CYFS3/GD32FOC/GD32F505_FOC模块复用布局.md

# 双路FOC参考模块复用布局

> 本文为此前阶段记录。最新用户要求把公共电源输入与第一路MOS驱动一起按参考工程排列，并明确选择1.27mm裸铜测试点替代5012通孔端子。后续以 `GD32F505_参考电源及双路FOC布局修正.md` 为准，旧测试点避让与共享电源整体下移不再沿用。

> 用户最新明确排列方向为 **M1在上、M2在下，对应器件X坐标一致**。下文横向66.396mm为前版记录，已由本次上下排列替代；本次纵向节距为78.5mm：M2相对上一版整体平移(-66.396,+78.5)mm，共享208器件再整体向下80.5mm避让；模块内部相对坐标、朝向、网络和分组保留。最新坐标与验证见`.layout-review/vertical-stack-coordinates.json`和`vertical-stack-validation.json`。

按用户要求，将data/FOC参考工程的电机驱动模块作为布局模板，两路模块以相同方向、固定平移间距重复摆放。此阶段复用器件摆放，不复制参考铜线、过孔或铺铜，也不复制参考主控、公共电源或板框。

## 方法

当前FOC_M1和FOC_M2各162个实体器件，共324个；其余208个为共享电源、主控、HSLink和显示等部分。依据参考位号来源、器件功能和引脚网络建立对应关系。封装模型与参考有原点或零度方向差异时，依据对应焊盘进行刚性位置/旋转补偿，保持物理电极方向与参考一致；不拉伸、不镜像模块。

参考中没有的新增器件采用两路一致的相对摆放，明确区别于参考复刻部分。需要避让模块的非FOC器件按已有功能组整体平移，保留各组内部摆放。

每路162个器件中147个找到参考对应，15个为新增器件。参考有9颗母线电容在背面，两路共18颗对应电容按参考翻至B.Cu，属于复刻范围；其余器件层保持。所有PCB变更通过KiCad IPC公开接口，保存前验证器件UUID、位号、焊盘网络不变，并单独验证这18颗的预期层变化。布局前完整备份为`.layout-review/module-reuse-before.kicad_pcb`。

## 注意事项

参考布局不是已验证的生产模板。当前部分器件封装尺寸与参考不同，因此会单独记录无法完全重合的焊盘、外形交叠和间距问题，不通过无提示重新打散器件来掩盖差异。此前导入库中的钻孔、丝印、库差异等DRC问题仍需后续修复。

初始严格参考坐标检查发现每路19处异网铜几何交叠，主要来自当前5012通孔测试点大于参考测试焊盘，以及CN5由5针替换为6针。不能把参考坐标复用宣称为封装也完全相同。执行原则是保留功率/驱动/采样核心坐标，仅对冲突测试点与变更接口做最小避让；同一避让偏移同时用于M1/M2，明确记录例外，不将短路布局保存。

双面检查额外确认：CN17等现有通孔栅极测试点在原参考位置会与背面母线电容铜区相交，局部小范围移动不足以解决。此类测试点迁至模块外围测试区，两路使用相同偏移，核心参考布局保持。这些例外是封装形态差异导致，不宣称当前147项均能零偏差复刻。

模块规划横向平移差为(+66.396,0)mm，两路同方向。为给复刻模块让位，其余208个共享器件整体向下平移83.2906mm，内部相对摆放保留。这是模块复刻工作区，不是最终整板尺寸或紧凑布板承诺。进一步检查发现部分明确为SMD的FOC阻容仍被导入为0.001mm钻孔、所有铜层的通孔焊盘。为正确复刻背面布局，本轮增加限定修复：仅改这些明确表贴器件的焊盘类型、铜/阻焊/焊膏层和钻孔属性，同步源封装库；几何尺寸、焊盘编号、网络保持。真正的通孔测试点/连接器不改为SMD。已同步5个源库文件的39个定义焊盘（0603电容、0603电阻/NTC、SOD323、6针表贴连接器、QFN24+EP），AST白名单核对几何/编号/原图形不变；库备份位于`.layout-review/module-smd-library-backup/`。共享同库的其他19个电容与18个电阻实例本轮不在板上修复范围内，后续更新封装时需留意。板上208个器件的486个焊盘已通过完整封装公开IPC更新为SMD、零钻孔和单面层集合；重新读取验证编号、UUID、网络与位置保持，已经保存。直接更新pad曾未生效，验证失败后事务已drop，最终使用fresh footprint.definition.pads更新整封装实现，没有绕过公共API。最终每路17个尺寸不兼容的测试点/变更接口采用成对避让；其余130个参考映射器件不增加避让偏移（允许不同封装的原点和零度方向校正），15个新增器件置外围。首轮实际布局保存后读回验证：532器件均存在，162对器件平移差(+66.396,0)mm一致，最大误差约1nm；18颗电容位于B.Cu，两铜面不同器件异网焊盘几何相交0。原生DRC第一次结果1122项违规、499未连接、0原理图一致性问题。装配边界重叠199项、通孔落入装配边界40项，说明参考紧凑坐标与当前封装/测试点仍需装配复核，不能因铜未重叠就声称可生产。相较原有14条铜间距多出CN27/R83及M2对应2条0.1846mm间距，已把CN27/CN1027各平移(-0.1,+0.1)mm；最终原生DRC为1120项违规、499未连接、0原理图一致性问题，这2条新增间距已消除，仍未达到生产DRC通过。

## 最终交付

已保存当前PCB，并通过公开Group接口建立2个无名模块组，每组162器件，分别对应M1/M2；组ID与成员位号见`.layout-review/module-reuse-groups.json`。公开SDK不提供名称setter，因此没有绕过接口伪造名称。可以按组选择整套模块移动，数据模板`.layout-review/foc-reuse-map.json`与最终坐标`.layout-review/module-reuse-coordinates.json`保留来源、两路对应及例外，供后续复用。

最终对布局前快照直接核验532个器件UUID/位号/锁定状态及1382个焊盘UUID/所属封装/编号/网络完全相等；162对平移差一致、角度匹配，18个背面电容层正确。实际焊盘与目标刚性变换坐标差约1.374nm，仅数值取整量级（不代表不同封装与参考原焊盘零误差，模型拟合残差另记录）。

预览已刷新，显示约137.8×195.4mm为当前全部图形占用，不是加工板框。为让用户先验收两个复刻模块，共享器件暂整体放在下方，整板尚待紧凑整合、定板框与布线。未复制参考走线，当前仍为2铜层、0走线/过孔/铜区，无板框。
