CYFS3/GD32FOC/.layout-review/layout-execution-report.md

# 532封装初版IPC布局执行

已通过KiCad 10.0.6官方kicad-python IPC完成当前GD32F5_FOC.kicad_pcb的全部532个导入封装摆放，并以board.save保存。初始导入先保存并复制备份：`.layout-review/board-before-placement.kicad_pcb`；原始实际位置、bbox和各焊盘net记录于`live-before.json`。

## 范围与方法

18个功能组，初版软包络170×120mm：两套功率桥在上部、共享输入/降压在左、主控中下、HSLink左下、显示/按键右下。两个三相MOS阵列采用相同锚点结构，采样区名义10mm高度扩大至24mm；43个器件为避碰超出原分区矩形但仍在整体包络内。

关键芯片/连接器先放；U1实际8/9/12/13焊盘位于芯片左边，晶体据此放置。栅阻/自举/晶体等局部簇以真实焊盘为吸引点。其余所有器件以小网络邻接加权目标和最近可用位置搜索摆放，不是只摆关键件；大供电/地网不作为无差别吸引。M2同号偏移对应件优先复用M1相对坐标。

采用不含文本的IPC get_item_bounding_box，候选保留0.35mm轴向bbox间隔。全体移动一个可撤销事务，随后14个MCU/晶体电容进行一次pad距离微调作为第二个可撤销事务。未删除、克隆或新增PCB器件；未布线、未放过孔、未铺铜、未创建板框或安装孔、未改层叠或锁定状态。

## 实际验证

- 封装数532，全数设置目标坐标并fresh IPC重读验证。
- 封装UUID、reference、层、锁定状态保持；所有pad UUID、parent、编号、net名称保持。
- 最终实际IPC bbox交叠对数0（不含文字；不是完整courtyard/DFM/DRC证明）。
- 实际占用边界约x2.362…166.014、y0.843…119.915mm，即163.652×119.072mm；它不是制造板框。
- 保留2铜层，tracks=0、vias=0、zones=0、shapes=0。
- `placement-coordinates.json`与`live-after.json`为最终位置及方向；`critical-pad-distances.json`为实际pad中心距离。
- USB8002原0°尾部焊盘位于负y侧，壳口朝正y；现270°将口朝西，尾部朝内侧。未创建板边，必须在机械定版后复核壳体伸出量与插拔空间。

## 关键局部距离（mm，焊盘中心直线距离，不是布线长度）

|连接|距离|
|---|---:|
|U1.8→Y201.1 / U1.9→Y201.2|4.209 / 5.034|
|Y201.1→C214.1 / Y201.2→C215.1|2.225 / 2.239|
|U1.12→Y200.1 / U1.13→Y200.3|5.831 / 5.423|
|Y200.1→C210.1 / Y200.3→C211.1|4.225 / 1.725|
|U1.11→C200.1|4.573|
|U1.28/50/75/100→C201/202/203/204供电脚|各1.725|
|U1.6→C212.1|4.783|
|U1.22→C206.1 / C207.1|3.239 / 6.032|
|U1.21→C208.1 / C213.1|4.943 / 6.799|
|Q5/Q6/Q7/Q8/Q9门极→对应栅阻最近焊盘|各3.093|
|Q10门极→R77最近焊盘|3.471|

主控左侧晶振/模拟供电较密，部分去耦仍为4–7mm且主晶振负载距离不对称，应在正式布线前继续收紧与调整回流。初版没有声称时钟回路、电源完整性、散热、爬电距离或可制造性完成。源封装存在导入through-hole/异常钻孔属性问题，布局不修复这些库层面问题；DRC由主agent单独执行和分类。

## 主agent最终DRC回传

主agent在最终保存板上运行原生DRC：794条违规、499条未连接，schematic parity为0。相对初次布局788条，电容微调后增加6条lib_footprint_mismatch，合计112条此类库差异；原因未在本子任务进一步验证，不能归因于旋转或忽略。布局bbox无交叠与上述DRC并不等价，当前板不具备DRC通过状态。主agent已打开532封装预览。

## 脚本

`live_snapshot.py`只读采集后board.save保存导入；`place_all.py`规划并事务摆全532；`refine_caps.py`局部pad目标微调；`measure_layout.py`最终只读距离测量。仅使用公开IPC对象与属性，不使用pcbnew/SWIG、私有proto或板文件文本写入。
