CYFS3/GD32FOC/.layout-review/module-reuse-report.md

# 双路FOC参考模块复用执行记录

已在当前GD32F5_FOC.kicad_pcb通过KiCad IPC完成两路同向平行复用，未复制参考铜、布线、板框或层叠。共有532实体封装、1382焊盘，2铜层，0走线/过孔/铜区/板框。

## 模板和摆放

每路162器件：147个映射到data/FOC的原器件，15个当前新增器件安置模块外围。M2与M1所有162个对应器件的平移严格为(66.396,0)mm，角度和正反面对应一致，不镜像、不拉伸、不自动散布参考核心。

对当前封装原点及默认朝向差异，按同功能焊盘求正交刚性变换，记录于module-reuse-plan-final.json的fits。Q5等MOS原点补偿约(-0.2117,-0.0022)mm并修正角度，U10按当前模型朝向补偿。C130/131/132与参考C66/70/71电容引脚1/2功能相反，按交换映射拟合。源封装尺寸与当前封装不同，最大配准焊盘中心残差0.1225mm；这是封装尺寸差异而非模块间误差。CN5从参考5针接口换为现6针，保持功能区位置，不宣称精确引脚兼容。

参考9个背面母线电容C96–C104，两路共18个，使用公开flip_items实际翻到B.Cu，再按原焊盘方向摆放。其余器件保持F.Cu。

非FOC共208器件整体沿Y平移83.2906mm，全部组内相对关系保持。当前为模块摆放工作区，非最终紧凑整板或确定外形。

## 必要的封装修复与摆放例外

参考位置要求双面配置，当前导入模型的伪通孔会产生真实异网短路。已对明确5类SMD封装的208个器件、486焊盘修复：0.001mm伪钻孔归零、PTH改SMD、层改F.Cu/F.Paste/F.Mask。使用公开footprint.definition.pads及整封装update；所有焊盘几何、ID、编号、网络、位置保持。直接update pad虽返回成功但不生效，已读回识别并撤回；整封装公开更新验证生效。真通孔5012测试点保持。

现5012实体测试点比参考小测试焊盘大，不能完全原位而制造异网短路。两路完全一致地对17对器件设置例外，详见plan.local_clearance_exceptions：CN5接口及CN14/15/17/18/19/20/21/22/23/24/25/26/27/37/38/40。CN17/18/19因真通孔与背面母线电容冲突，移至模块下侧外围；其余为小偏移。CN27最后按DRC增加(-0.1,+0.1)mm。核心MOS、驱动、运放及其阻容不因通用避碰算法改变参考布局。147中130个不含额外避让（但有必要模型原点配准）。

## 验证

- 直接与module-reuse-before.json对比：532 footprint UUID/ref/locked和1382 pad UUID/parent/pin/net完全一致。
- 162对平移差最大数值误差0.000001mm（1nm），所有角度对计划误差0°。
- 最终每个实际焊盘对计划刚性变换最大误差0.0000013744mm。
- 使用KiCad实际F.Cu/B.Cu铜焊盘多边形，包含真通孔两面，检测不同封装不同网络铜重叠为0。
- 已建立两个各162成员的KiCad Group，可整体选取模块；公共API没有name setter，因此保持无名，UUID与M1/M2映射见module-reuse-groups.json。
- 矩形bbox存在参考紧凑摆放及大测试点带来的交叠，未为消除矩形误报破坏参考核心；不等于庭院/机械间距通过。主agent执行最终原生DRC并在总报告列出。

## 文件与事务说明

完整初始备份module-reuse-before.kicad_pcb/json。模板映射foc-reuse-map.json、最终计划module-reuse-plan-final.json、最终坐标module-reuse-coordinates.json、验证module-reuse-validation.json、组映射module-reuse-groups.json。

执行曾出现flip+update同一事务内读回层不一致且drop后位置仍已变化；已立即读实况并改用独立flip提交、fresh对象对齐提交，最终真实层/位置/焊盘几何均再次验证后保存，未假定drop已恢复原状。最后只移动CN27配对作DRC最小间距修正，其他坐标保持。没有直接写PCB文件、私有proto或pcbnew操作。
