CYFS3/GD32FOC/GD32F505_低速晶振补充记录.md

# 32.768kHz低速晶振补充记录

已在MCU.kicad_sch补入LXTAL，保留原8MHz主晶振和所有其它实体网络。

## 器件与连接

- Y201：Abracon ABS07-32.768KHZ-9-T，HQ G0063431；32.768kHz无源两脚晶体，CL=9pF，ESR=70kΩ（目录规格），3215封装。
- Y201.1、C214.1接U1.8 PC14/OSC32IN；Y201.2、C215.1接U1.9 PC15/OSC32OUT。移除对应两处NC。
- C214/C215：12pF C0G，0603，各自pin2接GND。
- 初值按Datasheet Rev0.9RC5 p92公式 C1=C2=2*(CL-Cs)，Cs假定3pF，得到12pF。Cs不是实测值，实板须验证频率、起振裕量和晶体驱动功率并调整，不声称已经测试起振。

型号和模型依据：HQ get_hqsch_part(manufacturer62,ABS07-32.768KHZ-9-T)。符号来自HQ模型，已用KiCad CLI规范化；封装为该精确型号HQ模型，仅重命名为VerifiedParts:ABS07_32.768kHz_3215，未改变几何。

## 固件与布局

根据用户手册备份域/RCU_BDCTL说明，先允许PMU_CTL.BKPWEN备份域写入，使用晶体模式LXTALBPS=0，按晶体驱动和实板起振评估选择LXTALDRI，开启LXTALEN并等待LXTALSTB后再选择RTC源。LXTALDRI默认11为强驱动，不能视为未经验证就合适。Datasheet典型启动2s不是最大启动时间或超时保证。

VBAT仍接VCC，本次没有加入电池，因此掉主电不具备独立电池保时。晶体、电容应靠近U1.8/9，短线并避开PWM等高dv/dt节点。

按坐标检查，新电路位于MCU页右侧x335–372、y114–145；说明位于x322.58、y152–179，未占用已有器件坐标。已导出SVG，但当前模型无图像能力，未声称完成视觉审阅。

## 验证结果

- 全工程位号唯一：Y201/C214/C215未占用。
- KiCad原生前后全工程网表验证通过：两个振荡节点精确包含上列3个引脚；GND仅新增C214.2/C215.2；其它全部网络保持不变。
- 全工程ERC修改前后均353条（1错误、352警告），各类别数量完全一致，无新增符号库差异、封装解析或电气错误。
- 原有HPM电源建模错误、Q1封装等遗留项没有在本次修改。

修改文件：MCU.kicad_sch、sym-lib-table。
新增模型：LXTAL.kicad_sym、VerifiedParts.pretty/ABS07_32.768kHz_3215.kicad_mod。
备份/证据：.review-lxtal/MCU.before.kicad_sch、before.xml、after.xml、erc-before.json、erc-after.json、validation.json、svg/MCU.svg。

未修改PCB或固件。需重新加载磁盘原理图，再在后续PCB更新中加入这三个器件。
