CYFS3/GD32FOC/GD32F505_初版布局记录.md

# GD32F505 双路FOC初版布局

> 本文保留首次分区布局记录。用户随后要求完全参考FOC模块摆放并同向平行复用，后续结果以 `GD32F505_FOC模块复用布局.md` 为准，不再沿用这里的通用分区坐标。

用户授权参考 `E:\MCU\GD32\GD32F5_FOC\data\FOC` 与 `data\HPM`，无固定板尺寸、孔位或接口约束，先做初版布局。参考文件仅只读分析，未修改。

## 布局前收尾

原理图批注阻碍已解决：17组隐藏#PWR重复，仅对MCU和Interface页重复实例重编号，实体位号和连接未变；CLI不再提示批注错误。Q1使用参考FOC工程相同WSD90P06DN56型号的GDS123封装，修复9个误导入为通孔的焊盘为SMD；封装链接告警清零。原生ERC仍352条，包括1条HPM内部电源建模错误，未声称全通过。

用户已重新加载并通过F8导入当前PCB，IPC读取532个封装，0锁定、0走线，没有板框。包括Y200/Y201、C212–215及TP200。后续PCB变更仅通过KiCad IPC公开API完成，未直接改写板文件。

## 分区依据

参考FOC为100×55mm六层单路板，参考HPM为77.4005×53.248mm四层板，不能照搬当前双路板的尺寸和层数。当前层数保持导入时配置，不据参考自动改叠层。

初始软工作区170×120mm：两套三相功率区位于上部，各自安排MOS、分流器、本地母线瓷片及电机接口；驱动及自举紧接其下；采样链置中部；GD32主控及双晶振在中下；共享输入保护和降压电源在左侧；HSLink USB/ESD/HPM位于左下；显示按键及其余接口位于右下。实际空间需按封装尺寸调整，该尺寸不是确定板框。

全部532个器件分为18组，计划含63个关键中心种子、33个晶振/去耦/自举/门极等局部关联组。按实际焊盘与外接尺寸调整，不把参考STM32 LQFP64坐标直接套给GD32 LQFP100。

## 阶段边界

初版布局不等于完成布线或可投板：板框、安装孔、层叠/铜厚、热设计与高电流通路仍需进一步设计。未更改现有DNP选项。CN1正负引脚标注与所接网络的疑点仍需实物或厂家图确认；Q1参考EP焊膏覆盖率及器件机械图尚需制造前复核。

参考分析、坐标、批注修复和Q1封装修复证据位于 `.layout-review/`。布局前完整板备份为`.layout-review/board-before-placement.kicad_pcb`，不是空板备份。布局采用真实封装外接矩形避碰与小网络相邻引脚吸引，初始附加几何间隙0.35mm；该间隙不等于高压爬电、功率散热或最终DRC设计要求。主控双晶振依据U1真实8/9/12/13脚的左侧位置摆放，USB开口暂定向西。

导入基线DRC已记录：存在大量旧导入封装的微小钻孔/通孔类型、丝印等问题。布局只移动封装不会自动修复这类库几何问题。备份文件路径没有配套原理图，针对备份的schematic-parity检查不能取得原理图，不应误认为当前工程批注再次出错。

## 首次保存与验证

532个封装已通过IPC事务摆放并保存；全部UUID、实体位号、焊盘网络和层保持，实际KiCad外接矩形两两无重叠。实际占用范围约x2.36…166.01mm、y0.84…119.92mm，仍无板框，不能据此发加工。

主工程路径第一次布局DRC为788项违规、499条未连接项，原理图一致性问题0项。14条铜间距来自U9101/U9102各自0.15mm相邻焊盘与现0.2mm规则的差异，以及FPC300内部焊盘，不是不同器件摆放碰撞。大量钻孔/丝印和106条库模型差异仍需后续处理；不调整规则来掩盖这些问题。布线、铜区、层叠和板边均未在本阶段完成。最终主控电容局部微调后已复验：794项DRC违规、499条未连接项、0原理图一致性问题。比首次摆放多6条库封装差异，总112条；不将库差异解释成已通过或擅自忽略。其他类别：199钻孔范围、199丝印压铜、199丝印重叠、48环宽、19文字高度、14间距、4铜到板边。

主控VDD28/50/75/100至其去耦电容焊盘中心约1.725mm；VDD11约4.573mm、VBAT约4.783mm。VDDA/VREF的电容约3.239–6.799mm，仍需布线前进一步局部优化。主晶体信号焊盘到U1约5.423–5.831mm，低速约4.209–5.034mm；这是直线焊盘中心距离，不是已布线长度。

PCB已保存并打开交互预览。预览显示的167.4×121.3mm为图形占用范围估计，不是已创建的加工板框。本阶段没有新增走线、过孔、铜区或Edge.Cuts，保持2铜层待后续确定适合功率与信号回流的层叠。
