CYFS3/GD32FOC/GD32F505_原理图核对报告.md

# GD32F505 原理图核对与主晶振连接

> 本文是修复前的审查记录。后续已实施去耦、库链接及ERC修复；请以 `GD32F505_修复记录.md` 的最终状态和剩余问题为准。

依据用户提供的 GD32F505xx Datasheet Rev0.9RC5、GD32F50x 用户手册 Rev1.4、芯片使用限制 Rev1.1。页码为文档印刷页码。审查对象为当前工程的 GD32F505VxTx（U1，LQFP100）及关联接口；并不替代电机功率级和整机额定参数验证。

## 核对结论

主控电源、复位、启动、SWD、两路互补 PWM、霍尔和 ADC 引脚映射未发现确定的错接。原设计未连接 HXTAL；使用内部时钟时这是合法配置，本次按要求补主晶振。

优先关注以下事项：

1. **BRKIN 不等于已具备板上硬件过流保护。** M1_BRKIN（U1.51/PB12）和 M2_BRKIN（U1.31/PA6）仅连接 MCU、10k 上拉、J201 外接接口，没有板上故障输出接入。使用时须提供外部故障信号，配置 TIMER0/7 的 BRKEN、BRKP、输出关闭状态与死区；低有效配置下断线仍为高，不会自动触发故障。用户手册 p332。
2. **板载 HSLink 默认未连接目标。** R8901/8902/8903 实例均为 DNP，分别桥接 SWDIO/SWCLK/NRST。要使用板载下载器需装对应连接桥。外部 J200 的 SWDIO/SWCLK 映射正确，但该四针接口没有 NRST。
3. **去耦需要按布局补核。** 五个 VDD 已有 C200–204 五颗100nF及C205 4.7µF。VBAT接VCC，但未明确独立分配近端100nF。VDDA/VREFP共用MCU_VDDA，现有C206/C208 100nF、C207 1µF；Datasheet p73 图4-1推荐VDDA和VREFP各自近端1µF+10nF。当前配置差异不等于必然失效，需结合近端连接和ADC噪声核对。
4. **ADC供电和参考的容差/时序需验证。** 电流运放U10/U1010使用AVCC，来自U2的3.3V输出；MCU参考来自另一条VCC 3.3V经R203。不是5V运放直驱ADC，但两路3.3V的容差、启动顺序和饱和过冲仍可能影响ADC范围。输入有效范围0…VREFP（Datasheet p101）；当前电流ADC节点未见外部钳位。
5. **主控符号封装库链接待修复。** 原生ERC报告U1引用的GD32F505xx封装库不在当前配置中；这影响从原理图重新更新PCB。实际PCB焊盘映射本次未检查。

## 已确认正确或属于装配选项的部分

- U1 VDD：11/28/50/75/100→VCC；VSS：10/27/49/74/99→GND；VBAT.6→VCC。
- VDDA.22、VREFP.21→MCU_VDDA→R203 0Ω→VCC；VSSA.19、VREFN.20→AGND→R3 0Ω→GND。满足模拟/数字同源供电意图；VDD≥240MHz工作时需不低于3.0V（Datasheet p58）。
- BOOT0.94和BOOT1/PB2.37各10k下拉；NRST.14为10k上拉+100nF，符合Datasheet p97推荐。启动来源还受OTP配置影响。
- J200：1=VCC，2=GND，3=PA13/SWDIO，4=PA14/SWCLK。
- R9101/R9103装配，R9102/R9104（5V选项）DNP；默认编码器3.3V供电无短接。改5V时必须拆掉对应3.3V桥，不能两边同时装。
- M2_VBUS未接MCU；两路共享DCBUS且已有M1_VBUS采样，这不是自动成立的错误。现M1分压10k+10k串联、下臂1k，理想比例1/21；3.3V参考对应69.3V理论满量程，不是建议工作母线电压，须留误差和瞬态裕量。

## 固件必须使用的关键映射

|功能|引脚/端口|配置|
|---|---|---|
|M1 主PWM|PA8/PA9/PA10|AF1，TIMER0_CH0/1/2|
|M1 互补PWM|PB13/PB14/PB15|AF2/AF2/AF1，TIMER0_CH0/1/2_ON|
|M2 主PWM|PC6/PC7/PC8|AF3/AF3/AF2，TIMER7_CH0/1/2|
|M2 互补PWM|PC0/PC1/PC2|AF0，TIMER7_CH0/1/2_ON|
|两路刹车输入|PB12/PA6|AF4，TIMER0_BRKIN/TIMER7_BRKIN|
|M1 霍尔|PB4/PB5/PB0|AF1/AF0/AF1，TIMER2_CH0/1/2|
|M2 霍尔|PD12/PD13/PD14|AF1/AF0/AF0，TIMER3_CH0/1/2|
|公共SPI|PC10/PC11/PC12|AF2，SPI2|
|M1/M2温度|PE7/PE8|ADC2_IN4/5|
|M2 IB/IC|PA4/PA5|ADC0或ADC1_IN4/5，不是ADC2|

依据Datasheet pp24–30、54–56。特别不要整组使用同一个AF值。PB4复位默认JTAG功能，使用前释放JTAG并保留SWD（用户手册 p486）。SPI片选名含SPI1但总线实际是SPI2，GPIO片选可以工作，应避免固件误认外设。ADC时钟上限42MHz，采样时间需结合源阻抗；两路FOC同步采样不能只看引脚合法便视为完成。

## 晶振设计依据

HXTAL接U1.12 OSCIN和U1.13 OSCOUT，使用8MHz无源晶体；8MHz是本次设计选择，位于允许的4–40MHz范围内。禁止接到LQFP100的81/82脚来替代晶振专用引脚。

所选候选料号 Abracon ABM3B-8.000MHZ-10-D-1-G-T，HQ G0089125：8MHz、CL=10pF、5×3.2mm四焊盘。厂商系列资料给8MHz ESR≤200Ω，C0≤7pF，驱动功率典型10µW/最大100µW。旧版系列资料对D温区和G稳定度组合的注释与目录料号不完全一致，采购时应确认完整订货码和当前规格。

匹配电容以12pF C0G为初始值，依据Datasheet p91：C1=C2=2×(CL−Cs)，假定Cs=4pF。Cs是PCB与MCU引脚寄生电容估算，并非已测量值。需要实板验证起振裕量、频差和驱动功率；目前不能宣称量产温压范围已验证。芯片已有内部反馈电阻，未要求外加并联反馈电阻。推荐接法见Datasheet p93图4-7、用户手册 pp160–161。

器件与网络：Y200.1→U1.12，Y200.3→U1.13；Y200.2/.4接GND；C210/C211分别从两端接GND，各12pF C0G。连接已通过KiCad导出网表检查，新增地引脚之外，其余原有网络保持不变。封装依据HQ提供的KiCad模型；本运行环境无法读取图像，厂商机械图及原理图布局的视觉复核未完成，投板前需复核。

固件使用晶体模式HXTALBPS=0，启动HXTAL并等HXTALSTB，再按8MHz配置PLL并切换时钟。板上32.768kHz低速晶体未加入；是否需要取决于RTC要求。

## ERC结果与范围

HQ接口 run_erc 返回0条，但KiCad 10.0.6原生全工程ERC在修改前报告895条：201条error、694条warning。二者结果不一致，不能声称ERC通过。原生结果包括：

|类别|数量|
|---|---:|
|未连接引脚|13|
|输入未驱动|160|
|电源输入未驱动|28|
|引脚/线端离网格|349|
|封装库链接|216|
|孤立标签|2|
|符号库不一致|1|
|引脚类型连接|118|
|未连接线端|8|

修改后再次运行全工程原生ERC：仍为895条（201 error、694 warning），晶振新增部分未增加ERC条目。已针对实际保存的MCU.kicad_sch重新导出网表并验证连接；最终文件与经过验证的候选一致。

未连接引脚包括LDO/驱动器NC、USB SBU以及U6 PG，多项可能是预期未用但缺标记；导入器件多引脚被定义为Input，使规则结果需要逐项解释。八条悬空线端和库链接仍应后续清理。没有为了消除报错而全局屏蔽规则。

## 文件与使用

主文件 `MCU.kicad_sch` 已补入Y200、C210、C211。配套 `HXTAL.kicad_sym`、`HXTAL.pretty/ABM3B_5x3.2mm.kicad_mod` 及项目 `sym-lib-table`、`fp-lib-table` 提供本地模型链接。修改前备份为 `.review-gd32/MCU.before-crystal.kicad_sch`。

修改发生在磁盘文件。若编辑器仍显示旧图，请重新打开工程加载磁盘版本，避免将旧编辑器内容保存覆盖新文件。PCB尚未同步或布线；加载原理图后仍需更新PCB，且先修复本报告提及的既有U1等封装库链接。

## 芯片使用限制Rev1.1

p5–8列出I2C十位地址从机缺STOP、CAN发送邮箱中止/特定ID、Core异常优先级限制，主要由固件规避。没有列出要求修改本次ADC/PWM引脚分配的条目。若使用CAN，尤其注意TFO=1中止邮箱2影响邮箱1，以及TFO=0邮箱1/2使用0x1FFFFFFF的限制；手册解决方案处ID少一位，实施时应按问题描述并向厂商核实。实际芯片Revision应与适用表对应。
