CYFS3/GD32FOC/GD32F505_参考电源及双路FOC布局修正.md

# 参考电源与双路FOC整体布局修正

用户要求参考data/FOC原工程的电源输入与MOS驱动整体摆放，第二路位于第一路正下方。上一版虽复用了FOC核心坐标，但将公共电源远放下方、把参考小测试焊盘替换成大Keystone通孔件后再避让，未完整达成参考整体布局。本次纠正上述差异。

## 测试点设计选择

直接读取原参考PCB/原理图/封装库后确认：源原理图47个5012标注中43个落板，实际全用同一种圆D1.27mm焊盘，钻孔0.001mm，封装名称含TH；采购字段却是Keystone5012/C2906766。不能证明原作者有意做无孔测试点，也不能将微孔图形当成正确5012机械模型。

用户本轮已明确选择“按参考做小测试焊盘”。因此52个当前测试点改为VerifiedParts:TestPoint_D1.27_Reference：圆形铜D1.27mm，F.Cu/F.Mask，无孔、无焊膏、无实体3D；Value=TestPoint并移除5012/Keystone采购身份。TP200保留。44个FOC测试点恢复参考相对位置，其余8个按电源功能映射，不再移动到外围来掩盖机械不一致。

## 电源与第一路的共同坐标关系

97个公共电源器件（power页87个及MCU页电源10个）与第一路FOC使用同一个参考板坐标平移。恢复输入、保护、大电解、MOS功率桥的原相对关系，公共输入只保留一套。

重要映射：现CN1←源CN3；Q1/Q2/Q3同号；C164/C165←源C3/C4；U6 LM5164←源U2；U19←源U5；U20←源U3；U2←源U4；U12←源U6。15个电源器件按参考位于背面，除两路18个背面母线电容之外另行保持参考层关系。第二路仅沿Y方向复制，主控/调试/显示按已有功能簇放入剩余空间，不再把全部共享器件整体推到很远下方。

原理图现CN1为公座而源为母座，U19的Value=RY8411而MPN字段=JW5026，这些差异已记录，布局映射不代表已核定替换机械或采购型号。未复制参考铜走线、过孔、层叠或板框。

已完成测试点同步：4张原理图（MCU、power、FOC_M1、FOC_M2）中52个实例的Value/Footprint/采购身份与BOM/贴装排除属性已更新，CLI网表前后连接完全相同；新库与板上52个封装的单圆pad及无钻孔/无焊膏属性一致，原焊盘和封装UUID、网络不变。原理图备份在`.layout-review/testpoint-barepad-backup/`，PCB整体修改前备份为`.layout-review/power-integrated-before.kicad_pcb`。

整体计划统一源坐标平移T=(-89.1235,-69.8475)mm，公共电源与M1均用此变换；M2位于M1正下方，纵向节距71.5mm。输入/保护/电解/第一路功率桥恢复参考关系，主控与HSLink放在左下空余区，显示与调试接口放下沿。预计整体占用约100×161mm（不是板框）。不同封装的焊盘拟合残差最大约0.291mm（LM5164），电解约0.273mm，明确区别于布局坐标误差。最终实际布局已保存：97个公共电源器件与第一路采用共同变换，第二路162对器件同X、同方向，Y差71.5mm。33个背面封装包括两路18个母线电容及15个参考电源器件。额外37个共享实例同步修正既定5种SMD模型的微孔导入属性。

输入接口现XT30PW-M较源F型多真实机械孔，D22（1.5SMC30CAHE3/57T）修正为B面SMD，并在参考位置向右让开1mm；源SMC库也已修正。CN1机械孔保持，不通过删除机械孔来掩盖差异。

同步过程曾读入旧编辑器测试点定义并恢复大通孔，随后按当前已修复原理图的意图再次恢复52个裸铜点；不再重复使用未重载的F8更新。布局坐标未因这次属性回退而改变。最终原生DRC（drc-power-integrated-verified.json）：1054项违规、499未连接项、52项原理图一致性提示。52项全部为“原理图中缺少符号字段 Manufacturer Part”，属于测试点空采购字段与PCB内部字段状态差异；封装引用、Value、BOM排除已一致。现有公开接口未暴露相关自定义字段，不以错误5012值填回原理图消除提示。最终shorting_items为0、solder_mask_bridge为0。其余包括199装配边界重叠、171钻孔范围、48环宽、199库差异、199丝印压铜、199丝印重叠、19文字高度、14间距、4铜到边界、2通孔落入装配边界，仍非可投板状态。

最新PCB预览占用约103.2×162.6mm，保持2铜层、0走线/过孔/铜区、无板框。当前交付重点是正确的参考电源与双路驱动布局，参考板6层及走线未复制。重新打开工程时应加载本次磁盘文件，避免旧编辑器状态覆盖。参考证据见`.layout-review/reference-testpoint-audit.json`和`.layout-review/power-reference-map.json`。
