CYFS3/GD32FOC/hslink_inspect_utf8.txt

FILE 4_DAP.kicad_sch UUID 2a4df808-ddbf-41d9-b7dc-5450de06ecad
SYM #PWR? GND ProDoc_IPB-easyedapro:Ground-GND ['163.83', '133.35', '0']
SYM #PWR? VBUS2 ProDoc_IPB-easyedapro:Power-VCC ['207.01', '128.27', '0']
SYM SW5  ProDoc_IPB-easyedapro:TS-1088-AR02016 ['223.52', '86.36', '0']
SYM C77 100nF ProDoc_IPB-easyedapro:CapAcitance ['43.18', '62.23', '0']
SYM #PWR? GND ProDoc_IPB-easyedapro:Ground-GND ['85.09', '201.93', '0']
SYM R57 5.1K ProDoc_IPB-easyedapro:电阻 ['137.16', '106.68', '0']
SYM #PWR? LINK_VDD_SOC ProDoc_IPB-easyedapro:Power-VCC ['81.28', '19.05', '0']
SYM R56 5.1K ProDoc_IPB-easyedapro:电阻 ['137.16', '91.44', '0']
SYM R64 22R ProDoc_IPB-easyedapro:电阻 ['39.37', '152.4', '0']
SYM C64 4.7uF ProDoc_IPB-easyedapro:CapAcitance ['48.26', '16.51', '90']
SYM C72 100nF ProDoc_IPB-easyedapro:CapAcitance ['35.56', '34.29', '90']
SYM R58 10K ProDoc_IPB-easyedapro:电阻 ['39.37', '114.3', '270']
SYM #PWR? +5V ProDoc_IPB-easyedapro:5-Voltage ['185.42', '129.54', '0']
SYM C81 15pF ProDoc_IPB-easyedapro:CapAcitance ['39.37', '87.63', '90']
SYM #PWR? GND ProDoc_IPB-easyedapro:Ground-GND ['189.23', '127', '180']
SYM R73 10K ProDoc_IPB-easyedapro:电阻 ['85.09', '196.85', '270']
SYM #PWR? GND2 ProDoc_IPB-easyedapro:Ground-GND ['144.78', '133.35', '0']
SYM X2 24MHz ProDoc_IPB-easyedapro:XL7EL89CKI-111YLC-24M ['26.67', '85.09', '0']
SYM #PWR? GND2 ProDoc_IPB-easyedapro:Ground-GND ['170.18', '83.82', '0']
SYM #PWR? GND ProDoc_IPB-easyedapro:Ground-GND ['132.08', '91.44', '270']
SYM #PWR? LINK_3.3V ProDoc_IPB-easyedapro:Power-VCC ['49.53', '90.17', '0']
SYM C70 100nF ProDoc_IPB-easyedapro:CapAcitance ['22.86', '34.29', '90']
SYM C69 100nF ProDoc_IPB-easyedapro:CapAcitance ['16.51', '34.29', '90']
SYM #PWR? LINK_3.3V ProDoc_IPB-easyedapro:Power-VCC ['111.76', '142.24', '0']
SYM R68 22R ProDoc_IPB-easyedapro:电阻 ['39.37', '160.02', '0']
SYM #PWR? GND ProDoc_IPB-easyedapro:Ground-GND ['38.1', '69.85', '270']
SYM C83 22uF ProDoc_IPB-easyedapro:CapAcitance ['13.97', '107.95', '270']
SYM U8  ProDoc_IPB-easyedapro:CH213K ['198.12', '128.27', '0']
SYM #PWR? LINK_3.3V ProDoc_IPB-easyedapro:Power-VCC ['215.9', '86.36', '90']
SYM #PWR? +3.3V ProDoc_IPB-easyedapro:Power-VCC ['78.74', '166.37', '0']
SYM C86 100nF ProDoc_IPB-easyedapro:CapAcitance ['39.37', '124.46', '90']
SYM #PWR? LINK_VDD_SOC ProDoc_IPB-easyedapro:Power-VCC ['16.51', '29.21', '0']
SYM #PWR? +3.3V ProDoc_IPB-easyedapro:Power-VCC ['167.64', '68.58', '0']
SYM #PWR? GND ProDoc_IPB-easyedapro:Ground-GND ['132.08', '109.22', '0']
SYM #PWR? +3.3V ProDoc_IPB-easyedapro:Power-VCC ['88.9', '166.37', '0']
SYM #PWR? GND ProDoc_IPB-easyedapro:Ground-GND ['73.66', '130.81', '0']
SYM R66 22R ProDoc_IPB-easyedapro:电阻 ['39.37', '157.48', '0']
SYM C74 100nF ProDoc_IPB-easyedapro:CapAcitance ['11.43', '58.42', '90']
SYM #PWR? LINK_3.3V ProDoc_IPB-easyedapro:Power-VCC ['52.07', '59.69', '0']
SYM #PWR? LINK_VDD_SOC ProDoc_IPB-easyedapro:Power-VCC ['13.97', '102.87', '0']
SYM R61 10K ProDoc_IPB-easyedapro:电阻 ['111.76', '147.32', '270']
SYM C78 10uF ProDoc_IPB-easyedapro:CapAcitance ['43.18', '66.04', '180']
SYM R60 1M ProDoc_IPB-easyedapro:电阻 ['153.67', '133.35', '0']
SYM #PWR? GND ProDoc_IPB-easyedapro:Ground-GND ['39.37', '92.71', '0']
SYM U7 4.7uH ProDoc_IPB-easyedapro:FTC252010S4R7MBCA ['39.37', '102.87', '0']
SYM C71 100nF ProDoc_IPB-easyedapro:CapAcitance ['29.21', '34.29', '90']
SYM R52 0R ProDoc_IPB-easyedapro:电阻 ['158.75', '68.58', '0']
SYM #PWR? GND ProDoc_IPB-easyedapro:Ground-GND ['17.78', '63.5', '0']
SYM R54 1M ProDoc_IPB-easyedapro:电阻 ['40.64', '77.47', '180']
SYM #PWR? GND ProDoc_IPB-easyedapro:Ground-GND ['49.53', '72.39', '0']
SYM #PWR? GND ProDoc_IPB-easyedapro:Ground-GND ['55.88', '184.15', '0']
SYM USB2  ProDoc_IPB-easyedapro:TYPE-C 16PIN 2MD(073) ['160.02', '97.79', '0']
SYM C80 15pF ProDoc_IPB-easyedapro:CapAcitance ['8.89', '82.55', '90']
SYM R53 10K ProDoc_IPB-easyedapro:电阻 ['106.68', '73.66', '0']
SYM C85 100nF ProDoc_IPB-easyedapro:CapAcitance ['25.4', '107.95', '90']
SYM #PWR? VBUS2 ProDoc_IPB-easyedapro:Power-VCC ['203.2', '30.48', '90']
SYM R63 22R ProDoc_IPB-easyedapro:电阻 ['39.37', '149.86', '0']
SYM C87 1nF ProDoc_IPB-easyedapro:CapAcitance ['153.67', '128.27', '180']
SYM #PWR? GND ProDoc_IPB-easyedapro:Ground-GND ['233.68', '30.48', '90']
SYM #PWR? GND ProDoc_IPB-easyedapro:Ground-GND ['115.57', '76.2', '0']
SYM C76 100nF ProDoc_IPB-easyedapro:CapAcitance ['24.13', '58.42', '90']
SYM R70 22R ProDoc_IPB-easyedapro:电阻 ['39.37', '163.83', '0']
SYM #PWR? LINK_3.3V ProDoc_IPB-easyedapro:Power-VCC ['17.78', '53.34', '0']
SYM R59 22R ProDoc_IPB-easyedapro:电阻 ['105.41', '113.03', '0']
SYM C65 100nF ProDoc_IPB-easyedapro:CapAcitance ['54.61', '16.51', '90']
SYM #PWR? GND ProDoc_IPB-easyedapro:Ground-GND ['48.26', '11.43', '180']
SYM C75 100nF ProDoc_IPB-easyedapro:CapAcitance ['17.78', '58.42', '90']
SYM #PWR? GND2 ProDoc_IPB-easyedapro:Ground-GND ['170.18', '111.76', '0']
SYM C67 100nF ProDoc_IPB-easyedapro:CapAcitance ['68.58', '16.51', '90']
SYM C66 4.7uF ProDoc_IPB-easyedapro:CapAcitance ['62.23', '16.51', '90']
SYM #PWR? GND ProDoc_IPB-easyedapro:Ground-GND ['13.97', '113.03', '0']
SYM U6  ProDoc_IPB-easyedapro:HPM5301IEG1 ['73.66', '78.74', '0']
SYM #PWR? VBUS2 ProDoc_IPB-easyedapro:Power-VCC ['148.59', '109.22', '90']
SYM C68 100nF ProDoc_IPB-easyedapro:CapAcitance ['10.16', '34.29', '90']
SYM #PWR? GND ProDoc_IPB-easyedapro:Ground-GND ['148.59', '83.82', '180']
SYM ?  ProDoc_IPB-easyedapro:Drawing-Symbol_A4 ['0', '209.55', '0']
SYM H1  ProDoc_IPB-easyedapro:DZ127S-22-10-55 ['67.31', '184.15', '0']
SYM R69 22R ProDoc_IPB-easyedapro:电阻 ['121.92', '157.48', '0']
SYM R71 10K ProDoc_IPB-easyedapro:电阻 ['78.74', '171.45', '270']
SYM #PWR? +3.3V ProDoc_IPB-easyedapro:Power-VCC ['55.88', '179.07', '0']
SYM #PWR? LINK_3.3V ProDoc_IPB-easyedapro:Power-VCC ['39.37', '109.22', '0']
SYM C84 10uF ProDoc_IPB-easyedapro:CapAcitance ['19.05', '107.95', '270']
SYM C79 100nF ProDoc_IPB-easyedapro:CapAcitance ['43.18', '69.85', '0']
SYM #PWR? GND ProDoc_IPB-easyedapro:Ground-GND ['148.59', '111.76', '0']
SYM R72 10K ProDoc_IPB-easyedapro:电阻 ['88.9', '171.45', '270']
SYM #PWR? GND ProDoc_IPB-easyedapro:Ground-GND ['39.37', '129.54', '0']
SYM C73 100nF ProDoc_IPB-easyedapro:CapAcitance ['43.18', '53.34', '0']
SYM #PWR? GND ProDoc_IPB-easyedapro:Ground-GND ['16.51', '39.37', '0']
SYM D5  ProDoc_IPB-easyedapro:PRTR5V0U2X_C5158049 ['217.17', '24.13', '180']
SYM R62 10K ProDoc_IPB-easyedapro:电阻 ['114.3', '147.32', '270']
SYM #PWR? LINK_3.3V ProDoc_IPB-easyedapro:Power-VCC ['147.32', '68.58', '0']
SYM #PWR? GND ProDoc_IPB-easyedapro:Ground-GND ['68.58', '11.43', '180']
SYM C82 22uF ProDoc_IPB-easyedapro:CapAcitance ['8.89', '107.95', '270']
SYM #PWR? GND ProDoc_IPB-easyedapro:Ground-GND ['8.89', '87.63', '0']
SYM R67 22R ProDoc_IPB-easyedapro:电阻 ['121.92', '154.94', '0']
SYM R65 22R ProDoc_IPB-easyedapro:电阻 ['39.37', '154.94', '0']
SYM #PWR? VBUS2 ProDoc_IPB-easyedapro:Power-VCC ['148.59', '86.36', '90']
SYM R55 10K ProDoc_IPB-easyedapro:电阻 ['106.68', '76.2', '0']
label ISP_KEY ['93.98', '76.2', '0']
label LINK_DN ['146.05', '93.98', '0']
label LINK_DP ['132.08', '96.52', '0']
label ISP_TX ['100.33', '68.58', '0']
label D_RESETN ['46.99', '163.83', '0']
label ISP_RX ['100.33', '71.12', '0']
label ISP_KEY ['233.68', '86.36', '0']
label LINK_DN ['195.58', '20.32', '0']
label LINK_DP ['236.22', '20.32', '0']
global_label LINK_SRST ['34.29', '163.83', '180']
global_label LINK_SRST ['93.98', '60.96', '0']
global_label LINK_UART_RX ['96.52', '91.44', '0']
global_label LINK_UART_TX ['109.22', '157.48', '180']
global_label JTAG.TMS ['92.71', '179.07', '0']
global_label LINK_TRST ['93.98', '58.42', '0']
global_label JTAG.TDO ['48.26', '149.86', '0']
global_label PA00/UART0.TXD ['130.81', '154.94', '0']
global_label LINK_UART_TX ['96.52', '88.9', '0']
global_label JTAG.TDO ['92.71', '184.15', '0']
global_label PA01/UART0.RXD ['130.81', '157.48', '0']
global_label JTAG.TDI ['48.26', '152.4', '0']
global_label JTAG.TRST ['48.26', '160.02', '0']
global_label JTAG.TMS ['48.26', '157.48', '0']
global_label LINK_TDO ['93.98', '53.34', '0']
global_label LINK_TRST ['34.29', '160.02', '180']
global_label LINK_UART_RX ['109.22', '154.94', '180']
global_label LINK_TCK ['93.98', '50.8', '0']
global_label LINK_TCK ['93.98', '104.14', '0']
global_label JTAG.TCK ['92.71', '181.61', '0']
global_label JTAG.TCK ['48.26', '154.94', '0']
global_label JTAG.TDI ['92.71', '186.69', '0']
global_label LINK_TMS ['102.87', '109.22', '0']
global_label LINK_TDO ['34.29', '149.86', '180']
global_label LINK_TDI ['34.29', '152.4', '180']
global_label LINK_TMS ['34.29', '157.48', '180']
global_label JTAG.TRST ['92.71', '189.23', '0']
global_label LINK_TDI ['93.98', '55.88', '0']
global_label LINK_TCK ['34.29', '154.94', '180']

FILE 2_USB.kicad_sch UUID af0366be-40a6-4527-ac40-c42cab485dac
SYM #PWR? GND ProDoc_IPB-easyedapro:Ground-GND ['43.18', '78.74', '0']
SYM D4  ProDoc_IPB-easyedapro:BAT54A-7-F ['102.87', '101.6', '180']
SYM #PWR? GND ProDoc_IPB-easyedapro:Ground-GND ['67.31', '101.6', '270']
SYM #PWR? VBUS ProDoc_IPB-easyedapro:Power-VCC ['144.78', '12.7', '0']
SYM #PWR? +5P ProDoc_IPB-easyedapro:5-Voltage ['82.55', '86.36', '0']
SYM C63 10uF ProDoc_IPB-easyedapro:CapAcitance ['148.59', '96.52', '270']
SYM R47 5.1K[DNP] ProDoc_IPB-easyedapro:电阻 ['76.2', '104.14', '0']
SYM #PWR? GND ProDoc_IPB-easyedapro:Ground-GND ['113.03', '86.36', '90']
SYM #PWR? GND ProDoc_IPB-easyedapro:Ground-GND ['132.08', '116.84', '0']
SYM #PWR? +5P ProDoc_IPB-easyedapro:5-Voltage ['138.43', '17.78', '0']
SYM #PWR? GND ProDoc_IPB-easyedapro:Ground-GND ['134.62', '15.24', '180']
SYM C62 1nF ProDoc_IPB-easyedapro:CapAcitance ['33.02', '73.66', '180']
SYM R45 10K ProDoc_IPB-easyedapro:电阻 ['132.08', '96.52', '90']
SYM R48 10K ProDoc_IPB-easyedapro:电阻 ['120.65', '106.68', '90']
SYM R46 5.1K[DNP] ProDoc_IPB-easyedapro:电阻 ['76.2', '99.06', '0']
SYM D3  ProDoc_IPB-easyedapro:PRTR5V0U2X_C5158049 ['96.52', '80.01', '180']
SYM D2  ProDoc_IPB-easyedapro:SS34A_C2886580 ['153.67', '17.78', '180']
SYM #PWR? +5V ProDoc_IPB-easyedapro:5-Voltage ['162.56', '17.78', '0']
SYM #PWR? +3.3V ProDoc_IPB-easyedapro:Power-VCC ['132.08', '91.44', '0']
SYM #PWR? GND ProDoc_IPB-easyedapro:Ground-GND ['181.61', '107.95', '0']
SYM R49 0R ProDoc_IPB-easyedapro:电阻 ['191.77', '106.68', '180']
SYM #PWR? EARTH ProDoc_IPB-easyedapro:Ground-GND ['105.41', '43.18', '270']
SYM #PWR? GND ProDoc_IPB-easyedapro:Ground-GND ['129.54', '43.18', '0']
SYM #PWR? GND ProDoc_IPB-easyedapro:Ground-GND ['148.59', '91.44', '180']
SYM #PWR? +5V ProDoc_IPB-easyedapro:5-Voltage ['158.75', '101.6', '0']
SYM ?  ProDoc_IPB-easyedapro:Short-Symbol ['144.78', '15.24', '90']
SYM ?  ProDoc_IPB-easyedapro:Drawing-Symbol_A4 ['0', '209.55', '0']
SYM USB1  ProDoc_IPB-easyedapro:TYPE-C 16PIN 2MD(073) ['118.11', '29.21', '180']
SYM U5  ProDoc_IPB-easyedapro:AP2151WG-7 ['168.91', '104.14', '0']
SYM Q1  ProDoc_IPB-easyedapro:2N7002 ['129.54', '111.76', '0']
SYM R50 0R ProDoc_IPB-easyedapro:电阻 ['143.51', '110.49', '180']
SYM #PWR? +5P ProDoc_IPB-easyedapro:5-Voltage ['179.07', '101.6', '0']
SYM #PWR? +5P ProDoc_IPB-easyedapro:5-Voltage ['129.54', '40.64', '270']
SYM #PWR? +3.3V ProDoc_IPB-easyedapro:Power-VCC ['124.46', '91.44', '0']
SYM R44 100K ProDoc_IPB-easyedapro:电阻 ['120.65', '96.52', '90']
SYM R43 1M ProDoc_IPB-easyedapro:电阻 ['33.02', '78.74', '0']
SYM R51 0R ProDoc_IPB-easyedapro:电阻 ['115.57', '115.57', '180']
SYM #PWR? EARTH ProDoc_IPB-easyedapro:Ground-GND ['24.13', '78.74', '0']
SYM L5  ProDoc_IPB-easyedapro:DLW21SN900SQ2L ['125.73', '69.85', '0']
label VUSB_CC2 ['132.08', '20.32', '0']
label USB0_OC ['199.39', '106.68', '0']
label VUSB_CC1 ['90.17', '99.06', '0']
label VUSB_P ['85.09', '63.5', '0']
label USB0_PWR ['148.59', '110.49', '0']
label USB0_ID ['120.65', '115.57', '0']
label VUSB_N ['153.67', '27.94', '180']
label VUSB_CC1 ['142.24', '35.56', '180']
label VUSB_CC2 ['90.17', '104.14', '0']
label USB0_N ['138.43', '73.66', '0']
label VUSB_P ['153.67', '30.48', '180']
label VUSB_N ['85.09', '66.04', '0']
label USB0_P ['138.43', '63.5', '0']

FILE 3_POWER.kicad_sch UUID f11aa226-403d-48c7-9dfa-fae3365d5e0c
SYM C92 22uF ProDoc_IPB-easyedapro:CapAcitance ['87.63', '39.37', '270']
SYM C96 10uF ProDoc_IPB-easyedapro:CapAcitance ['176.53', '55.88', '270']
SYM R81 10K ProDoc_IPB-easyedapro:电阻 ['132.08', '96.52', '270']
SYM #PWR? VREF_3.3V ProDoc_IPB-easyedapro:Power-VCC ['201.93', '45.72', '0']
SYM #PWR? GND ProDoc_IPB-easyedapro:Ground-GND ['105.41', '69.85', '270']
SYM U12  ProDoc_IPB-easyedapro:TLV62569DBVR ['102.87', '78.74', '0']
SYM C102 100nF ProDoc_IPB-easyedapro:CapAcitance ['73.66', '86.36', '90']
SYM R82 10K ProDoc_IPB-easyedapro:电阻 ['101.6', '128.27', '270']
SYM #PWR? GND ProDoc_IPB-easyedapro:Ground-GND ['176.53', '60.96', '0']
SYM C104 22uF ProDoc_IPB-easyedapro:CapAcitance ['86.36', '86.36', '270']
SYM R75 33K ProDoc_IPB-easyedapro:电阻 ['58.42', '39.37', '90']
SYM L7  ProDoc_IPB-easyedapro:BLM15PX121SN1D ['181.61', '50.8', '0']
SYM C90 100nF ProDoc_IPB-easyedapro:CapAcitance ['74.93', '39.37', '90']
SYM C111 10uF ProDoc_IPB-easyedapro:CapAcitance ['134.62', '123.19', '270']
SYM #PWR? GND ProDoc_IPB-easyedapro:Ground-GND ['229.87', '63.5', '0']
SYM C103 22uF ProDoc_IPB-easyedapro:CapAcitance ['81.28', '86.36', '270']
SYM #PWR? +5V ProDoc_IPB-easyedapro:5-Voltage ['97.79', '44.45', '0']
SYM LED2  ProDoc_IPB-easyedapro:LED_R ['185.42', '22.86', '0']
SYM R80 10K ProDoc_IPB-easyedapro:电阻 ['132.08', '86.36', '270']
SYM R76 10K ProDoc_IPB-easyedapro:电阻 ['151.13', '41.91', '0']
SYM C95 22uF ProDoc_IPB-easyedapro:CapAcitance ['104.14', '49.53', '90']
SYM C107 22uF ProDoc_IPB-easyedapro:CapAcitance ['154.94', '86.36', '270']
SYM U14  ProDoc_IPB-easyedapro:LP5907MFX-3.3/NOPB ['111.76', '120.65', '0']
SYM #PWR? +3.3V ProDoc_IPB-easyedapro:Power-VCC ['73.66', '81.28', '0']
SYM #PWR? +3.3V ProDoc_IPB-easyedapro:Power-VCC ['133.35', '76.2', '0']
SYM #PWR? +5V ProDoc_IPB-easyedapro:5-Voltage ['175.26', '50.8', '0']
SYM C88 100nF ProDoc_IPB-easyedapro:CapAcitance ['129.54', '34.29', '0']
SYM C93 100nF ProDoc_IPB-easyedapro:CapAcitance ['91.44', '49.53', '90']
SYM #PWR? +3.3V ProDoc_IPB-easyedapro:Power-VCC ['46.99', '34.29', '0']
SYM C105 22pF ProDoc_IPB-easyedapro:CapAcitance ['140.97', '86.36', '90']
SYM #PWR? GND ProDoc_IPB-easyedapro:Ground-GND ['91.44', '128.27', '0']
SYM C91 22uF ProDoc_IPB-easyedapro:CapAcitance ['82.55', '39.37', '270']
SYM C100 22uF ProDoc_IPB-easyedapro:CapAcitance ['209.55', '58.42', '270']
SYM #PWR? AGND ProDoc_IPB-easyedapro:Ground-AGND ['201.93', '63.5', '0']
SYM #PWR? GND ProDoc_IPB-easyedapro:Ground-GND ['113.03', '78.74', '90']
SYM #PWR? GND ProDoc_IPB-easyedapro:Ground-GND ['58.42', '54.61', '0']
SYM C109 4.7uF ProDoc_IPB-easyedapro:CapAcitance ['91.44', '123.19', '90']
SYM #PWR? +3.3V-T ProDoc_IPB-easyedapro:Power-VCC ['68.58', '34.29', '0']
SYM #PWR? GND ProDoc_IPB-easyedapro:Ground-GND ['190.5', '22.86', '90']
SYM C110 100nF ProDoc_IPB-easyedapro:CapAcitance ['127', '123.19', '90']
SYM #PWR? +5V ProDoc_IPB-easyedapro:5-Voltage ['81.28', '118.11', '0']
SYM C106 100nF ProDoc_IPB-easyedapro:CapAcitance ['147.32', '86.36', '90']
SYM L6  ProDoc_IPB-easyedapro:BLM18KG121TN1D ['53.34', '34.29', '0']
SYM U10  ProDoc_IPB-easyedapro:TPS563201DDCR ['125.73', '41.91', '0']
SYM C99 100nF ProDoc_IPB-easyedapro:CapAcitance ['201.93', '58.42', '90']
SYM R77 10K ProDoc_IPB-easyedapro:电阻 ['58.42', '49.53', '270']
SYM #PWR? +3.3V ProDoc_IPB-easyedapro:Power-VCC ['170.18', '22.86', '0']
SYM U13 4.7uH ProDoc_IPB-easyedapro:FTC252010S4R7MBCA ['127', '81.28', '0']
SYM C89 22pF ProDoc_IPB-easyedapro:CapAcitance ['68.58', '39.37', '90']
SYM C94 22uF ProDoc_IPB-easyedapro:CapAcitance ['97.79', '49.53', '90']
SYM U11  ProDoc_IPB-easyedapro:REF3033AIDBZR ['222.25', '53.34', '270']
SYM C101 100nF(NC) ProDoc_IPB-easyedapro:CapAcitance ['110.49', '69.85', '180']
SYM #PWR? GND ProDoc_IPB-easyedapro:Ground-GND ['74.93', '44.45', '0']
SYM #PWR? GND ProDoc_IPB-easyedapro:Ground-GND ['134.62', '128.27', '0']
SYM C97 100nF ProDoc_IPB-easyedapro:CapAcitance ['186.69', '55.88', '90']
SYM C108 22uF ProDoc_IPB-easyedapro:CapAcitance ['160.02', '86.36', '270']
SYM #PWR? GND ProDoc_IPB-easyedapro:Ground-GND ['132.08', '101.6', '0']
SYM #PWR? GND ProDoc_IPB-easyedapro:Ground-GND ['73.66', '91.44', '0']
SYM #PWR? +3.3VA ProDoc_IPB-easyedapro:Power-VCC ['134.62', '118.11', '0']
SYM C98 10uF ProDoc_IPB-easyedapro:CapAcitance ['194.31', '55.88', '270']
SYM R74 4.7K ProDoc_IPB-easyedapro:电阻 ['175.26', '22.86', '0']
SYM R78 0R ProDoc_IPB-easyedapro:电阻 ['222.25', '63.5', '0']
SYM #PWR? AGND ProDoc_IPB-easyedapro:Ground-AGND ['186.69', '60.96', '0']
SYM R79 10K ProDoc_IPB-easyedapro:电阻 ['120.65', '76.2', '0']
SYM U9 4.7uH ProDoc_IPB-easyedapro:FTC252010S4R7MBCA ['106.68', '34.29', '0']
SYM #PWR? GND ProDoc_IPB-easyedapro:Ground-GND ['97.79', '55.88', '0']
SYM ?  ProDoc_IPB-easyedapro:Drawing-Symbol_A4 ['0', '209.55', '0']
SYM L9  ProDoc_IPB-easyedapro:BLM15PX121SN1D ['86.36', '118.11', '0']
SYM #PWR? +1.2V ProDoc_IPB-easyedapro:Power-VCC ['176.53', '81.28', '0']
SYM L8  ProDoc_IPB-easyedapro:BLM18KG121TN1D ['168.91', '81.28', '0']
SYM #PWR? +5V ProDoc_IPB-easyedapro:5-Voltage ['163.83', '41.91', '0']
text 3.3=0.768*(1+33/10) ['119.38', '53.34', '0']
text 1.2=0.6*(1+1) ['99.06', '96.52', '0']

FILE ProDoc_IPB-TINY_2026-10-26.kicad_sch UUID b0e24152-2343-4054-92b0-3c2b63b2b6fa
sheet [['Sheetname', 'IO'], ['Sheetfile', '1_IO.kicad_sch']] ['5.08', '5.08']
sheet [['Sheetname', 'CORE'], ['Sheetfile', '6_CORE.kicad_sch']] ['5.08', '49.53']
sheet [['Sheetname', 'POWER'], ['Sheetfile', '3_POWER.kicad_sch']] ['5.08', '22.86']
sheet [['Sheetname', 'USB'], ['Sheetfile', '2_USB.kicad_sch']] ['5.08', '13.97']
sheet [['Sheetname', 'ETHERCAT'], ['Sheetfile', '5_ETHERCAT.kicad_sch']] ['5.08', '40.64']
sheet [['Sheetname', 'DAP'], ['Sheetfile', '4_DAP.kicad_sch']] ['5.08', '31.75']

FILE GD32F5_FOC.kicad_sch UUID df410b35-b24b-4f8c-aaa2-f94e7558172b
text Dual independent motor framework
Common input supply + GD32F505VxTx controller
Review protection thresholds and ratings before energizing. ['32', '85', '0']
sheet [['Sheetname', 'MCU'], ['Sheetfile', 'MCU.kicad_sch']] ['31.75', '30.48']
sheet [['Sheetname', 'POWER_SHARED'], ['Sheetfile', 'power.kicad_sch']] ['78.74', '30.48']
sheet [['Sheetname', 'FOC_M1'], ['Sheetfile', 'FOC_M1.kicad_sch']] ['125', '30.48']
sheet [['Sheetname', 'FOC_M2'], ['Sheetfile', 'FOC_M2.kicad_sch']] ['172', '30.48']

FILE MCU.kicad_sch UUID 09f14da5-696b-46d6-9635-e52d0595c078
SYM CN2 5012 ProDoc_Boa-easyedapro:5012 ['204.47', '25.4', '90']
SYM J201 FAULT INPUTS: 3V3 GND M1 M2 Connector_Generic:Conn_01x04 ['299.72', '105.41', '0']
SYM #PWR9032 VCC StylePower:VCC ['294.64', '102.87', '0']
SYM #PWR0001 VCC ProDoc_Boa-easyedapro:Power-VCC ['210.82', '31.75', '0']
SYM #PWR9035 GND StylePower:GND ['209', '133.81', '0']
SYM CN3 5012 ProDoc_Boa-easyedapro:5012 ['217.17', '39.37', '0']
SYM C3 1uF ProDoc_Boa-easyedapro:CL05A106MQ5NUNC ['210.82', '35.56', '90']
SYM #PWR9030 VCC StylePower:VCC ['299.72', '176.53', '0']
SYM R200 10k Device:R ['160', '175', '0']
SYM #PWR9003 GND StylePower:GND ['191', '133.81', '0']
SYM #PWR9009 AGND StylePower:AGND ['124.46', '182.88', '0']
SYM C202 100nF Device:C ['191', '130', '0']
SYM #PWR0002 GND ProDoc_Boa-easyedapro:Ground-GND ['210.82', '39.37', '0']
SYM #PWR9031 MCU_VDDA StylePower:MCU_VDDA ['48.26', '147.32', '0']
SYM #PWR0003 AVCC ProDoc_Boa-easyedapro:Power-VCC ['210.82', '54.61', '0']
SYM #PWR9012 VCC StylePower:VCC ['155', '126.19', '0']
SYM #PWR9015 GND StylePower:GND ['173', '133.81', '0']
SYM J200 SWD 3V3 GND DIO CLK Connector_Generic:Conn_01x04 ['245', '105', '0']
SYM R3 0Ω ProDoc_Boa-easyedapro:0402WGF1002TCE ['217.17', '69.85', '180']
SYM #PWR9018 GND StylePower:GND ['155', '133.81', '0']
SYM #PWR9027 VCC StylePower:VCC ['155', '146.19', '0']
SYM #PWR9016 MCU_VDDA StylePower:MCU_VDDA ['201', '146.19', '0']
SYM #PWR9017 VCC StylePower:VCC ['270.51', '176.53', '0']
SYM CN6 5012 ProDoc_Boa-easyedapro:5012 ['205.74', '48.26', '90']
SYM U2 LP5907QMFX-3.3Q1 ProDoc_Boa-easyedapro:LP5907QMFX-3.3Q1 ['191.77', '59.69', '0']
SYM #PWR0004 GND ProDoc_Boa-easyedapro:Ground-GND ['177.8', '39.37', '0']
SYM #PWR9028 VCC StylePower:VCC ['191', '126.19', '0']
SYM C6 1uF ProDoc_Boa-easyedapro:CL05A106MQ5NUNC ['210.82', '58.42', '90']
SYM C5 1uF ProDoc_Boa-easyedapro:CL05A106MQ5NUNC ['170.18', '58.42', '90']
SYM C204 100nF Device:C ['227', '130', '0']
SYM #PWR9033 AGND StylePower:AGND ['224', '153.81', '0']
SYM C200 100nF Device:C ['155', '130', '0']
SYM #PWR9011 VCC StylePower:VCC ['48.26', '154.94', '0']
SYM C209 100nF Device:C ['185', '175', '0']
SYM #PWR9007 GND StylePower:GND ['294.64', '105.41', '0']
SYM #PWR9004 GND StylePower:GND ['235', '178.81', '0']
SYM C203 100nF Device:C ['209', '130', '0']
SYM #PWR9022 MCU_VDDA StylePower:MCU_VDDA ['224', '146.19', '0']
SYM #PWR9029 AGND StylePower:AGND ['48.26', '144.78', '0']
SYM #PWR9010 MCU_VDDA StylePower:MCU_VDDA ['275.59', '148.59', '0']
SYM C201 100nF Device:C ['173', '130', '0']
SYM #PWR9001 AGND StylePower:AGND ['201', '153.81', '0']
SYM #PWR0005 AGND ProDoc_Boa-easyedapro:Ground-AGND ['210.82', '62.23', '0']
SYM #PWR9025 MCU_VDDA StylePower:MCU_VDDA ['178', '146.19', '0']
SYM #PWR9002 VCC StylePower:VCC ['160', '171.19', '0']
SYM R202 10k Device:R ['235', '175', '0']
SYM C205 4.7uF Device:C ['155', '150', '0']
SYM #PWR9013 GND StylePower:GND ['239.92', '105', '0']
SYM C2 1uF ProDoc_Boa-easyedapro:CL05A106MQ5NUNC ['170.18', '35.56', '90']
SYM R203 0R VDDA LINK Device:R ['275.59', '144.78', '0']
SYM #PWR9019 GND StylePower:GND ['227', '133.81', '0']
SYM C208 100nF Device:C ['224', '150', '0']
SYM #PWR0006 5V ProDoc_Boa-easyedapro:5-Voltage ['170.18', '31.75', '0']
SYM #PWR9006 GND StylePower:GND ['132.08', '177.8', '0']
SYM #PWR9026 VCC StylePower:VCC ['227', '126.19', '0']
SYM U20 XC6210B332MR ProDoc_Boa-easyedapro:XC6210B332MR ['191.77', '34.29', '0']
SYM #PWR9024 MCU_VDDA StylePower:MCU_VDDA ['48.26', '175.26', '0']
SYM U1 GD32F505VxTx MCU:GD32F505VxTx (Altium Display 1) ['63.5', '27.94', '0']
SYM #PWR9014 AGND StylePower:AGND ['178', '153.81', '0']
SYM #PWR0007 GND ProDoc_Boa-easyedapro:Ground-GND ['177.8', '62.23', '0']
SYM #PWR9021 VCC StylePower:VCC ['275.59', '140.97', '0']
SYM C207 1uF Device:C ['201', '150', '0']
SYM R204 10k Device:R ['270.51', '180.34', '0']
SYM #PWR9036 VCC StylePower:VCC ['209', '126.19', '0']
SYM #PWR0008 5V ProDoc_Boa-easyedapro:5-Voltage ['170.18', '54.61', '0']
SYM #PWR9008 GND StylePower:GND ['185', '178.81', '0']
SYM #PWR9034 VCC StylePower:VCC ['173', '126.19', '0']
SYM #PWR0009 AGND ProDoc_Boa-easyedapro:Ground-AGND ['222.25', '69.85', '0']
SYM R205 10k Device:R ['299.72', '180.34', '0']
SYM #PWR9005 VCC StylePower:VCC ['239.92', '102.46', '0']
SYM C206 100nF Device:C ['178', '150', '0']
SYM #PWR9020 GND StylePower:GND ['155', '153.81', '0']
SYM #PWR0010 GND ProDoc_Boa-easyedapro:Ground-GND ['212.09', '69.85', '0']
SYM #PWR9023 GND StylePower:GND ['210', '178.81', '0']
SYM R201 10k Device:R ['210', '175', '0']
global_label M1_BRKIN ['270.51', '184.15', '0']
global_label M2_LIN3 ['116.84', '35.56', '180']
global_label M2_HIN2 ['116.84', '48.26', '180']
global_label M2_IBUS ['116.84', '43.18', '180']
global_label M2_HALL_C ['116.84', '114.3', '180']
global_label M1_HIN3 ['55.88', '58.42', '0']
global_label BOOT0 ['210', '171.19', '0']
global_label M2_HALL_A ['116.84', '109.22', '180']
global_label M1_BRKIN ['55.88', '109.22', '0']
global_label SPI2_MOSI ['116.84', '63.5', '180']
global_label SPI2_SCK ['116.84', '58.42', '0']
global_label M2_LIN2 ['116.84', '33.02', '180']
global_label M1_HALL_C ['55.88', '76.2', '0']
global_label M1_LIN2 ['55.88', '114.3', '0']
global_label M1_IC ['55.88', '35.56', '0']
global_label BOOT1 ['55.88', '81.28', '0']
global_label M2_IA ['55.88', '38.1', '0']
global_label M2_BRKIN ['55.88', '45.72', '0']
global_label SWDIO ['239.92', '107.54', '0']
global_label SWCLK ['239.92', '110.08', '0']
global_label SWDIO ['55.88', '66.04', '0']
global_label M2_SPI1_CS0 ['116.84', '129.54', '180']
global_label M1_HIN1 ['55.88', '53.34', '0']
global_label SPI2_MISO ['116.84', '60.96', '180']
global_label M2_HIN3 ['116.84', '53.34', '180']
global_label M2_HIN1 ['116.84', '45.72', '180']
global_label M1_IBUS ['116.84', '38.1', '180']
global_label M2_BRKIN ['294.64', '110.49', '0']
global_label NRST ['160', '178.81', '0']
global_label M2_IB ['55.88', '40.64', '0']
global_label BOOT0 ['55.88', '132.08', '0']
global_label M2_IC ['55.88', '43.18', '0']
global_label M1_HALL_A ['55.88', '86.36', '0']
global_label BOOT1 ['235', '171.19', '0']
global_label M1_HALL_B ['55.88', '88.9', '0']
global_label NRST ['55.88', '137.16', '0']
global_label M1_VBUS ['116.84', '40.64', '180']
global_label M1_SPI1_CS0 ['116.84', '127', '180']
global_label M2_LIN1 ['116.84', '30.48', '180']
global_label SWCLK ['55.88', '68.58', '0']
global_label M1_BRKIN ['294.64', '107.95', '0']
global_label M2_HALL_B ['116.84', '111.76', '180']
global_label M2_BRKIN ['299.72', '184.15', '0']
global_label NRST ['185', '171.19', '0']
global_label M1_IB ['55.88', '33.02', '0']
global_label M1_LIN1 ['55.88', '111.76', '0']
global_label M1_LIN3 ['55.88', '116.84', '0']
global_label M2_NTC ['116.84', '144.78', '180']
global_label M1_NTC ['116.84', '139.7', '180']
global_label M1_IA ['55.88', '30.48', '0']
global_label M1_HIN2 ['55.88', '55.88', '0']
text MCU_VDDA = VCC through R203 (0R), bypass C206..C208 to AGND.
AVCC LDO remains for external analog amplifiers only.
J201: 1=3V3, 2=GND, 3=M1_BRKIN, 4=M2_BRKIN.
FAULT inputs use pullups; external open-drain HEALTH holds LOW only while healthy.
Configure each timer break polarity HIGH; unplugged defaults to brake. No autonomous trip comparator fitted.
Current limits/thresholds and external fault source remain to be designed. ['150', '210', '0']
text M1 TIMER0: PA8/9/10 AF1; PB13/14 AF2, PB15 AF1. BRKIN PB12 AF4.
M2 TIMER7: PC6/7 AF3, PC8 AF2; PC0/1/2 AF0. BRKIN PA6 AF4.
M1 currents PA0/1/2; M2 currents PA3/4/5 (ADC0/ADC1).
IBUS: PC3 / PC5; VBUS PC4; NTC PE7 / PE8 (ADC2).
Hall M1 PB4/5/0 TIMER2; M2 PD12/13/14 TIMER3. Release PB4 JTAG, keep SWD.
Shared SPI2 PC10/11/12 AF2; GPIO chip selects PE2 / PE3.
VA/VB/VC/COM and M2_VBUS stay on power-sheet testpoints, not MCU ADC. ['150', '250', '0']
