CYFS3/GD32FOC/.layout-review/foc-reuse-mapping.md

# FOC模块精确参考复用映射（只读）

已生成 `foc-reuse-map.json`，不接IPC、不修改任何原理图、库或PCB。数据为参考PCB读取坐标/焊盘、当前M1/M2页属性及q1-after.xml真实引脚网络。

## 覆盖与验证

每路162实体封装完整覆盖：147项参考可映射、15项新增无相同参考功能位置。M1/M2对等器件按完整模块内(ref,pin)网络分区比较，通过完全对称验证。M2普通位号为M1+1000；特殊C9101→C9103、C9102→C9104、R9101→R9103、R9102→R9104、U9101→U9102已明确列入。

数据每行含source_ref、m1_ref、m2_ref、原始绝对x/y、rotation、layer及全部source_pads，另含置信度、证据与引脚编号映射。源参考之外未用器件在reference_not_reused，不能误认为全部是当前FOC删除器件：其中包含共享电源、原STM32主控、CAN等非FOC模块功能。

## 重要跨位号映射

|当前M1|参考|依据|
|---|---|---|
|C130/C131/C132|C66/C70/C71|准确VB1/2/3与MA/MB/MC自举两网络，当前与参考pin1/2相反|
|C133/C134/C135/C136|C62/C61/C68/C67|IC/IBUS/IB/IA到AGND滤波|
|C143|C69|驱动12V到GND近端去耦|
|C145/C147/C149|C63/C64/C65|对应MA/MB/MC及高侧门极二极管相邻网络|
|C146/C148/C150|C72/C73/C74|对应IA+/IB+/IC+及低侧门极二极管相邻网络|
|R145/R146|R45/R42|运放A输入负反馈同一引脚邻域|
|R147/R148/R149|R44/R49/R41|运放B负输入/正输入/反馈邻域|
|NTC1|NTC2|源信号名NTC1，对应现M1_NTC，非仅按器件号|
|CN5|U8|霍尔接口功能替换；参考5针变当前6针+PWM，几何不一致|

核心功率Q5–Q10、U7、U10、R81/82/83/R109等同号通过功能/引脚核对；源IA−在当前名为SHUNT_RETURN。源HALL_A/B/C在新缓冲器之前，对应当前ENC_A/B/C_IN，不应与缓冲后MCU HALL网混淆。源SPI1_CSN对应当前SPI1_CS0。

C130/131/132必须按source pin1↔current pin2对齐，数据给180度极性无关旋转提示；实际封装原点/引脚方向仍应由执行agent按真实焊盘求解。相同命名电源两端的重复同值电容，位号来源和相同网络支持复用，但不声称图同构能数学唯一辨别它们；标medium_provenance_topology。

## 新增器件

每路新增15项：C9101、C9102、R103、R105、R300–305、R49、R54、R9101、R9102、U9101。分别为新增缓冲供电、PWM接口支路、PWM默认下拉、接口上拉电源桥和编码器3.3V/5V选项。不得把新增C9101任意匹配参考其他VCC/GND电容C105，只因同值同网便偷用位置；本映射已排除这种匹配。

新增器件应在复用模板外围放置并以同一M2平移复制；CN5功能替换的额外长度需留空间。整体参考相对位置不作自动避碰挪动，若真实封装变化导致碰撞应报告，不能无声破坏用户要求的完全复制。

## 正反面

每路147参考映射中138个F.Cu、9个B.Cu。背面全部是C96–C104母线瓷片（M2对应C1096–C1104），参考角度均0°，x156.0705。不能把这9颗放到正面而宣称完整复刻。source_pads.local_at为参考PCB文件储存局部坐标，不能再仅因B.Cu额外重复镜像；执行应公共flip后重新读实际焊盘，比对参考相对位置和网络端点。

## 建议平移

147个参考映射器件中心范围x142.1315…195.504、y81.925…131.5805mm，中心包络53.3725×49.6555mm。建议M2相对M1仅平移(+73.3725,0)mm、无旋转、无镜像；20mm中心包络间隔为新增接口/缓冲器预留，最终需根据source和current实际bbox校正外围总范围，不可把中心bbox视为板边。所有源坐标及朝向已保留，可将M1整体移到目标起点后M2使用相同delta。
