CYFS3/GD32FOC/.layout-review/power-integrated-execution.md

# 参考电源与FOC统一布局执行

已通过公开KiCad IPC完成并保存。原始完整备份为power-integrated-before.kicad_pcb。532个器件身份、位号、焊盘编号/网络保持，两个FOC组各162成员保持。无布线、过孔、铜区或板框，2铜层未更改。

## 共同参考坐标

参考板左上(99.1235,79.8475)映射至(10,10)，共同平移T=(-89.1235,-69.8475)mm。97个公共电源器件与M1的147个参考映射均以此T为基础，按真实对应焊盘补偿封装原点与正交角度；最大电源模型焊盘中心拟合残差U6约0.291mm、电解约0.273mm。不得将此模型尺寸差异称为原图完全同模型。

M2与M1同X、同方向，Y差71.5mm，162对最大读回误差约1nm。M1占用x51.383..109.7795、y10.7973..74.275；M2 y82.2973..145.775。电源占用约x10.4..76.138、y10.0005..65.091。公共电源已回到第一路功率桥旁边，不在远下方。

控制23个器件整体放在x10..39.01、y77..103.235；HSLink58件x10..40.6565、y108..142.08；显示25件x43..64.6675、y151..170.581；调试5件x80..106.59、y151..162.21。各组内部关系保持。总占用约100×161mm，尚未确定加工外形。

## 测试点纠正

52处原错误Keystone实体测试点恢复为VerifiedParts:TestPoint_D1.27_Reference，Value TestPoint，单pad1圆直径1.27mm，F.Cu/F.Mask，无Paste无钻孔；Fab圆1.524mm，courtyard方2.075mm；原pad/FP UUID与网络保持。44个FOC测试点恢复参考原位置，取消之前测试点外围避让。TP200不变。所有测试点焊盘实际中心与封装中心误差不超过1nm。旧Keystone内部图形/3D已替换，标准Datasheet清空、BOM/贴片排除；公共SDK未暴露原definition descr/tags，其历史字符串仍可能留在文件元数据中，但实际几何和采购值已改。

参考与当前六针霍尔接口不同，CN5/CN1005保留原兼容偏移，其余参考FOC核心不重新打散。

## 层与导入属性

公共电源15器件恢复参考B.Cu，加原18母线电容，共33个B.Cu封装。已将既定5个错误SMD库定义的额外37个共享实例（19C、18R）纠正，全板这5定义245实例读回确认SMD/孔0/单铜面，所有几何和网络保持。

D22型号1.5SMC30CAHE3/57T、SMC封装被误导入0.001mm通孔全铜，已明确修板上B.SMD以及源SMC库F.SMD，尺寸不变。CN1现XT30PW-M较参考F具有真实额外机械PTH孔，不能删除；D22作为唯一公共电源位置兼容例外x+1mm至(16.956499,20.7215)，仍紧贴入口。CN1机械孔1.1mm/铜盘1.8mm完全保留。

最终重新读取两铜面真实焊盘多边形，不同封装异网铜相交0。未声称全DRC通过；装配边界、旧导入孔/丝印及库匹配仍由父代理最终原生DRC分类。坐标与证据在power-integrated-plan.json/power-integrated-validation.json。
