CYFS3/GD32FOC/.layout-review/reference-layouts.md

# 参考工程PCB只读布局分析

范围仅为data/FOC和data/HPM中的指定PCB及原理图；所有坐标来自原生文本只读解析，无pcbnew/SWIG、无PCB写入。kicad-ipc已加载并运行diagnose：当前无GetOpenDocuments handler，未连接PCB editor。报告不是DRC或可制造性合格声明。

完整器件坐标、层、方向、焊盘局部坐标/网络和原理图属性见`reference-coordinates.json`。板坐标单位mm，x向右/y向下；相对坐标以Edge.Cuts外接矩形左上为零点。角度为文件原值，未执行镜像或旋转转换。参考位号不能与当前工程直接同号匹配，应按MPN、网络功能映射。

## 板尺寸与层

|参考|外形|绝对边界|铜层|厚度|封装数|
|---|---|---|---|---|---|
|FOC|100×55mm，约R0.5圆角|x99.1235…199.1235,y79.8475…134.8475|F/In1/In2/In3/In4/B，6层|1.6mm|338|
|HPM|77.4005×53.248mm，约R1圆角|x113.766…191.1665,y79.6825…132.9305|F/In1/In2/B，4层|1.6mm|251|

均为文件配置的铜层，不代表已验证层叠介质厚度或阻抗。选取关键器件均在F.Cu。FOC含1877直线铜段/1736via；HPM含1966直线铜段/18铜弧/336via。大量导入zone图元不能解读为独立电气平面数量。

## FOC空间组织

左侧输入及降压电源，右上功率桥/采样电阻，右下运放与信号接口，MCU位于下部中间。参考只有一套三相FOC，当前两路FOC应把功率单元复制成两个独立分区，并重新规划共享DCBUS和回流，不能将整板当一个可直接套用模板。

|参考位号|器件/值|x,y mm|相对板左上 x,y mm|旋转|
|---|---|---|---|---|
|CN3|XT30PW-F|110.6680, 90.5690|11.5445, 10.7215|-90.0°|
|Q1|WSD90P06DN56|120.1930, 87.2670|21.0695, 7.4195|-90.0°|
|Q3|WSD80120DN56|118.1740, 93.9980|19.0505, 14.1505|90.0°|
|U2|LM5164DDAR|130.9650, 105.6185|31.8415, 25.7710|90.0°|
|U5|RY8411|114.2190, 105.1105|15.0955, 25.2630|-90.0°|
|U3|XC6210B332MR|106.3530, 99.2035|7.2295, 19.3560|0°|
|U4|LP5907QMFX-3.3Q1|110.2230, 99.2035|11.0995, 19.3560|180.0°|
|U7|FD6288Q|146.9320, 109.3650|47.8085, 29.5175|0°|
|Q5|NCE7560K|153.0860, 84.2190|53.9625, 4.3715|0°|
|Q6|NCE7560K|153.0860, 91.2040|53.9625, 11.3565|0°|
|Q7|NCE7560K|153.0860, 98.1890|53.9625, 18.3415|0°|
|Q8|NCE7560K|166.1670, 84.2190|67.0435, 4.3715|0°|
|Q9|NCE7560K|166.1670, 91.2040|67.0435, 11.3565|0°|
|Q10|NCE7560K|166.1670, 98.1890|67.0435, 18.3415|0°|
|R81|1mΩ|176.4540, 84.2190|77.3305, 4.3715|0°|
|R82|1mΩ|176.4540, 91.1950|77.3305, 11.3475|0°|
|R83|1mΩ|176.4540, 98.1890|77.3305, 18.3415|0°|
|R109|1mΩ|186.2230, 101.6180|87.0995, 21.7705|0°|
|CN41|MR30PW-F|187.0160, 91.2040|87.8925, 11.3565|90.0°|
|U10|RS624XQ|173.2870, 117.4930|74.1635, 37.6455|-90.0°|
|U1|STM32G431RBT6|155.7530, 118.7630|56.6295, 38.9155|-90.0°|
|X1|8MHz|146.3250, 118.1480|47.2015, 38.3005|-90.0°|
|U6|LM321MF/NOPB|161.5820, 128.1610|62.4585, 48.3135|-90.0°|

实际三相阵列：高侧Q5/Q6/Q7在x153.086，低侧Q8/Q9/Q10在x166.167；三行y84.219/91.204/98.189，行距6.985mm。同相高低管中心距13.081mm。R81/R82/R83在x176.454，对应三行（R82 y91.195，差0.009）；低侧管到分流电阻中心约10.287mm。CN41三相输出在x187.016，处于功率区右边缘。

U7 FD6288Q在(146.932,109.365)，位于功率阵列左下方；不是每相管对中央。R59/60/61位于y103.747，高侧栅阻中心距驱动器5.679/6.011/7.594mm；低侧栅阻R75示例(154.864,108.0945)，距驱动器8.033mm。参考布局这些距离不证明门极回路最优，当前布局可将驱动器更靠近门极汇合区、栅阻靠门极，尽量缩短驱动及源极回流。

自举支路：D8(142.1315,106.204)、C66(142.2585,104.6945)连接VB1/MA；D9(142.1315,103.185)、C70(142.2585,101.675)连接VB2/MB。这说明参考按竖向排列自举网络；当前应按相应VB/VS引脚就近摆放，不照搬较长距离。VCC近端C69在(147.8375,112.9845)，距U7中心3.731mm。

DCBUS瓷片集中在高侧附近：C96/C99/C101位于x156.0705、y82.314/84.346/86.378，均DCBUS-PGND；其位置可参考为本地母线旁路区，但应优先构成高侧—低侧—母线电容最小换流回路，不能只看器件中心距离。

采样运放U10位于(173.287,117.493)，远离功率行，在右下信号区。各通道输入/反馈电阻围绕U10，示例R68(172.5785,113.0395)与R72(171.3085,113.0395)分别接IA-、IB+；电流输出滤波C68(176.3885,113.0395)接IB/AGND。可参考“功率shunt区→Kelvin采样对→集中运放→MCU ADC”的分区，但参考shunt到运放距离并不短，当前应保留紧耦合差分采样、避开相节点铜皮并独立回流。

MCU是STM32G431RBT6 LQFP64，中心(155.753,118.763)，晶体X1(146.325,118.148)距MCU中心9.448mm。当前GD32F505 LQFP100及高低速两晶体不可按参考LQFP64直接映射，必须以当前8/9/12/13脚位置及焊盘为准。

## HPM调试器子区

参考全板含以太网及较大HPM主控，当前应只参考4_DAP中的HPM5301子区。USB2对应当前USB8002；U6对应U8006；X2对应X8002；D5对应D8005；U7是4.7µH电感，对应当前U8007，不可当IC。

|参考位号|器件/值|x,y mm|相对板左上 x,y mm|旋转|
|---|---|---|---|---|
|USB2|TYPE-C 16PIN 2MD(073)|187.3765, 121.9205|73.6105, 42.2380|90.0°|
|D5|PRTR5V0U2X|182.4995, 122.7080|68.7335, 43.0255|180.0°|
|U6|HPM5301IEG1|176.8355, 122.8095|63.0695, 43.1270|-90.0°|
|X2|24MHz|180.9225, 128.6435|67.1565, 48.9610|-90.0°|
|C80|15pF|179.2990, 128.3975|65.5330, 48.7150|90.0°|
|C81|15pF|182.6265, 128.6770|68.8605, 48.9945|90.0°|
|R54|1M|180.9755, 126.8230|67.2095, 47.1405|180.0°|
|U7|4.7uH|170.8530, 120.2525|57.0870, 40.5700|-90.0°|
|C64|4.7uF|174.3180, 117.1815|60.5520, 37.4990|90.0°|
|C65|100nF|174.2485, 114.7705|60.4825, 35.0880|90.0°|
|C66|4.7uF|168.5295, 124.3590|54.7635, 44.6765|180.0°|
|C67|100nF|170.8665, 124.3085|57.1005, 44.6260|180.0°|
|C68|100nF|178.0800, 117.1815|64.3140, 37.4990|-90.0°|
|C69|100nF|180.6455, 119.0505|66.8795, 39.3680|-90.0°|
|C70|100nF|177.9530, 128.3975|64.1870, 48.7150|90.0°|
|C71|100nF|175.3400, 117.1815|61.5740, 37.4990|-90.0°|
|C72|100nF|175.8050, 128.4000|62.0390, 48.7175|90.0°|
|C73|100nF|170.9170, 123.0890|57.1510, 43.4065|0°|
|C74|100nF|176.7550, 128.3640|62.9890, 48.6815|90.0°|
|C75|100nF|177.1110, 117.1815|63.3450, 37.4990|-90.0°|
|C77|100nF|170.8920, 122.0730|57.1260, 42.3905|0°|
|R56|5.1K|182.6775, 125.8830|68.9115, 46.2005|90.0°|
|R57|5.1K|182.4995, 120.2950|68.7335, 40.6125|0°|
|C87|1nF|184.2775, 128.7025|70.5115, 49.0200|90.0°|
|R60|1M|183.8460, 131.6745|70.0800, 51.9920|180.0°|
|H1|DZ127S-22-10-55|163.1450, 128.8550|49.3790, 49.1725|0°|

USB2中心(187.3765,121.9205)，距右边界3.790mm，朝向90°；U6在其左侧10.541mm且下偏0.889mm。D5在两者之间(182.4995,122.708)，距USB中心4.940mm、距U6中心5.665mm，网络LINK_DP/DN证实是接口ESD。建议保留“板边USB→ESD→MCU”的次序，依据当前接口外形/壳体突出量与差分路径重排，而非只复制中心间距。

X2位于U6右下，偏移(+4.087,+5.834)mm，中心距7.123mm；C80/C81在晶体两侧，距晶体中心1.642/1.704mm；R54并联反馈位于晶体上方1.821mm。参考振荡网络为晶体1/3及U6.35/.36，其余晶体脚接GND。与当前HPM原理图对应时可作为整体相对布局，但元件值和晶体型号仍以当前BOM为准。

C68/C71/C75位于U6上边(y117.1815)；C69在右上；C70/C72/C74位于下边(y128.36…128.40)；C73/C77在左边(x170.9)，形成围绕QFN供电脚的分布。中心距约5.35…6.17mm，其中封装半宽约3mm；真正去耦有效性取决于电容焊盘到供电脚/地过孔的回路，不能用中心距认定已优化。U7电感在左上(-5.9825,-2.557)mm，参考电源脚DCDC_LP接电感再到LINK_VDD_SOC。

## Q1与电源连接器的新证据

参考Q1在原理图Manufacturer Part明确WSD90P06DN56（C719104），而不是仅从名字猜测。PCB封装为DFN-8_L5.8-W4.9-P1.27-LS6.0-BL-1，已做简化G/D/S重编号：

- pad1：局部(1.9025,2.751)，门极网$1N398404。
- pad2：四个上排焊盘y=-2.751，加中心散热盘约(−0.0025,−0.4445)，中心盘4.6×4.0995mm，代表漏极；其中一个pad2标DCBUS，其余同号pad未显式net。
- pad3：三个下排焊盘y=+2.751，其中一脚标DCBUS_IN，代表源极。

这为当前Q1缺封装提供了“原设计已有GDS123版布局”的新证据，但不是制造商引脚图认证。参考导入pad被标为thru_hole，而且重复编号部分pad未显式赋net，应先检查库模型的孔径、层、焊膏和完整网络映射，不能直接将参考PCB封装搬入当前板或宣称验证通过。后续可由主agent核查该精确参考模型和厂商图，若确定适用再通过正常库/原理图同步流程使用。

参考板CN1不是电源插座，而是5012测试点。实际电源插座为CN3，Manufacturer Part为XT30PW-F、封装也为XT30PW-F（与当前XT30PW-M不同）。其pad1局部(-2.5,-2.5)接DCBUS_IN，pad2局部(+2.5,-2.5)接PGND_IN；原理图脚名只是1/2，没有+/-。故只能证明参考接法沿用了“1正母线、2负回流”，不能证明当前M型实物极性，也不能解除当前符号正负名称矛盾。

## 给当前布局方案的使用边界

1. 先固定实际板框、安装孔、USB/电源/电机端子方向；板尺寸不能自动照搬参考100×55或77.4×53.25。
2. 两套FOC先形成独立高低管/分流/本地母线电容重复单元，再放驱动与自举，最后布置采样链和MCU。采样区域与相节点/门极回路保持可解释的间距及回流路径。
3. HSLink按USB-ESD-HPM-晶体小区放板边，避开两路功率换流区。当前GD32主控晶体/低速晶体为新增设计，不复制参考STM32时钟坐标。
4. 完整原始坐标JSON提供实际相对关系，不是待执行移动清单。当前PCB在IPC可达并读取真实封装/板框后，才可转为目标布局坐标。本文没有改变当前PCB。
5. 未运行参考DRC、未验证参考铺铜连通性/阻抗/温升；大量导入thru_hole类型焊盘与重复pad net缺省需特别核对。参考价值在于分区与既有器件关系，而不是默认正确性。
