CYFS3/GD32FOC/dual_review/双电机设计说明.md

# GD32F505 双电机主框架

本版按用户授权沿用参考器件与母线方案，扩为两路独立三相电机硬件框架。电压、电流、保护阈值未定，不代表额定功率或可投板验证完成。

## 工程结构

- GD32F5_FOC.kicad_sch：入口，总图。
- MCU.kicad_sch：GD32F505、两路PWM/ADC/Hall、共享SPI2、独立片选、刹车接口、复位/SWD和电源。
- power.kicad_sch：公共输入保护、DCBUS、12V/5V及偏置电源部分。
- FOC_M1.kicad_sch：电机1驱动、六MOS桥、相电流/母线电流、电压、温度和位置接口。
- FOC_M2.kicad_sch：电机2独立同类电路，位号较原参考加1000。

五页PDF：dual_motor.pdf。原工程与库备份：../dual_backup/20261026_143556。PCB和项目设置未修改。

## 关键修改

两路相节点、门极、自举和采样网络均以M1_/M2_隔离。R109/R1109是各自母线分流器，两个正端回流网络独立，负端再接公共PGND。未将两路分流器短路或并作同一测量。

M1 PWM使用TIMER0，M2使用TIMER7。M1相电流PA0/1/2，M2相电流PA3/4/5；两组都可使用ADC0/ADC1。温度改至PE7/8 ADC2，霍尔分别使用TIMER2和TIMER3。SPI2总线共享，PE2/PE3为独立片选。正式端口/物理脚/AF列表见../dual_motor_pin_mapping.csv。PB4默认NJTRST，固件须释放JTAG对应功能同时保留SWD。

MCU VDDA/VREFP改接MCU_VDDA，经R203由VCC供电，C206..208去耦；不再直接使用独立AVCC LDO。模拟放大器仍可用AVCC。PCB阶段需确认地回路、滤波及上电压差要求。

保留两路相电压与中性点测量电路供测试，未占用MCU采样脚；此框架优先支持霍尔/编码器电流闭环，不声称已有基于相电压的无感算法。共用母线电压由M1_VBUS采样，M2对应分压保留测试用途。删除原图LM358计算示例和独立24V教学分压电路。

## 刹车接口与边界

J201：1=VCC，2=GND，3=M1_BRKIN，4=M2_BRKIN。R204/R205为10k上拉，分别接PB12 TIMER0_BRKIN(AF4)与PA6 TIMER7_BRKIN(AF4)。设计意图是HIGH有效刹车，外部健康状态电路仅在正常时用开漏拉低，断开则默认高。该默认行为依赖固件正确配置BRKIN极性/使能和输出安全状态；不是不依赖固件初始化的完整驱动器关断系统。

FD6288参考符号无EN脚；新增12个10k下拉使HIN/LIN默认低。上电/复位期间的实际关断行为还需按驱动器数据手册和实测确认。

板上尚未实现按额定电流设置的比较器/锁存故障电路，J201只是已接通的硬件刹车接入口。不能宣称完整过流保护已经完成。外部健康信号及保护阈值待母线和电机参数确定后设计。

## 固件采样要求

ADC0+ADC1是共享同步对，ADC2温度通道独立。两路PWM可独立输出，但必须统一规划两路相电流采样窗口与计算预算，不能直接给同一ADC对安排互相重叠的两路触发。可采用同步载波配合有效采样窗口、或经过验证的错峰时分调度。低侧三分流器在不同占空比下的可测相和重构需单独实现。本次没有生成或测试FOC固件。

## 验证与未完成项

KiCad原生CLI导出成功：430个物理元件、236个网络，没有重复/未标注位号。独立检查52项全部通过：PWM、相电流/母线电流、NTC、Hall、SPI及片选、刹车和上拉、MCU供电滤波、分流器未旁路及两路功率节点隔离。结果verification.json。

ERC仍有430项：152错误、278警告。其中封装链接154、输入未驱动117、悬空连线端点72、引脚类型冲突37、电源未驱动24、栅格14、未连引脚11、库符号差异1。完整dual_motor_erc.json。这些未全部排除，不应直接投板。

功率器件/驱动器供电裕量、母线输入连接器与保护的双路总电流容量、散热、实际MOS封装和额定值需要复核。特别R109/R1109的Value为1mΩ，但来源MPN含5mR，量程与保护阈值必须以最终选定实物阻值为准。原参考CN1极性名称不一致及缺失封装仍需核对。

重新打开工程载入磁盘版本；旧编辑器不要保存覆盖本次更新。旧FOC_pin_mapping.csv和migrated_foc.pdf是之前单电机版本，本版以dual_motor_pin_mapping.csv和dual_review/dual_motor.pdf为准。
