CYFS3/GD32FOC/interface_review/接口与审查结论.md

# 双电机接口扩展与审查结论

> 历史阶段记录：本文中的SPI彩屏J300方案已按用户要求替换为test原项目的16针FPC OLED。最新屏幕接法及图纸见 ../oled_review/屏幕替换说明.md 和 ../oled_review/final.pdf。以下原SPI引脚表不适用于当前工程；编码器、按键与尚未解决的审查事项仍适用。

## 本次范围
保留两路SPI编码器，新增/完善两路单端ABZ兼容输入；新增独立SPI彩屏模块接口与三个板载按键。修改原理图，不修改PCB，不提供已验证固件。

## 编码器
- SPI编码器CN47/CN1047保留：1=3.3V，2=CS，3=SCK，4=MISO，5=MOSI，6=GND，7/8=安装焊盘地。PC10/PC11/PC12共用SPI2，PE2/PE3独立片选。
- CN5/CN1005复用为Hall或ABZ，不能同一路同时接入两种传感器。1=GND，2=C/Z，3=B，4=A，5=原辅助PWM（未接MCU），6=可选传感器电源，7/8=地。
- M1 A/B=PB4/PB5，TIMER2正交解码；Z=PB0 GPIO/EXTI。M2 A/B=PD12/PD13，TIMER3正交解码；Z=PD14 GPIO/EXTI。索引需要固件处理。
- 默认传感器供电3.3V，3.3V侧0Ω装配，5V侧0Ω DNP，严禁两个选择电阻同时装配。
- 使用三路非反相施密特缓冲器SN74LVC3G17DCUR，输出由3.3V供电；100Ω输入串阻。原1k下拉和1nF滤波会破坏3.3V输入高电平，本次下拉改DNP，电容改100pF DNP，10k上拉也默认DNP。默认接3.3V推挽；开漏需要装配上拉并核算线缆/速率。
- **限制：目前未取得可读厂商手册，缓冲器引脚依据KiCad库、封装依据HQ型号与安装库。5V输入阈值、容限、断电状态及确切封装应在投板前查厂商手册复核；不把5V兼容性列为已验证能力。**原5V钳位保留，不能认为实现了电源关闭时的隔离。

## SPI彩屏J300
这是自定义8针2.54mm模块接口，不是对某个屏幕排线的直接适配。连接具体模块前应逐针匹配。

|针脚|功能|MCU|
|---|---|---|
|1|3.3V VCC|系统3.3V，需核算屏幕负载|
|2|GND|公共地|
|3|SCK|PB3/89，SPI0 AF2|
|4|MOSI|PA7/32，SPI0 AF0|
|5|CS_N|PB6/92|
|6|DC|PB7/93|
|7|RST_N|PE4/3|
|8|BL_CTRL|PE5/4，经100Ω；仅背光使能/PWM逻辑输入|

- 独立SPI0，不占编码器SPI2。
- 只写，无MISO，不支持依赖MISO的屏幕读回、SD卡或触摸控制器。
- PB3复用前释放JTAG/Trace；SWD PA13/PA14保留。
- BL_CTRL不能直接接裸LED负载。屏幕应为3.3V逻辑模块，背光驱动由模块或外部电路承担。

## 三个按键
SW300/SW301/SW302→PD2/83、PD3/84、PD4/85，低有效；各10k上拉、100nF去抖、1k开关串阻。与参考项目高有效按键不同，固件必须按低有效处理并进行去抖。

## 已处理的原问题
- R3模拟地连接原标0Ω却带10k采购型号，改为已检索确认的0402WGF0000TCE 0Ω型号，删除错误供应商字段。
- 八只电流采样电阻保留图示1mΩ标称值，清除误指向5mΩ的采购字段。**真实阻值、功率及采购型号仍待电流指标确定，这不是完成了电流额定设计。**
- Hall原1k串阻+1k下拉使3.3V输入降到约1.65V；本次用缓冲器重新调理。

## 尚不能投板的主要项
1. U19显示RY8411，采购字段为JW5026，两者身份冲突未擅自更换。反馈62k/12k对应输出=6.1667×实际基准，必须确认实际IC及手册后才能确认5V。
2. 原工程83处封装编号不完整，包含功率MOSFET、采样电阻、运放、二极管，必须逐一核对实际封装及焊盘映射。
3. CN1符号引脚极性标注与实际正负母线连接相反，应依据实物连接器图纸核对，未直接交换电源网络。
4. 没有已证明可用的板载过流比较器到BRKIN硬件关断路径；目前是外部输入。死区、刹车极性、ADC同步采样、故障锁存都需固件与实测。
5. 系统3.3V还承担HPM调试器、新屏幕与传感器负载，LDO电流与温升未通过功耗预算或实测。
6. 电机最大母线电压、电流、PWM频率、具体编码器与屏幕型号尚未指定，驱动/采样动态性能、再生能量、保护及连接器额定值不能定案。

## 最终验证与交付
- 工程7页、517个物理器件；新增29个器件。
- final_delta.json：排除明确授权变更的Hall输入及九个新增MCU接口引脚后，其余原电路连接集合完全一致。辅助PWM上拉R54/R1054从原0Ω后的5V节点改为直接5V，功能供电保留。
- final_interface_checks.json：屏幕逐针连接、两颗缓冲器引脚、四个串联电阻未被旁路、3.3V默认/5V DNP选择、六路输入选配上拉下拉均通过检查。
- final_text_check.json：新增MCU标签、两路FOC新增区域和Interface页的PDF文字边界交叠为0；这不是全工程人工目视验收。
- final_erc.json：仍有825项，192错误、633警告，未通过ERC，不可宣称可以直接投板。相较改动前769项增加的报告需结合新增输入/电源脚、导入符号电气类型及格点情况阅读，不能只按总数判断功能。
- 完整图纸final.pdf，最终原生网表final.xml。PCB未修改。

原始审查证据见audit_findings.md、audit_netlist.xml、audit_erc.json；这些是改动前快照。源工程test/HPM未修改。
