CYFS3/GD32FOC/oled_review/屏幕替换说明.md

# 使用test原项目OLED电路

本次替换此前自定义8针SPI彩屏排针方案，使用test/2_P1.kicad_sch中标注OLED 1.29的原屏幕电路。

- FPC300：AFC07-S16ECA-00，16针、0.5mm间距、上接触贴片FPC插座；另有17/18安装接地焊盘。
- 保留参考电路电荷泵电容、偏置电阻、RC复位及复位二极管、两路4.7k上拉。
- 供电沿用系统VCC=3.3V；FPC15为OLED_SCL，接GD32 PB6/92（I2C0_SCL AF1）；FPC16为OLED_SDA，接PB7/93（I2C0_SDA AF1）。
- 原SPI彩屏使用的PA7、PB3、PE4、PE5释放为未连接；不再有SPI屏幕背光控制或DC接口。
- 原参考复位电路保留，不另占MCU复位GPIO。
- 三个按键PD2/PD3/PD4与两路编码器电路保持不变。

这是原项目的贴片FPC连接方案，屏幕通过排线插入连接器。未从参考材料确认屏幕控制器具体型号，不能把它泛称为任意16针OLED兼容接口；使用原项目配套屏幕，并核对排线接触面方向。固件需改用I2C，控制器地址和初始化序列以原屏幕资料/固件为准。

## 位号对应
FPC1→FPC300；C56/57/58/59/63/65→C320..325；R27/30/29/31/34→R320..324；D3→D300。

此前interface_review/接口与审查结论.md中SPI彩屏J300及其引脚表已被本说明替代；编码器、按键、待核实器件型号/功率与原工程ERC问题仍适用。本次不更改PCB。

## 验证
参考13个器件的完整引脚连接分组及标称值逐项对比通过；OLED_SCL/SDA连接到PB6/PB7，原SPI专用四个GPIO已恢复未连接；其他器件电气连接保持一致。FPC插座封装与原项目源文件逐字节相同。新OLED与按键区域完成文字与器件图形边界检查，排除连接器内部正常显示的引脚名称后无交叠。最终工程7页、523个物理器件。

原项目0402阻容封装引用名称存在缺失，本次OLED器件改为引用原库中真实存在的0402封装文件；未扩大修改其他电路的封装。完整工程仍有原有ERC及功率设计待确认事项，不表示已经可以直接投板。
