CYFS3/GD32FOC/power_review/电源关系说明.md

# 当前电源关系与C143说明

依据当前工程KiCad原生导出power_review/current.xml。

C143位于FOC_M1页，100nF：pin2接12V，pin1接GND。C1143为第二路对应电容，同样接12V与GND。它们是驱动电源去耦，不是连接两个不同正电源。

当前画法问题：C143上方同一坐标257.81,199.39同时存在#PWR0029和#PWR9057两个12V电源符号；下方257.81,219.71同时存在#PWR0044和#PWR9054两个GND符号。此前转换标签时保留了原电源符号，导致重复叠放。本次删除同坐标同网络的重复符号，不改变电气连接。

电源关系：

|网络|来源|用途|
|---|---|---|
|DCBUS|公共输入保护后母线|两路电机功率桥、12V降压输入|
|12V|U6 LM5164降压级|两路FD6288驱动和5V降压输入|
|5V|U19降压级（Value RY8411）|霍尔接口、两颗3.3V LDO输入|
|VCC|U20 XC6210B332MR，3.3V|GD32数字电源、外设及HSLink供电来源|
|AVCC|U2 LP5907-3.3，独立3.3V LDO|电流采样运放和偏置缓冲|
|MCU_VDDA|VCC经R203 0Ω|GD32 VDDA与VREFP，带局部去耦；不是第三颗稳压器|
|HSL_LINK_3V3|VCC经R8052 0Ω|HPM5301调试器；不是另一独立3.3V电源|
|VREF|AVCC分压并由U12缓冲，设计名义1.65V|双向电流采样的中点偏置，不是GD32 ADC满量程参考|

GND为公共逻辑地；AGND经R3 0Ω连GND；PGND经R134/R136 0Ω连GND。它们不是彼此电气隔离的电源域，实际PCB回流路径仍需设计。

看起来杂乱的另一个原因是命名和页面组织：VCC/AVCC没有直接显示电压数字，MCU页放有两颗3.3V稳压器，而公共电源页放12V/5V降压。不同页面的同名电源符号属于同一网络，并不表示每出现一个符号就新增一路电源。本次仅清理重复符号，不擅自合并AVCC与VCC、AGND与GND等有明确连接器件的网络。
