CYFS3/GD32FOC/review/引脚与双电机审查.md

# GD32F505 引脚与双电机审查

依据用户上传 GD32F505xx Datasheet Rev0.9RC5、GD32F50x 用户手册Rev1.4、芯片使用限制Rev1.1。重新用KiCad CLI导出当前磁盘原理图review/current.net.xml；23路既有接口网表检查全部通过。本次仅审查，未改原理图。

## 当前单路引脚

数据手册LQFP100引脚表及第54–55页AF表与FOC_pin_mapping.csv一致。

|用途|端口|功能/配置|
|---|---|---|
|三相高侧|PA8/PA9/PA10|TIMER0_CH0/1/2，AF1|
|三相低侧|PB13/PB14/PB15|TIMER0_CH0/1/2_ON，AF2/AF2/AF1|
|相电流|PC0/PC1/PC2|ADC012_IN10/11/12|
|母线电流|PC3|ADC012_IN13|
|母线电压/中性点|PC4/PC5|ADC01_IN14/15|
|相电压/温度|PA0/PA1/PA2/PA3|ADC012_IN0/1/2/3|
|霍尔|PC6/PC7/PC8|TIMER2_CH0/1/2，AF0；标注5VT|
|SPI接口|PA4/PA5/PA6/PA7|SPI0 NSS/SCK/MISO/MOSI，AF0；CS可GPIO|
|调试|PA13/PA14|SWDIO/SWCLK|

ADC012表示某物理引脚可供ADC0/1/2选用，不代表三ADC自动同步。SPI1_*仅为原参考网名，软件必须使用实际SPI0。

## 需要补强

1. 数据手册第71页注3要求VDD与VDDA在上电和运行期间压差不超过300mV，建议同源。现U1 VDD接VCC、VDDA/VREFP接AVCC，两路独立LDO不能仅凭都是3.3V就判定满足。应改成同一3.3V源加适当模拟滤波，或验证/保证时序及压差。VREFP目前接AVCC而不是1.65V偏置VREF，这点正确；第101页要求VREFP不高于VDDA。
2. 当前PB12(pin51)、PE15(pin46)未连接，PA6占用SPI MISO，未形成已接通的TIMER0 BRKIN硬件过流关断路径。建议预留PB12 AF4或PE15 AF0并设计比较器/故障信号；依据第55–56页AF表。应核对故障有效电平、复位状态和驱动器接口。
3. 5VT霍尔数字输入不代表ADC可输入5V；模拟输入范围仍按VREFP/VDDA限定。当前分压、钳位与实际母线瞬态需另行电气验证。
4. 本次确认引脚功能和当前网表，不消除之前ERC的365项发现，也未验证驱动器阈值、全部封装、功率容量或动态控制。

## 双电机结论

GD32F505的外设有实现双三相FOC的基础；当前原理图只有U7 FD6288Q、一组Q5–Q10六管桥及CN41三相输出，不能独立驱动两台三相电机。

用户手册第264页说明TIMER0/7相互独立且支持中心对齐、死区和BREAK；第288页说明互补输出死区控制。因此可用TIMER0控制电机1、TIMER7控制电机2。需要增设第二个三相驱动、六MOS、采样放大/分流器、保护与电机接口，并校核共享母线、电源、散热和布线容量。

常见TIMER7选脚PC6/7/8高侧(AF3/AF3/AF2)、PC0/1/2低侧(AF0)会同时冲突现有霍尔和相电流输入，不能原样复制。数据手册另有PA11/PA12/PB4高侧与PA7/PB0/PB1等低侧替代，但PA7目前占用SPI0 MOSI，也需重新安排。完整双路引脚表应在第二路采样与位置传感器方案确定后设计。

用户手册第544、546页明确的同步ADC组是ADC0+ADC1，不应宣称有两套独立同步ADC对或三ADC同步。TRIGSEL第239–243页支持TIMER0和TIMER7事件分别路由至ADC触发；第533页插入序列最多4通道。双电机可规划错峰PWM/采样、共享同步对或独立ADC顺序采样，必须预算采样时间、触发冲突、运放建立时间及两路控制计算量。没有固件负载测量，不能保证任意PWM频率下双FOC性能。

芯片使用限制Rev1.1第5页列出适用修订A，已列I2C、CAN和Core限制，没有ADC/TIMER相关条目；这不等于保证所有工况无问题。

建议保留单MCU、改双功率级架构；在确定母线电压、两台电机连续/峰值相电流、霍尔或编码器/无感需求后完成双路引脚、采样与保护规划。
