CYFS3/GD32FOC/interface_review/oled_baseline/FOC_移植说明.md

# GD32F505 FOC 主框架移植记录

已将 test/1_P2.kicad_sch 电路移入本工程 power.kicad_sch，根图显示名称改为 FOC。保留 MCU U1 GD32F505VxTx，现为三页工程：根图、MCU、FOC。PCB 未修改。

## 已完成

- 移植输入保护、DCBUS→12V→5V、电机三相驱动/逆变、相电流与母线电流、相电压与母线电压/中性点/温度采样、霍尔和 SPI 接口。
- 从参考 P1 移入 VCC/AVCC 两路3.3V稳压及支持元件，原参考U1改为U20，保留AGND/GND的R3桥接。
- 为MCU添加去耦、复位、启动配置、SWD接口与信号连接。
- 将跨页接口改为全局标签，修复原参考图局部标签不能跨页连通的问题。
- 将10个未实际导通的Short-Symbol替换为连线：三相VS回路、三个霍尔信号、三个相电流分流器回流及母线分流器接地。R109两端保持不同网络，没有短接分流器。
- 复制参考符号库和封装缓存，建立项目库表并补存MCU符号。

## 引脚依据

FOC_pin_mapping.csv列出23路主要接口及SWD。依据本机GD32EB官方资源：

`C:\Users\RTT\Desktop\GD32\Tools\GD32EB_v1.5.8_Rel\GD32EB\plugins\com.gigadevice.resources_1.0.0.202603121632\DataSheet\GD32F50x\GD32F505\F505VxT7.xml`

同一插件下 `AFIO\GD32F50x\GD32F505.xml` 提供复用选择。PA8/9/10用AF1，PB13/14用AF2，而PB15用AF1。参考图保留的SPI1_*信号实际映射GD32 SPI0（PA4～PA7，AF0）。PC6～PC8支持TIMER2 AF0，也为5V容忍数字引脚。电机控制固件仍需设置死区、PWM极性、ADC触发和故障处理。

## 验证结果

KiCad 10.0.6原生CLI成功解析并导出三页PDF与XML网表。最终网表274个元件、182个网络，无重复或未标注位号。独立脚本验证23路MCU接口全部与预期FOC网络连通；核对U1供电、U10/U12模拟电源及R109两端网络。

ERC未通过：158项error、207项warning，共365项。包括105项封装链接、75项输入未驱动、65项引脚未连接、41项连线端点、21项引脚类型冲突、18项电源未驱动、14项栅格、14项局部/全局同名、8项网络多名称、2项库符号差异，以及U11缺失单元/输入各1项。不能把接口网表通过等同于整板电气验证通过。

## 仍需处理

- 参考图多处封装字段为空或指向不存在的缓存，MCU原有GD32F505xx封装库也缺失；没有猜测替换功率器件封装。
- 参考图部分器件Value与符号来源型号不同，如U10和功率MOS，需按实际采购型号核实引脚、封装和参数。
- CN1源符号的正负引脚名称与连接电源方向不一致，需核对真实连接器引脚定义。
- 保留参考图U11及R/Rf计算示例和R110的独立24V分压示例；这些不是已完成的功能电路，不能据此生成最终BOM。U11尚有未放置单元。
- 仍需处理ERC遗留项、检查功率/电流范围和保护策略，再进行PCB设计。

## 文件与重新打开

工程入口为GD32F5_FOC.kicad_pro / GD32F5_FOC.kicad_sch；FOC主电路文件为power.kicad_sch。查看migrated_foc.pdf可直接检查输出。

修改前文件备份：migration_backup/20261026_141246。修改发生在磁盘，未声称当前已打开编辑器自动刷新。重新打开工程载入磁盘版本；如旧编辑器提示保存，避免用旧内存内容覆盖本次结果，确有未保存个人修改时先另存副本。
