CYFS3/GD32FOC/GD32F505_修复记录.md

# GD32F505 原理图修复记录

> 后续布局准备更新：已修复17组隐藏#PWR重复，CLI批注提示消失；Q1已采用用户提供FOC工程的同型号参考封装并修正SMD焊盘属性，封装链接告警降至0。原生ERC现为352条（1错误、351警告）。用户已F8导入532个PCB封装，开始初版布局。下文保留此前修复阶段记录；最新变更证据见`.layout-review/annotation-fixes.md`和`.layout-review/q1-reference-footprint.md`。

本轮按用户要求修复前次核对发现的确定问题。用户已明确选择保留J201外接过流保护，不增加板上比较器。未修改PCB或固件，未改变HSLink和编码器的DNP装配选项，未屏蔽ERC规则。

## 已完成的电路修复

- 新增C212=100nF，明确给U1.6 VBAT近端去耦。
- C206/C208改为10nF，新增C213=1µF，连同C207=1µF，明确VDDA22和VREFP21各1µF+10nF近端去耦。MCU_VDDA仍经R203从VCC供电，未并联两个LDO。
- 新增TP200（1.5mm测试焊盘）连接NRST。J200保持原四针定义，外部调试器可额外接TP200执行复位下连接。
- 保留已接的8MHz Y200和12pF初值C210/C211；调整与晶振区重叠的说明文字。
- U2/U20 NC、U7/U1007 NC、U6未用PG、USB未用SBU增加明确未连接标记。
- 删除8条经连接检查确认无功能的悬空支路；不删除有效走线。

## 符号与供电建模

导入符号中的阻容、二极管、测试点、连接器等错误Input类型已修正为passive；有明确资料依据的IC输入、输出、供电脚按实际功能修正。U2源库与图内缓存引脚坐标不一致，已保留图内坐标并同步源库，避免更新库导致断线。

M1/M2的MA/MB/MC和VA/VB/VC共12个信号网络由电源符号改为等名全局标签，保留所有器件连接。供电经电感、0Ω或保护器件后被ERC判未驱动的节点，只有确认实际供电来源后才增加局部PWR_FLAG。这些标记不增加实体器件，不代表新增电源电路。

## 封装链接

修复中文转义引用和空封装名；按明确尺寸资料补标准0402/0603/1206/2512封装。部分标准阻容封装属于本轮明确分配的新设计选择，不声称与旧导入焊盘完全相同，更新PCB后应检查焊盘及布局。

U1使用HQ精确GD32F505VGT6对应LQFP100模型；U6使用LM5164DDAR对应带散热焊盘模型；5012测试点使用官方KiCad涵盖5010–5014的专用模型。12只NCE7560K已核对符号1G/2D/3S与模型一致。

LED原符号1A/2K，与标准封装1K/2A相反；新增Interface:LED_0603_1608Metric_A1K2保持标准几何、仅调整焊盘编号，避免直接套标准模型造成极性反接。

## 使用和仍需验证

- 重新打开工程加载磁盘文件，避免编辑器旧内容覆盖本轮修改。当前HQ编辑器曾返回未包含上轮Y200的旧状态，因此最终验证以保存文件的KiCad原生导出为准。
- 本轮未同步PCB。新增电容、NRST测试点、晶振及更新封装必须更新到PCB；焊盘编号、板边/间距、去耦靠近引脚和晶振环路需布局复核。
- BRKIN保留外接保护方案，J201需由实际外部保护源驱动，固件配置BRKEN、BRKP及安全关闭状态。
- 板载HSLink连接桥仍DNP，需要使用时装配。未直接闭合桥，避免板载与外部调试器同时驱动。
- ADC跨3.3V供电支路的启动时序/瞬态、晶振负载和驱动功率属于实板测试项，本轮不能用原理图ERC替代。
- 功率采样电阻的额定功率、持续/峰值电流、母线裕量仍需结合整机参数确定；2512封装不等于已经验证功耗。

## 尚未自动消除的核对项

- CN1电源连接器：符号pin1名“−”但连接DCBUS_IN，pin2名“+”但连接PGND_IN。现有封装文字和能读取的厂商资料不足以证明实际焊盘极性；不能据此直接交换电源线。此项须对照XT30PW-M实物/机械图确定，是符号命名错误还是连接错误，确认前不应直接上电。
- Q1 WSD90P06DN56：当前简化G/D/S符号与8焊盘DFN的映射尚未从可读取资料确证，保留缺失封装问题，未套用另一个N沟道器件模型。已获取厂商PDF，但引脚图未能读取。
- 导入图形的离网格警告没有批量吸附。批量移动可能使已连通引脚断开；本轮以保持有效网络为约束，几何整理需在可视编辑器内复核后完成。

## 最终验证结果

KiCad 10.0.6原生全工程ERC由895条（201错误、694警告）降至353条（1错误、352警告），本轮减少542条。未屏蔽检查规则。

|剩余类型|数量|说明|
|---|---:|---|
|电源未驱动（error）|1|HSL_VDD_SOC经HPM5301 DCDC_LP和电感产生；缺少足够厂商证据确认特殊引脚建模，未凭猜测改power_out或加flag|
|引脚/线端离网格|346|保留已有连接，未批量移动图形|
|引脚类型连接|3|HPM5301 DCDC_LP、VDD_OTPCAP、VDD_PMCCAP特殊引脚需厂商资料进一步核对|
|孤立标签|2|HSL_ISP_TX、HSL_ISP_RX预留网络|
|封装链接|1|Q1 WSD90P06DN56尚缺已核实的对应模型|

全工程原生网表对比通过：忽略本轮预期新增的C212/C213/TP200后，所有原有实体引脚的网络分组完全一致，既无丢失也无新增误连接。两个匿名BST网络增加可读名称，拓扑未变。最终证据在`.review-fixes/final-validation.json`和`.review-fixes/erc-final.json`。

CLI导出仍提示原理图批注错误，但实际导出网表无重复实体位号或问号位号；该提示不能被当作已解决，需在编辑器中复核。当前环境无法视觉审阅SVG/机械图，因此本轮未宣称整图已通过可视或投板审核。

## 后续低速晶振补充

按用户后续要求补充32.768kHz LXTAL。具体器件、负载电容、U1.8/U1.9连接及验证结果以 `GD32F505_低速晶振补充记录.md` 为准。该修改不增加备份电池，VBAT仍连接VCC，主电源断电后的RTC持续计时需要另行设计备份供电。

## 备份与可追溯记录

修改前文件和每阶段验证输出在`.review-fixes/`。详细记录分别为`mcu-fixes.md`、`erc-fixes.md`、`footprint-fixes.md`。前次核对报告保留为修复前审查记录，本文件和最终验证结果描述修复后状态。
