CYFS3/GD32FOC/hslink_review/HSLink集成说明.md

# HPM5301 板载HSLink硬件集成

依据C:\Users\RTT\Desktop\GD32\HPM的DAP与POWER页移植。当前是参考HPM5301调试器的板载硬件集成，未找到参考固件，不能确认某现成HSLink固件的引脚配置、SWD支持或上电行为；本次未烧录/运行固件。

## 新增电路

HSLink.kicad_sch新增HPM5301IEG1(U8006)、24MHz晶振、USB-C/ESD/CC、BOOT按键、本地核电源及TPS563201三点三伏供电。保留参考GPIO双路径：PB11与PA27同网，PA26与PB10同网，PA29经22Ω连PA28。

USB供电经参考CH213K至HSL_5V，再至调试器3.3V电源。HSL_5V/HSL_3V3域不与目标电机板5V/VCC直接连接，地共用。没有隔离器，不能称为电气隔离调试器。CH213K反向阻断特性未独立验证，不过本版没有将其输出与电机板5V并接。

原GD32的SWDIO(PA13/72)、SWCLK(PA14/76)、NRST(14)分别连接；UART使用空闲USART1 PD5/86(TX)、PD6/87(RX)，AF0。与当前双电机分配无冲突。

## 五个隔离连接位

|位号|连接|默认装配|
|---|---|---|
|R8901|参考TMS路径至GD32 SWDIO|DNP 0Ω|
|R8902|参考TCK路径至GD32 SWCLK|DNP 0Ω|
|R8903|参考SRST路径至GD32 NRST|DNP 0Ω|
|R8904|GD32 TX至HPM PA09 RX|DNP 0Ω|
|R8905|HPM PA08 TX至GD32 RX|DNP 0Ω|

默认DNP是明确的物理断开：不装这五个电阻时板载调试器不能调试/串口连接目标。装上相应0Ω后方可使用。使用时应确保调试器和目标均正常供电；在目标未上电或使用外部J200探针时断开相应连接，避免信号反灌和驱动冲突。22Ω串阻不是电源隔离措施。固件高阻行为没有被验证，不应把它当作唯一防护。

原外部J200保持。H8001为参考JTAG接口，pin1接目标VCC作被动参考，不是目标供电输出或已实现的ADC电压检测；pin10仍为TRST，不是NRST。不要同时接多个驱动同一调试线的探针。

HPM首次固件下载需根据HPM5301官方ROM启动方式及匹配固件进行。参考BOOT按键与ISP信号保留，但没有验证下载步骤或提供固件。SWD能力需要固件配合，不能仅因TMS/TCK硬件存在就视为已验证。

## 样式与库

延续电源用符号、信号标签尽量直贴连接点的要求。HPM符号库与封装缓存复制到项目目录，位号使用8000段避免冲突，HSLink页通过根图加入工程。

## 验证

原430个实体器件的数值、封装、相互引脚连接集合保持一致。最终503个实体器件（增加68个源元件和5个连接电阻）。新增接口验证通过，包含USB差分线、稳压反馈/使能、五路连接两端和电源域不混接；移植68个元件的原参考拓扑保持一致，只有H8001.1按设计改为目标电压参考。

验证文件：preservation_verification.json、reference_verification.json、interface_verification.json。图纸GD32F5_FOC_HSLink.pdf。完整ERC见erc.rpt，仍有大量来源电路/封装问题，未宣称ERC通过。

## 待核对

- 实际HSLink固件型号、引脚配置和SWD双向切换；HPM5301首次烧录。
- 新USB连接器导入封装名字含6PIN但实际14种焊盘编号；焊盘被源文件声明为通孔，需按实物核对，不能据此直接生产。
- 其他源封装、空Value、引脚电气类型与原双电机ERC问题仍需处理。
- 母线电压、电流额定值和双电机保护阈值仍待定，与本次调试器集成无关。

本次原工程备份hslink_backup_20261026_155454；PCB未更改。重新打开工程加载磁盘新版，避免旧编辑器覆盖。
