CYFS3/GD32FOC/label_wire_audit/检查说明.md

# 标签导线延伸检查

针对C130及其他页面同类问题，检查全部原理图的水平信号标签锚点、文字朝向和导线范围。修改前共发现68处候选：两路FOC各30处、HSLink7处、公共电源1处，MCU页无此类候选。

C130/C131/C132及第二路对应电容：左侧标签原来朝向电容且锚点在线段中间，调整至左端并朝外；右侧同一导线上重复放两个同名标签，删除重复标注，保留靠近电容的标签，将无分支的尾段截到标签锚点。之前U7/U1007已修正的导线保持。

对其他无分支尾段，在确认没有交叉线、接点、其他信号标签或器件引脚后截短。对真实连接器件的导线保留连接，通过调整标签锚点和朝向改善画法。

修改前文件备份baseline/。完整原生导出GD32F5_FOC.pdf，电气一致性结果verification.json。全部488个物理元件的值、封装和完整引脚连接集合与修改前一致。本次为绘图样式修正，不代表此前ERC或功率电路设计待定项已解决。
