CYFS3/GD32FOC/c130_recheck/focus_3.pdf

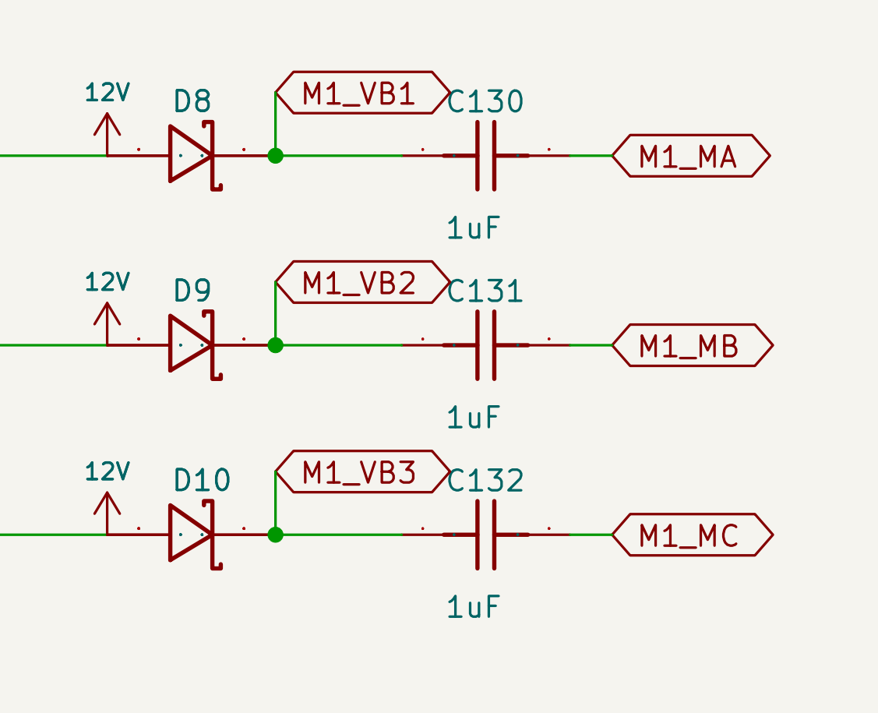
[picture p1: figure]
VCC; M1_LIN1; M1_LIN2; M1_SHUNT_RETURN

M1_HO3 M1_VB3 M1_MA M1_VB2 M1_VB1 M1_HO1 | M1_MC M1_MB M1_MA M1_HIN1 M1_HIN2 M1_HIN3 | M1_VB3 M1_VB2

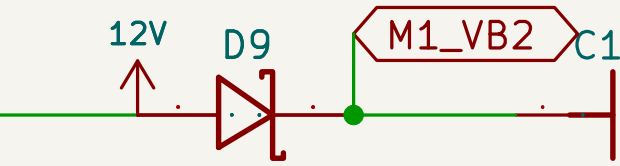
[picture p2: figure]
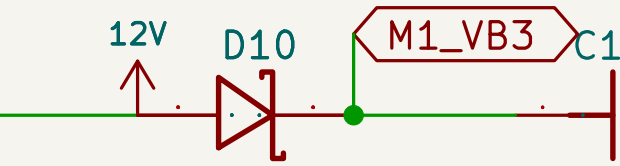
[picture p3: figure]
