CYFS3/GD32FOC/c130_recheck/focus_4.pdf

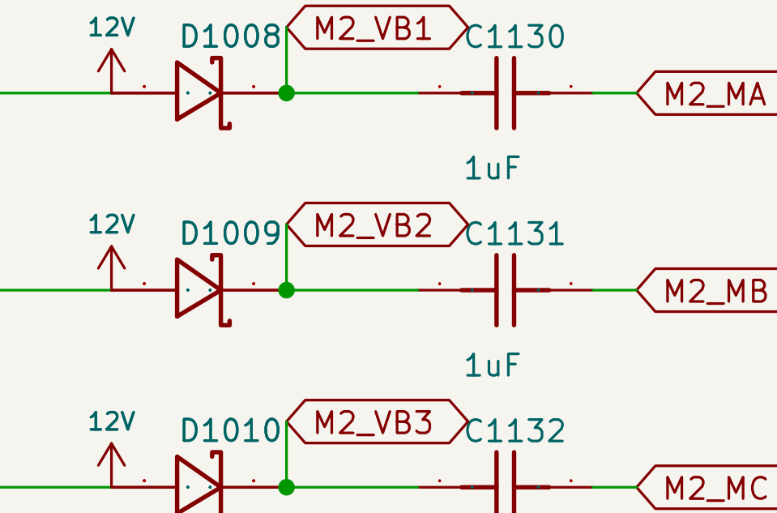
[picture p4: figure]
D1008 ¹²V; M2_MC M2_MB M2_MA M2_LIN2
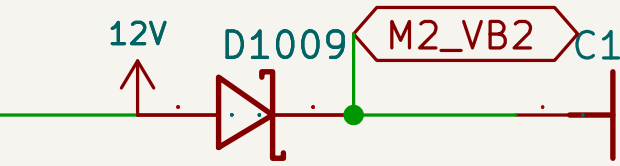
[picture p5: figure]
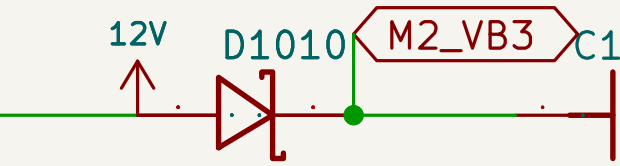
[picture p6: figure]

1uF

M2_VB3 M2_MA M2_VB1 M2_HIN2 M2_HIN1 M2_HO1 M2_MB M2_HO3 M2_HIN3 M2_HO2 M2_VB2 M2_VB3
