CYFS3/GD32FOC/.review-gd32/ABM3B-page2.png

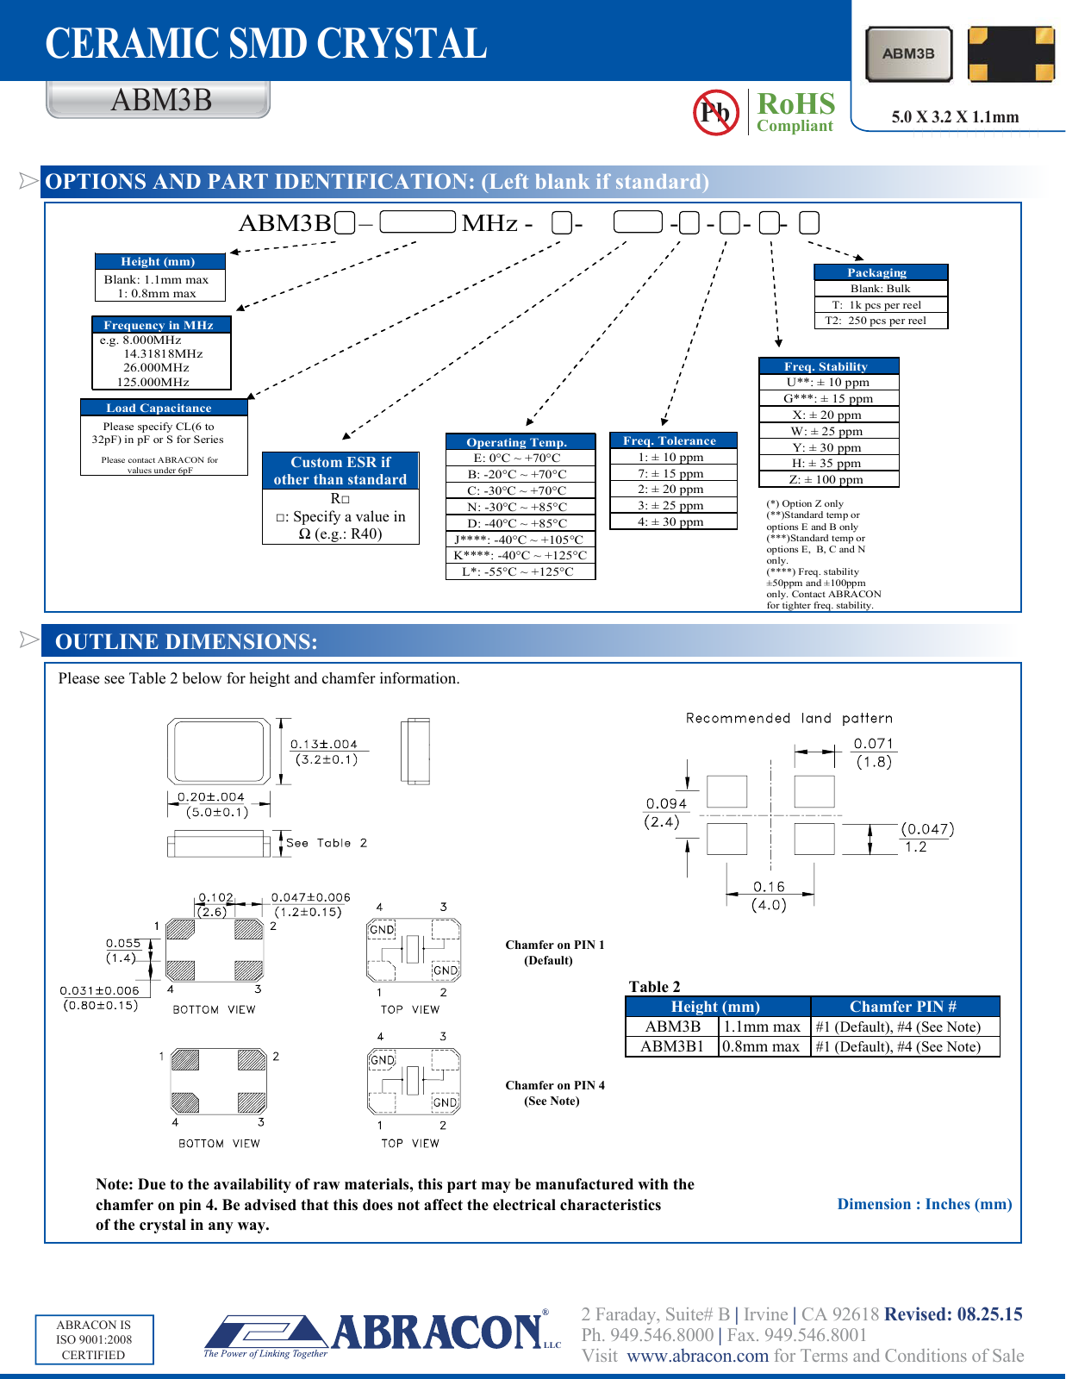
.review-gd32/ABM3B-page2.png
