CYFS3/GD32FOC/interface_review/interface_stage_page2.png

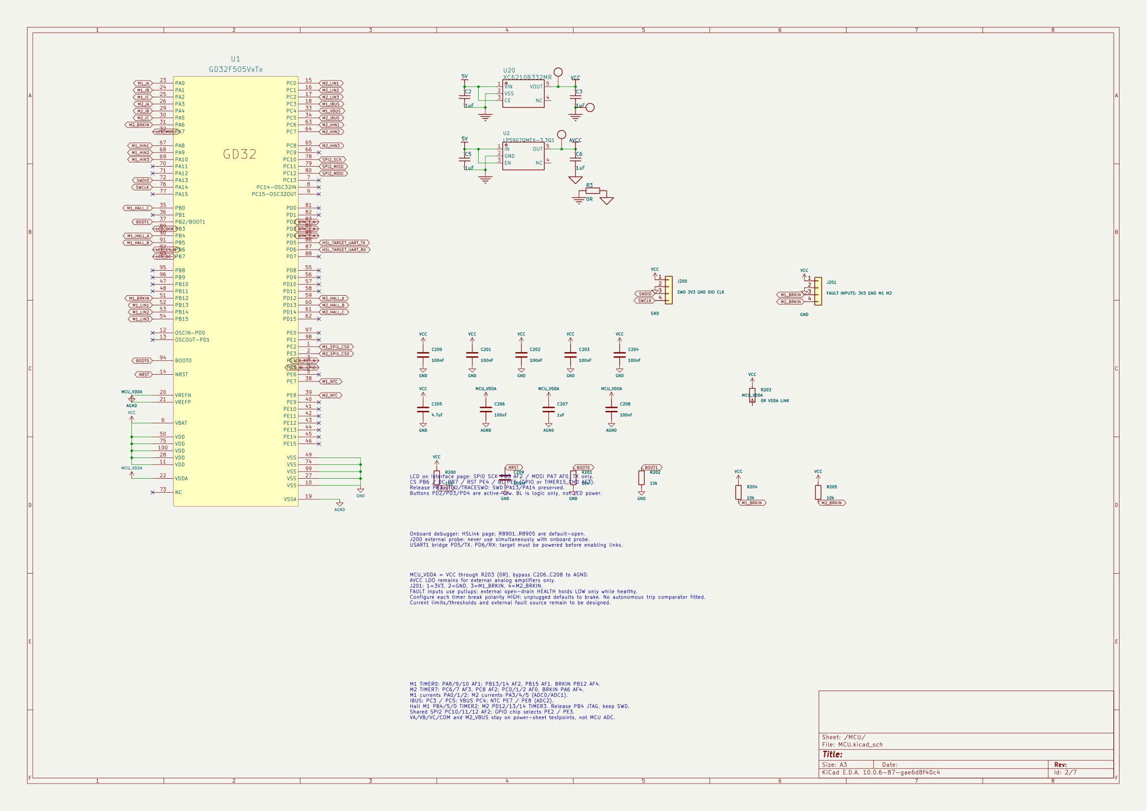
interface_review/interface_stage_page2.png
