CYFS3/GD32FOC/style_review/mcu_before.png

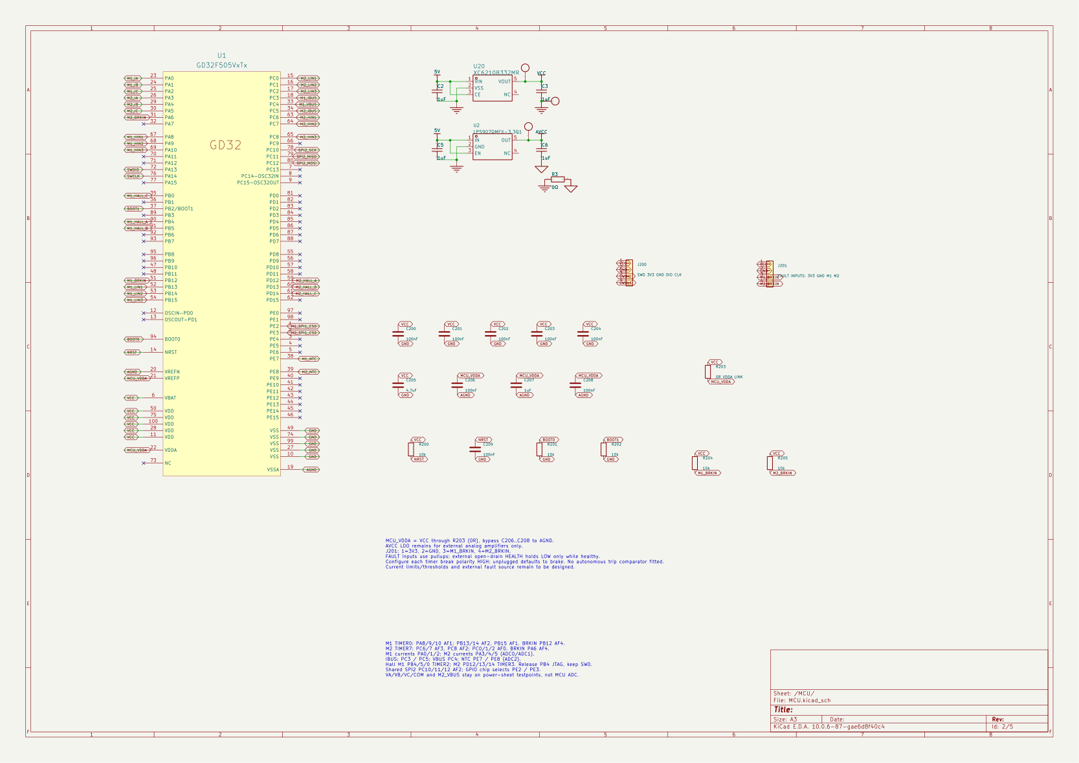
style_review/mcu_before.png
