CYFS3/GD32FOC/style_review/page_1.png

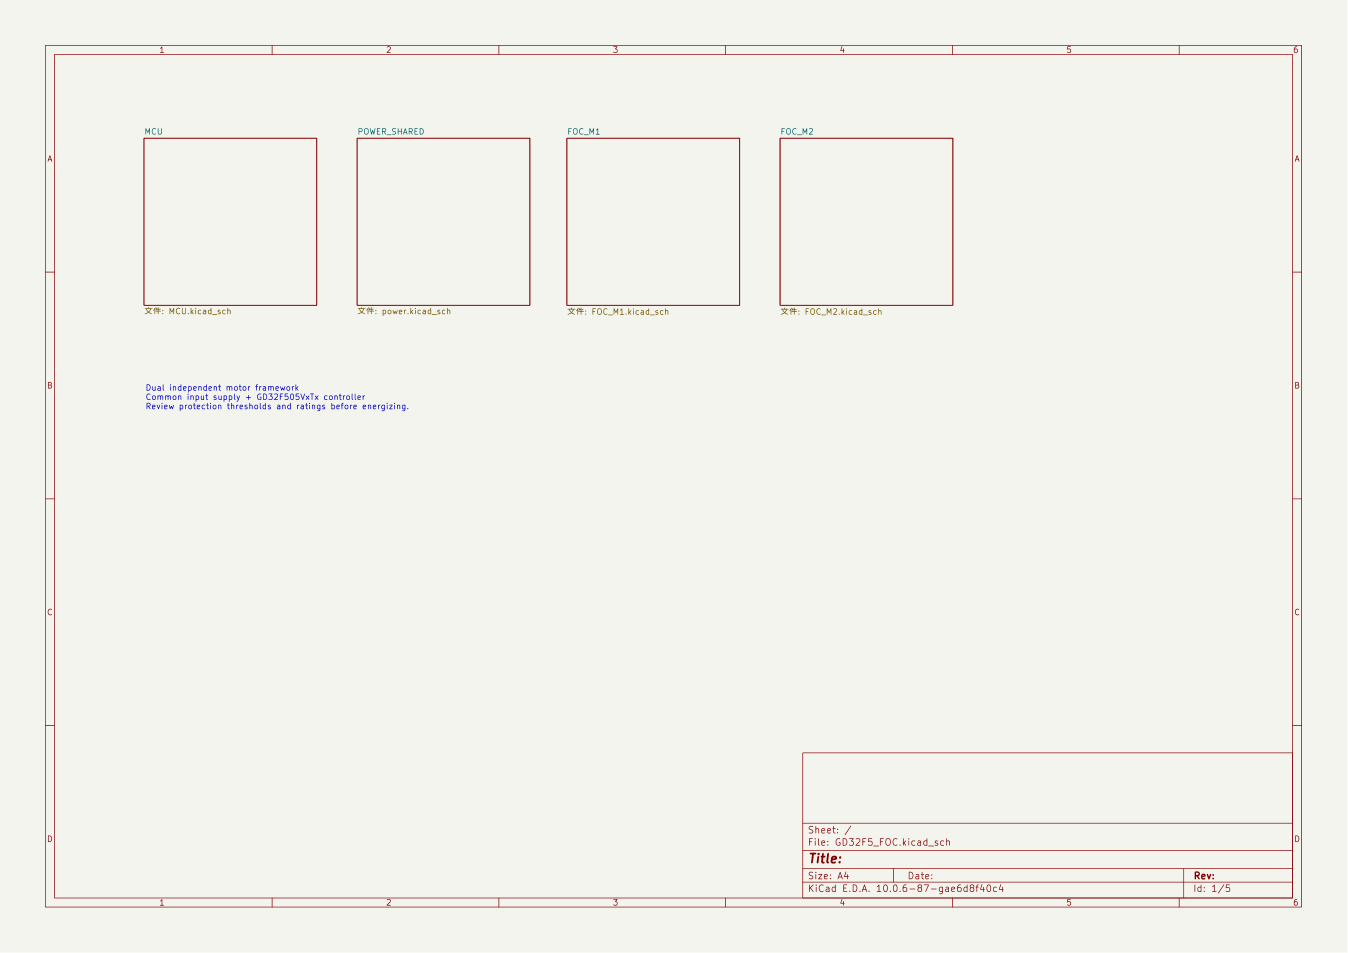
style_review/page_1.png
