CYFS3/GD32FOC/style_review/page_3.png

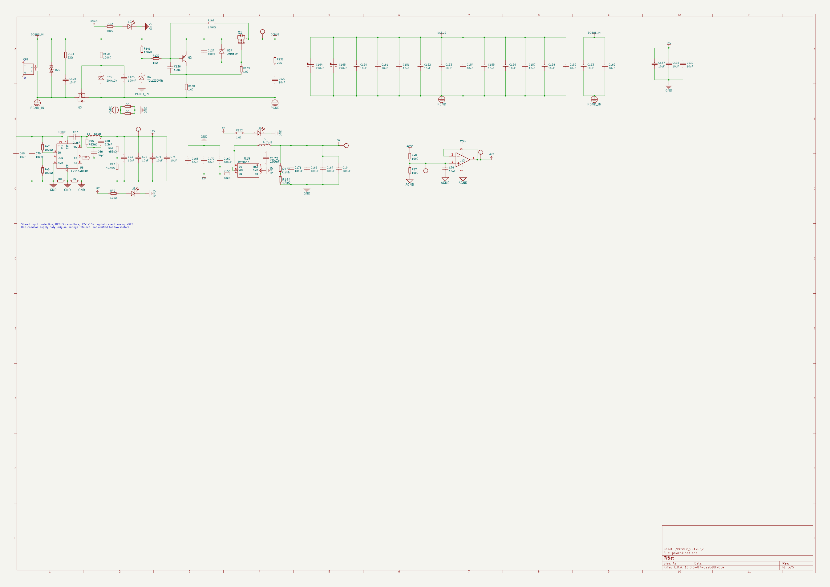
style_review/page_3.png
