CYFS3/GD32FOC/style_review/page_4.png

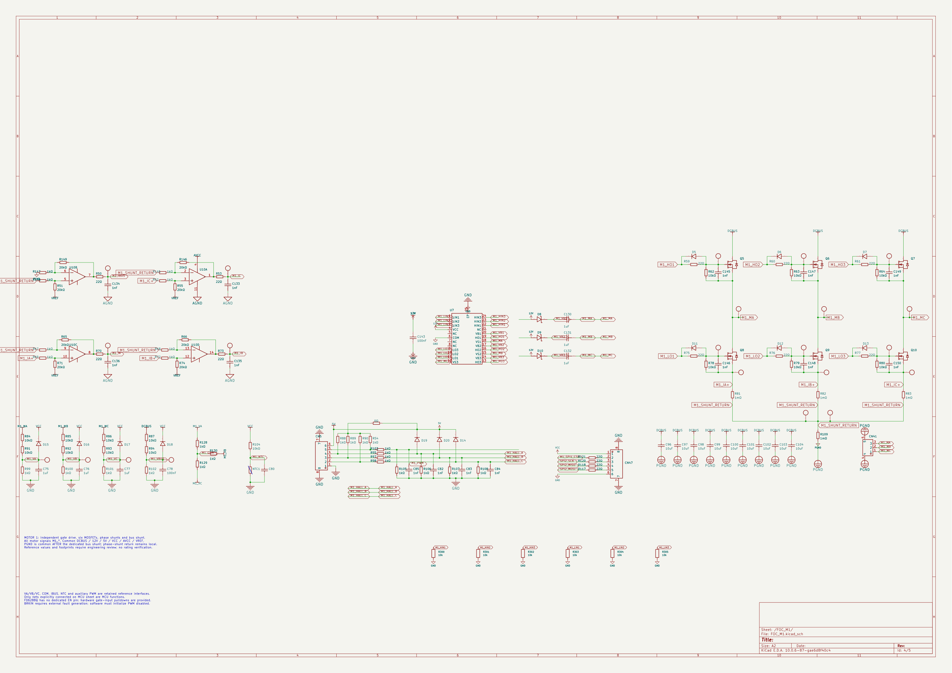
style_review/page_4.png
