CYFS3/GD32FOC/.layout-review/current-placement-inventory.txt

C2 | 1uF | ProDoc_Board1v1_2026-10-26-import-fps:C0402 | /MCU/ | [('2', '5V'), ('1', 'GND')]
C3 | 1uF | ProDoc_Board1v1_2026-10-26-import-fps:C0402 | /MCU/ | [('1', 'GND'), ('2', 'VCC')]
C5 | 1uF | ProDoc_Board1v1_2026-10-26-import-fps:C0402 | /MCU/ | [('2', '5V'), ('1', 'GND')]
C6 | 1uF | ProDoc_Board1v1_2026-10-26-import-fps:C0402 | /MCU/ | [('1', 'AGND'), ('2', 'AVCC')]
C200 | 100nF | Capacitor_SMD:C_0603_1608Metric | /MCU/ | [('2', 'GND'), ('1', 'VCC')]
C201 | 100nF | Capacitor_SMD:C_0603_1608Metric | /MCU/ | [('2', 'GND'), ('1', 'VCC')]
C202 | 100nF | Capacitor_SMD:C_0603_1608Metric | /MCU/ | [('2', 'GND'), ('1', 'VCC')]
C203 | 100nF | Capacitor_SMD:C_0603_1608Metric | /MCU/ | [('2', 'GND'), ('1', 'VCC')]
C204 | 100nF | Capacitor_SMD:C_0603_1608Metric | /MCU/ | [('2', 'GND'), ('1', 'VCC')]
C205 | 4.7uF | Capacitor_SMD:C_0603_1608Metric | /MCU/ | [('2', 'GND'), ('1', 'VCC')]
C206 | 10nF | Capacitor_SMD:C_0603_1608Metric | /MCU/ | [('2', 'AGND'), ('1', 'MCU_VDDA')]
C207 | 1uF | Capacitor_SMD:C_0603_1608Metric | /MCU/ | [('2', 'AGND'), ('1', 'MCU_VDDA')]
C208 | 10nF | Capacitor_SMD:C_0603_1608Metric | /MCU/ | [('2', 'AGND'), ('1', 'MCU_VDDA')]
C209 | 100nF | Capacitor_SMD:C_0603_1608Metric | /MCU/ | [('2', 'GND'), ('1', 'NRST')]
C210 | 12pF C0G | Capacitor_SMD:C_0603_1608Metric | /MCU/ | [('1', '/MCU/HXTAL_IN'), ('2', 'GND')]
C211 | 12pF C0G | Capacitor_SMD:C_0603_1608Metric | /MCU/ | [('1', '/MCU/HXTAL_OUT'), ('2', 'GND')]
C212 | 100nF | Capacitor_SMD:C_0603_1608Metric | /MCU/ | [('2', 'GND'), ('1', 'VCC')]
C213 | 1uF | Capacitor_SMD:C_0603_1608Metric | /MCU/ | [('2', 'AGND'), ('1', 'MCU_VDDA')]
C214 | 12pF C0G | Capacitor_SMD:C_0603_1608Metric | /MCU/ | [('1', '/MCU/LXTAL_IN'), ('2', 'GND')]
C215 | 12pF C0G | Capacitor_SMD:C_0603_1608Metric | /MCU/ | [('1', '/MCU/LXTAL_OUT'), ('2', 'GND')]
CN2 | 5012 | ProDoc_Board1v1_2026-10-26-import-fps:测试点 | /MCU/ | [('1', 'VCC')]
CN3 | 5012 | ProDoc_Board1v1_2026-10-26-import-fps:测试点 | /MCU/ | [('1', 'GND')]
CN6 | 5012 | ProDoc_Board1v1_2026-10-26-import-fps:测试点 | /MCU/ | [('1', 'AVCC')]
J200 | SWD 3V3 GND DIO CLK | Connector_PinHeader_2.54mm:PinHeader_1x04_P2.54mm_Vertical | /MCU/ | [('2', 'GND'), ('4', 'SWCLK'), ('3', 'SWDIO'), ('1', 'VCC')]
J201 | FAULT INPUTS: 3V3 GND M1 M2 | Connector_PinHeader_2.54mm:PinHeader_1x04_P2.54mm_Vertical | /MCU/ | [('2', 'GND'), ('3', 'M1_BRKIN'), ('4', 'M2_BRKIN'), ('1', 'VCC')]
R3 | 0R | ProDoc_Board1v1_2026-10-26-import-fps:R0402 | /MCU/ | [('1', 'AGND'), ('2', 'GND')]
R200 | 10k | Resistor_SMD:R_0603_1608Metric | /MCU/ | [('2', 'NRST'), ('1', 'VCC')]
R201 | 10k | Resistor_SMD:R_0603_1608Metric | /MCU/ | [('1', 'BOOT0'), ('2', 'GND')]
R202 | 10k | Resistor_SMD:R_0603_1608Metric | /MCU/ | [('1', 'BOOT1'), ('2', 'GND')]
R203 | 0R VDDA LINK | Resistor_SMD:R_0603_1608Metric | /MCU/ | [('2', 'MCU_VDDA'), ('1', 'VCC')]
R204 | 10k | Resistor_SMD:R_0603_1608Metric | /MCU/ | [('2', 'M1_BRKIN'), ('1', 'VCC')]
R205 | 10k | Resistor_SMD:R_0603_1608Metric | /MCU/ | [('2', 'M2_BRKIN'), ('1', 'VCC')]
TP200 | NRST | TestPoint:TestPoint_Pad_D1.5mm | /MCU/ | [('1', 'NRST')]
U1 | GD32F505VxTx | GD32F505xx:LQFP100_14x14x1.6 | /MCU/ | [('12', '/MCU/HXTAL_IN'), ('13', '/MCU/HXTAL_OUT'), ('8', '/MCU/LXTAL_IN'), ('9', '/MCU/LXTAL_OUT'), ('19', 'AGND'), ('20', 'AGND'), ('94', 'BOOT0'), ('37', 'BOOT1'), ('83', 'BTN_1_N'), ('84', 'BTN_2_N'), ('85', 'BTN_3_N'), ('10', 'GND'), ('27', 'GND'), ('49', 'GND'), ('74', 'GND'), ('99', 'GND'), ('87', 'HSL_TARGET_UART_RX'), ('86', 'HSL_TARGET_UART_TX'), ('51', 'M1_BRKIN'), ('90', 'M1_HALL_A'), ('91', 'M1_HALL_B'), ('35', 'M1_HALL_C'), ('67', 'M1_HIN1'), ('68', 'M1_HIN2'), ('69', 'M1_HIN3'), ('23', 'M1_IA'), ('24', 'M1_IB'), ('18', 'M1_IBUS'), ('25', 'M1_IC'), ('52', 'M1_LIN1'), ('53', 'M1_LIN2'), ('54', 'M1_LIN3'), ('38', 'M1_NTC'), ('1', 'M1_SPI1_CS0'), ('33', 'M1_VBUS'), ('31', 'M2_BRKIN'), ('59', 'M2_HALL_A'), ('60', 'M2_HALL_B'), ('61', 'M2_HALL_C'), ('63', 'M2_HIN1'), ('64', 'M2_HIN2'), ('65', 'M2_HIN3'), ('26', 'M2_IA'), ('29', 'M2_IB'), ('34', 'M2_IBUS'), ('30', 'M2_IC'), ('15', 'M2_LIN1'), ('16', 'M2_LIN2'), ('17', 'M2_LIN3'), ('39', 'M2_NTC'), ('2', 'M2_SPI1_CS0'), ('21', 'MCU_VDDA'), ('22', 'MCU_VDDA'), ('14', 'NRST'), ('92', 'OLED_SCL'), ('93', 'OLED_SDA'), ('79', 'SPI2_MISO'), ('80', 'SPI2_MOSI'), ('78', 'SPI2_SCK'), ('76', 'SWCLK'), ('72', 'SWDIO'), ('100', 'VCC'), ('11', 'VCC'), ('28', 'VCC'), ('50', 'VCC'), ('6', 'VCC'), ('75', 'VCC'), ('73', 'unconnected-(U1-NC-Pad73)'), ('32', 'unconnected-(U1-PA7-Pad32)'), ('70', 'unconnected-(U1-PA11-Pad70)'), ('71', 'unconnected-(U1-PA12-Pad71)'), ('77', 'unconnected-(U1-PA15-Pad77)'), ('36', 'unconnected-(U1-PB1-Pad36)'), ('89', 'unconnected-(U1-PB3-Pad89)'), ('95', 'unconnected-(U1-PB8-Pad95)'), ('96', 'unconnected-(U1-PB9-Pad96)'), ('47', 'unconnected-(U1-PB10-Pad47)'), ('48', 'unconnected-(U1-PB11-Pad48)'), ('66', 'unconnected-(U1-PC9-Pad66)'), ('7', 'unconnected-(U1-PC13-Pad7)'), ('81', 'unconnected-(U1-PD0-Pad81)'), ('82', 'unconnected-(U1-PD1-Pad82)'), ('88', 'unconnected-(U1-PD7-Pad88)'), ('55', 'unconnected-(U1-PD8-Pad55)'), ('56', 'unconnected-(U1-PD9-Pad56)'), ('57', 'unconnected-(U1-PD10-Pad57)'), ('58', 'unconnected-(U1-PD11-Pad58)'), ('62', 'unconnected-(U1-PD15-Pad62)'), ('97', 'unconnected-(U1-PE0-Pad97)'), ('98', 'unconnected-(U1-PE1-Pad98)'), ('3', 'unconnected-(U1-PE4-Pad3)'), ('4', 'unconnected-(U1-PE5-Pad4)'), ('5', 'unconnected-(U1-PE6-Pad5)'), ('40', 'unconnected-(U1-PE9-Pad40)'), ('41', 'unconnected-(U1-PE10-Pad41)'), ('42', 'unconnected-(U1-PE11-Pad42)'), ('43', 'unconnected-(U1-PE12-Pad43)'), ('44', 'unconnected-(U1-PE13-Pad44)'), ('45', 'unconnected-(U1-PE14-Pad45)'), ('46', 'unconnected-(U1-PE15-Pad46)')]
U2 | LP5907QMFX-3.3Q1 | ProDoc_Board1v1_2026-10-26-import-fps:SOT-23-5_L3.0-W1.7-P0.95-LS2.8-BR | /MCU/ | [('1', '5V'), ('3', '5V'), ('5', 'AVCC'), ('2', 'GND'), ('4', 'unconnected-(U2-NC-Pad4)')]
U20 | XC6210B332MR | ProDoc_Board1v1_2026-10-26-import-fps:SOT-23-5_L3.0-W1.7-P0.95-LS2.8-BR | /MCU/ | [('1', '5V'), ('3', '5V'), ('2', 'GND'), ('5', 'VCC'), ('4', 'unconnected-(U20-NC-Pad4)')]
Y200 | 8MHz | HXTAL:ABM3B_5x3.2mm | /MCU/ | [('1', '/MCU/HXTAL_IN'), ('3', '/MCU/HXTAL_OUT'), ('2', 'GND'), ('4', 'GND')]
Y201 | 32.768kHz | VerifiedParts:ABS07_32.768kHz_3215 | /MCU/ | [('1', '/MCU/LXTAL_IN'), ('2', '/MCU/LXTAL_OUT')]
C19 | 100nF | ProDoc_Board1v1_2026-10-26-import-fps:C0603_S | /POWER_SHARED/ | [('2', '5V'), ('1', 'GND')]
C66 | 56pF | Capacitor_SMD:C_0603_1608Metric | /POWER_SHARED/ | [('1', 'FB'), ('2', 'Net-(C66-Pad2)')]
C67 | 2.2nF | Capacitor_SMD:C_0603_1608Metric | /POWER_SHARED/ | [('1', '/POWER_SHARED/PWR_BST_U6'), ('2', 'Net-(U6-SW)')]
C68 | 3.3nF | Capacitor_SMD:C_0603_1608Metric | /POWER_SHARED/ | [('1', '12V'), ('2', 'Net-(C66-Pad2)')]
C69 | 10uF | ProDoc_Board1v1_2026-10-26-import-fps:C1206_S | /POWER_SHARED/ | [('2', 'DCBUS'), ('1', 'GND')]
C70 | 100nF | ProDoc_Board1v1_2026-10-26-import-fps:C1206_S | /POWER_SHARED/ | [('2', 'DCBUS'), ('1', 'GND')]
C71 | 10uF | ProDoc_Board1v1_2026-10-26-import-fps:C0603_S | /POWER_SHARED/ | [('2', '12V'), ('1', 'GND')]
C72 | 10uF | ProDoc_Board1v1_2026-10-26-import-fps:C0603_S | /POWER_SHARED/ | [('2', '12V'), ('1', 'GND')]
C73 | 10uF | ProDoc_Board1v1_2026-10-26-import-fps:C0603_S | /POWER_SHARED/ | [('1', '12V'), ('2', 'GND')]
C74 | 10uF | Capacitor_SMD:C_1206_3216Metric | /POWER_SHARED/ | [('2', '12V'), ('1', 'GND')]
C79 | 10nF | ProDoc_Board1v1_2026-10-26-import-fps:C0603_S | /POWER_SHARED/ | [('1', 'AGND'), ('2', 'Net-(U12-IN+)')]
C125 | 100nF | ProDoc_Board1v1_2026-10-26-import-fps:C0603_S | /POWER_SHARED/ | [('1', 'Net-(D23-K)'), ('2', 'PGND')]
C126 | 100nF | ProDoc_Board1v1_2026-10-26-import-fps:C0603_S | /POWER_SHARED/ | [('1', 'Net-(Q2-B)'), ('2', 'Net-(Q2-C)')]
C127 | 100nF | ProDoc_Board1v1_2026-10-26-import-fps:C0603_S | /POWER_SHARED/ | [('1', 'DCBUS_IN'), ('2', 'Net-(D24-A)')]
C128 | 10nF | ProDoc_Board1v1_2026-10-26-import-fps:C0603_S | /POWER_SHARED/ | [('1', 'Net-(C128-Pad1)'), ('2', 'PGND_IN')]
C129 | 10nF | ProDoc_Board1v1_2026-10-26-import-fps:C0603_S | /POWER_SHARED/ | [('1', 'Net-(C129-Pad1)'), ('2', 'PGND')]
C137 | 10uF | ProDoc_Board1v1_2026-10-26-import-fps:C0603_S | /POWER_SHARED/ | [('2', '12V'), ('1', 'GND')]
C138 | 10uF | ProDoc_Board1v1_2026-10-26-import-fps:C0603_S | /POWER_SHARED/ | [('2', '12V'), ('1', 'GND')]
C139 | 10uF | ProDoc_Board1v1_2026-10-26-import-fps:C0603_S | /POWER_SHARED/ | [('2', '12V'), ('1', 'GND')]
C151 | 10uF | Capacitor_SMD:C_1206_3216Metric | /POWER_SHARED/ | [('2', 'DCBUS'), ('1', 'PGND')]
C152 | 10uF | Capacitor_SMD:C_1206_3216Metric | /POWER_SHARED/ | [('2', 'DCBUS'), ('1', 'PGND')]
C153 | 10uF | Capacitor_SMD:C_1206_3216Metric | /POWER_SHARED/ | [('2', 'DCBUS'), ('1', 'PGND')]
C154 | 10uF | Capacitor_SMD:C_1206_3216Metric | /POWER_SHARED/ | [('2', 'DCBUS'), ('1', 'PGND')]
C155 | 10uF | Capacitor_SMD:C_1206_3216Metric | /POWER_SHARED/ | [('2', 'DCBUS'), ('1', 'PGND')]
C156 | 10uF | Capacitor_SMD:C_1206_3216Metric | /POWER_SHARED/ | [('2', 'DCBUS'), ('1', 'PGND')]
C157 | 10uF | Capacitor_SMD:C_1206_3216Metric | /POWER_SHARED/ | [('2', 'DCBUS'), ('1', 'PGND')]
C158 | 10uF | Capacitor_SMD:C_1206_3216Metric | /POWER_SHARED/ | [('2', 'DCBUS'), ('1', 'PGND')]
C159 | 10uF | Capacitor_SMD:C_1206_3216Metric | /POWER_SHARED/ | [('2', 'DCBUS'), ('1', 'PGND')]
C160 | 10uF | Capacitor_SMD:C_1206_3216Metric | /POWER_SHARED/ | [('2', 'DCBUS'), ('1', 'PGND')]
C161 | 10uF | Capacitor_SMD:C_1206_3216Metric | /POWER_SHARED/ | [('2', 'DCBUS'), ('1', 'PGND')]
C162 | 10uF | Capacitor_SMD:C_1206_3216Metric | /POWER_SHARED/ | [('2', 'DCBUS_IN'), ('1', 'PGND_IN')]
C163 | 10uF | Capacitor_SMD:C_1206_3216Metric | /POWER_SHARED/ | [('2', 'DCBUS_IN'), ('1', 'PGND_IN')]
C164 | 220uF | VerifiedParts:50TZV220M10X10.5 | /POWER_SHARED/ | [('1', 'DCBUS'), ('2', 'PGND')]
C165 | 220uF | VerifiedParts:50TZV220M10X10.5 | /POWER_SHARED/ | [('1', 'DCBUS'), ('2', 'PGND')]
C166 | 100nF | ProDoc_Board1v1_2026-10-26-import-fps:C0603_S | /POWER_SHARED/ | [('2', '5V'), ('1', 'GND')]
C167 | 100nF | ProDoc_Board1v1_2026-10-26-import-fps:C0603_S | /POWER_SHARED/ | [('2', '5V'), ('1', 'GND')]
C168 | 10uF | ProDoc_Board1v1_2026-10-26-import-fps:C0603_S | /POWER_SHARED/ | [('2', '12V'), ('1', 'GND')]
C169 | 100nF | ProDoc_Board1v1_2026-10-26-import-fps:C0603_S | /POWER_SHARED/ | [('1', '12V'), ('2', 'GND')]
C170 | 10uF | ProDoc_Board1v1_2026-10-26-import-fps:C0603_S | /POWER_SHARED/ | [('1', '12V'), ('2', 'GND')]
C171 | 100nF | ProDoc_Board1v1_2026-10-26-import-fps:C0603_S | /POWER_SHARED/ | [('2', '5V'), ('1', 'GND')]
C172 | 100nF | Capacitor_SMD:C_0603_1608Metric | /POWER_SHARED/ | [('1', '/POWER_SHARED/PWR_BST_U19'), ('2', 'Net-(U19-SW)')]
CN1 | XT30PW-M30.G.Y | ProDoc_Board1v1_2026-10-26-import-fps:CONN-TH_XT30PW-M | /POWER_SHARED/ | [('1', 'DCBUS_IN'), ('2', 'PGND_IN'), ('3', 'unconnected-(CN1-Pad3)'), ('4', 'unconnected-(CN1-Pad4)')]
CN4 | 5012 | ProDoc_Board1v1_2026-10-26-import-fps:测试点 | /POWER_SHARED/ | [('1', '12V')]
CN7 | 5012 | ProDoc_Board1v1_2026-10-26-import-fps:测试点 | /POWER_SHARED/ | [('1', '5V')]
CN9 | 5012 | ProDoc_Board1v1_2026-10-26-import-fps:测试点 | /POWER_SHARED/ | [('1', 'DCBUS')]
CN13 | 5012 | ProDoc_Board1v1_2026-10-26-import-fps:测试点 | /POWER_SHARED/ | [('1', 'VREF')]
CN16 | 5012 | ProDoc_Board1v1_2026-10-26-import-fps:测试点 | /POWER_SHARED/ | [('1', 'Net-(U12-IN+)')]
D4 | TCLLZ39VTR | Diode_SMD:D_MiniMELF | /POWER_SHARED/ | [('1', 'Net-(D4-C)'), ('2', 'PGND_IN')]
D22 | 1.5SMC30CAHE3/57T | ProDoc_Board1v1_2026-10-26-import-fps:SMC_L6.8-W5.9-LS7.8-BI | /POWER_SHARED/ | [('2', 'DCBUS_IN'), ('1', 'PGND_IN')]
D23 | ZMM12V | Diode_SMD:D_MiniMELF | /POWER_SHARED/ | [('1', 'Net-(D23-K)'), ('2', 'PGND')]
D24 | ZMM12V | Diode_SMD:D_MiniMELF | /POWER_SHARED/ | [('1', 'DCBUS_IN'), ('2', 'Net-(D24-A)')]
L5 | NCD0603R1 | Interface:LED_0603_1608Metric_A1K2 | /POWER_SHARED/ | [('2', 'GND'), ('1', 'Net-(L5-Pad1)')]
L6 | 68uH | VerifiedParts:SMNR6045-680MT | /POWER_SHARED/ | [('2', '12V'), ('1', 'Net-(U6-SW)')]
L7 | NCD0603R1 | Interface:LED_0603_1608Metric_A1K2 | /POWER_SHARED/ | [('2', 'GND'), ('1', 'Net-(L7-Pad1)')]
L8 | NCD0603R1 | Interface:LED_0603_1608Metric_A1K2 | /POWER_SHARED/ | [('2', 'GND'), ('1', 'Net-(L8-Pad1)')]
L9 | 4.7uH | VerifiedParts:MPIH252010-4R7M-LF | /POWER_SHARED/ | [('2', '5V'), ('1', 'Net-(U19-SW)')]
Q1 | WSD90P06DN56 | ProDoc_Boa-easyedapro: | /POWER_SHARED/ | [('2', 'DCBUS'), ('3', 'DCBUS_IN'), ('1', 'Net-(D24-A)')]
Q2 | FMMT593 | ProDoc_Board1v1_2026-10-26-import-fps:SOT-23-3_L2.9-W1.3-P1.90-LS2.4-BR_1 | /POWER_SHARED/ | [('2', 'DCBUS_IN'), ('1', 'Net-(Q2-B)'), ('3', 'Net-(Q2-C)')]
Q3 | WSD80120DN56 | VerifiedParts:WSD80120DN56_GDS123 | /POWER_SHARED/ | [('1', 'Net-(D23-K)'), ('3', 'PGND'), ('2', 'PGND_IN')]
R40 | 10kΩ | ProDoc_Board1v1_2026-10-26-import-fps:R0603_S | /POWER_SHARED/ | [('2', '12V'), ('1', 'Net-(L5-Pad1)')]
R41 | 0Ω | ProDoc_Board1v1_2026-10-26-import-fps:R0603_S | /POWER_SHARED/ | [('1', 'GND'), ('2', 'GND')]
R42 | 0Ω | ProDoc_Board1v1_2026-10-26-import-fps:R0603_S | /POWER_SHARED/ | [('1', 'GND'), ('2', 'GND')]
R43 | 49.9kΩ | Resistor_SMD:R_0603_1608Metric | /POWER_SHARED/ | [('1', 'FB'), ('2', 'GND')]
R44 | 453kΩ | Resistor_SMD:R_0603_1608Metric | /POWER_SHARED/ | [('1', '12V'), ('2', 'FB')]
R45 | 453kΩ | Resistor_SMD:R_0603_1608Metric | /POWER_SHARED/ | [('2', 'Net-(C66-Pad2)'), ('1', 'Net-(U6-SW)')]
R46 | 100kΩ | Resistor_SMD:R_0603_1608Metric | /POWER_SHARED/ | [('2', 'GND'), ('1', 'Net-(U6-RON)')]
R47 | 100kΩ | Resistor_SMD:R_0603_1608Metric | /POWER_SHARED/ | [('1', 'DCBUS'), ('2', 'Net-(U6-EN)')]
R48 | 10kΩ | ProDoc_Board1v1_2026-10-26-import-fps:R0603_S | /POWER_SHARED/ | [('2', 'AVCC'), ('1', 'Net-(U12-IN+)')]
R57 | 10kΩ | ProDoc_Board1v1_2026-10-26-import-fps:R0603_S | /POWER_SHARED/ | [('1', 'AGND'), ('2', 'Net-(U12-IN+)')]
R131 | 22Ω | ProDoc_Board1v1_2026-10-26-import-fps:R0603_S | /POWER_SHARED/ | [('2', 'DCBUS_IN'), ('1', 'Net-(C128-Pad1)')]
R132 | 22Ω | ProDoc_Board1v1_2026-10-26-import-fps:R0603_S | /POWER_SHARED/ | [('2', 'DCBUS'), ('1', 'Net-(C129-Pad1)')]
R133 | 10kΩ | ProDoc_Board1v1_2026-10-26-import-fps:R0603_S | /POWER_SHARED/ | [('2', 'DCBUS'), ('1', 'Net-(L7-Pad1)')]
R134 | 0Ω | ProDoc_Board1v1_2026-10-26-import-fps:R0603_S | /POWER_SHARED/ | [('2', 'GND'), ('1', 'PGND')]
R136 | 0Ω | ProDoc_Board1v1_2026-10-26-import-fps:R0603_S | /POWER_SHARED/ | [('2', 'GND'), ('1', 'PGND')]
R137 | 1kΩ | ProDoc_Board1v1_2026-10-26-import-fps:R0603_S | /POWER_SHARED/ | [('2', 'Net-(D4-C)'), ('1', 'Net-(Q2-B)')]
R138 | 1kΩ | ProDoc_Board1v1_2026-10-26-import-fps:R0603_S | /POWER_SHARED/ | [('1', 'Net-(Q2-C)'), ('2', 'PGND')]
R139 | 1kΩ | ProDoc_Board1v1_2026-10-26-import-fps:R0603_S | /POWER_SHARED/ | [('1', 'Net-(D24-A)'), ('2', 'Net-(Q2-C)')]
R140 | 100kΩ | ProDoc_Board1v1_2026-10-26-import-fps:R0603_S | /POWER_SHARED/ | [('2', 'DCBUS_IN'), ('1', 'Net-(D23-K)')]
R141 | 100kΩ | ProDoc_Board1v1_2026-10-26-import-fps:R0603_S | /POWER_SHARED/ | [('2', 'DCBUS_IN'), ('1', 'Net-(D4-C)')]
R142 | 1.5MΩ | ProDoc_Board1v1_2026-10-26-import-fps:R0603_S | /POWER_SHARED/ | [('2', 'DCBUS'), ('1', 'Net-(Q2-B)')]
R152 | 1kΩ | ProDoc_Board1v1_2026-10-26-import-fps:R0603_S | /POWER_SHARED/ | [('2', '5V'), ('1', 'Net-(L8-Pad1)')]
R153 | 10kΩ | ProDoc_Board1v1_2026-10-26-import-fps:R0603_S | /POWER_SHARED/ | [('2', '12V'), ('1', 'Net-(U19-EN)')]
R154 | 12kΩ | Resistor_SMD:R_0603_1608Metric | /POWER_SHARED/ | [('2', 'GND'), ('1', 'Net-(U19-FB)')]
R155 | 62kΩ | Resistor_SMD:R_0603_1608Metric | /POWER_SHARED/ | [('1', '5V'), ('2', 'Net-(U19-FB)')]
U6 | LM5164DDAR | ProDoc_Board1v1_2026-10-26-import-fps:SO-8_L4.9-W3.9-P1.27-LS6.0-BL-EP | /POWER_SHARED/ | [('7', '/POWER_SHARED/PWR_BST_U6'), ('2', 'DCBUS'), ('5', 'FB'), ('1', 'GND'), ('9', 'GND'), ('3', 'Net-(U6-EN)'), ('4', 'Net-(U6-RON)'), ('8', 'Net-(U6-SW)'), ('6', 'unconnected-(U6-PG-Pad6)')]
U12 | LM321MF/NOPB | ProDoc_Board1v1_2026-10-26-import-fps:SOT-23-5_L3.0-W1.7-P0.95-LS2.8-BR_1 | /POWER_SHARED/ | [('2', 'AGND'), ('5', 'AVCC'), ('1', 'Net-(U12-IN+)'), ('3', 'VREF'), ('4', 'VREF')]
U19 | RY8411 | ProDoc_Board1v1_2026-10-26-import-fps:SOT-23-6_L2.9-W1.6-P0.95-LS2.8-BR | /POWER_SHARED/ | [('1', '/POWER_SHARED/PWR_BST_U19'), ('5', '12V'), ('2', 'GND'), ('4', 'Net-(U19-EN)'), ('3', 'Net-(U19-FB)'), ('6', 'Net-(U19-SW)')]
C75 | 1uF | ProDoc_Board1v1_2026-10-26-import-fps:C0603_S | /FOC_M1/ | [('1', 'GND'), ('2', 'M1_VA')]
C76 | 1uF | ProDoc_Board1v1_2026-10-26-import-fps:C0603_S | /FOC_M1/ | [('1', 'GND'), ('2', 'M1_VB')]
C77 | 1uF | ProDoc_Board1v1_2026-10-26-import-fps:C0603_S | /FOC_M1/ | [('1', 'GND'), ('2', 'M1_VC')]
C78 | 100nF | ProDoc_Board1v1_2026-10-26-import-fps:C0603_S | /FOC_M1/ | [('1', 'GND'), ('2', 'M1_VBUS')]
C80 | 100nF | ProDoc_Board1v1_2026-10-26-import-fps:C0603_S | /FOC_M1/ | [('1', 'GND'), ('2', 'M1_NTC')]
C82 | 100pF | ProDoc_Board1v1_2026-10-26-import-fps:C0603_S | /FOC_M1/ | [('2', 'GND'), ('1', 'M1_ENC_A_IN')]
C83 | 100pF | ProDoc_Board1v1_2026-10-26-import-fps:C0603_S | /FOC_M1/ | [('2', 'GND'), ('1', 'M1_ENC_B_IN')]
C84 | 100pF | ProDoc_Board1v1_2026-10-26-import-fps:C0603_S | /FOC_M1/ | [('2', 'GND'), ('1', 'M1_ENC_C_IN')]
C85 | 1nF | ProDoc_Board1v1_2026-10-26-import-fps:C0603_S | /FOC_M1/ | [('2', 'GND'), ('1', 'M1_PWM')]
C96 | 10uF | Capacitor_SMD:C_1206_3216Metric | /FOC_M1/ | [('2', 'DCBUS'), ('1', 'PGND')]
C97 | 10uF | Capacitor_SMD:C_1206_3216Metric | /FOC_M1/ | [('2', 'DCBUS'), ('1', 'PGND')]
C98 | 10uF | Capacitor_SMD:C_1206_3216Metric | /FOC_M1/ | [('2', 'DCBUS'), ('1', 'PGND')]
C99 | 10uF | Capacitor_SMD:C_1206_3216Metric | /FOC_M1/ | [('2', 'DCBUS'), ('1', 'PGND')]
C100 | 10uF | Capacitor_SMD:C_1206_3216Metric | /FOC_M1/ | [('2', 'DCBUS'), ('1', 'PGND')]
C101 | 10uF | Capacitor_SMD:C_1206_3216Metric | /FOC_M1/ | [('2', 'DCBUS'), ('1', 'PGND')]
C102 | 10uF | Capacitor_SMD:C_1206_3216Metric | /FOC_M1/ | [('2', 'DCBUS'), ('1', 'PGND')]
C103 | 10uF | Capacitor_SMD:C_1206_3216Metric | /FOC_M1/ | [('2', 'DCBUS'), ('1', 'PGND')]
C104 | 10uF | Capacitor_SMD:C_1206_3216Metric | /FOC_M1/ | [('2', 'DCBUS'), ('1', 'PGND')]
C130 | 1uF | ProDoc_Board1v1_2026-10-26-import-fps:C0603 | /FOC_M1/ | [('2', 'M1_MA'), ('1', 'M1_VB1')]
C131 | 1uF | ProDoc_Board1v1_2026-10-26-import-fps:C0603 | /FOC_M1/ | [('2', 'M1_MB'), ('1', 'M1_VB2')]
C132 | 1uF | ProDoc_Board1v1_2026-10-26-import-fps:C0603 | /FOC_M1/ | [('2', 'M1_MC'), ('1', 'M1_VB3')]
C133 | 1nF | ProDoc_Board1v1_2026-10-26-import-fps:C0603_S | /FOC_M1/ | [('1', 'AGND'), ('2', 'M1_IC')]
C134 | 1nF | ProDoc_Board1v1_2026-10-26-import-fps:C0603_S | /FOC_M1/ | [('1', 'AGND'), ('2', 'M1_IBUS')]
C135 | 1nF | ProDoc_Board1v1_2026-10-26-import-fps:C0603_S | /FOC_M1/ | [('1', 'AGND'), ('2', 'M1_IB')]
C136 | 1nF | ProDoc_Board1v1_2026-10-26-import-fps:C0603_S | /FOC_M1/ | [('1', 'AGND'), ('2', 'M1_IA')]
C143 | 100nF | ProDoc_Board1v1_2026-10-26-import-fps:C0603_S | /FOC_M1/ | [('2', '12V'), ('1', 'GND')]
C145 | 1nF | ProDoc_Board1v1_2026-10-26-import-fps:C0603_S | /FOC_M1/ | [('1', 'M1_MA'), ('2', 'Net-(D5-+)')]
C146 | 1nF | ProDoc_Board1v1_2026-10-26-import-fps:C0603_S | /FOC_M1/ | [('1', 'M1_IA+'), ('2', 'Net-(D11-+)')]
C147 | 1nF | ProDoc_Board1v1_2026-10-26-import-fps:C0603_S | /FOC_M1/ | [('1', 'M1_MB'), ('2', 'Net-(D6-+)')]
C148 | 1nF | ProDoc_Board1v1_2026-10-26-import-fps:C0603_S | /FOC_M1/ | [('1', 'M1_IB+'), ('2', 'Net-(D12-+)')]
C149 | 1nF | ProDoc_Board1v1_2026-10-26-import-fps:C0603_S | /FOC_M1/ | [('1', 'M1_MC'), ('2', 'Net-(D7-+)')]
C150 | 1nF | ProDoc_Board1v1_2026-10-26-import-fps:C0603_S | /FOC_M1/ | [('1', 'M1_IC+'), ('2', 'Net-(D13-+)')]
C9101 | 100nF | ProDoc_Board1v1_2026-10-26-import-fps:C0603_S | /FOC_M1/ | [('2', 'GND'), ('1', 'VCC')]
C9102 | 1uF | ProDoc_Board1v1_2026-10-26-import-fps:C0603_S | /FOC_M1/ | [('2', 'GND'), ('1', 'VCC')]
CN5 | WAFER-GH1.25-6PWB | ProDoc_Board1v1_2026-10-26-import-fps:CONN-SMD_6P-P1.25_XUNPU_WAFER-GH1.25-6PWB | /FOC_M1/ | [('1', 'GND'), ('7', 'GND'), ('8', 'GND'), ('6', 'M1_ENC_VSUP'), ('2', 'Net-(CN5-Pad2)'), ('3', 'Net-(CN5-Pad3)'), ('4', 'Net-(CN5-Pad4)'), ('5', 'Net-(CN5-Pad5)')]
CN14 | 5012 | ProDoc_Board1v1_2026-10-26-import-fps:测试点 | /FOC_M1/ | [('1', 'M1_IBUS')]
CN15 | 5012 | ProDoc_Board1v1_2026-10-26-import-fps:测试点 | /FOC_M1/ | [('1', 'M1_IC')]
CN17 | 5012 | ProDoc_Board1v1_2026-10-26-import-fps:测试点 | /FOC_M1/ | [('1', 'Net-(D5-+)')]
CN18 | 5012 | ProDoc_Board1v1_2026-10-26-import-fps:测试点 | /FOC_M1/ | [('1', 'Net-(D6-+)')]
CN19 | 5012 | ProDoc_Board1v1_2026-10-26-import-fps:测试点 | /FOC_M1/ | [('1', 'Net-(D7-+)')]
CN20 | 5012 | ProDoc_Board1v1_2026-10-26-import-fps:测试点 | /FOC_M1/ | [('1', 'M1_IA')]
CN21 | 5012 | ProDoc_Board1v1_2026-10-26-import-fps:测试点 | /FOC_M1/ | [('1', 'M1_IB')]
CN22 | 5012 | ProDoc_Board1v1_2026-10-26-import-fps:测试点 | /FOC_M1/ | [('1', 'M1_MA')]
CN23 | 5012 | ProDoc_Board1v1_2026-10-26-import-fps:测试点 | /FOC_M1/ | [('1', 'M1_MB')]
CN24 | 5012 | ProDoc_Board1v1_2026-10-26-import-fps:测试点 | /FOC_M1/ | [('1', 'M1_MC')]
CN25 | 5012 | ProDoc_Board1v1_2026-10-26-import-fps:测试点 | /FOC_M1/ | [('1', 'Net-(D11-+)')]
CN26 | 5012 | ProDoc_Board1v1_2026-10-26-import-fps:测试点 | /FOC_M1/ | [('1', 'Net-(D12-+)')]
CN27 | 5012 | ProDoc_Board1v1_2026-10-26-import-fps:测试点 | /FOC_M1/ | [('1', 'Net-(D13-+)')]
CN28 | 5012 | ProDoc_Board1v1_2026-10-26-import-fps:测试点 | /FOC_M1/ | [('1', 'M1_IA+')]
CN29 | 5012 | ProDoc_Board1v1_2026-10-26-import-fps:测试点 | /FOC_M1/ | [('1', 'M1_IB+')]
CN30 | 5012 | ProDoc_Board1v1_2026-10-26-import-fps:测试点 | /FOC_M1/ | [('1', 'M1_IC+')]
CN35 | 5012 | ProDoc_Board1v1_2026-10-26-import-fps:测试点 | /FOC_M1/ | [('1', 'M1_SHUNT_RETURN')]
CN36 | 5012 | ProDoc_Board1v1_2026-10-26-import-fps:测试点 | /FOC_M1/ | [('1', 'M1_SHUNT_RETURN')]
CN37 | 5012 | ProDoc_Board1v1_2026-10-26-import-fps:测试点 | /FOC_M1/ | [('1', 'M1_VA')]
CN38 | 5012 | ProDoc_Board1v1_2026-10-26-import-fps:测试点 | /FOC_M1/ | [('1', 'M1_VB')]
CN39 | 5012 | ProDoc_Board1v1_2026-10-26-import-fps:测试点 | /FOC_M1/ | [('1', 'M1_VC')]
CN40 | 5012 | ProDoc_Board1v1_2026-10-26-import-fps:测试点 | /FOC_M1/ | [('1', 'M1_VBUS')]
CN41 | MR30PW-F | ProDoc_Board1v1_2026-10-26-import-fps:CONN-TH_MR30PW-F | /FOC_M1/ | [('3', 'M1_MA'), ('2', 'M1_MB'), ('1', 'M1_MC'), ('4', 'PGND'), ('5', 'PGND')]
CN47 | WAFER-GH1.25-6PWB | ProDoc_Board1v1_2026-10-26-import-fps:CONN-SMD_6P-P1.25_XUNPU_WAFER-GH1.25-6PWB | /FOC_M1/ | [('6', 'GND'), ('7', 'GND'), ('8', 'GND'), ('2', 'Net-(CN47-Pad2)'), ('3', 'Net-(CN47-Pad3)'), ('4', 'Net-(CN47-Pad4)'), ('5', 'Net-(CN47-Pad5)'), ('1', 'VCC')]
D5 | B16WS | ProDoc_Board1v1_2026-10-26-import-fps:SOD-323_L1.8-W1.3-LS2.5-RD_2 | /FOC_M1/ | [('1', 'M1_HO1'), ('2', 'Net-(D5-+)')]
D6 | B16WS | ProDoc_Board1v1_2026-10-26-import-fps:SOD-323_L1.8-W1.3-LS2.5-RD_2 | /FOC_M1/ | [('1', 'M1_HO2'), ('2', 'Net-(D6-+)')]
D7 | B16WS | ProDoc_Board1v1_2026-10-26-import-fps:SOD-323_L1.8-W1.3-LS2.5-RD_2 | /FOC_M1/ | [('1', 'M1_HO3'), ('2', 'Net-(D7-+)')]
D8 | B16WS | Diode_SMD:D_SOD-323 | /FOC_M1/ | [('2', '12V'), ('1', 'M1_VB1')]
D9 | B16WS | Diode_SMD:D_SOD-323 | /FOC_M1/ | [('2', '12V'), ('1', 'M1_VB2')]
D10 | B16WS | Diode_SMD:D_SOD-323 | /FOC_M1/ | [('2', '12V'), ('1', 'M1_VB3')]
D11 | B16WS | ProDoc_Board1v1_2026-10-26-import-fps:SOD-323_L1.8-W1.3-LS2.5-RD_2 | /FOC_M1/ | [('1', 'M1_LO1'), ('2', 'Net-(D11-+)')]
D12 | B16WS | ProDoc_Board1v1_2026-10-26-import-fps:SOD-323_L1.8-W1.3-LS2.5-RD_2 | /FOC_M1/ | [('1', 'M1_LO2'), ('2', 'Net-(D12-+)')]
D13 | B16WS | ProDoc_Board1v1_2026-10-26-import-fps:SOD-323_L1.8-W1.3-LS2.5-RD_2 | /FOC_M1/ | [('1', 'M1_LO3'), ('2', 'Net-(D13-+)')]
D14 | B16WS | ProDoc_Board1v1_2026-10-26-import-fps:SOD-323_L1.8-W1.3-LS2.5-RD_2 | /FOC_M1/ | [('1', '5V'), ('2', 'M1_ENC_C_IN')]
D15 | B16WS | ProDoc_Board1v1_2026-10-26-import-fps:SOD-323_L1.8-W1.3-LS2.5-RD_2 | /FOC_M1/ | [('2', 'M1_VA'), ('1', 'VCC')]
D16 | B16WS | ProDoc_Board1v1_2026-10-26-import-fps:SOD-323_L1.8-W1.3-LS2.5-RD_2 | /FOC_M1/ | [('2', 'M1_VB'), ('1', 'VCC')]
D17 | B16WS | ProDoc_Board1v1_2026-10-26-import-fps:SOD-323_L1.8-W1.3-LS2.5-RD_2 | /FOC_M1/ | [('2', 'M1_VC'), ('1', 'VCC')]
D18 | B16WS | ProDoc_Board1v1_2026-10-26-import-fps:SOD-323_L1.8-W1.3-LS2.5-RD_2 | /FOC_M1/ | [('2', 'M1_VBUS'), ('1', 'VCC')]
D19 | B16WS | ProDoc_Board1v1_2026-10-26-import-fps:SOD-323_L1.8-W1.3-LS2.5-RD_2 | /FOC_M1/ | [('1', '5V'), ('2', 'M1_ENC_A_IN')]
D20 | B16WS | ProDoc_Board1v1_2026-10-26-import-fps:SOD-323_L1.8-W1.3-LS2.5-RD_2 | /FOC_M1/ | [('1', '5V'), ('2', 'M1_ENC_B_IN')]
NTC1 | NCP18XH103F03RB | ProDoc_Board1v1_2026-10-26-import-fps:R0603_S | /FOC_M1/ | [('2', 'GND'), ('1', 'M1_NTC')]
Q5 | NCE7560K | VerifiedParts:NCE7560K | /FOC_M1/ | [('2', 'DCBUS'), ('3', 'M1_MA'), ('1', 'Net-(D5-+)')]
Q6 | NCE7560K | VerifiedParts:NCE7560K | /FOC_M1/ | [('2', 'DCBUS'), ('3', 'M1_MB'), ('1', 'Net-(D6-+)')]
Q7 | NCE7560K | VerifiedParts:NCE7560K | /FOC_M1/ | [('2', 'DCBUS'), ('3', 'M1_MC'), ('1', 'Net-(D7-+)')]
Q8 | NCE7560K | VerifiedParts:NCE7560K | /FOC_M1/ | [('3', 'M1_IA+'), ('2', 'M1_MA'), ('1', 'Net-(D11-+)')]
Q9 | NCE7560K | VerifiedParts:NCE7560K | /FOC_M1/ | [('3', 'M1_IB+'), ('2', 'M1_MB'), ('1', 'Net-(D12-+)')]
Q10 | NCE7560K | VerifiedParts:NCE7560K | /FOC_M1/ | [('3', 'M1_IC+'), ('2', 'M1_MC'), ('1', 'Net-(D13-+)')]
R49 | 0Ω | ProDoc_Board1v1_2026-10-26-import-fps:R0603_S | /FOC_M1/ | [('1', 'Net-(R49-Pad1)'), ('2', 'VCC')]
R50 | 22Ω | ProDoc_Board1v1_2026-10-26-import-fps:R0603_S | /FOC_M1/ | [('1', 'M1_IBUS'), ('2', 'Net-(U10B-OUTB)')]
R51 | 20kΩ | ProDoc_Board1v1_2026-10-26-import-fps:R0603_S | /FOC_M1/ | [('2', 'Net-(U10B-+INB)'), ('1', 'VREF')]
R52 | 1kΩ | ProDoc_Board1v1_2026-10-26-import-fps:R0603_S | /FOC_M1/ | [('1', 'M1_IC+'), ('2', 'Net-(U10A-+INA)')]
R53 | 22Ω | ProDoc_Board1v1_2026-10-26-import-fps:R0603_S | /FOC_M1/ | [('1', 'M1_IC'), ('2', 'Net-(U10A-OUTA)')]
R54 | 1kΩ | ProDoc_Board1v1_2026-10-26-import-fps:R0603_S | /FOC_M1/ | [('1', '5V'), ('2', 'Net-(CN5-Pad5)')]
R55 | 20kΩ | ProDoc_Board1v1_2026-10-26-import-fps:R0603_S | /FOC_M1/ | [('2', 'Net-(U10A-+INA)'), ('1', 'VREF')]
R59 | 22Ω | ProDoc_Board1v1_2026-10-26-import-fps:R0603_S | /FOC_M1/ | [('2', 'M1_HO1'), ('1', 'Net-(D5-+)')]
R60 | 22Ω | ProDoc_Board1v1_2026-10-26-import-fps:R0603_S | /FOC_M1/ | [('2', 'M1_HO2'), ('1', 'Net-(D6-+)')]
R61 | 22Ω | ProDoc_Board1v1_2026-10-26-import-fps:R0603_S | /FOC_M1/ | [('2', 'M1_HO3'), ('1', 'Net-(D7-+)')]
R62 | 10kΩ | ProDoc_Board1v1_2026-10-26-import-fps:R0603_S | /FOC_M1/ | [('2', 'M1_MA'), ('1', 'Net-(D5-+)')]
R63 | 10kΩ | ProDoc_Board1v1_2026-10-26-import-fps:R0603_S | /FOC_M1/ | [('2', 'M1_MB'), ('1', 'Net-(D6-+)')]
R64 | 10kΩ | ProDoc_Board1v1_2026-10-26-import-fps:R0603_S | /FOC_M1/ | [('2', 'M1_MC'), ('1', 'Net-(D7-+)')]
R65 | 20kΩ | ProDoc_Board1v1_2026-10-26-import-fps:R0603_S | /FOC_M1/ | [('2', 'Net-(U10C--INC)'), ('1', 'Net-(U10C-OUTC)')]
R66 | 20kΩ | ProDoc_Board1v1_2026-10-26-import-fps:R0603_S | /FOC_M1/ | [('2', 'Net-(U10D--IND)'), ('1', 'Net-(U10D-OUTD)')]
R67 | 1kΩ | ProDoc_Board1v1_2026-10-26-import-fps:R0603_S | /FOC_M1/ | [('1', 'M1_SHUNT_RETURN'), ('2', 'Net-(U10C--INC)')]
R68 | 1kΩ | ProDoc_Board1v1_2026-10-26-import-fps:R0603_S | /FOC_M1/ | [('1', 'M1_SHUNT_RETURN'), ('2', 'Net-(U10D--IND)')]
R69 | 1kΩ | ProDoc_Board1v1_2026-10-26-import-fps:R0603_S | /FOC_M1/ | [('1', 'M1_IA+'), ('2', 'Net-(U10C-+INC)')]
R70 | 22Ω | ProDoc_Board1v1_2026-10-26-import-fps:R0603_S | /FOC_M1/ | [('1', 'M1_IA'), ('2', 'Net-(U10C-OUTC)')]
R71 | 20kΩ | ProDoc_Board1v1_2026-10-26-import-fps:R0603_S | /FOC_M1/ | [('2', 'Net-(U10C-+INC)'), ('1', 'VREF')]
R72 | 1kΩ | ProDoc_Board1v1_2026-10-26-import-fps:R0603_S | /FOC_M1/ | [('1', 'M1_IB+'), ('2', 'Net-(U10D-+IND)')]
R73 | 22Ω | ProDoc_Board1v1_2026-10-26-import-fps:R0603_S | /FOC_M1/ | [('1', 'M1_IB'), ('2', 'Net-(U10D-OUTD)')]
R74 | 20kΩ | ProDoc_Board1v1_2026-10-26-import-fps:R0603_S | /FOC_M1/ | [('2', 'Net-(U10D-+IND)'), ('1', 'VREF')]
R75 | 22Ω | ProDoc_Board1v1_2026-10-26-import-fps:R0603_S | /FOC_M1/ | [('2', 'M1_LO1'), ('1', 'Net-(D11-+)')]
R76 | 22Ω | ProDoc_Board1v1_2026-10-26-import-fps:R0603_S | /FOC_M1/ | [('2', 'M1_LO2'), ('1', 'Net-(D12-+)')]
R77 | 22Ω | ProDoc_Board1v1_2026-10-26-import-fps:R0603_S | /FOC_M1/ | [('2', 'M1_LO3'), ('1', 'Net-(D13-+)')]
R78 | 10kΩ | ProDoc_Board1v1_2026-10-26-import-fps:R0603_S | /FOC_M1/ | [('2', 'M1_IA+'), ('1', 'Net-(D11-+)')]
R79 | 10kΩ | ProDoc_Board1v1_2026-10-26-import-fps:R0603_S | /FOC_M1/ | [('2', 'M1_IB+'), ('1', 'Net-(D12-+)')]
R80 | 10kΩ | ProDoc_Board1v1_2026-10-26-import-fps:R0603_S | /FOC_M1/ | [('2', 'M1_IC+'), ('1', 'Net-(D13-+)')]
R81 | 1mΩ | Resistor_SMD:R_2512_6332Metric | /FOC_M1/ | [('1', 'M1_IA+'), ('2', 'M1_SHUNT_RETURN')]
R82 | 1mΩ | Resistor_SMD:R_2512_6332Metric | /FOC_M1/ | [('1', 'M1_IB+'), ('2', 'M1_SHUNT_RETURN')]
R83 | 1mΩ | Resistor_SMD:R_2512_6332Metric | /FOC_M1/ | [('1', 'M1_IC+'), ('2', 'M1_SHUNT_RETURN')]
R84 | 10kΩ | ProDoc_Board1v1_2026-10-26-import-fps:R0603_S | /FOC_M1/ | [('1', 'M1_MA'), ('2', 'Net-(R84-Pad2)')]
R85 | 10kΩ | ProDoc_Board1v1_2026-10-26-import-fps:R0603_S | /FOC_M1/ | [('1', 'M1_MB'), ('2', 'Net-(R85-Pad2)')]
R86 | 10kΩ | ProDoc_Board1v1_2026-10-26-import-fps:R0603_S | /FOC_M1/ | [('1', 'M1_MC'), ('2', 'Net-(R86-Pad2)')]
R87 | 10kΩ | ProDoc_Board1v1_2026-10-26-import-fps:R0603_S | /FOC_M1/ | [('1', 'DCBUS'), ('2', 'Net-(R87-Pad2)')]
R88 | 10k | ProDoc_Board1v1_2026-10-26-import-fps:R0603_S | /FOC_M1/ | [('2', 'Net-(CN5-Pad4)'), ('1', 'Net-(R49-Pad1)')]
R89 | 10k | ProDoc_Board1v1_2026-10-26-import-fps:R0603_S | /FOC_M1/ | [('2', 'Net-(CN5-Pad3)'), ('1', 'Net-(R49-Pad1)')]
R90 | 10k | ProDoc_Board1v1_2026-10-26-import-fps:R0603_S | /FOC_M1/ | [('2', 'Net-(CN5-Pad2)'), ('1', 'Net-(R49-Pad1)')]
R91 | 10kΩ | ProDoc_Board1v1_2026-10-26-import-fps:R0603_S | /FOC_M1/ | [('2', 'M1_VA'), ('1', 'Net-(R84-Pad2)')]
R92 | 10kΩ | ProDoc_Board1v1_2026-10-26-import-fps:R0603_S | /FOC_M1/ | [('2', 'M1_VB'), ('1', 'Net-(R85-Pad2)')]
R93 | 10kΩ | ProDoc_Board1v1_2026-10-26-import-fps:R0603_S | /FOC_M1/ | [('2', 'M1_VC'), ('1', 'Net-(R86-Pad2)')]
R94 | 10kΩ | ProDoc_Board1v1_2026-10-26-import-fps:R0603_S | /FOC_M1/ | [('2', 'M1_VBUS'), ('1', 'Net-(R87-Pad2)')]
R95 | 100R | ProDoc_Board1v1_2026-10-26-import-fps:R0603_S | /FOC_M1/ | [('2', 'M1_ENC_A_IN'), ('1', 'Net-(CN5-Pad4)')]
R97 | 100R | ProDoc_Board1v1_2026-10-26-import-fps:R0603_S | /FOC_M1/ | [('2', 'M1_ENC_B_IN'), ('1', 'Net-(CN5-Pad3)')]
R98 | 100R | ProDoc_Board1v1_2026-10-26-import-fps:R0603_S | /FOC_M1/ | [('2', 'M1_ENC_C_IN'), ('1', 'Net-(CN5-Pad2)')]
R99 | 1kΩ | ProDoc_Board1v1_2026-10-26-import-fps:R0603_S | /FOC_M1/ | [('2', 'GND'), ('1', 'M1_VA')]
R100 | 1kΩ | ProDoc_Board1v1_2026-10-26-import-fps:R0603_S | /FOC_M1/ | [('2', 'GND'), ('1', 'M1_VB')]
R101 | 1kΩ | ProDoc_Board1v1_2026-10-26-import-fps:R0603_S | /FOC_M1/ | [('2', 'GND'), ('1', 'M1_VC')]
R102 | 1kΩ | ProDoc_Board1v1_2026-10-26-import-fps:R0603_S | /FOC_M1/ | [('2', 'GND'), ('1', 'M1_VBUS')]
R103 | 1kΩ | ProDoc_Board1v1_2026-10-26-import-fps:R0603_S | /FOC_M1/ | [('2', 'M1_PWM'), ('1', 'Net-(CN5-Pad5)')]
R104 | 10kΩ | ProDoc_Board1v1_2026-10-26-import-fps:R0603_S | /FOC_M1/ | [('2', 'M1_NTC'), ('1', 'VCC')]
R105 | 1kΩ | ProDoc_Board1v1_2026-10-26-import-fps:R0603_S | /FOC_M1/ | [('2', 'GND'), ('1', 'M1_PWM')]
R106 | 1k | ProDoc_Board1v1_2026-10-26-import-fps:R0603_S | /FOC_M1/ | [('2', 'GND'), ('1', 'M1_ENC_A_IN')]
R107 | 1k | ProDoc_Board1v1_2026-10-26-import-fps:R0603_S | /FOC_M1/ | [('2', 'GND'), ('1', 'M1_ENC_B_IN')]
R108 | 1k | ProDoc_Board1v1_2026-10-26-import-fps:R0603_S | /FOC_M1/ | [('2', 'GND'), ('1', 'M1_ENC_C_IN')]
R109 | 1mΩ | Resistor_SMD:R_2512_6332Metric | /FOC_M1/ | [('1', 'M1_SHUNT_RETURN'), ('2', 'PGND')]
R117 | 22Ω | ProDoc_Board1v1_2026-10-26-import-fps:R0603_S | /FOC_M1/ | [('1', 'Net-(CN47-Pad5)'), ('2', 'SPI2_MOSI')]
R118 | 22Ω | ProDoc_Board1v1_2026-10-26-import-fps:R0603_S | /FOC_M1/ | [('1', 'Net-(CN47-Pad4)'), ('2', 'SPI2_MISO')]
R120 | 22Ω | ProDoc_Board1v1_2026-10-26-import-fps:R0603_S | /FOC_M1/ | [('1', 'Net-(CN47-Pad3)'), ('2', 'SPI2_SCK')]
R121 | 22Ω | ProDoc_Board1v1_2026-10-26-import-fps:R0603_S | /FOC_M1/ | [('2', 'M1_SPI1_CS0'), ('1', 'Net-(CN47-Pad2)')]
R128 | 1kΩ | ProDoc_Board1v1_2026-10-26-import-fps:R0603_S | /FOC_M1/ | [('2', 'M1_COM'), ('1', 'M1_VA')]
R129 | 1kΩ | ProDoc_Board1v1_2026-10-26-import-fps:R0603_S | /FOC_M1/ | [('1', 'M1_COM'), ('2', 'M1_VC')]
R130 | 1kΩ | ProDoc_Board1v1_2026-10-26-import-fps:R0603_S | /FOC_M1/ | [('1', 'M1_COM'), ('2', 'M1_VB')]
R145 | 1kΩ | ProDoc_Board1v1_2026-10-26-import-fps:R0603_S | /FOC_M1/ | [('1', 'M1_SHUNT_RETURN'), ('2', 'Net-(U10A--INA)')]
R146 | 20kΩ | ProDoc_Board1v1_2026-10-26-import-fps:R0603_S | /FOC_M1/ | [('2', 'Net-(U10A--INA)'), ('1', 'Net-(U10A-OUTA)')]
R147 | 1kΩ | ProDoc_Board1v1_2026-10-26-import-fps:R0603_S | /FOC_M1/ | [('2', 'Net-(U10B--INB)'), ('1', 'PGND')]
R148 | 1kΩ | ProDoc_Board1v1_2026-10-26-import-fps:R0603_S | /FOC_M1/ | [('1', 'M1_SHUNT_RETURN'), ('2', 'Net-(U10B-+INB)')]
R149 | 20kΩ | ProDoc_Board1v1_2026-10-26-import-fps:R0603_S | /FOC_M1/ | [('2', 'Net-(U10B--INB)'), ('1', 'Net-(U10B-OUTB)')]
R300 | 10k | Resistor_SMD:R_0603_1608Metric | /FOC_M1/ | [('2', 'GND'), ('1', 'M1_HIN1')]
R301 | 10k | Resistor_SMD:R_0603_1608Metric | /FOC_M1/ | [('2', 'GND'), ('1', 'M1_HIN2')]
R302 | 10k | Resistor_SMD:R_0603_1608Metric | /FOC_M1/ | [('2', 'GND'), ('1', 'M1_HIN3')]
R303 | 10k | Resistor_SMD:R_0603_1608Metric | /FOC_M1/ | [('2', 'GND'), ('1', 'M1_LIN1')]
R304 | 10k | Resistor_SMD:R_0603_1608Metric | /FOC_M1/ | [('2', 'GND'), ('1', 'M1_LIN2')]
R305 | 10k | Resistor_SMD:R_0603_1608Metric | /FOC_M1/ | [('2', 'GND'), ('1', 'M1_LIN3')]
R9101 | 0R | Resistor_SMD:R_0603_1608Metric | /FOC_M1/ | [('2', 'M1_ENC_VSUP'), ('1', 'VCC')]
R9102 | 0R (5V option) | Resistor_SMD:R_0603_1608Metric | /FOC_M1/ | [('1', '5V'), ('2', 'M1_ENC_VSUP')]
U7 | FD6288Q | ProDoc_Board1v1_2026-10-26-import-fps:QFN-24_L4.0-W4.0-P0.50-BL-EP2.6 | /FOC_M1/ | [('4', '12V'), ('25', 'GND'), ('6', 'GND'), ('22', 'M1_HIN1'), ('23', 'M1_HIN2'), ('24', 'M1_HIN3'), ('19', 'M1_HO1'), ('16', 'M1_HO2'), ('13', 'M1_HO3'), ('1', 'M1_LIN1'), ('2', 'M1_LIN2'), ('3', 'M1_LIN3'), ('11', 'M1_LO1'), ('10', 'M1_LO2'), ('9', 'M1_LO3'), ('18', 'M1_MA'), ('15', 'M1_MB'), ('12', 'M1_MC'), ('20', 'M1_VB1'), ('17', 'M1_VB2'), ('14', 'M1_VB3'), ('5', 'unconnected-(U7-NC-Pad5)'), ('7', 'unconnected-(U7-NC-Pad7)'), ('8', 'unconnected-(U7-NC-Pad8)'), ('21', 'unconnected-(U7-NC-Pad21)')]
U10 | RS624XQ | Package_SO:TSSOP-14_4.4x5mm_P0.65mm | /FOC_M1/ | [('11', 'AGND'), ('4', 'AVCC'), ('3', 'Net-(U10A-+INA)'), ('2', 'Net-(U10A--INA)'), ('1', 'Net-(U10A-OUTA)'), ('5', 'Net-(U10B-+INB)'), ('6', 'Net-(U10B--INB)'), ('7', 'Net-(U10B-OUTB)'), ('10', 'Net-(U10C-+INC)'), ('9', 'Net-(U10C--INC)'), ('8', 'Net-(U10C-OUTC)'), ('12', 'Net-(U10D-+IND)'), ('13', 'Net-(U10D--IND)'), ('14', 'Net-(U10D-OUTD)')]
U9101 | SN74LVC3G17DCUR | Package_SO:VSSOP-8_2.3x2mm_P0.5mm | /FOC_M1/ | [('4', 'GND'), ('1', 'M1_ENC_A_IN'), ('6', 'M1_ENC_B_IN'), ('3', 'M1_ENC_C_IN'), ('7', 'M1_HALL_A'), ('2', 'M1_HALL_B'), ('5', 'M1_HALL_C'), ('8', 'VCC')]
C1075 | 1uF | ProDoc_Board1v1_2026-10-26-import-fps:C0603_S | /FOC_M2/ | [('1', 'GND'), ('2', 'M2_VA')]
C1076 | 1uF | ProDoc_Board1v1_2026-10-26-import-fps:C0603_S | /FOC_M2/ | [('1', 'GND'), ('2', 'M2_VB')]
C1077 | 1uF | ProDoc_Board1v1_2026-10-26-import-fps:C0603_S | /FOC_M2/ | [('1', 'GND'), ('2', 'M2_VC')]
C1078 | 100nF | ProDoc_Board1v1_2026-10-26-import-fps:C0603_S | /FOC_M2/ | [('1', 'GND'), ('2', 'M2_VBUS')]
C1080 | 100nF | ProDoc_Board1v1_2026-10-26-import-fps:C0603_S | /FOC_M2/ | [('1', 'GND'), ('2', 'M2_NTC')]
C1082 | 100pF | ProDoc_Board1v1_2026-10-26-import-fps:C0603_S | /FOC_M2/ | [('2', 'GND'), ('1', 'M2_ENC_A_IN')]
C1083 | 100pF | ProDoc_Board1v1_2026-10-26-import-fps:C0603_S | /FOC_M2/ | [('2', 'GND'), ('1', 'M2_ENC_B_IN')]
C1084 | 100pF | ProDoc_Board1v1_2026-10-26-import-fps:C0603_S | /FOC_M2/ | [('2', 'GND'), ('1', 'M2_ENC_C_IN')]
C1085 | 1nF | ProDoc_Board1v1_2026-10-26-import-fps:C0603_S | /FOC_M2/ | [('2', 'GND'), ('1', 'M2_PWM')]
C1096 | 10uF | Capacitor_SMD:C_1206_3216Metric | /FOC_M2/ | [('2', 'DCBUS'), ('1', 'PGND')]
C1097 | 10uF | Capacitor_SMD:C_1206_3216Metric | /FOC_M2/ | [('2', 'DCBUS'), ('1', 'PGND')]
C1098 | 10uF | Capacitor_SMD:C_1206_3216Metric | /FOC_M2/ | [('2', 'DCBUS'), ('1', 'PGND')]
C1099 | 10uF | Capacitor_SMD:C_1206_3216Metric | /FOC_M2/ | [('2', 'DCBUS'), ('1', 'PGND')]
C1100 | 10uF | Capacitor_SMD:C_1206_3216Metric | /FOC_M2/ | [('2', 'DCBUS'), ('1', 'PGND')]
C1101 | 10uF | Capacitor_SMD:C_1206_3216Metric | /FOC_M2/ | [('2', 'DCBUS'), ('1', 'PGND')]
C1102 | 10uF | Capacitor_SMD:C_1206_3216Metric | /FOC_M2/ | [('2', 'DCBUS'), ('1', 'PGND')]
C1103 | 10uF | Capacitor_SMD:C_1206_3216Metric | /FOC_M2/ | [('2', 'DCBUS'), ('1', 'PGND')]
C1104 | 10uF | Capacitor_SMD:C_1206_3216Metric | /FOC_M2/ | [('2', 'DCBUS'), ('1', 'PGND')]
C1130 | 1uF | ProDoc_Board1v1_2026-10-26-import-fps:C0603 | /FOC_M2/ | [('2', 'M2_MA'), ('1', 'M2_VB1')]
C1131 | 1uF | ProDoc_Board1v1_2026-10-26-import-fps:C0603 | /FOC_M2/ | [('2', 'M2_MB'), ('1', 'M2_VB2')]
C1132 | 1uF | ProDoc_Board1v1_2026-10-26-import-fps:C0603 | /FOC_M2/ | [('2', 'M2_MC'), ('1', 'M2_VB3')]
C1133 | 1nF | ProDoc_Board1v1_2026-10-26-import-fps:C0603_S | /FOC_M2/ | [('1', 'AGND'), ('2', 'M2_IC')]
C1134 | 1nF | ProDoc_Board1v1_2026-10-26-import-fps:C0603_S | /FOC_M2/ | [('1', 'AGND'), ('2', 'M2_IBUS')]
C1135 | 1nF | ProDoc_Board1v1_2026-10-26-import-fps:C0603_S | /FOC_M2/ | [('1', 'AGND'), ('2', 'M2_IB')]
C1136 | 1nF | ProDoc_Board1v1_2026-10-26-import-fps:C0603_S | /FOC_M2/ | [('1', 'AGND'), ('2', 'M2_IA')]
C1143 | 100nF | ProDoc_Board1v1_2026-10-26-import-fps:C0603_S | /FOC_M2/ | [('2', '12V'), ('1', 'GND')]
C1145 | 1nF | ProDoc_Board1v1_2026-10-26-import-fps:C0603_S | /FOC_M2/ | [('1', 'M2_MA'), ('2', 'Net-(D1005-+)')]
C1146 | 1nF | ProDoc_Board1v1_2026-10-26-import-fps:C0603_S | /FOC_M2/ | [('1', 'M2_IA+'), ('2', 'Net-(D1011-+)')]
C1147 | 1nF | ProDoc_Board1v1_2026-10-26-import-fps:C0603_S | /FOC_M2/ | [('1', 'M2_MB'), ('2', 'Net-(D1006-+)')]
C1148 | 1nF | ProDoc_Board1v1_2026-10-26-import-fps:C0603_S | /FOC_M2/ | [('1', 'M2_IB+'), ('2', 'Net-(D1012-+)')]
C1149 | 1nF | ProDoc_Board1v1_2026-10-26-import-fps:C0603_S | /FOC_M2/ | [('1', 'M2_MC'), ('2', 'Net-(D1007-+)')]
C1150 | 1nF | ProDoc_Board1v1_2026-10-26-import-fps:C0603_S | /FOC_M2/ | [('1', 'M2_IC+'), ('2', 'Net-(D1013-+)')]
C9103 | 100nF | ProDoc_Board1v1_2026-10-26-import-fps:C0603_S | /FOC_M2/ | [('2', 'GND'), ('1', 'VCC')]
C9104 | 1uF | ProDoc_Board1v1_2026-10-26-import-fps:C0603_S | /FOC_M2/ | [('2', 'GND'), ('1', 'VCC')]
CN1005 | WAFER-GH1.25-6PWB | ProDoc_Board1v1_2026-10-26-import-fps:CONN-SMD_6P-P1.25_XUNPU_WAFER-GH1.25-6PWB | /FOC_M2/ | [('1', 'GND'), ('7', 'GND'), ('8', 'GND'), ('6', 'M2_ENC_VSUP'), ('2', 'Net-(CN1005-Pad2)'), ('3', 'Net-(CN1005-Pad3)'), ('4', 'Net-(CN1005-Pad4)'), ('5', 'Net-(CN1005-Pad5)')]
CN1014 | 5012 | ProDoc_Board1v1_2026-10-26-import-fps:测试点 | /FOC_M2/ | [('1', 'M2_IBUS')]
CN1015 | 5012 | ProDoc_Board1v1_2026-10-26-import-fps:测试点 | /FOC_M2/ | [('1', 'M2_IC')]
CN1017 | 5012 | ProDoc_Board1v1_2026-10-26-import-fps:测试点 | /FOC_M2/ | [('1', 'Net-(D1005-+)')]
CN1018 | 5012 | ProDoc_Board1v1_2026-10-26-import-fps:测试点 | /FOC_M2/ | [('1', 'Net-(D1006-+)')]
CN1019 | 5012 | ProDoc_Board1v1_2026-10-26-import-fps:测试点 | /FOC_M2/ | [('1', 'Net-(D1007-+)')]
CN1020 | 5012 | ProDoc_Board1v1_2026-10-26-import-fps:测试点 | /FOC_M2/ | [('1', 'M2_IA')]
CN1021 | 5012 | ProDoc_Board1v1_2026-10-26-import-fps:测试点 | /FOC_M2/ | [('1', 'M2_IB')]
CN1022 | 5012 | ProDoc_Board1v1_2026-10-26-import-fps:测试点 | /FOC_M2/ | [('1', 'M2_MA')]
CN1023 | 5012 | ProDoc_Board1v1_2026-10-26-import-fps:测试点 | /FOC_M2/ | [('1', 'M2_MB')]
CN1024 | 5012 | ProDoc_Board1v1_2026-10-26-import-fps:测试点 | /FOC_M2/ | [('1', 'M2_MC')]
CN1025 | 5012 | ProDoc_Board1v1_2026-10-26-import-fps:测试点 | /FOC_M2/ | [('1', 'Net-(D1011-+)')]
CN1026 | 5012 | ProDoc_Board1v1_2026-10-26-import-fps:测试点 | /FOC_M2/ | [('1', 'Net-(D1012-+)')]
CN1027 | 5012 | ProDoc_Board1v1_2026-10-26-import-fps:测试点 | /FOC_M2/ | [('1', 'Net-(D1013-+)')]
CN1028 | 5012 | ProDoc_Board1v1_2026-10-26-import-fps:测试点 | /FOC_M2/ | [('1', 'M2_IA+')]
CN1029 | 5012 | ProDoc_Board1v1_2026-10-26-import-fps:测试点 | /FOC_M2/ | [('1', 'M2_IB+')]
CN1030 | 5012 | ProDoc_Board1v1_2026-10-26-import-fps:测试点 | /FOC_M2/ | [('1', 'M2_IC+')]
CN1035 | 5012 | ProDoc_Board1v1_2026-10-26-import-fps:测试点 | /FOC_M2/ | [('1', 'M2_SHUNT_RETURN')]
CN1036 | 5012 | ProDoc_Board1v1_2026-10-26-import-fps:测试点 | /FOC_M2/ | [('1', 'M2_SHUNT_RETURN')]
CN1037 | 5012 | ProDoc_Board1v1_2026-10-26-import-fps:测试点 | /FOC_M2/ | [('1', 'M2_VA')]
CN1038 | 5012 | ProDoc_Board1v1_2026-10-26-import-fps:测试点 | /FOC_M2/ | [('1', 'M2_VB')]
CN1039 | 5012 | ProDoc_Board1v1_2026-10-26-import-fps:测试点 | /FOC_M2/ | [('1', 'M2_VC')]
CN1040 | 5012 | ProDoc_Board1v1_2026-10-26-import-fps:测试点 | /FOC_M2/ | [('1', 'M2_VBUS')]
CN1041 | MR30PW-F | ProDoc_Board1v1_2026-10-26-import-fps:CONN-TH_MR30PW-F | /FOC_M2/ | [('3', 'M2_MA'), ('2', 'M2_MB'), ('1', 'M2_MC'), ('4', 'PGND'), ('5', 'PGND')]
CN1047 | WAFER-GH1.25-6PWB | ProDoc_Board1v1_2026-10-26-import-fps:CONN-SMD_6P-P1.25_XUNPU_WAFER-GH1.25-6PWB | /FOC_M2/ | [('6', 'GND'), ('7', 'GND'), ('8', 'GND'), ('2', 'Net-(CN1047-Pad2)'), ('3', 'Net-(CN1047-Pad3)'), ('4', 'Net-(CN1047-Pad4)'), ('5', 'Net-(CN1047-Pad5)'), ('1', 'VCC')]
D1005 | B16WS | ProDoc_Board1v1_2026-10-26-import-fps:SOD-323_L1.8-W1.3-LS2.5-RD_2 | /FOC_M2/ | [('1', 'M2_HO1'), ('2', 'Net-(D1005-+)')]
D1006 | B16WS | ProDoc_Board1v1_2026-10-26-import-fps:SOD-323_L1.8-W1.3-LS2.5-RD_2 | /FOC_M2/ | [('1', 'M2_HO2'), ('2', 'Net-(D1006-+)')]
D1007 | B16WS | ProDoc_Board1v1_2026-10-26-import-fps:SOD-323_L1.8-W1.3-LS2.5-RD_2 | /FOC_M2/ | [('1', 'M2_HO3'), ('2', 'Net-(D1007-+)')]
D1008 | B16WS | Diode_SMD:D_SOD-323 | /FOC_M2/ | [('2', '12V'), ('1', 'M2_VB1')]
D1009 | B16WS | Diode_SMD:D_SOD-323 | /FOC_M2/ | [('2', '12V'), ('1', 'M2_VB2')]
D1010 | B16WS | Diode_SMD:D_SOD-323 | /FOC_M2/ | [('2', '12V'), ('1', 'M2_VB3')]
D1011 | B16WS | ProDoc_Board1v1_2026-10-26-import-fps:SOD-323_L1.8-W1.3-LS2.5-RD_2 | /FOC_M2/ | [('1', 'M2_LO1'), ('2', 'Net-(D1011-+)')]
D1012 | B16WS | ProDoc_Board1v1_2026-10-26-import-fps:SOD-323_L1.8-W1.3-LS2.5-RD_2 | /FOC_M2/ | [('1', 'M2_LO2'), ('2', 'Net-(D1012-+)')]
D1013 | B16WS | ProDoc_Board1v1_2026-10-26-import-fps:SOD-323_L1.8-W1.3-LS2.5-RD_2 | /FOC_M2/ | [('1', 'M2_LO3'), ('2', 'Net-(D1013-+)')]
D1014 | B16WS | ProDoc_Board1v1_2026-10-26-import-fps:SOD-323_L1.8-W1.3-LS2.5-RD_2 | /FOC_M2/ | [('1', '5V'), ('2', 'M2_ENC_C_IN')]
D1015 | B16WS | ProDoc_Board1v1_2026-10-26-import-fps:SOD-323_L1.8-W1.3-LS2.5-RD_2 | /FOC_M2/ | [('2', 'M2_VA'), ('1', 'VCC')]
D1016 | B16WS | ProDoc_Board1v1_2026-10-26-import-fps:SOD-323_L1.8-W1.3-LS2.5-RD_2 | /FOC_M2/ | [('2', 'M2_VB'), ('1', 'VCC')]
D1017 | B16WS | ProDoc_Board1v1_2026-10-26-import-fps:SOD-323_L1.8-W1.3-LS2.5-RD_2 | /FOC_M2/ | [('2', 'M2_VC'), ('1', 'VCC')]
D1018 | B16WS | ProDoc_Board1v1_2026-10-26-import-fps:SOD-323_L1.8-W1.3-LS2.5-RD_2 | /FOC_M2/ | [('2', 'M2_VBUS'), ('1', 'VCC')]
D1019 | B16WS | ProDoc_Board1v1_2026-10-26-import-fps:SOD-323_L1.8-W1.3-LS2.5-RD_2 | /FOC_M2/ | [('1', '5V'), ('2', 'M2_ENC_A_IN')]
D1020 | B16WS | ProDoc_Board1v1_2026-10-26-import-fps:SOD-323_L1.8-W1.3-LS2.5-RD_2 | /FOC_M2/ | [('1', '5V'), ('2', 'M2_ENC_B_IN')]
NTC1001 | NCP18XH103F03RB | ProDoc_Board1v1_2026-10-26-import-fps:R0603_S | /FOC_M2/ | [('2', 'GND'), ('1', 'M2_NTC')]
Q1005 | NCE7560K | VerifiedParts:NCE7560K | /FOC_M2/ | [('2', 'DCBUS'), ('3', 'M2_MA'), ('1', 'Net-(D1005-+)')]
Q1006 | NCE7560K | VerifiedParts:NCE7560K | /FOC_M2/ | [('2', 'DCBUS'), ('3', 'M2_MB'), ('1', 'Net-(D1006-+)')]
Q1007 | NCE7560K | VerifiedParts:NCE7560K | /FOC_M2/ | [('2', 'DCBUS'), ('3', 'M2_MC'), ('1', 'Net-(D1007-+)')]
Q1008 | NCE7560K | VerifiedParts:NCE7560K | /FOC_M2/ | [('3', 'M2_IA+'), ('2', 'M2_MA'), ('1', 'Net-(D1011-+)')]
Q1009 | NCE7560K | VerifiedParts:NCE7560K | /FOC_M2/ | [('3', 'M2_IB+'), ('2', 'M2_MB'), ('1', 'Net-(D1012-+)')]
Q1010 | NCE7560K | VerifiedParts:NCE7560K | /FOC_M2/ | [('3', 'M2_IC+'), ('2', 'M2_MC'), ('1', 'Net-(D1013-+)')]
R1049 | 0Ω | ProDoc_Board1v1_2026-10-26-import-fps:R0603_S | /FOC_M2/ | [('1', 'Net-(R1049-Pad1)'), ('2', 'VCC')]
R1050 | 22Ω | ProDoc_Board1v1_2026-10-26-import-fps:R0603_S | /FOC_M2/ | [('1', 'M2_IBUS'), ('2', 'Net-(U1010B-OUTB)')]
R1051 | 20kΩ | ProDoc_Board1v1_2026-10-26-import-fps:R0603_S | /FOC_M2/ | [('2', 'Net-(U1010B-+INB)'), ('1', 'VREF')]
R1052 | 1kΩ | ProDoc_Board1v1_2026-10-26-import-fps:R0603_S | /FOC_M2/ | [('1', 'M2_IC+'), ('2', 'Net-(U1010A-+INA)')]
R1053 | 22Ω | ProDoc_Board1v1_2026-10-26-import-fps:R0603_S | /FOC_M2/ | [('1', 'M2_IC'), ('2', 'Net-(U1010A-OUTA)')]
R1054 | 1kΩ | ProDoc_Board1v1_2026-10-26-import-fps:R0603_S | /FOC_M2/ | [('1', '5V'), ('2', 'Net-(CN1005-Pad5)')]
R1055 | 20kΩ | ProDoc_Board1v1_2026-10-26-import-fps:R0603_S | /FOC_M2/ | [('2', 'Net-(U1010A-+INA)'), ('1', 'VREF')]
R1059 | 22Ω | ProDoc_Board1v1_2026-10-26-import-fps:R0603_S | /FOC_M2/ | [('2', 'M2_HO1'), ('1', 'Net-(D1005-+)')]
R1060 | 22Ω | ProDoc_Board1v1_2026-10-26-import-fps:R0603_S | /FOC_M2/ | [('2', 'M2_HO2'), ('1', 'Net-(D1006-+)')]
R1061 | 22Ω | ProDoc_Board1v1_2026-10-26-import-fps:R0603_S | /FOC_M2/ | [('2', 'M2_HO3'), ('1', 'Net-(D1007-+)')]
R1062 | 10kΩ | ProDoc_Board1v1_2026-10-26-import-fps:R0603_S | /FOC_M2/ | [('2', 'M2_MA'), ('1', 'Net-(D1005-+)')]
R1063 | 10kΩ | ProDoc_Board1v1_2026-10-26-import-fps:R0603_S | /FOC_M2/ | [('2', 'M2_MB'), ('1', 'Net-(D1006-+)')]
R1064 | 10kΩ | ProDoc_Board1v1_2026-10-26-import-fps:R0603_S | /FOC_M2/ | [('2', 'M2_MC'), ('1', 'Net-(D1007-+)')]
R1065 | 20kΩ | ProDoc_Board1v1_2026-10-26-import-fps:R0603_S | /FOC_M2/ | [('2', 'Net-(U1010C--INC)'), ('1', 'Net-(U1010C-OUTC)')]
R1066 | 20kΩ | ProDoc_Board1v1_2026-10-26-import-fps:R0603_S | /FOC_M2/ | [('2', 'Net-(U1010D--IND)'), ('1', 'Net-(U1010D-OUTD)')]
R1067 | 1kΩ | ProDoc_Board1v1_2026-10-26-import-fps:R0603_S | /FOC_M2/ | [('1', 'M2_SHUNT_RETURN'), ('2', 'Net-(U1010C--INC)')]
R1068 | 1kΩ | ProDoc_Board1v1_2026-10-26-import-fps:R0603_S | /FOC_M2/ | [('1', 'M2_SHUNT_RETURN'), ('2', 'Net-(U1010D--IND)')]
R1069 | 1kΩ | ProDoc_Board1v1_2026-10-26-import-fps:R0603_S | /FOC_M2/ | [('1', 'M2_IA+'), ('2', 'Net-(U1010C-+INC)')]
R1070 | 22Ω | ProDoc_Board1v1_2026-10-26-import-fps:R0603_S | /FOC_M2/ | [('1', 'M2_IA'), ('2', 'Net-(U1010C-OUTC)')]
R1071 | 20kΩ | ProDoc_Board1v1_2026-10-26-import-fps:R0603_S | /FOC_M2/ | [('2', 'Net-(U1010C-+INC)'), ('1', 'VREF')]
R1072 | 1kΩ | ProDoc_Board1v1_2026-10-26-import-fps:R0603_S | /FOC_M2/ | [('1', 'M2_IB+'), ('2', 'Net-(U1010D-+IND)')]
R1073 | 22Ω | ProDoc_Board1v1_2026-10-26-import-fps:R0603_S | /FOC_M2/ | [('1', 'M2_IB'), ('2', 'Net-(U1010D-OUTD)')]
R1074 | 20kΩ | ProDoc_Board1v1_2026-10-26-import-fps:R0603_S | /FOC_M2/ | [('2', 'Net-(U1010D-+IND)'), ('1', 'VREF')]
R1075 | 22Ω | ProDoc_Board1v1_2026-10-26-import-fps:R0603_S | /FOC_M2/ | [('2', 'M2_LO1'), ('1', 'Net-(D1011-+)')]
R1076 | 22Ω | ProDoc_Board1v1_2026-10-26-import-fps:R0603_S | /FOC_M2/ | [('2', 'M2_LO2'), ('1', 'Net-(D1012-+)')]
R1077 | 22Ω | ProDoc_Board1v1_2026-10-26-import-fps:R0603_S | /FOC_M2/ | [('2', 'M2_LO3'), ('1', 'Net-(D1013-+)')]
R1078 | 10kΩ | ProDoc_Board1v1_2026-10-26-import-fps:R0603_S | /FOC_M2/ | [('2', 'M2_IA+'), ('1', 'Net-(D1011-+)')]
R1079 | 10kΩ | ProDoc_Board1v1_2026-10-26-import-fps:R0603_S | /FOC_M2/ | [('2', 'M2_IB+'), ('1', 'Net-(D1012-+)')]
R1080 | 10kΩ | ProDoc_Board1v1_2026-10-26-import-fps:R0603_S | /FOC_M2/ | [('2', 'M2_IC+'), ('1', 'Net-(D1013-+)')]
R1081 | 1mΩ | Resistor_SMD:R_2512_6332Metric | /FOC_M2/ | [('1', 'M2_IA+'), ('2', 'M2_SHUNT_RETURN')]
R1082 | 1mΩ | Resistor_SMD:R_2512_6332Metric | /FOC_M2/ | [('1', 'M2_IB+'), ('2', 'M2_SHUNT_RETURN')]
R1083 | 1mΩ | Resistor_SMD:R_2512_6332Metric | /FOC_M2/ | [('1', 'M2_IC+'), ('2', 'M2_SHUNT_RETURN')]
R1084 | 10kΩ | ProDoc_Board1v1_2026-10-26-import-fps:R0603_S | /FOC_M2/ | [('1', 'M2_MA'), ('2', 'Net-(R1084-Pad2)')]
R1085 | 10kΩ | ProDoc_Board1v1_2026-10-26-import-fps:R0603_S | /FOC_M2/ | [('1', 'M2_MB'), ('2', 'Net-(R1085-Pad2)')]
R1086 | 10kΩ | ProDoc_Board1v1_2026-10-26-import-fps:R0603_S | /FOC_M2/ | [('1', 'M2_MC'), ('2', 'Net-(R1086-Pad2)')]
R1087 | 10kΩ | ProDoc_Board1v1_2026-10-26-import-fps:R0603_S | /FOC_M2/ | [('1', 'DCBUS'), ('2', 'Net-(R1087-Pad2)')]
R1088 | 10k | ProDoc_Board1v1_2026-10-26-import-fps:R0603_S | /FOC_M2/ | [('2', 'Net-(CN1005-Pad4)'), ('1', 'Net-(R1049-Pad1)')]
R1089 | 10k | ProDoc_Board1v1_2026-10-26-import-fps:R0603_S | /FOC_M2/ | [('2', 'Net-(CN1005-Pad3)'), ('1', 'Net-(R1049-Pad1)')]
R1090 | 10k | ProDoc_Board1v1_2026-10-26-import-fps:R0603_S | /FOC_M2/ | [('2', 'Net-(CN1005-Pad2)'), ('1', 'Net-(R1049-Pad1)')]
R1091 | 10kΩ | ProDoc_Board1v1_2026-10-26-import-fps:R0603_S | /FOC_M2/ | [('2', 'M2_VA'), ('1', 'Net-(R1084-Pad2)')]
R1092 | 10kΩ | ProDoc_Board1v1_2026-10-26-import-fps:R0603_S | /FOC_M2/ | [('2', 'M2_VB'), ('1', 'Net-(R1085-Pad2)')]
R1093 | 10kΩ | ProDoc_Board1v1_2026-10-26-import-fps:R0603_S | /FOC_M2/ | [('2', 'M2_VC'), ('1', 'Net-(R1086-Pad2)')]
R1094 | 10kΩ | ProDoc_Board1v1_2026-10-26-import-fps:R0603_S | /FOC_M2/ | [('2', 'M2_VBUS'), ('1', 'Net-(R1087-Pad2)')]
R1095 | 100R | ProDoc_Board1v1_2026-10-26-import-fps:R0603_S | /FOC_M2/ | [('2', 'M2_ENC_A_IN'), ('1', 'Net-(CN1005-Pad4)')]
R1097 | 100R | ProDoc_Board1v1_2026-10-26-import-fps:R0603_S | /FOC_M2/ | [('2', 'M2_ENC_B_IN'), ('1', 'Net-(CN1005-Pad3)')]
R1098 | 100R | ProDoc_Board1v1_2026-10-26-import-fps:R0603_S | /FOC_M2/ | [('2', 'M2_ENC_C_IN'), ('1', 'Net-(CN1005-Pad2)')]
R1099 | 1kΩ | ProDoc_Board1v1_2026-10-26-import-fps:R0603_S | /FOC_M2/ | [('2', 'GND'), ('1', 'M2_VA')]
R1100 | 1kΩ | ProDoc_Board1v1_2026-10-26-import-fps:R0603_S | /FOC_M2/ | [('2', 'GND'), ('1', 'M2_VB')]
R1101 | 1kΩ | ProDoc_Board1v1_2026-10-26-import-fps:R0603_S | /FOC_M2/ | [('2', 'GND'), ('1', 'M2_VC')]
R1102 | 1kΩ | ProDoc_Board1v1_2026-10-26-import-fps:R0603_S | /FOC_M2/ | [('2', 'GND'), ('1', 'M2_VBUS')]
R1103 | 1kΩ | ProDoc_Board1v1_2026-10-26-import-fps:R0603_S | /FOC_M2/ | [('2', 'M2_PWM'), ('1', 'Net-(CN1005-Pad5)')]
R1104 | 10kΩ | ProDoc_Board1v1_2026-10-26-import-fps:R0603_S | /FOC_M2/ | [('2', 'M2_NTC'), ('1', 'VCC')]
R1105 | 1kΩ | ProDoc_Board1v1_2026-10-26-import-fps:R0603_S | /FOC_M2/ | [('2', 'GND'), ('1', 'M2_PWM')]
R1106 | 1k | ProDoc_Board1v1_2026-10-26-import-fps:R0603_S | /FOC_M2/ | [('2', 'GND'), ('1', 'M2_ENC_A_IN')]
R1107 | 1k | ProDoc_Board1v1_2026-10-26-import-fps:R0603_S | /FOC_M2/ | [('2', 'GND'), ('1', 'M2_ENC_B_IN')]
R1108 | 1k | ProDoc_Board1v1_2026-10-26-import-fps:R0603_S | /FOC_M2/ | [('2', 'GND'), ('1', 'M2_ENC_C_IN')]
R1109 | 1mΩ | Resistor_SMD:R_2512_6332Metric | /FOC_M2/ | [('1', 'M2_SHUNT_RETURN'), ('2', 'PGND')]
R1117 | 22Ω | ProDoc_Board1v1_2026-10-26-import-fps:R0603_S | /FOC_M2/ | [('1', 'Net-(CN1047-Pad5)'), ('2', 'SPI2_MOSI')]
R1118 | 22Ω | ProDoc_Board1v1_2026-10-26-import-fps:R0603_S | /FOC_M2/ | [('1', 'Net-(CN1047-Pad4)'), ('2', 'SPI2_MISO')]
R1120 | 22Ω | ProDoc_Board1v1_2026-10-26-import-fps:R0603_S | /FOC_M2/ | [('1', 'Net-(CN1047-Pad3)'), ('2', 'SPI2_SCK')]
R1121 | 22Ω | ProDoc_Board1v1_2026-10-26-import-fps:R0603_S | /FOC_M2/ | [('2', 'M2_SPI1_CS0'), ('1', 'Net-(CN1047-Pad2)')]
R1128 | 1kΩ | ProDoc_Board1v1_2026-10-26-import-fps:R0603_S | /FOC_M2/ | [('2', 'M2_COM'), ('1', 'M2_VA')]
R1129 | 1kΩ | ProDoc_Board1v1_2026-10-26-import-fps:R0603_S | /FOC_M2/ | [('1', 'M2_COM'), ('2', 'M2_VC')]
R1130 | 1kΩ | ProDoc_Board1v1_2026-10-26-import-fps:R0603_S | /FOC_M2/ | [('1', 'M2_COM'), ('2', 'M2_VB')]
R1145 | 1kΩ | ProDoc_Board1v1_2026-10-26-import-fps:R0603_S | /FOC_M2/ | [('1', 'M2_SHUNT_RETURN'), ('2', 'Net-(U1010A--INA)')]
R1146 | 20kΩ | ProDoc_Board1v1_2026-10-26-import-fps:R0603_S | /FOC_M2/ | [('2', 'Net-(U1010A--INA)'), ('1', 'Net-(U1010A-OUTA)')]
R1147 | 1kΩ | ProDoc_Board1v1_2026-10-26-import-fps:R0603_S | /FOC_M2/ | [('2', 'Net-(U1010B--INB)'), ('1', 'PGND')]
R1148 | 1kΩ | ProDoc_Board1v1_2026-10-26-import-fps:R0603_S | /FOC_M2/ | [('1', 'M2_SHUNT_RETURN'), ('2', 'Net-(U1010B-+INB)')]
R1149 | 20kΩ | ProDoc_Board1v1_2026-10-26-import-fps:R0603_S | /FOC_M2/ | [('2', 'Net-(U1010B--INB)'), ('1', 'Net-(U1010B-OUTB)')]
R1300 | 10k | Resistor_SMD:R_0603_1608Metric | /FOC_M2/ | [('2', 'GND'), ('1', 'M2_HIN1')]
R1301 | 10k | Resistor_SMD:R_0603_1608Metric | /FOC_M2/ | [('2', 'GND'), ('1', 'M2_HIN2')]
R1302 | 10k | Resistor_SMD:R_0603_1608Metric | /FOC_M2/ | [('2', 'GND'), ('1', 'M2_HIN3')]
R1303 | 10k | Resistor_SMD:R_0603_1608Metric | /FOC_M2/ | [('2', 'GND'), ('1', 'M2_LIN1')]
R1304 | 10k | Resistor_SMD:R_0603_1608Metric | /FOC_M2/ | [('2', 'GND'), ('1', 'M2_LIN2')]
R1305 | 10k | Resistor_SMD:R_0603_1608Metric | /FOC_M2/ | [('2', 'GND'), ('1', 'M2_LIN3')]
R9103 | 0R | Resistor_SMD:R_0603_1608Metric | /FOC_M2/ | [('2', 'M2_ENC_VSUP'), ('1', 'VCC')]
R9104 | 0R (5V option) | Resistor_SMD:R_0603_1608Metric | /FOC_M2/ | [('1', '5V'), ('2', 'M2_ENC_VSUP')]
U1007 | FD6288Q | ProDoc_Board1v1_2026-10-26-import-fps:QFN-24_L4.0-W4.0-P0.50-BL-EP2.6 | /FOC_M2/ | [('4', '12V'), ('25', 'GND'), ('6', 'GND'), ('22', 'M2_HIN1'), ('23', 'M2_HIN2'), ('24', 'M2_HIN3'), ('19', 'M2_HO1'), ('16', 'M2_HO2'), ('13', 'M2_HO3'), ('1', 'M2_LIN1'), ('2', 'M2_LIN2'), ('3', 'M2_LIN3'), ('11', 'M2_LO1'), ('10', 'M2_LO2'), ('9', 'M2_LO3'), ('18', 'M2_MA'), ('15', 'M2_MB'), ('12', 'M2_MC'), ('20', 'M2_VB1'), ('17', 'M2_VB2'), ('14', 'M2_VB3'), ('5', 'unconnected-(U1007-NC-Pad5)'), ('7', 'unconnected-(U1007-NC-Pad7)'), ('8', 'unconnected-(U1007-NC-Pad8)'), ('21', 'unconnected-(U1007-NC-Pad21)')]
U1010 | RS624XQ | Package_SO:TSSOP-14_4.4x5mm_P0.65mm | /FOC_M2/ | [('11', 'AGND'), ('4', 'AVCC'), ('3', 'Net-(U1010A-+INA)'), ('2', 'Net-(U1010A--INA)'), ('1', 'Net-(U1010A-OUTA)'), ('5', 'Net-(U1010B-+INB)'), ('6', 'Net-(U1010B--INB)'), ('7', 'Net-(U1010B-OUTB)'), ('10', 'Net-(U1010C-+INC)'), ('9', 'Net-(U1010C--INC)'), ('8', 'Net-(U1010C-OUTC)'), ('12', 'Net-(U1010D-+IND)'), ('13', 'Net-(U1010D--IND)'), ('14', 'Net-(U1010D-OUTD)')]
U9102 | SN74LVC3G17DCUR | Package_SO:VSSOP-8_2.3x2mm_P0.5mm | /FOC_M2/ | [('4', 'GND'), ('1', 'M2_ENC_A_IN'), ('6', 'M2_ENC_B_IN'), ('3', 'M2_ENC_C_IN'), ('7', 'M2_HALL_A'), ('2', 'M2_HALL_B'), ('5', 'M2_HALL_C'), ('8', 'VCC')]
C8064 | 4.7uF | ProDoc_IPB-TINY_2026-10-26-import-fps:C0603 | /HSL_DEBUGGER/ | [('2', 'GND'), ('1', 'Net-(U8006-VDD_OTPCAP)')]
C8065 | 100nF | ProDoc_IPB-TINY_2026-10-26-import-fps:C0603 | /HSL_DEBUGGER/ | [('2', 'GND'), ('1', 'Net-(U8006-VDD_OTPCAP)')]
C8066 | 4.7uF | ProDoc_IPB-TINY_2026-10-26-import-fps:C0603 | /HSL_DEBUGGER/ | [('2', 'GND'), ('1', 'Net-(U8006-VDD_PMCCAP)')]
C8067 | 100nF | ProDoc_IPB-TINY_2026-10-26-import-fps:C0603 | /HSL_DEBUGGER/ | [('2', 'GND'), ('1', 'Net-(U8006-VDD_PMCCAP)')]
C8068 | 100nF | ProDoc_IPB-TINY_2026-10-26-import-fps:C0603 | /HSL_DEBUGGER/ | [('1', 'GND'), ('2', 'HSL_VDD_SOC')]
C8069 | 100nF | ProDoc_IPB-TINY_2026-10-26-import-fps:C0603 | /HSL_DEBUGGER/ | [('1', 'GND'), ('2', 'HSL_VDD_SOC')]
C8070 | 100nF | ProDoc_IPB-TINY_2026-10-26-import-fps:C0603 | /HSL_DEBUGGER/ | [('1', 'GND'), ('2', 'HSL_VDD_SOC')]
C8071 | 100nF | ProDoc_IPB-TINY_2026-10-26-import-fps:C0603 | /HSL_DEBUGGER/ | [('1', 'GND'), ('2', 'HSL_VDD_SOC')]
C8072 | 100nF | ProDoc_IPB-TINY_2026-10-26-import-fps:C0603 | /HSL_DEBUGGER/ | [('1', 'GND'), ('2', 'HSL_VDD_SOC')]
C8073 | 100nF | ProDoc_IPB-TINY_2026-10-26-import-fps:C0603 | /HSL_DEBUGGER/ | [('1', 'GND'), ('2', 'HSL_LINK_3V3')]
C8074 | 100nF | ProDoc_IPB-TINY_2026-10-26-import-fps:C0603 | /HSL_DEBUGGER/ | [('1', 'GND'), ('2', 'HSL_LINK_3V3')]
C8075 | 100nF | ProDoc_IPB-TINY_2026-10-26-import-fps:C0603 | /HSL_DEBUGGER/ | [('1', 'GND'), ('2', 'HSL_LINK_3V3')]
C8076 | 100nF | ProDoc_IPB-TINY_2026-10-26-import-fps:C0603 | /HSL_DEBUGGER/ | [('1', 'GND'), ('2', 'HSL_LINK_3V3')]
C8077 | 100nF | ProDoc_IPB-TINY_2026-10-26-import-fps:C0603 | /HSL_DEBUGGER/ | [('1', 'GND'), ('2', 'HSL_LINK_3V3')]
C8078 | 10uF | ProDoc_IPB-TINY_2026-10-26-import-fps:C0603 | /HSL_DEBUGGER/ | [('2', 'GND'), ('1', 'HSL_LINK_3V3')]
C8079 | 100nF | ProDoc_IPB-TINY_2026-10-26-import-fps:C0603 | /HSL_DEBUGGER/ | [('1', 'GND'), ('2', 'HSL_LINK_3V3')]
C8080 | 15pF | ProDoc_IPB-TINY_2026-10-26-import-fps:C0603 | /HSL_DEBUGGER/ | [('1', 'GND'), ('2', 'Net-(U8006-XTALI)')]
C8081 | 15pF | ProDoc_IPB-TINY_2026-10-26-import-fps:C0603 | /HSL_DEBUGGER/ | [('1', 'GND'), ('2', 'Net-(U8006-XTALO)')]
C8082 | 22uF | ProDoc_IPB-TINY_2026-10-26-import-fps:C0603 | /HSL_DEBUGGER/ | [('2', 'GND'), ('1', 'HSL_VDD_SOC')]
C8083 | 22uF | ProDoc_IPB-TINY_2026-10-26-import-fps:C0603 | /HSL_DEBUGGER/ | [('2', 'GND'), ('1', 'HSL_VDD_SOC')]
C8084 | 10uF | ProDoc_IPB-TINY_2026-10-26-import-fps:C0603 | /HSL_DEBUGGER/ | [('2', 'GND'), ('1', 'HSL_VDD_SOC')]
C8085 | 100nF | ProDoc_IPB-TINY_2026-10-26-import-fps:C0603 | /HSL_DEBUGGER/ | [('1', 'GND'), ('2', 'HSL_VDD_SOC')]
C8086 | 100nF | ProDoc_IPB-TINY_2026-10-26-import-fps:C0603 | /HSL_DEBUGGER/ | [('1', 'GND'), ('2', 'Net-(U8006-RESETN)')]
C8087 | 1nF | ProDoc_IPB-TINY_2026-10-26-import-fps:C0603 | /HSL_DEBUGGER/ | [('1', 'GND'), ('2', 'HSL_SHIELD')]
D8005 | PRTR5V0U2X_C5158049 | ProDoc_IPB-TINY_2026-10-26-import-fps:SOT-143_L2.9-W1.3-P1.92-LS2.3-BL | /HSL_DEBUGGER/ | [('1', 'GND'), ('3', 'HSL_LINK_DN'), ('2', 'HSL_LINK_DP'), ('4', 'HSL_USB_VBUS')]
H8001 | DZ127S-22-10-55 | ProDoc_IPB-TINY_2026-10-26-import-fps:HDR-SMD_10P-P1.27-V-M-R2-C5-S1.27-LS5.5 | /HSL_DEBUGGER/ | [('3', 'GND'), ('5', 'GND'), ('4', 'HSL_JTAG_TCK'), ('8', 'HSL_JTAG_TDI'), ('6', 'HSL_JTAG_TDO'), ('2', 'HSL_JTAG_TMS'), ('10', 'HSL_JTAG_TRST'), ('1', 'VCC'), ('7', 'unconnected-(H8001-Pad7)'), ('9', 'unconnected-(H8001-Pad9)')]
R8052 | 0R | ProDoc_IPB-TINY_2026-10-26-import-fps:R0603 | /HSL_DEBUGGER/ | [('1', 'HSL_LINK_3V3'), ('2', 'VCC')]
R8053 | 10K | ProDoc_IPB-TINY_2026-10-26-import-fps:R0603 | /HSL_DEBUGGER/ | [('2', 'GND'), ('1', 'Net-(U8006-PA02)')]
R8054 | 1M | ProDoc_IPB-TINY_2026-10-26-import-fps:R0603 | /HSL_DEBUGGER/ | [('2', 'Net-(U8006-XTALI)'), ('1', 'Net-(U8006-XTALO)')]
R8055 | 10K | ProDoc_IPB-TINY_2026-10-26-import-fps:R0603 | /HSL_DEBUGGER/ | [('2', 'GND'), ('1', 'HSL_ISP_KEY')]
R8056 | 5.1K | ProDoc_IPB-TINY_2026-10-26-import-fps:R0603 | /HSL_DEBUGGER/ | [('1', 'GND'), ('2', 'Net-(USB8002-CC1)')]
R8057 | 5.1K | ProDoc_IPB-TINY_2026-10-26-import-fps:R0603 | /HSL_DEBUGGER/ | [('1', 'GND'), ('2', 'Net-(USB8002-CC2)')]
R8058 | 10K | ProDoc_IPB-TINY_2026-10-26-import-fps:R0603 | /HSL_DEBUGGER/ | [('1', 'HSL_LINK_3V3'), ('2', 'Net-(U8006-RESETN)')]
R8059 | 22R | ProDoc_IPB-TINY_2026-10-26-import-fps:R0603 | /HSL_DEBUGGER/ | [('1', 'HSL_LINK_TMS'), ('2', 'Net-(U8006-PA28)')]
R8060 | 1M | ProDoc_IPB-TINY_2026-10-26-import-fps:R0603 | /HSL_DEBUGGER/ | [('2', 'GND'), ('1', 'HSL_SHIELD')]
R8061 | 10K | ProDoc_IPB-TINY_2026-10-26-import-fps:R0603 | /HSL_DEBUGGER/ | [('1', 'HSL_LINK_3V3'), ('2', 'HSL_LINK_UART_RX')]
R8062 | 10K | ProDoc_IPB-TINY_2026-10-26-import-fps:R0603 | /HSL_DEBUGGER/ | [('1', 'HSL_LINK_3V3'), ('2', 'HSL_LINK_UART_TX')]
R8063 | 22R | ProDoc_IPB-TINY_2026-10-26-import-fps:R0603 | /HSL_DEBUGGER/ | [('2', 'HSL_JTAG_TDO'), ('1', 'HSL_LINK_TDO')]
R8064 | 22R | ProDoc_IPB-TINY_2026-10-26-import-fps:R0603 | /HSL_DEBUGGER/ | [('2', 'HSL_JTAG_TDI'), ('1', 'HSL_LINK_TDI')]
R8065 | 22R | ProDoc_IPB-TINY_2026-10-26-import-fps:R0603 | /HSL_DEBUGGER/ | [('2', 'HSL_JTAG_TCK'), ('1', 'HSL_LINK_TCK')]
R8066 | 22R | ProDoc_IPB-TINY_2026-10-26-import-fps:R0603 | /HSL_DEBUGGER/ | [('2', 'HSL_JTAG_TMS'), ('1', 'HSL_LINK_TMS')]
R8067 | 22R | ProDoc_IPB-TINY_2026-10-26-import-fps:R0603 | /HSL_DEBUGGER/ | [('1', 'HSL_LINK_UART_RX'), ('2', 'HSL_PA00_UART0_TXD')]
R8068 | 22R | ProDoc_IPB-TINY_2026-10-26-import-fps:R0603 | /HSL_DEBUGGER/ | [('2', 'HSL_JTAG_TRST'), ('1', 'HSL_LINK_TRST')]
R8069 | 22R | ProDoc_IPB-TINY_2026-10-26-import-fps:R0603 | /HSL_DEBUGGER/ | [('1', 'HSL_LINK_UART_TX'), ('2', 'HSL_PA01_UART0_RXD')]
R8070 | 22R | ProDoc_IPB-TINY_2026-10-26-import-fps:R0603 | /HSL_DEBUGGER/ | [('2', 'HSL_D_RESETN'), ('1', 'HSL_LINK_SRST')]
R8071 | 10K | ProDoc_IPB-TINY_2026-10-26-import-fps:R0603 | /HSL_DEBUGGER/ | [('2', 'HSL_JTAG_TMS'), ('1', 'VCC')]
R8072 | 10K | ProDoc_IPB-TINY_2026-10-26-import-fps:R0603 | /HSL_DEBUGGER/ | [('2', 'HSL_JTAG_TDI'), ('1', 'VCC')]
R8073 | 10K | ProDoc_IPB-TINY_2026-10-26-import-fps:R0603 | /HSL_DEBUGGER/ | [('2', 'GND'), ('1', 'HSL_JTAG_TCK')]
R8901 | 0R DNP / CLOSE TO ENABLE | ProDoc_IPB-TINY_2026-10-26-import-fps:R0603 | /HSL_DEBUGGER/ | [('1', 'HSL_JTAG_TMS'), ('2', 'SWDIO')]
R8902 | 0R DNP / CLOSE TO ENABLE | ProDoc_IPB-TINY_2026-10-26-import-fps:R0603 | /HSL_DEBUGGER/ | [('1', 'HSL_JTAG_TCK'), ('2', 'SWCLK')]
R8903 | 0R DNP / CLOSE TO ENABLE | ProDoc_IPB-TINY_2026-10-26-import-fps:R0603 | /HSL_DEBUGGER/ | [('1', 'HSL_D_RESETN'), ('2', 'NRST')]
R8904 | 0R DNP / CLOSE TO ENABLE | ProDoc_IPB-TINY_2026-10-26-import-fps:R0603 | /HSL_DEBUGGER/ | [('1', 'HSL_PA00_UART0_TXD'), ('2', 'HSL_TARGET_UART_TX')]
R8905 | 0R DNP / CLOSE TO ENABLE | ProDoc_IPB-TINY_2026-10-26-import-fps:R0603 | /HSL_DEBUGGER/ | [('1', 'HSL_PA01_UART0_RXD'), ('2', 'HSL_TARGET_UART_RX')]
SW8005 | TS-1088-AR02016 | ProDoc_IPB-TINY_2026-10-26-import-fps:SW-SMD_L3.9-W3.0-P4.45 | /HSL_DEBUGGER/ | [('2', 'HSL_ISP_KEY'), ('1', 'HSL_LINK_3V3')]
U8006 | HPM5301IEG1 | ProDoc_IPB-TINY_2026-10-26-import-fps:QFN-48_L6.0-W6.0-P0.40-TL-EP4.2 | /HSL_DEBUGGER/ | [('30', 'GND'), ('49', 'GND'), ('7', 'HSL_ISP_KEY'), ('11', 'HSL_ISP_RX'), ('12', 'HSL_ISP_TX'), ('16', 'HSL_LINK_3V3'), ('29', 'HSL_LINK_3V3'), ('31', 'HSL_LINK_3V3'), ('32', 'HSL_LINK_3V3'), ('34', 'HSL_LINK_3V3'), ('6', 'HSL_LINK_3V3'), ('43', 'HSL_LINK_DN'), ('44', 'HSL_LINK_DP'), ('20', 'HSL_LINK_SRST'), ('24', 'HSL_LINK_TCK'), ('41', 'HSL_LINK_TCK'), ('22', 'HSL_LINK_TDI'), ('23', 'HSL_LINK_TDO'), ('39', 'HSL_LINK_TMS'), ('21', 'HSL_LINK_TRST'), ('3', 'HSL_LINK_UART_RX'), ('2', 'HSL_LINK_UART_TX'), ('28', 'HSL_VDD_SOC'), ('33', 'HSL_VDD_SOC'), ('45', 'HSL_VDD_SOC'), ('5', 'HSL_VDD_SOC'), ('9', 'HSL_VDD_SOC'), ('15', 'Net-(U8006-DCDC_LP)'), ('8', 'Net-(U8006-PA02)'), ('25', 'Net-(U8006-PA26)'), ('42', 'Net-(U8006-PA26)'), ('40', 'Net-(U8006-PA28)'), ('13', 'Net-(U8006-RESETN)'), ('10', 'Net-(U8006-VDD_OTPCAP)'), ('17', 'Net-(U8006-VDD_PMCCAP)'), ('35', 'Net-(U8006-XTALI)'), ('36', 'Net-(U8006-XTALO)'), ('1', 'unconnected-(U8006-PA04-Pad1)'), ('48', 'unconnected-(U8006-PA05-Pad48)'), ('47', 'unconnected-(U8006-PA06-Pad47)'), ('46', 'unconnected-(U8006-PA07-Pad46)'), ('4', 'unconnected-(U8006-PA10-Pad4)'), ('38', 'unconnected-(U8006-PA30-Pad38)'), ('37', 'unconnected-(U8006-PA31-Pad37)'), ('27', 'unconnected-(U8006-PB08-Pad27)'), ('26', 'unconnected-(U8006-PB09-Pad26)'), ('19', 'unconnected-(U8006-PY00-Pad19)'), ('18', 'unconnected-(U8006-PY01-Pad18)'), ('14', 'unconnected-(U8006-WAKEUP-Pad14)')]
U8007 | 4.7uH | ProDoc_IPB-TINY_2026-10-26-import-fps:IND-SMD_L2.5-W2.0-VLS252012CX-150M | /HSL_DEBUGGER/ | [('1', 'HSL_VDD_SOC'), ('2', 'Net-(U8006-DCDC_LP)')]
USB8002 | TYPE-C 16PIN 2MD(073) | ProDoc_IPB-TINY_2026-10-26-import-fps:USB-C-SMD_TYPE-C-6PIN-2MD-073 | /HSL_DEBUGGER/ | [('1', 'GND'), ('12', 'GND'), ('5', 'HSL_LINK_DN'), ('7', 'HSL_LINK_DN'), ('6', 'HSL_LINK_DP'), ('8', 'HSL_LINK_DP'), ('13', 'HSL_SHIELD'), ('14', 'HSL_SHIELD'), ('11', 'HSL_USB_VBUS'), ('2', 'HSL_USB_VBUS'), ('4', 'Net-(USB8002-CC1)'), ('10', 'Net-(USB8002-CC2)'), ('9', 'unconnected-(USB8002-SBU1-Pad9)'), ('3', 'unconnected-(USB8002-SBU2-Pad3)')]
X8002 | 24MHz | ProDoc_IPB-TINY_2026-10-26-import-fps:CRYSTAL-SMD_4P-L2.0-W1.6-BL-A | /HSL_DEBUGGER/ | [('2', 'GND'), ('4', 'GND'), ('1', 'Net-(U8006-XTALI)'), ('3', 'Net-(U8006-XTALO)')]
C302 | 100nF | Interface:C_0603_1608Metric | /INTERFACE/ | [('1', 'BTN_1_N'), ('2', 'GND')]
C303 | 100nF | Interface:C_0603_1608Metric | /INTERFACE/ | [('1', 'BTN_2_N'), ('2', 'GND')]
C304 | 100nF | Interface:C_0603_1608Metric | /INTERFACE/ | [('1', 'BTN_3_N'), ('2', 'GND')]
C320 | 1uF | Interface:c0402-无丝印-全尺寸_2 | /INTERFACE/ | [('1', 'OLED_N4'), ('2', 'OLED_N5')]
C321 | 1uF | Interface:c0402-无丝印-全尺寸_2 | /INTERFACE/ | [('1', 'OLED_N6'), ('2', 'OLED_N7')]
C322 | 4.7uF | Interface:c0402-无丝印-全尺寸_2 | /INTERFACE/ | [('2', 'GND'), ('1', 'OLED_N8')]
C323 | 100nF | Interface:c0402-无丝印-全尺寸_2 | /INTERFACE/ | [('1', 'GND'), ('2', 'OLED_N8')]
C324 | 2.2uF | Interface:c0402-无丝印-全尺寸_2 | /INTERFACE/ | [('1', 'GND'), ('2', 'OLED_N9')]
C325 | 4.7uF | Interface:c0402-无丝印-全尺寸_2 | /INTERFACE/ | [('1', 'GND'), ('2', 'OLED_N10')]
D300 | 1N4148WS | ProDoc_Board1v1_2026-10-26-import-fps:SOD-323_L1.8-W1.3-LS2.5-RD | /INTERFACE/ | [('2', 'OLED_N10'), ('1', 'VCC')]
FPC300 | AFC07-S16ECA-00 | Interface:FPC-SMD_16P-P0.50_AFC07-S16ECA-00 | /INTERFACE/ | [('11', 'GND'), ('12', 'GND'), ('17', 'GND'), ('18', 'GND'), ('9', 'GND'), ('1', 'OLED_N4'), ('2', 'OLED_N5'), ('3', 'OLED_N6'), ('4', 'OLED_N7'), ('6', 'OLED_N8'), ('7', 'OLED_N9'), ('13', 'OLED_N10'), ('8', 'OLED_N11'), ('10', 'OLED_N12'), ('15', 'OLED_SCL'), ('16', 'OLED_SDA'), ('14', 'VCC'), ('5', 'VCC')]
R314 | 1k | Interface:R_0603_1608Metric | /INTERFACE/ | [('2', 'BTN_1_N'), ('1', 'BTN_1_SW')]
R315 | 10k | Interface:R_0603_1608Metric | /INTERFACE/ | [('2', 'BTN_1_N'), ('1', 'VCC')]
R316 | 1k | Interface:R_0603_1608Metric | /INTERFACE/ | [('2', 'BTN_2_N'), ('1', 'BTN_2_SW')]
R317 | 10k | Interface:R_0603_1608Metric | /INTERFACE/ | [('2', 'BTN_2_N'), ('1', 'VCC')]
R318 | 1k | Interface:R_0603_1608Metric | /INTERFACE/ | [('2', 'BTN_3_N'), ('1', 'BTN_3_SW')]
R319 | 10k | Interface:R_0603_1608Metric | /INTERFACE/ | [('2', 'BTN_3_N'), ('1', 'VCC')]
R320 | 390K | Interface:r0402-无丝印-全尺寸_1 | /INTERFACE/ | [('1', 'GND'), ('2', 'OLED_N11')]
R321 | 4.7K | Interface:r0402-无丝印-全尺寸_1 | /INTERFACE/ | [('2', 'OLED_N12'), ('1', 'VCC')]
R322 | 4.7K | Interface:r0402-无丝印-全尺寸_1 | /INTERFACE/ | [('1', 'OLED_N10'), ('2', 'VCC')]
R323 | 4.7K | Interface:r0402-无丝印-全尺寸_1 | /INTERFACE/ | [('2', 'OLED_SCL'), ('1', 'VCC')]
R324 | 4.7K | Interface:r0402-无丝印-全尺寸_1 | /INTERFACE/ | [('2', 'OLED_SDA'), ('1', 'VCC')]
SW300 | PTS815SJK250SMTRLFS | ProDoc_Board1v1_2026-10-26-import-fps:SW-SMD_4P-L4.2-W3.3-P2.15-LS5.1 | /INTERFACE/ | [('4', 'BTN_1_SW'), ('1', 'GND'), ('2', 'unconnected-(SW300-Pad2)'), ('3', 'unconnected-(SW300-Pad3)')]
SW301 | PTS815SJK250SMTRLFS | ProDoc_Board1v1_2026-10-26-import-fps:SW-SMD_4P-L4.2-W3.3-P2.15-LS5.1 | /INTERFACE/ | [('4', 'BTN_2_SW'), ('1', 'GND'), ('2', 'unconnected-(SW301-Pad2)'), ('3', 'unconnected-(SW301-Pad3)')]
SW302 | PTS815SJK250SMTRLFS | ProDoc_Board1v1_2026-10-26-import-fps:SW-SMD_4P-L4.2-W3.3-P2.15-LS5.1 | /INTERFACE/ | [('4', 'BTN_3_SW'), ('1', 'GND'), ('2', 'unconnected-(SW302-Pad2)'), ('3', 'unconnected-(SW302-Pad3)')]
