CYFS3/GD32FOC/.layout-review/reference-testpoint-audit.md

# 参考FOC测试点只读审计

本轮直接解析参考原PCB、原理图及其实际封装库，并解析当前PCB/六页原理图；没有接入IPC或修改任何电路、封装库、PCB。映射索引来自foc-reuse-map.json，但几何结论独立来自源文件。

## 结论

用户指出测试点不对有直接证据支持。先前把所有5012属性符号统一换成官方Keystone通孔机械封装，是一种依据采购型号的设计选择，**不是参考PCB的真实几何复刻**。该选择把参考直径1.27mm焊盘变成直径2.8mm、钻孔1.6mm、装配圆直径4mm的通孔端子，引发了后来多处避让和背面冲突。

但原始参考本身也存在属性矛盾：原理图是Value/Manufacturer Part=5012、Manufacturer=Keystone、Supplier Part=C2906766，Footprint指向不存在的中文“测试点”；实际PCB/库使用另一个 `TESTPOINT-TH_BD2.0_C9900010656`。实际库名含TH、Fab圆和User.1约1mm孔状多边形，drill却仅0.001mm。因此**不能证明原作者有意采用无孔表贴测试铜点**，也不能把0.001mm当作可制造机械钻孔。

按用户要求纠正并恢复参考小焊盘布局，合理方案是明确采用“直径1.27mm裸铜测试点”作为当前设计功能：保留源焊盘中心与大小，单面F.Cu/F.Mask，无钻孔、无F.Paste、不装机械端子。同步Value改为TestPoint，清除Keystone/5012/C2906766/相关采购和Datasheet身份及5012机械3D模型，设置不进入采购BOM。它是解决源属性矛盾的明确设计选择，不是宣称源文件已经证明为SMD。

若实际仍要求购买安装Keystone 5012端子，应保留匹配厂商机械的通孔模型与空间，接受布局不能等同参考小焊盘。不能同时保留5012采购身份又声称为裸铜测试点。

## 数量与几何

参考原理图有47个5012实例；PCB中43个存在，CN46/CN48/CN52/CN53无对应PCB实例。43个全部同一实际库型号，无按不同ref区分的尺寸变体。

|项|参考实际PCB与库|当前52个测试点|
|---|---|---|
|实际模型|TESTPOINT-TH_BD2.0_C9900010656|官方TestPoint_Keystone_5010-5014_Multipurpose几何|
|当前/源库ID|ProDoc_1.axdr_v1.3_2026-10-31-import-fps:TESTPOINT-TH_BD2.0_C9900010656|ProDoc_Board1v1_2026-10-26-import-fps:测试点（名字未反映实际几何）|
|Pad|单个1号圆形1.27×1.27mm|单个1号圆形2.8×2.8mm|
|类型/孔|thru_hole，0.001mm，*.Cu/*.Mask|thru_hole，1.6mm，*.Cu/*.Mask|
|Courtyard|方框±1.0375mm，线宽0.05|圆半径2mm，线宽0.05|
|Silk轮廓|无，仅隐藏Reference文字|圆半径1.75mm，线宽0.12|
|Fab|约半径0.762mm圆弧|圆半径1.6mm及2.5×0.8mm矩形|
|附加|User.1近似直径1mm圆多边形|Keystone 5010–5014 STEP模型|
|板上Value|空，不能据此证明无采购部件|5012|

源几何证据：参考PCB CN20位于原文件46414起，pad在46550；参考库TESTPOINT-TH_BD2.0_C9900010656.kicad_mod第53–143行；原理图CN20第31028–31107行。当前库中文测试点.kicad_mod第58–132行。

## 全部52个当前大通孔范围

M1 22项：CN14、CN15、CN17、CN18、CN19、CN20、CN21、CN22、CN23、CN24、CN25、CN26、CN27、CN28、CN29、CN30、CN35、CN36、CN37、CN38、CN39、CN40。

M2 22项：上述数值+1000，即CN1014、CN1015、CN1017、CN1018、CN1019、CN1020、CN1021、CN1022、CN1023、CN1024、CN1025、CN1026、CN1027、CN1028、CN1029、CN1030、CN1035、CN1036、CN1037、CN1038、CN1039、CN1040。

共享8项：CN2、CN3、CN4、CN6、CN7、CN9、CN13、CN16。

新增NRST TP200为另一个直径1.5mm裸铜测试点，不属于这52个，不应随本次替换误改。

## 映射

模块内22项采用foc-reuse-map中的同源参考位号配对，JSON逐项附源实际位置、层、pad/网络与当前状态。

|参考|当前共享|网络/证据|
|---|---|---|
|CN5|CN2|VCC|
|CN6|CN3|GND|
|CN8|CN6|AVCC|
|CN2|CN9|DCBUS|
|CN4|CN4|12V|
|CN7|CN7|5V|
|CN13|CN13|VREF|
|CN16|CN16|匿名网络，仅共同R57.2；完整邻居不同，位置对应尚未验证|

CN16源网络邻居为CN16.1/R46.1/R54.1/R57.2，当前为CN16.1/C79.2/R48.1/R57.2/U12.1；不能仅同位号套源坐标，需结合电源子电路修订核实。其测试点几何可按同一裸铜功能修正，但位置映射由后续电源审计确定。

源43中未复用的其它测试点均在JSON逐项保留空映射；不擅自在当前增加它们。7个共享已核命名网络、44个模块测试点及1个共享匿名候选，共52项全部列出。

## 建议实施边界

1. 若按参考裸铜功能修正，52项都使用统一参考直径1.27mm的新本地模型，所有pin1网络保持；无孔，不复制无意义0.001mm孔或User.1孔图形为真实孔。
2. 裸铜点不需贴片焊膏。Courtyard可以保留源2.075mm方框用于探针空间，但这是参考空间而非5012机械壳体；恢复铜尺寸不意味着所有courtyard告警自动消失。
3. 模块测试点恢复源相对坐标，撤销因大5012而引入的测试点避让。变更5→6pin接口CN5的差异仍独立存在，不能一起撤销。
4. 电源输入+驱动整体源布局的坐标复刻应包括已核共享电源器件，不仅此前M1/M2页；第二路保持在第一路正下方。
5. 以上为审计建议，尚未改原理图/库/PCB。报告与JSON保留源完整属性，以便后续修复有据可查。
