CYFS3/GD32FOC/label_alignment/verification.txt

NETLIST EQUIVALENT 288 nets 488 components
CHANGES {'MCU': 44, 'HSLink': 0, 'FOC_M1': 54, 'FOC_M2': 54, 'power': 1}
1 1 2 3 4 5 6 7 8 1 2 3 4 5 6 7 8 A B C D E F A B C D E F Date:  KiCad E
5 1 2 3 4 5 6 7 8 9 10 11 1 2 3 4 5 6 7 8 9 10 11 A B C D E F G H A B C 
3 1 2 3 4 5 6 7 8 9 10 11 1 2 3 4 5 6 7 8 9 10 11 A B C D E F G H A B C 
4 1 2 3 4 5 6 7 8 9 10 11 1 2 3 4 5 6 7 8 9 10 11 A B C D E F G H A B C 
2 1 2 3 4 5 6 7 8 9 10 11 1 2 3 4 5 6 7 8 9 10 11 A B C D E F G H A B C 
geometry 268 wrongside 0 collisions [{'page': 'FOC_M1', 'name': 'M1_SHUNT_RETURN', 'x': 64.80000000000001, 'y': 619.2, 'angle': 180.0, 'bbox': [-4.510998725891113, 616.8815307617188, 59.00725555419922, 622.911376953125], 'outward': True, 'collisions': ['R67']}, {'page': 'FOC_M1', 'name': 'M1_SHUNT_RETURN', 'x': 280.8, 'y': 619.2, 'angle': 180.0, 'bbox': [211.48899841308594, 616.8815307617188, 275.0072326660156, 622.911376953125], 'outward': True, 'collisions': ['R68']}, {'page': 'FOC_M1', 'name': 'M1_IA+', 'x': 64.80000000000001, 'y': 633.6000000000001, 'angle': 180.0, 'bbox': [34.81432342529297, 631.281494140625, 59.03599166870117, 637.3113403320312], 'outward': True, 'collisions': ['R69']}, {'page': 'FOC_M1', 'name': 'M1_IB+', 'x': 280.8, 'y': 633.6000000000001, 'angle': 180.0, 'bbox': [250.176513671875, 631.281494140625, 275.0365295410156, 637.3113403320312], 'outward': True, 'collisions': ['R72']}, {'page': 'FOC_M1', 'name': 'M1_IC+', 'x': 277.20000000000005, 'y': 496.8, 'angle': 180.0, 'bbox': [246.57650756835938, 494.48150634765625, 271.4365234375, 500.5113525390625], 'outward': True, 'collisions': ['R52']}, {'page': 'FOC_M1', 'name': 'M1_SHUNT_RETURN', 'x': 277.20000000000005, 'y': 482.4000000000001, 'angle': 180.0, 'bbox': [207.8889923095703, 480.08148193359375, 271.4072265625, 486.111328125], 'outward': True, 'collisions': ['R145']}, {'page': 'FOC_M1', 'name': 'M1_SHUNT_RETURN', 'x': 64.80000000000001, 'y': 496.8, 'angle': 180.0, 'bbox': [-4.510998725891113, 494.48150634765625, 59.00725555419922, 500.5113525390625], 'outward': True, 'collisions': ['R148', 'R148']}, {'page': 'FOC_M2', 'name': 'M2_SHUNT_RETURN', 'x': 277.20000000000005, 'y': 482.4000000000001, 'angle': 180.0, 'bbox': [207.8889923095703, 480.08148193359375, 271.4072265625, 486.111328125], 'outward': True, 'collisions': ['R1145']}, {'page': 'FOC_M2', 'name': 'M2_SHUNT_RETURN', 'x': 64.80000000000001, 'y': 619.2, 'angle': 180.0, 'bbox': [-4.510998725891113, 616.8815307617188, 59.00725555419922, 622.911376953125], 'outward': True, 'collisions': ['R1067']}, {'page': 'FOC_M2', 'name': 'M2_IA+', 'x': 64.80000000000001, 'y': 633.6000000000001, 'angle': 180.0, 'bbox': [34.81432342529297, 631.281494140625, 59.03599166870117, 637.3113403320312], 'outward': True, 'collisions': ['R1069']}, {'page': 'FOC_M2', 'name': 'M2_IC+', 'x': 277.20000000000005, 'y': 496.8, 'angle': 180.0, 'bbox': [246.57650756835938, 494.48150634765625, 271.4365234375, 500.5113525390625], 'outward': True, 'collisions': ['R1052']}, {'page': 'FOC_M2', 'name': 'M2_IB+', 'x': 280.8, 'y': 633.6000000000001, 'angle': 180.0, 'bbox': [250.176513671875, 631.281494140625, 275.0365295410156, 637.3113403320312], 'outward': True, 'collisions': ['R1072']}, {'page': 'FOC_M2', 'name': 'M2_SHUNT_RETURN', 'x': 280.8, 'y': 619.2, 'angle': 180.0, 'bbox': [211.48899841308594, 616.8815307617188, 275.0072326660156, 622.911376953125], 'outward': True, 'collisions': ['R1068']}, {'page': 'FOC_M2', 'name': 'M2_SHUNT_RETURN', 'x': 64.80000000000001, 'y': 496.8, 'angle': 180.0, 'bbox': [-4.510998725891113, 494.48150634765625, 59.00725555419922, 500.5113525390625], 'outward': True, 'collisions': ['R1148', 'R1148']}]
