CYFS3/GD32FOC/u7_label_fix/FOC_M1.pdf

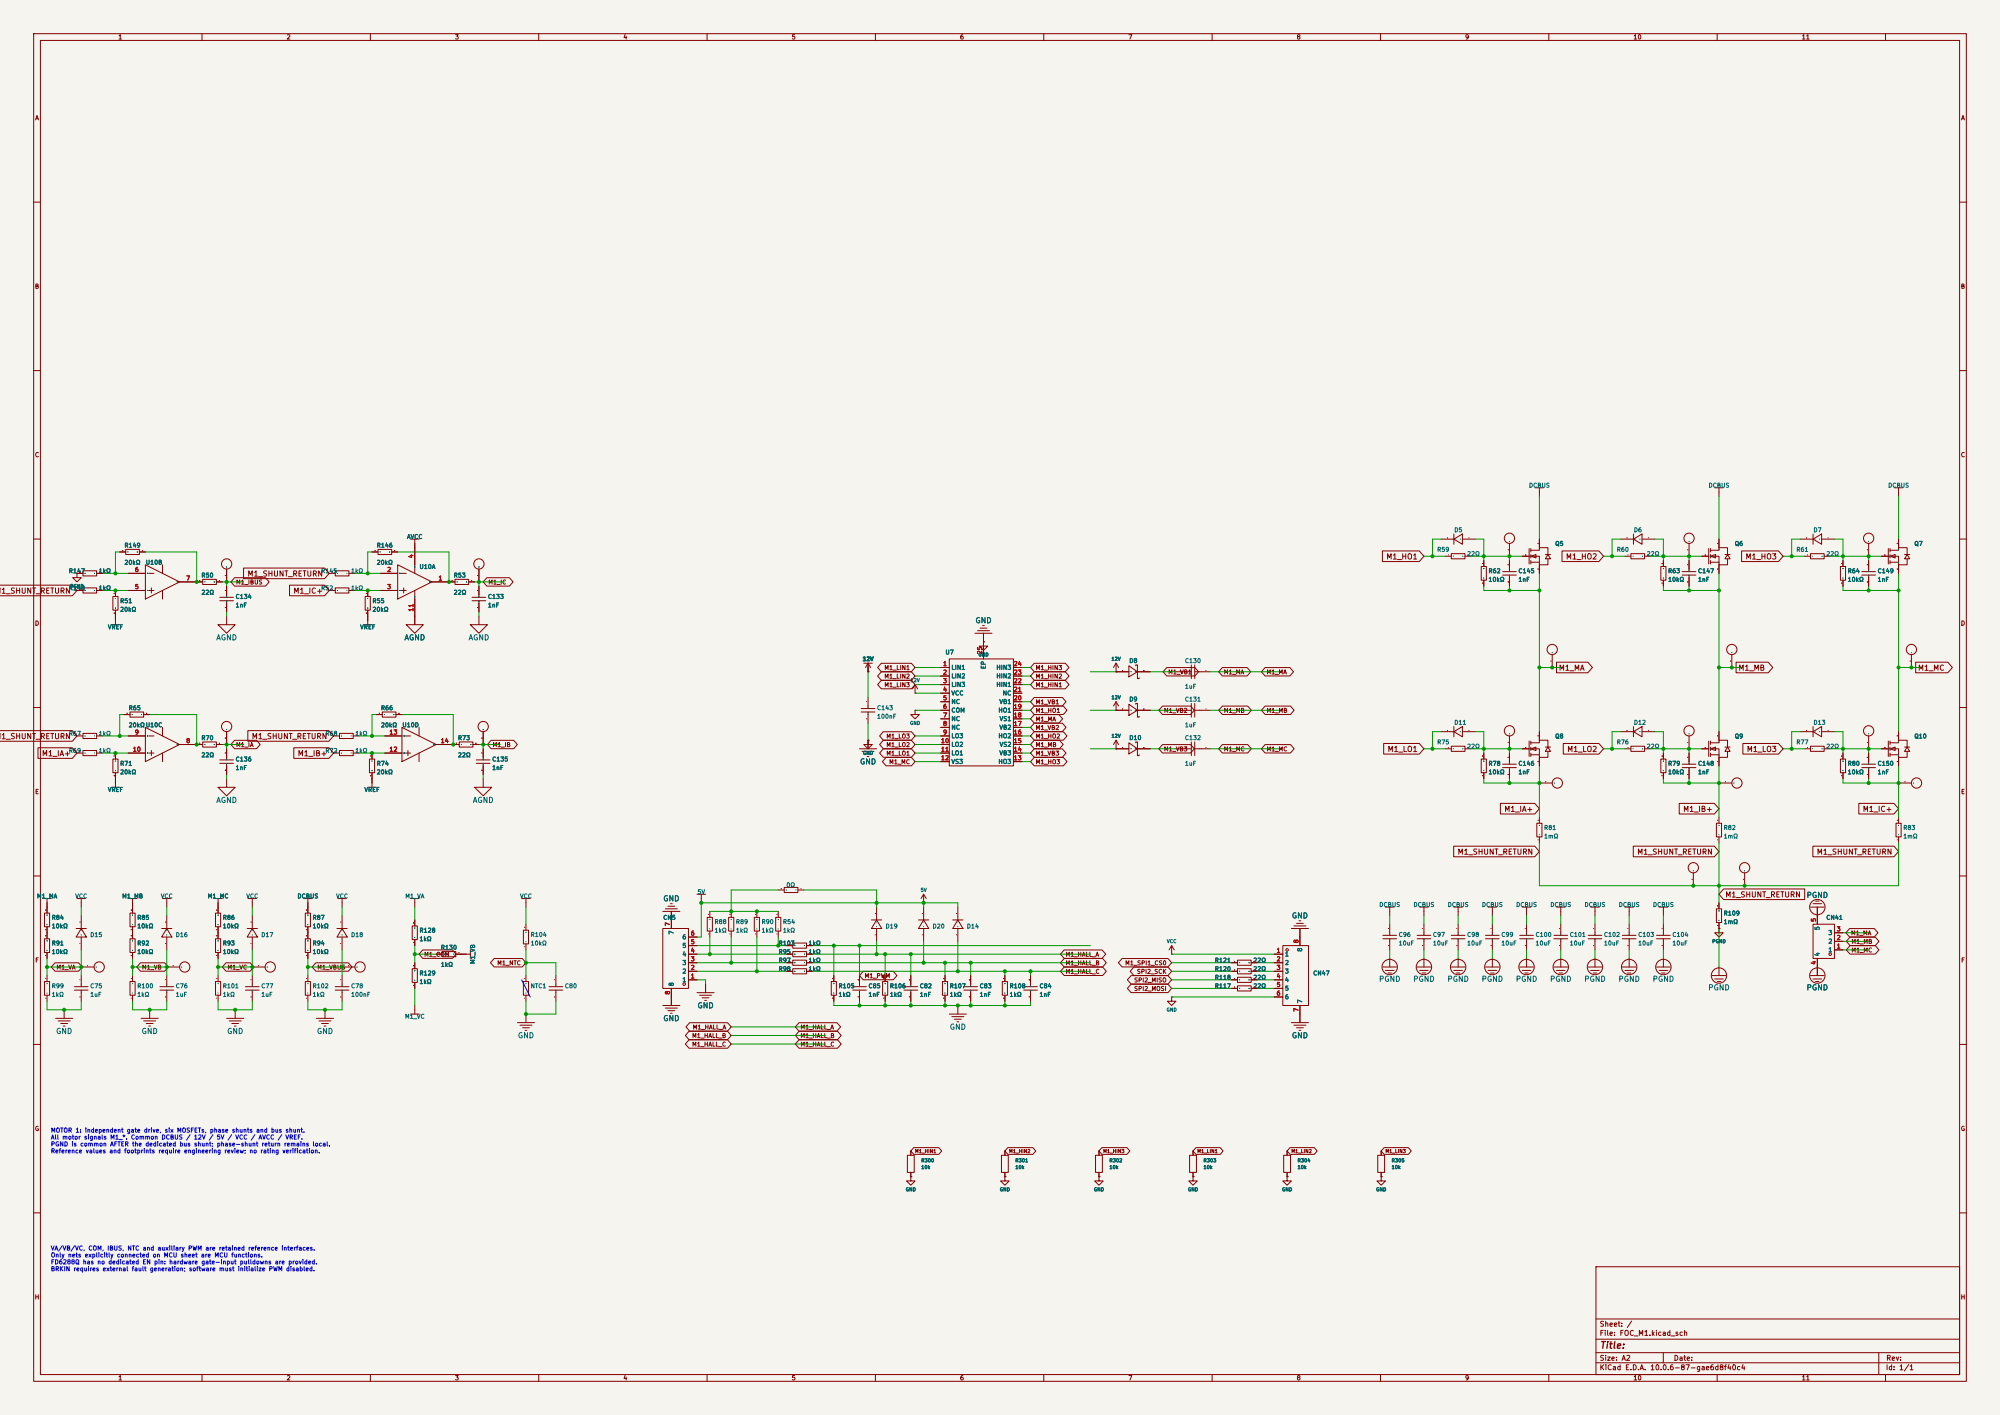
[picture p14: page 1]

VA/VB/VC, COM, IBUS, NTC and auxiliary PWM are retained reference interfaces. Only nets explicitly connected on MCU sheet are MCU functions. FD6288Q has no dedicated EN pin: hardware gate-input pulldowns are provided. BRKIN requires external fault generation; software must initialize PWM disabled. MOTOR 1: independent gate drive, six MOSFETs, phase shunts and bus shunt. All motor signals M1_*. Common DCBUS / 12V / 5V / VCC / AVCC / VREF. PGND is common AFTER the dedicated bus shunt; phase-shunt return remains local. Reference values and footprints require engineering review; no rating verification.

Size: A2 | Rev:
KiCad E.D.A. 10.0.6-87-gae6d8f40c4 | Id: 1/1
