CYFS3/GD32FOC/migrated_foc.pdf

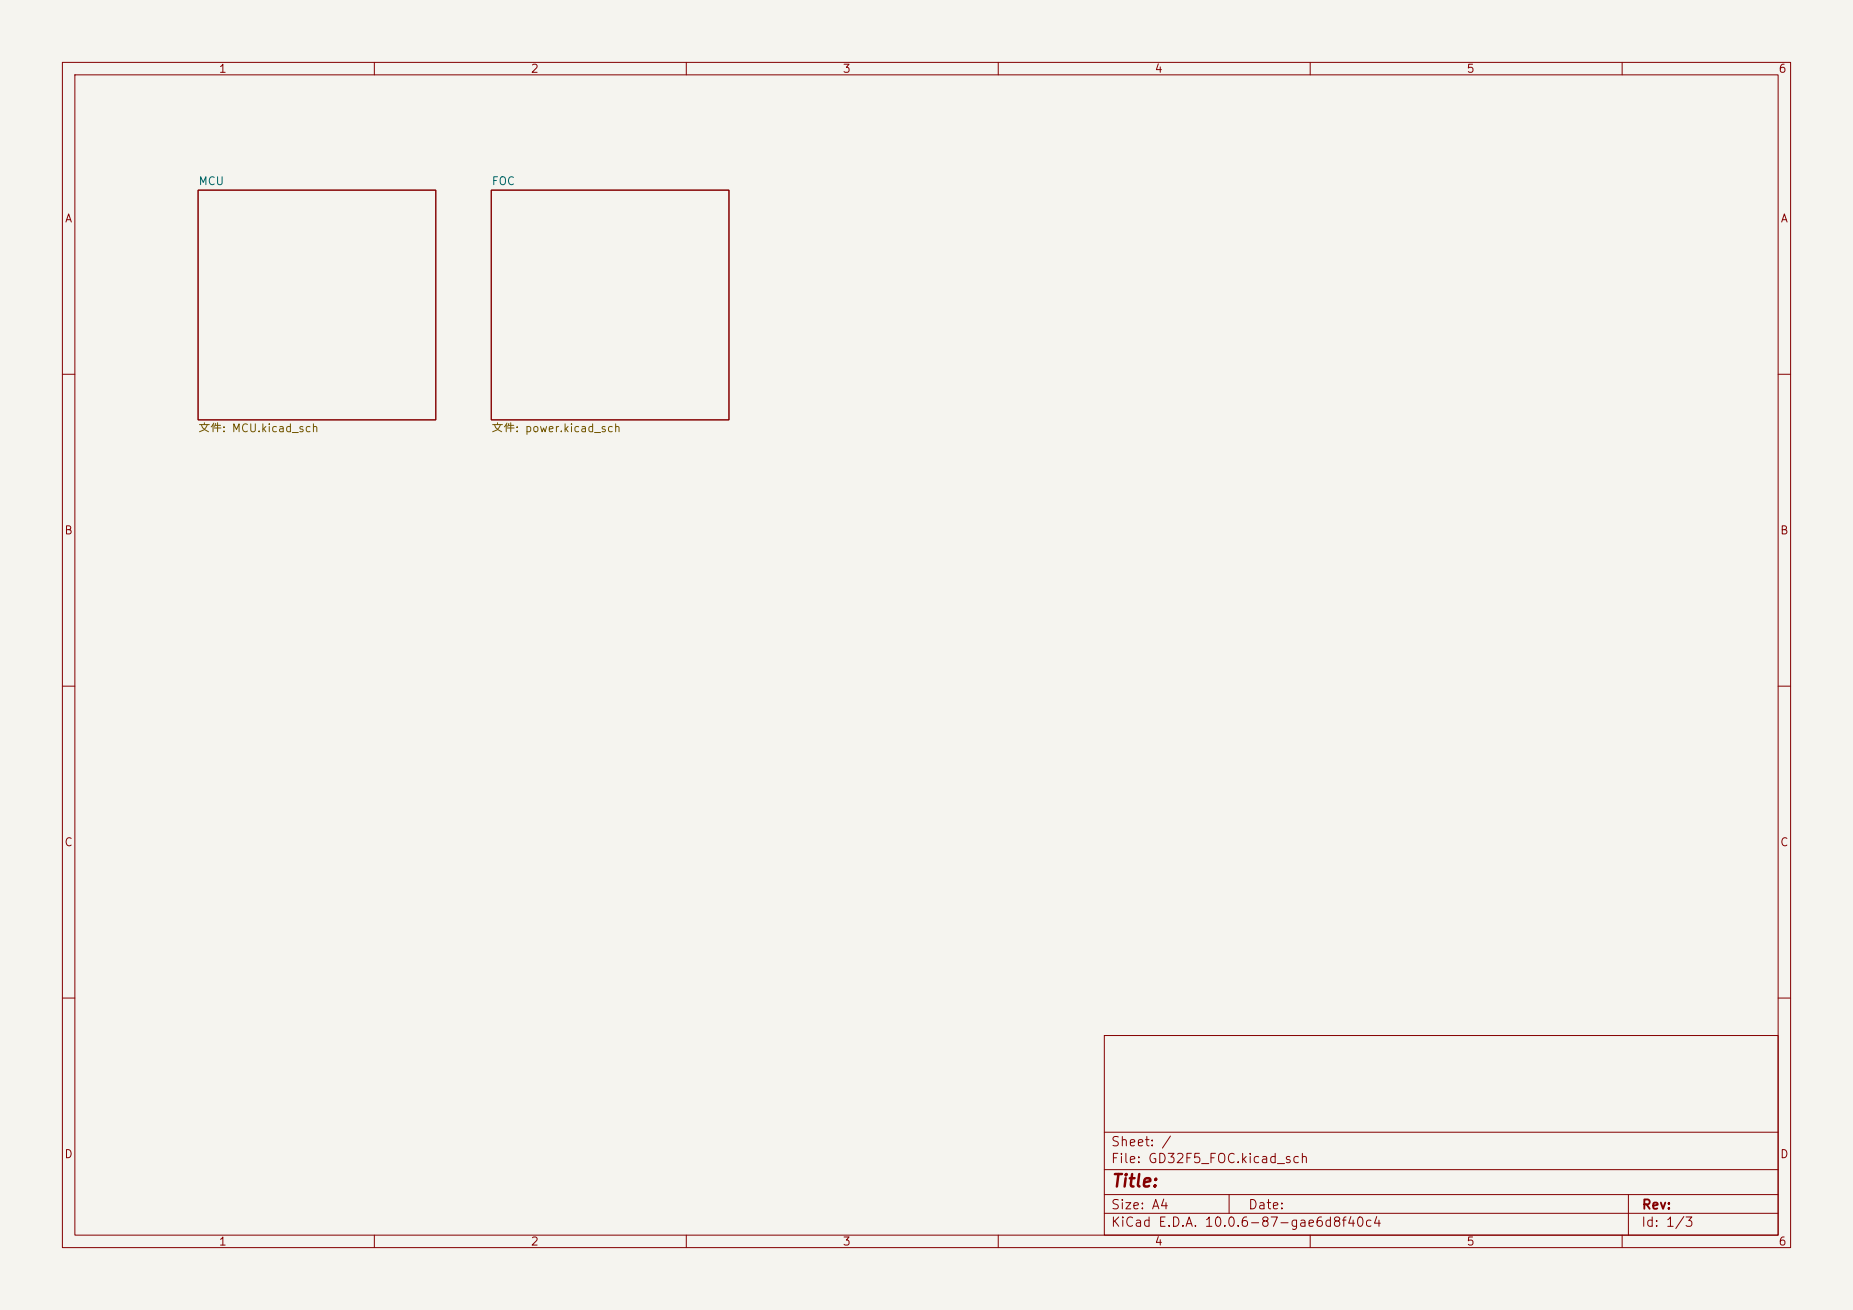
[picture p15: page 1]

Size: A4 | Rev:
KiCad E.D.A. 10.0.6-87-gae6d8f40c4 | Id: 1/3

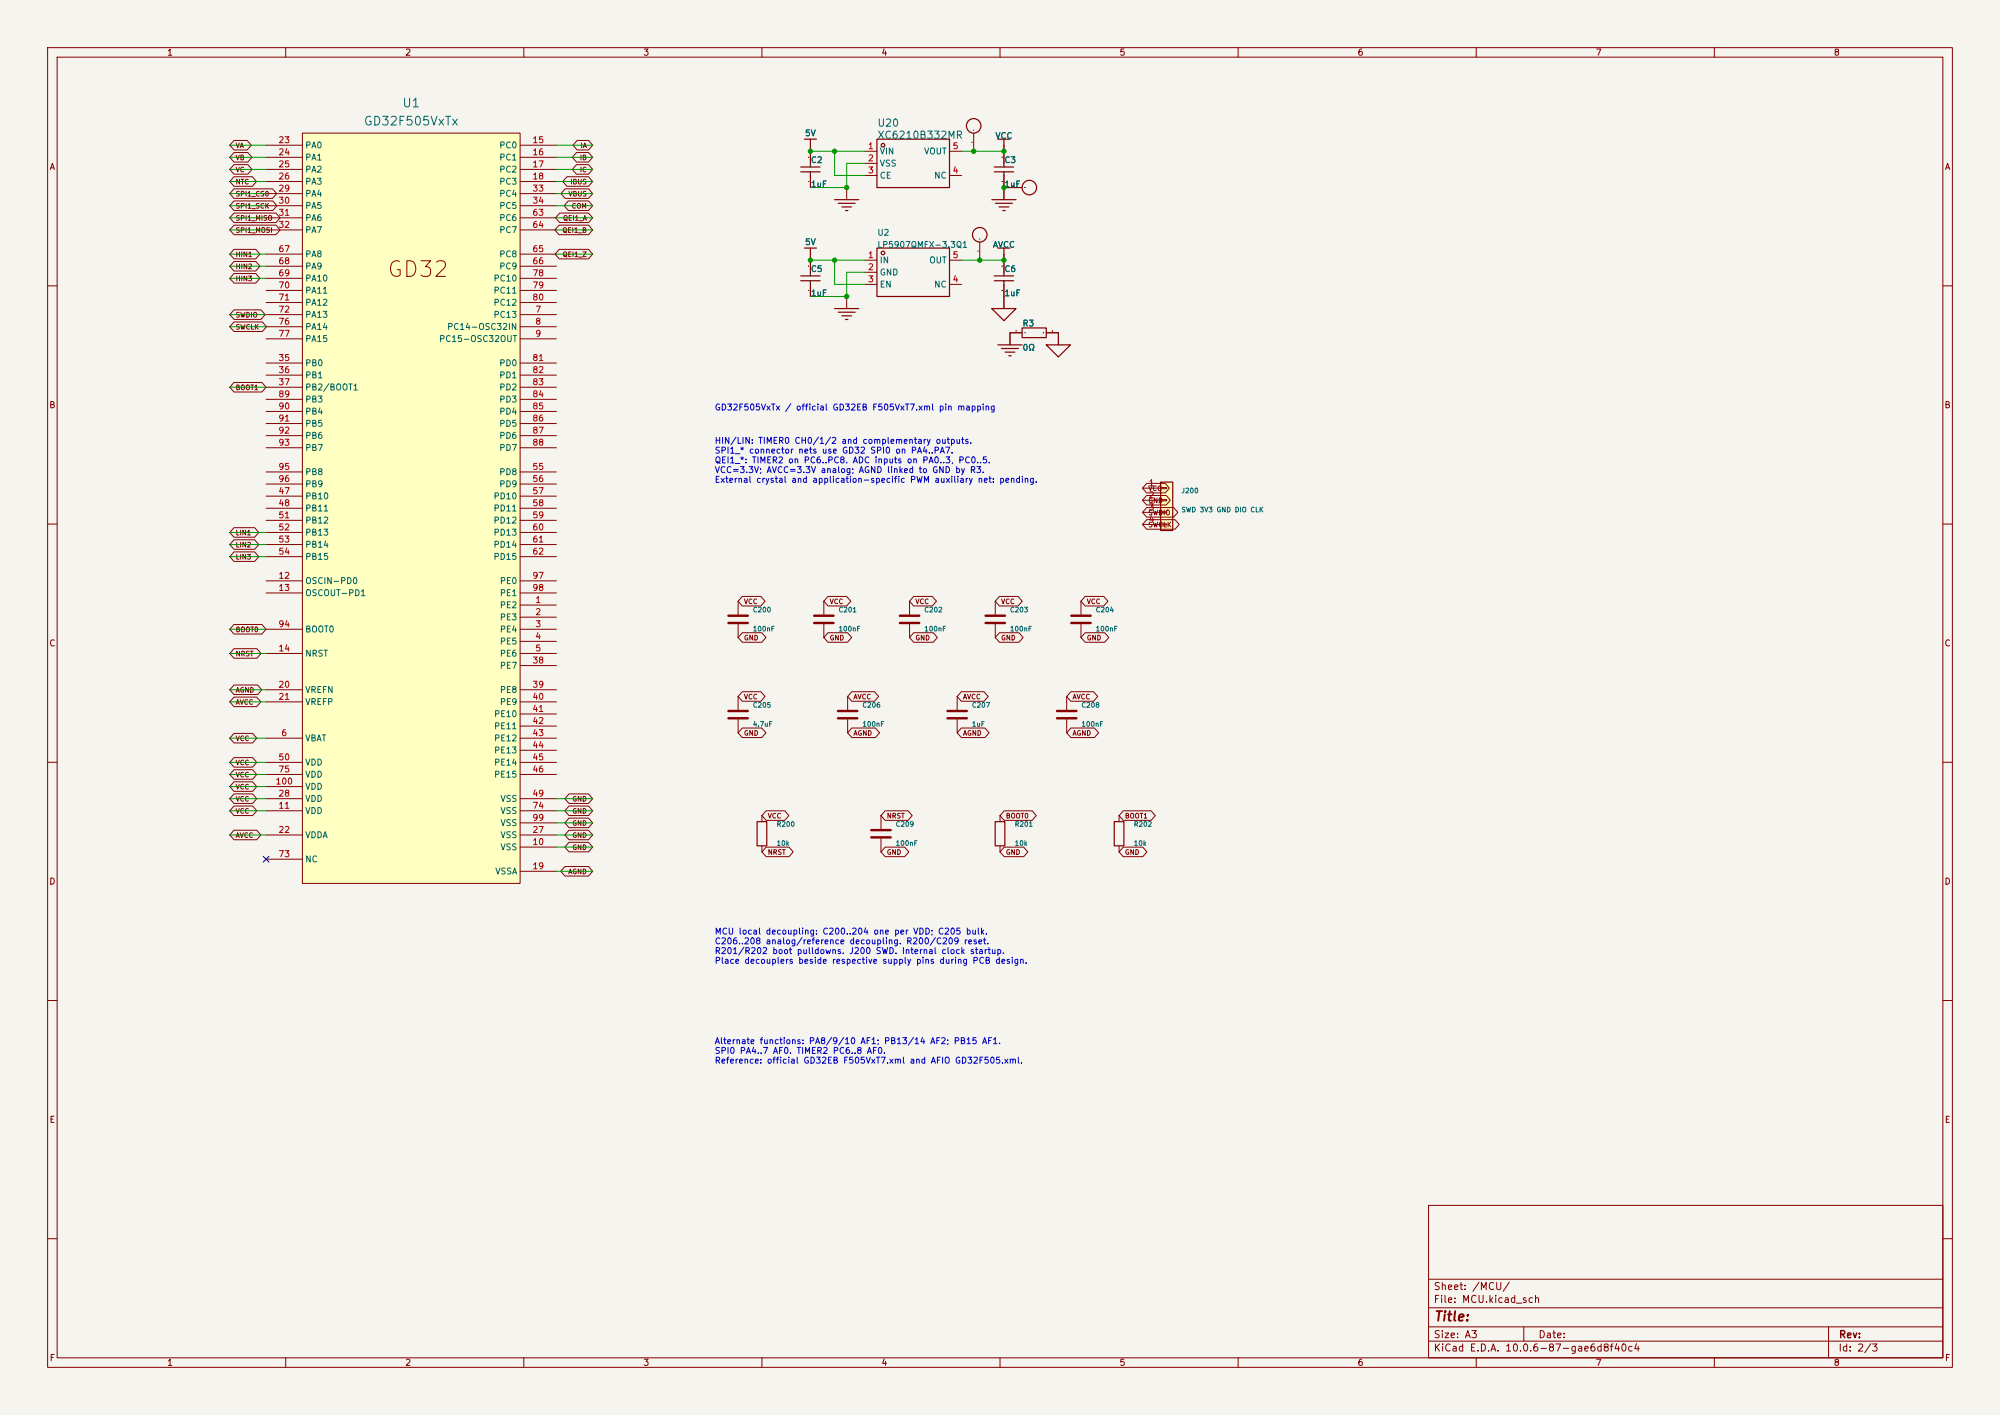
[picture p16: page 2]

HIN/LIN: TIMER0 CH0/1/2 and complementary outputs. SPI1_* connector nets use GD32 SPI0 on PA4..PA7. QEI1_*: TIMER2 on PC6..PC8. ADC inputs on PA0..3, PC0..5. VCC=3.3V; AVCC=3.3V analog; AGND linked to GND by R3. External crystal and application-specific PWM auxiliary net: pending. MCU local decoupling: C200..204 one per VDD; C205 bulk. C206..208 analog/reference decoupling. R200/C209 reset. R201/R202 boot pulldowns. J200 SWD. Internal clock startup. Place decouplers beside respective supply pins during PCB design.1 1 AVCC

GD32F505VxTx / official GD32EB F505VxT7.xml pin mapping

SWD 3V3 GND DIO CLK

Alternate functions: PA8/9/10 AF1; PB13/14 AF2; PB15 AF1. SPI0 PA4..7 AF0. TIMER2 PC6..8 AF0. Reference: official GD32EB F505VxT7.xml and AFIO GD32F505.xml.

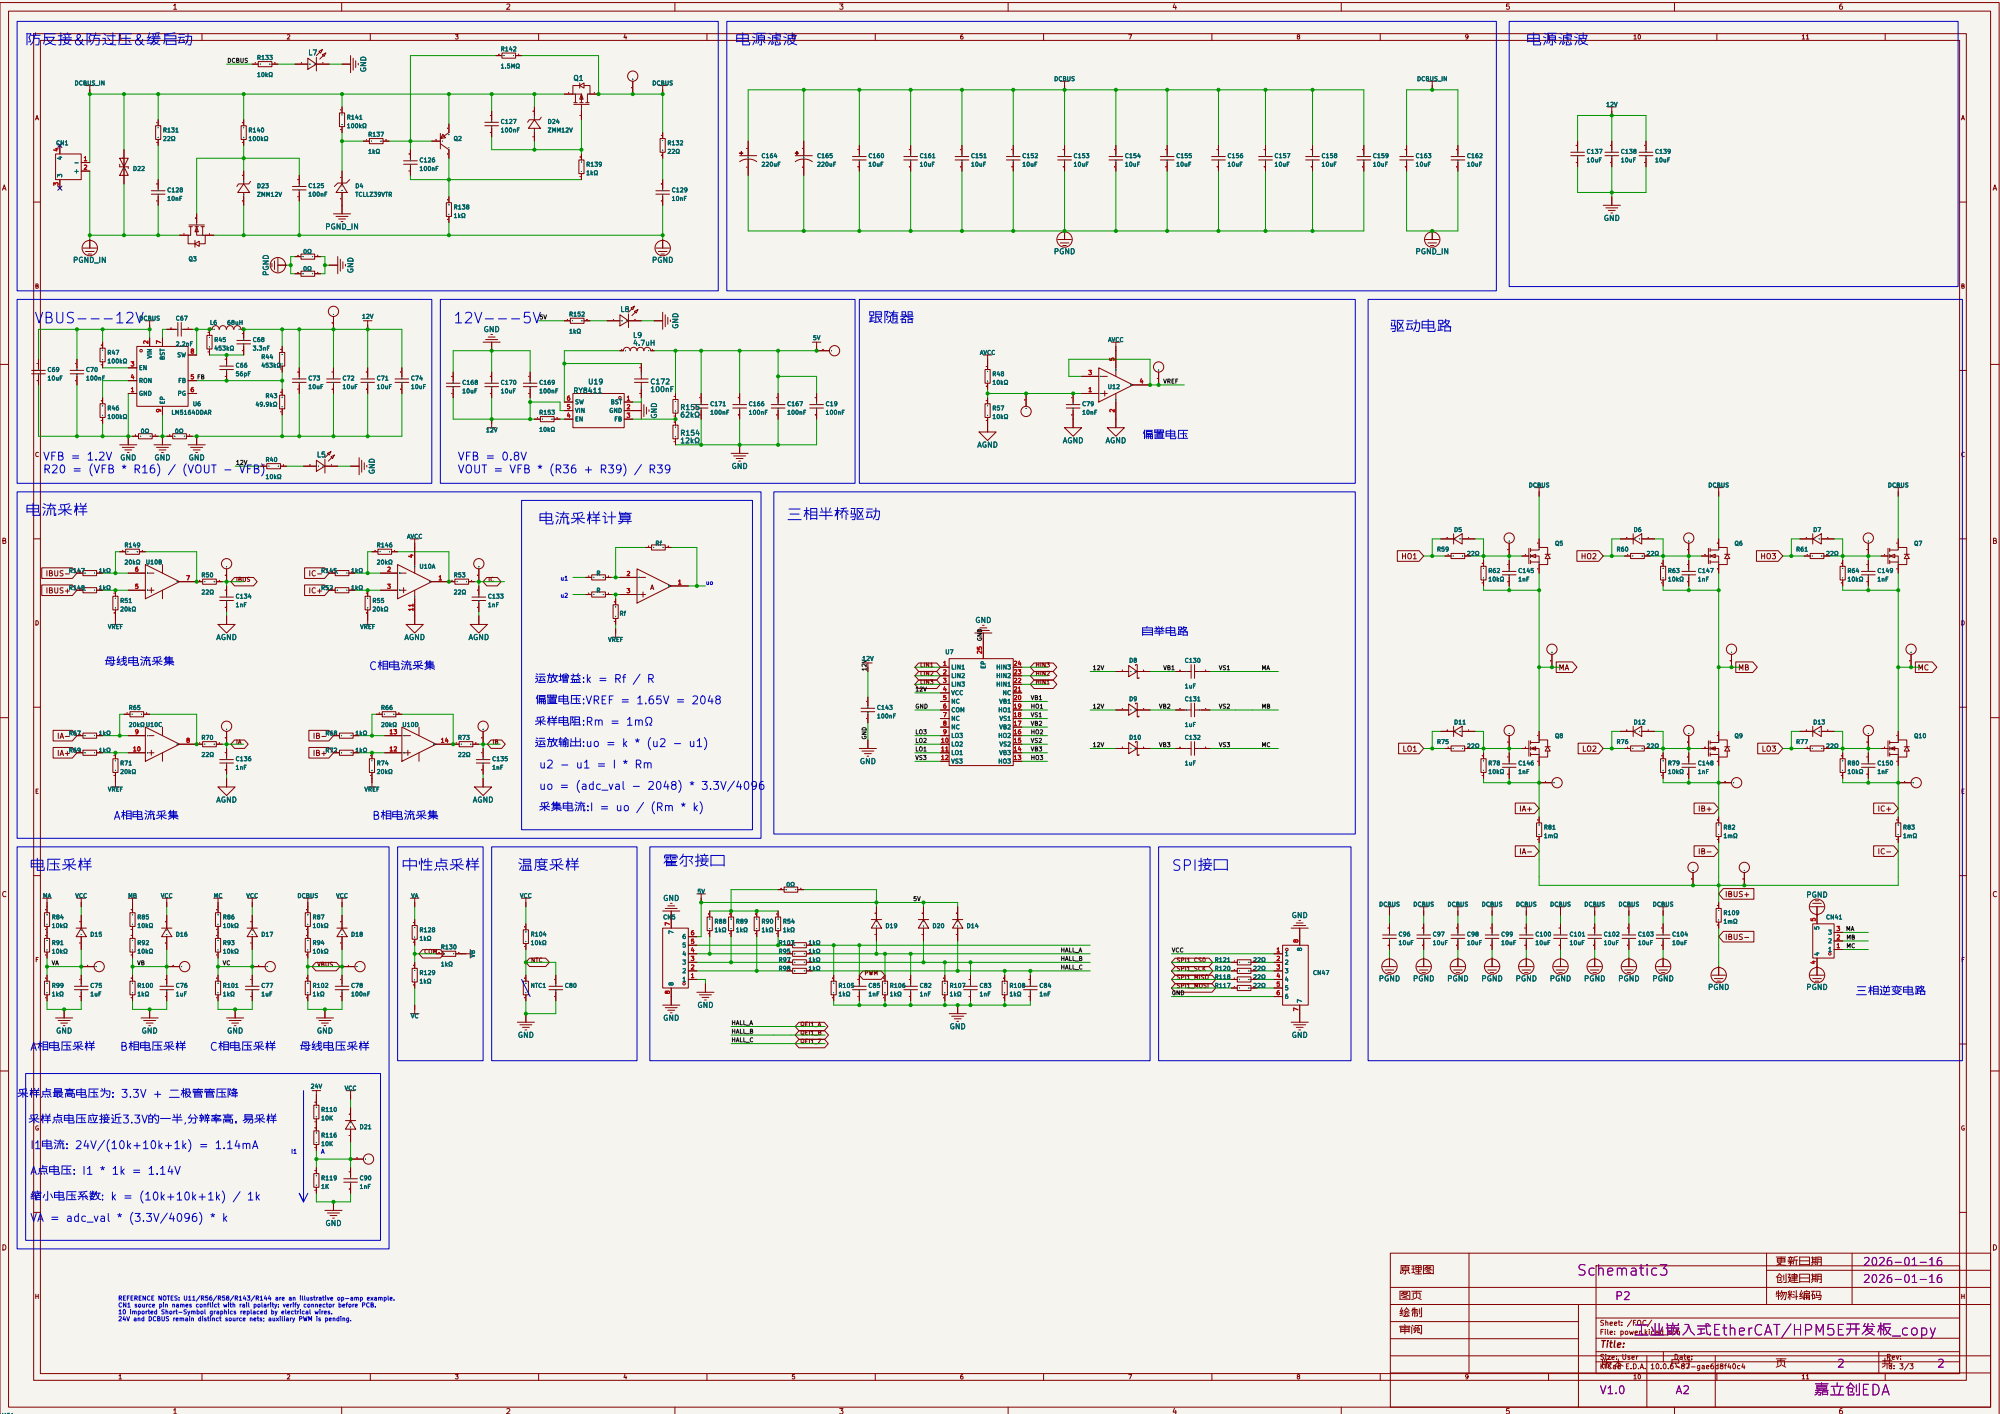
[picture p17: page 3]

创建日期 | 2026-01-16

REFERENCE NOTES: U11/R56/R58/R143/R144 are an illustrative op-amp example. CN1 source pin names conflict with rail polarity: verify connector before PCB. 10 imported Short-Symbol graphics replaced by electrical wires. 24V and DCBUS remain distinct source nets; auxiliary PWM is pending.

图页 | | P2 P2 | 物料编码
绘制
审阅

Size: User | | 页 2 2 | Rev: 共 2 2
版本 | 尺寸

V1.0 | | A2 A2 | 嘉立创EDA
