CYFS3/GD32FOC/c130_recheck/before.pdf

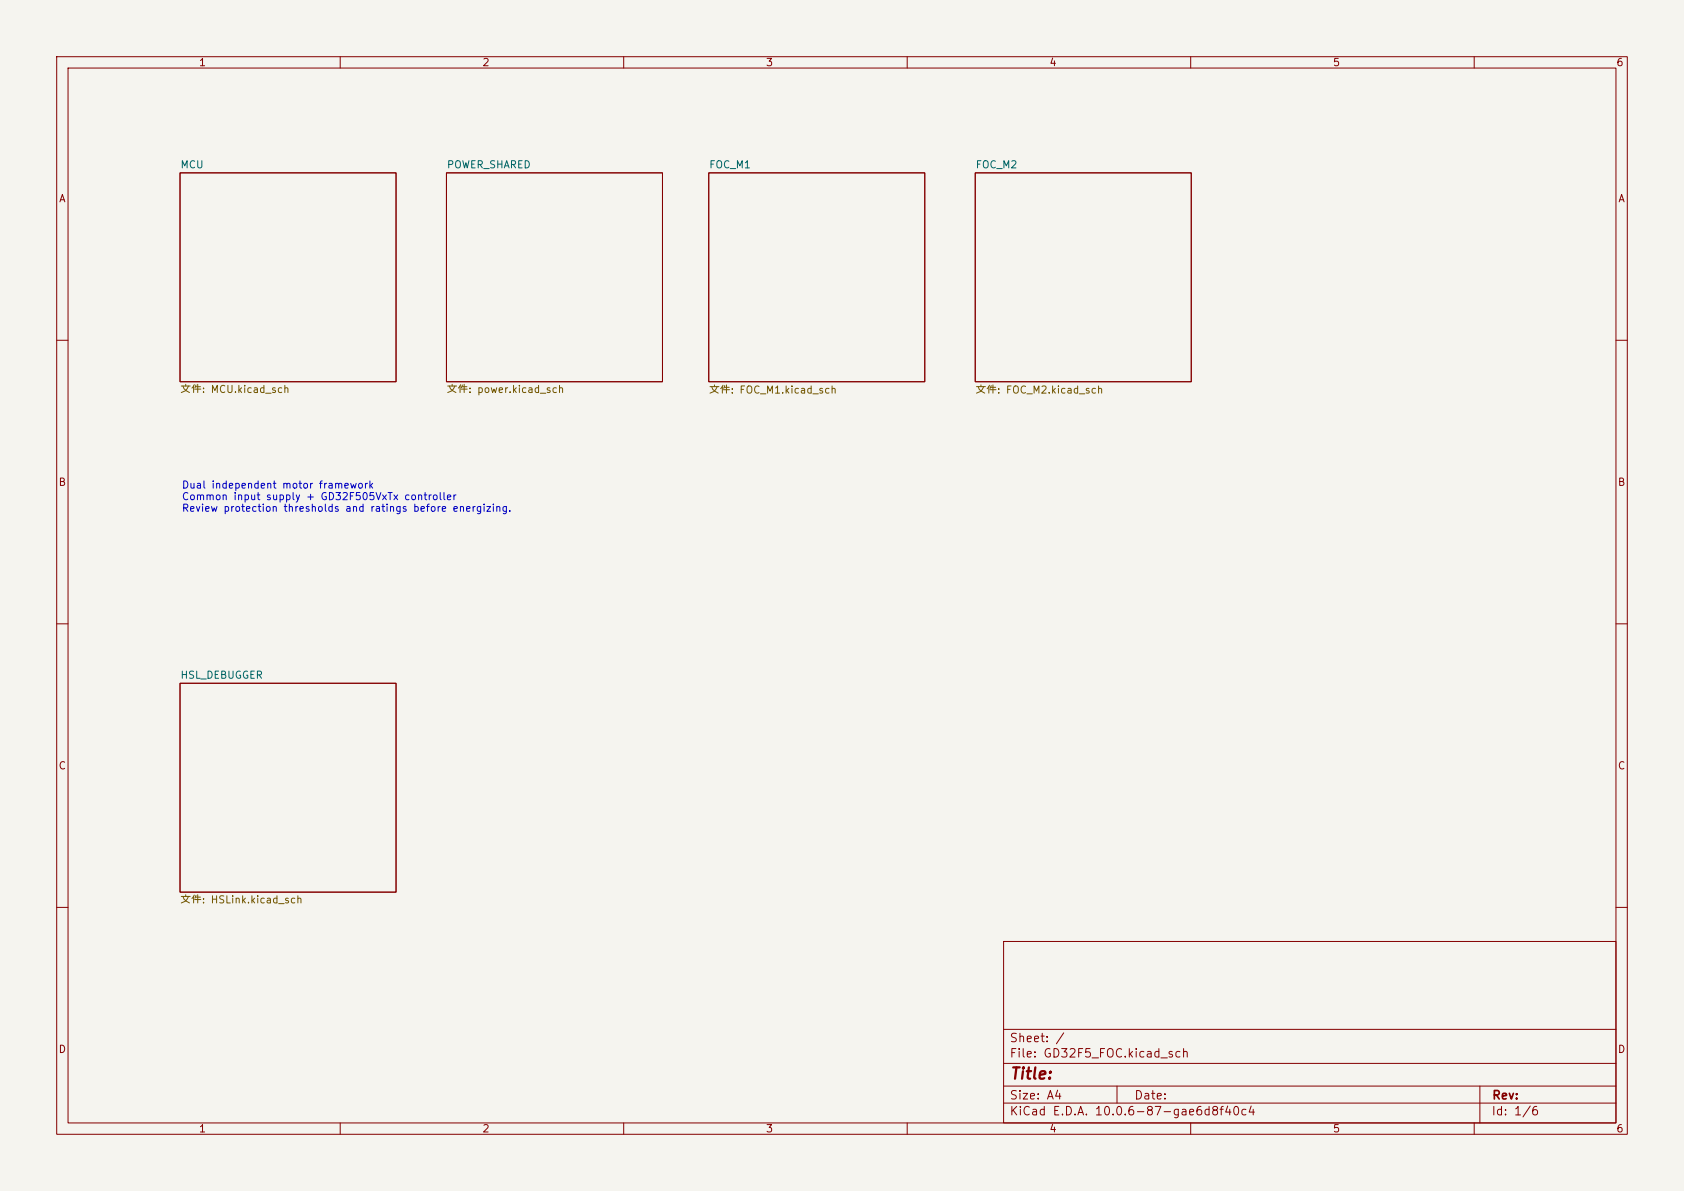
[picture p18: page 1]

FOC_M2 文件: FOC_M2.kicad_sch Dual independent motor framework Common input supply + GD32F505VxTx controller Review protection thresholds and ratings before energizing.

Size: A4 | Rev:
KiCad E.D.A. 10.0.6-87-gae6d8f40c4 | Id: 1/6

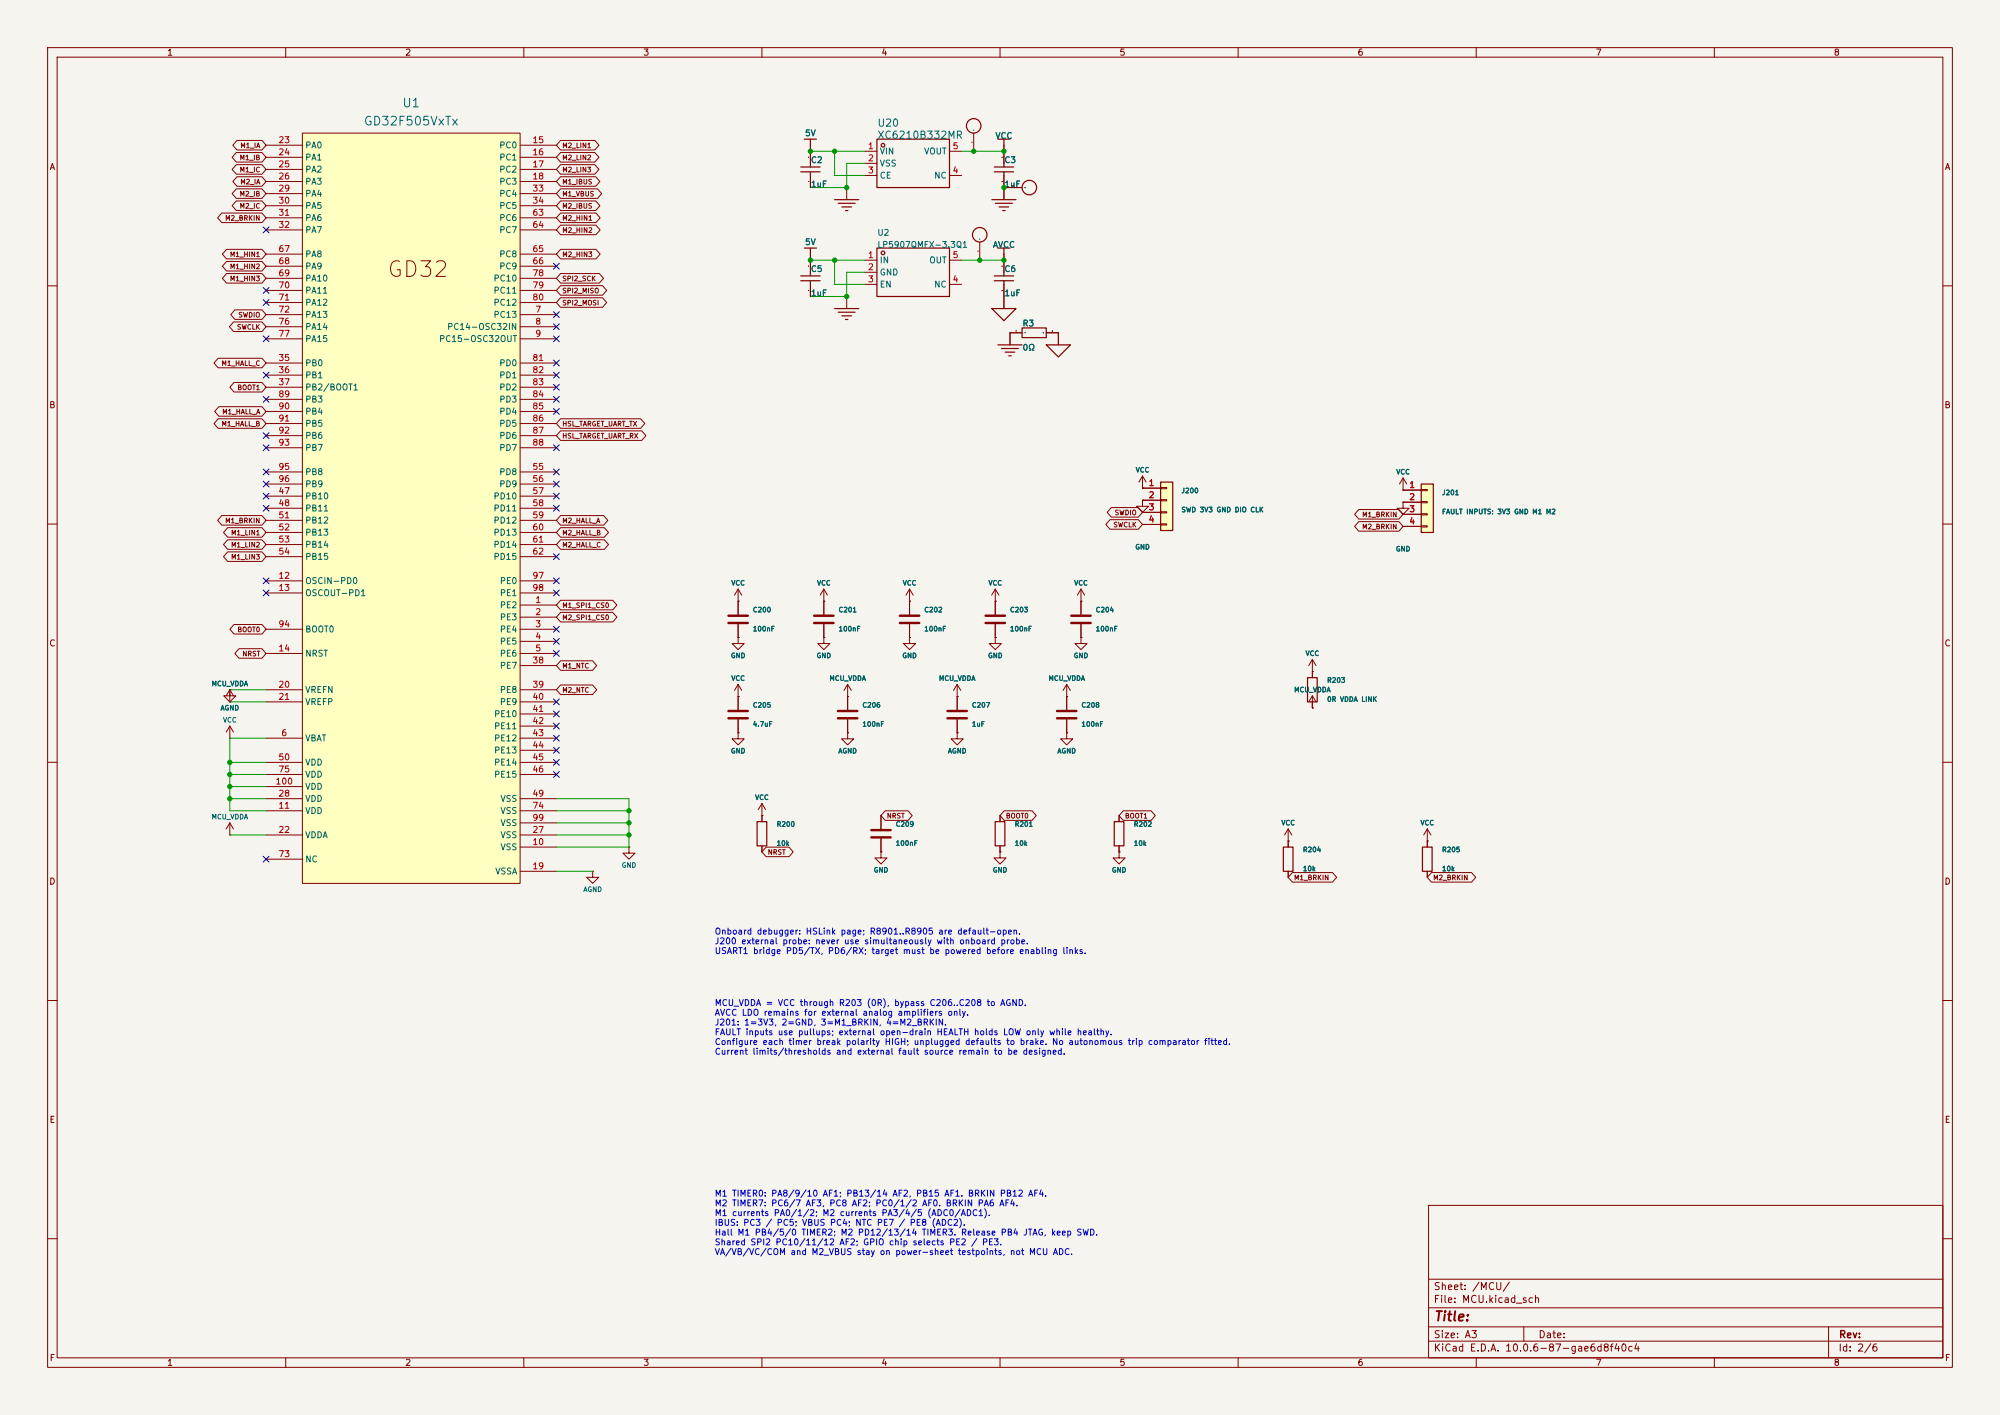
[picture p19: page 2]

VCC
SWD 3V3 GND DIO CLK 1234

SWDIO Onboard debugger: HSLink page; R8901..R8905 are default-open. J200 external probe: never use simultaneously with onboard probe. USART1 bridge PD5/TX, PD6/RX; target must be powered before enabling links. M1 TIMER0: PA8/9/10 AF1; PB13/14 AF2, PB15 AF1. BRKIN PB12 AF4. M2 TIMER7: PC6/7 AF3, PC8 AF2; PC0/1/2 AF0. BRKIN PA6 AF4. M1 currents PA0/1/2; M2 currents PA3/4/5 (ADC0/ADC1).

SWD 3V3 GND DIO CLK

Configure each timer break polarity HIGH; unplugged defaults to brake. No autonomous trip comparator fitted. Current limits/thresholds and external fault source remain to be designed. MCU_VDDA

IBUS: PC3 / PC5; VBUS PC4; NTC PE7 / PE8 (ADC2). Hall M1 PB4/5/0 TIMER2; M2 PD12/13/14 TIMER3. Release PB4 JTAG, keep SWD. Shared SPI2 PC10/11/12 AF2; GPIO chip selects PE2 / PE3. VA/VB/VC/COM and M2_VBUS stay on power-sheet testpoints, not MCU ADC. MCU_VDDA = VCC through R203 (0R), bypass C206..C208 to AGND. AVCC LDO remains for external analog amplifiers only. J201: 1=3V3, 2=GND, 3=M1_BRKIN, 4=M2_BRKIN. FAULT inputs use pullups; external open-drain HEALTH holds LOW only while healthy.

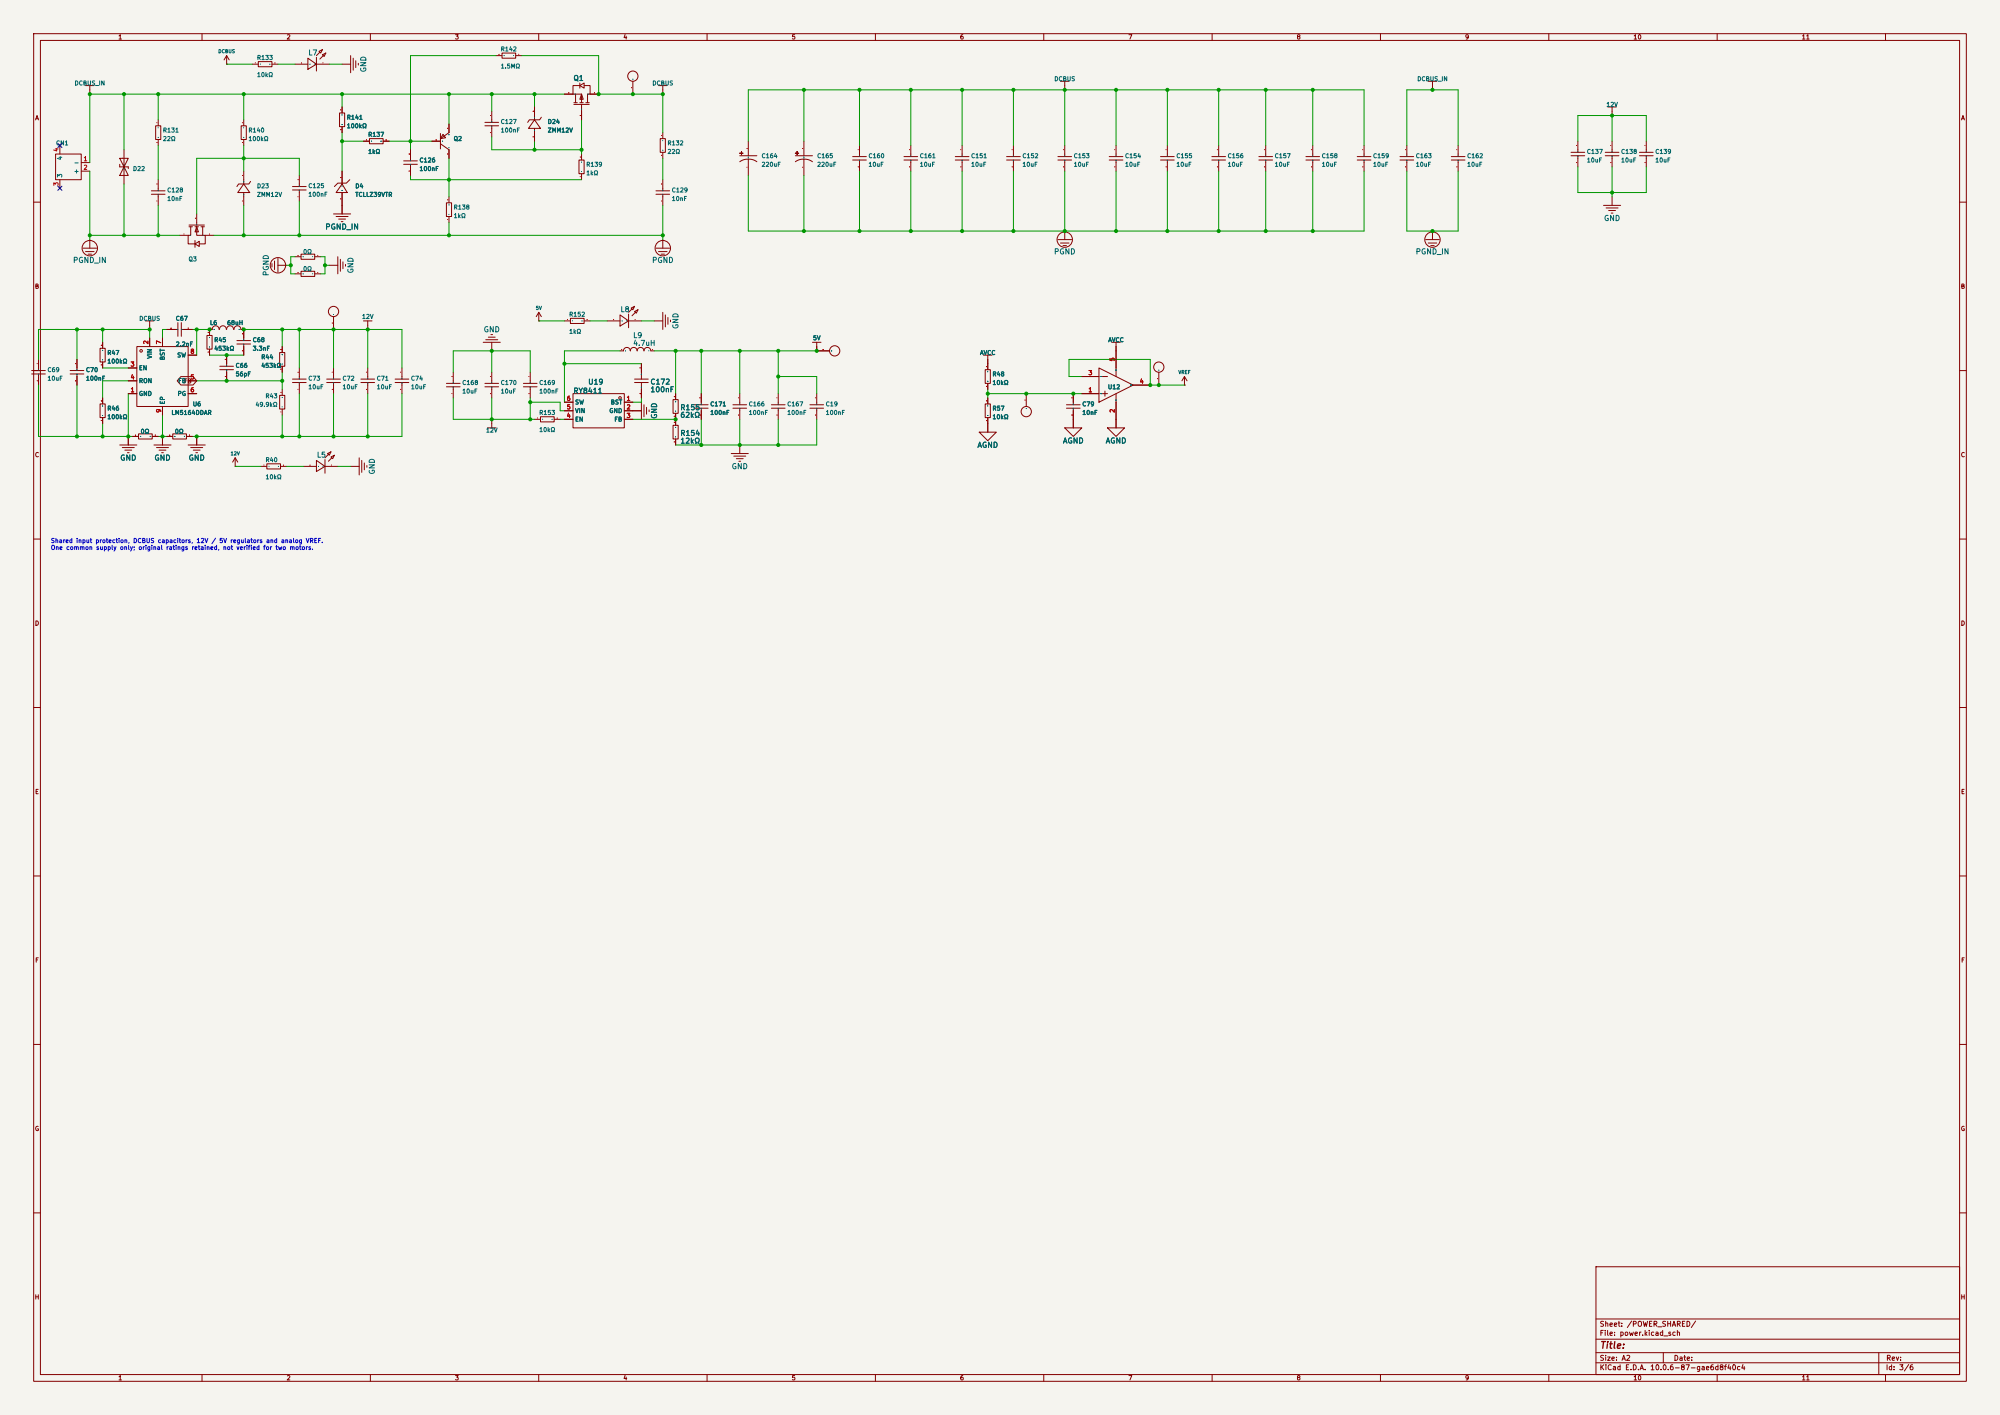
[picture p20: page 3]

Shared input protection, DCBUS capacitors, 12V / 5V regulators and analog VREF. One common supply only; original ratings retained, not verified for two motors. R45

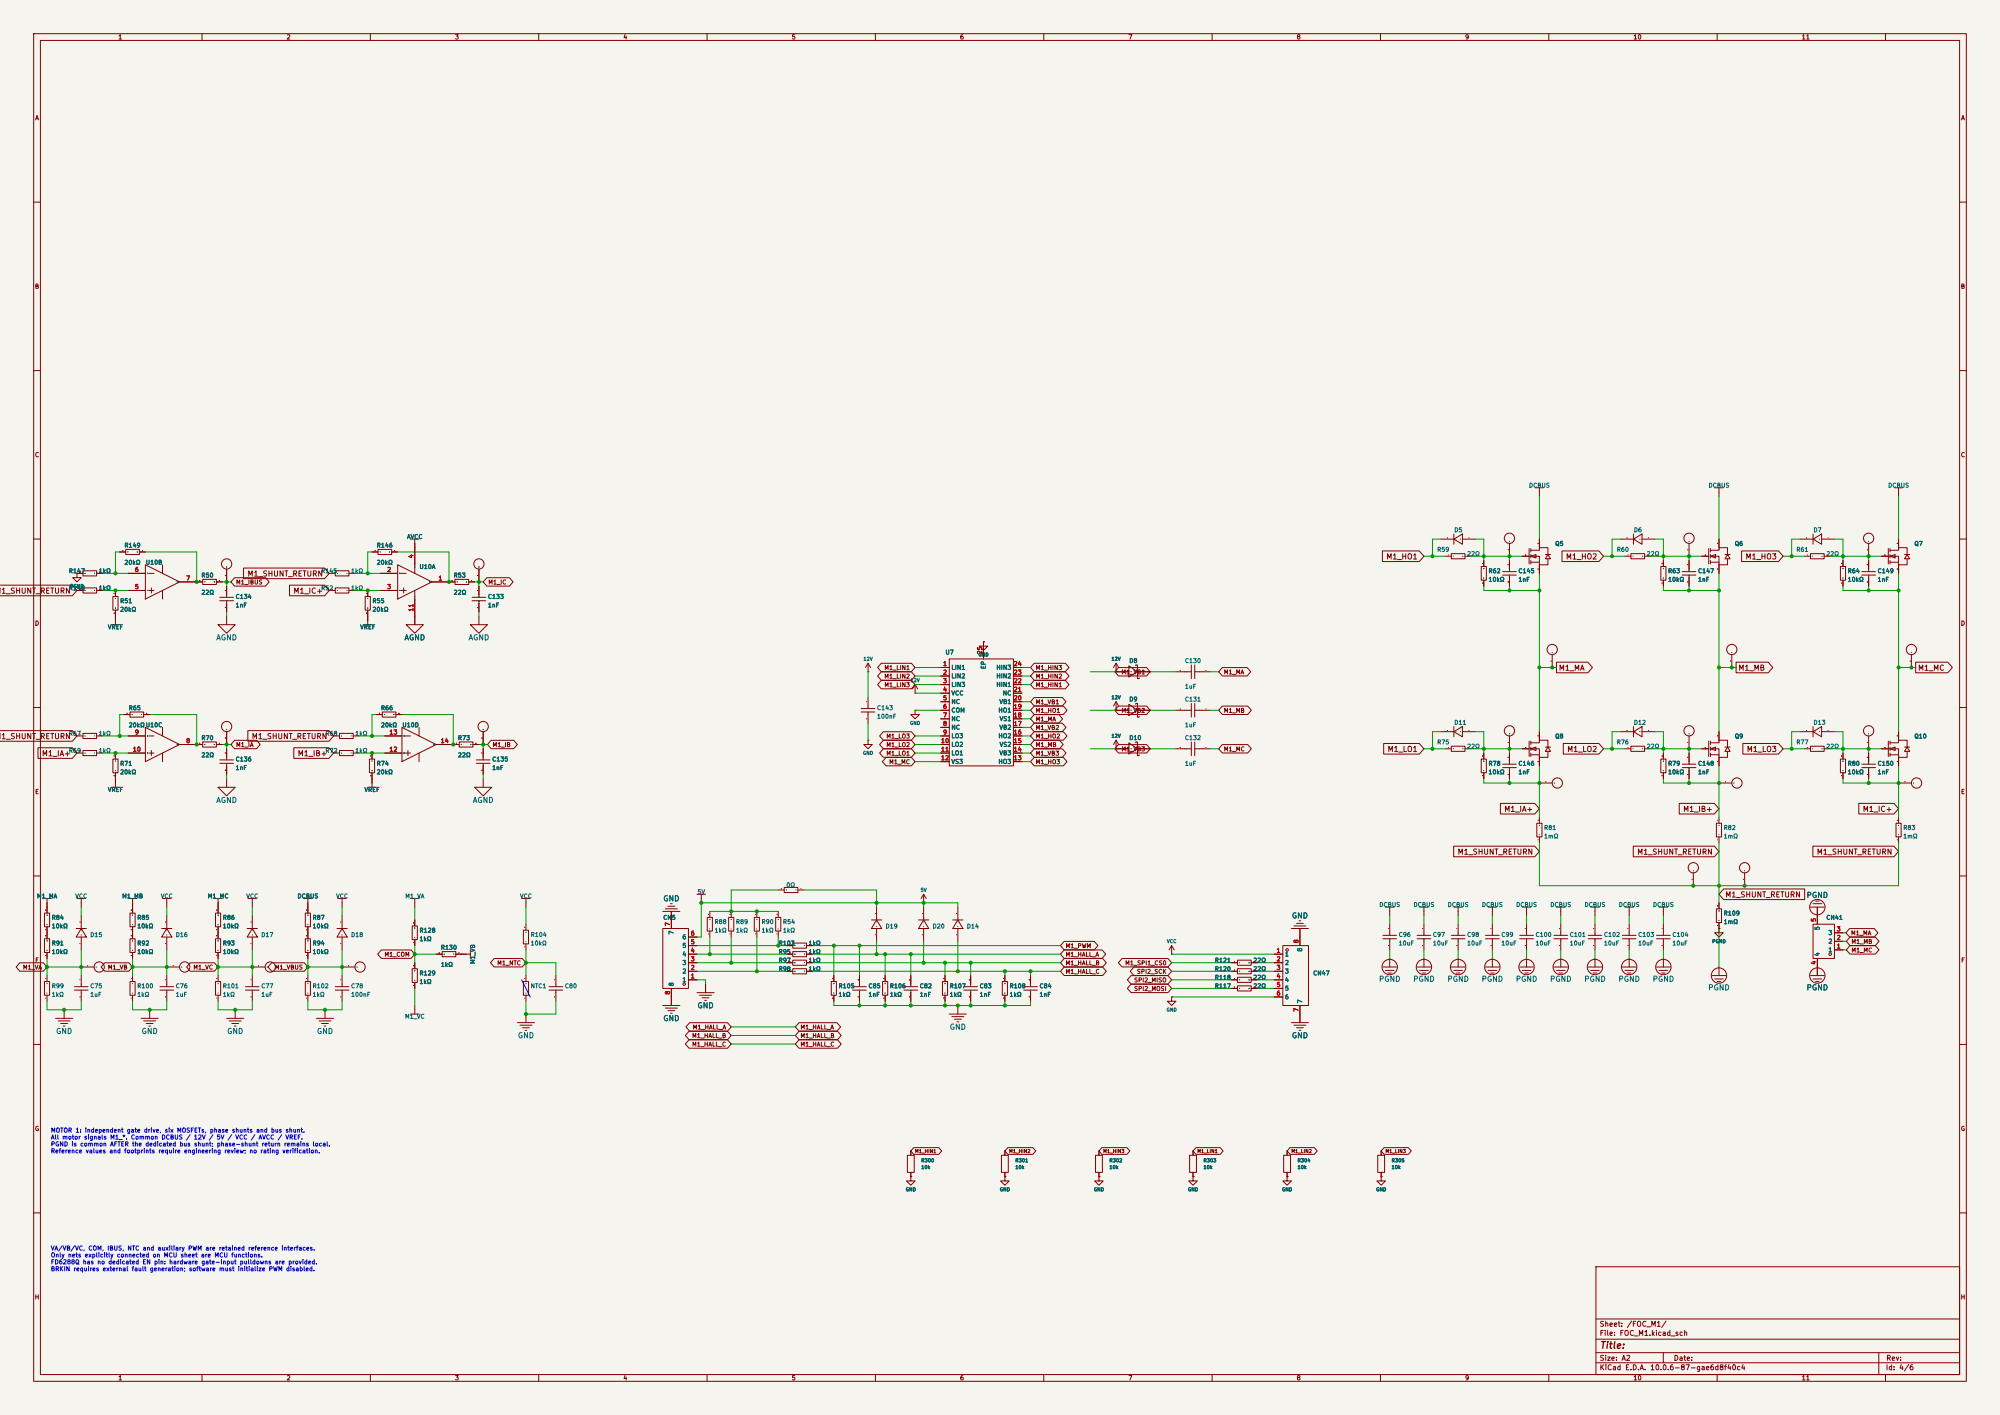
[picture p21: page 4]

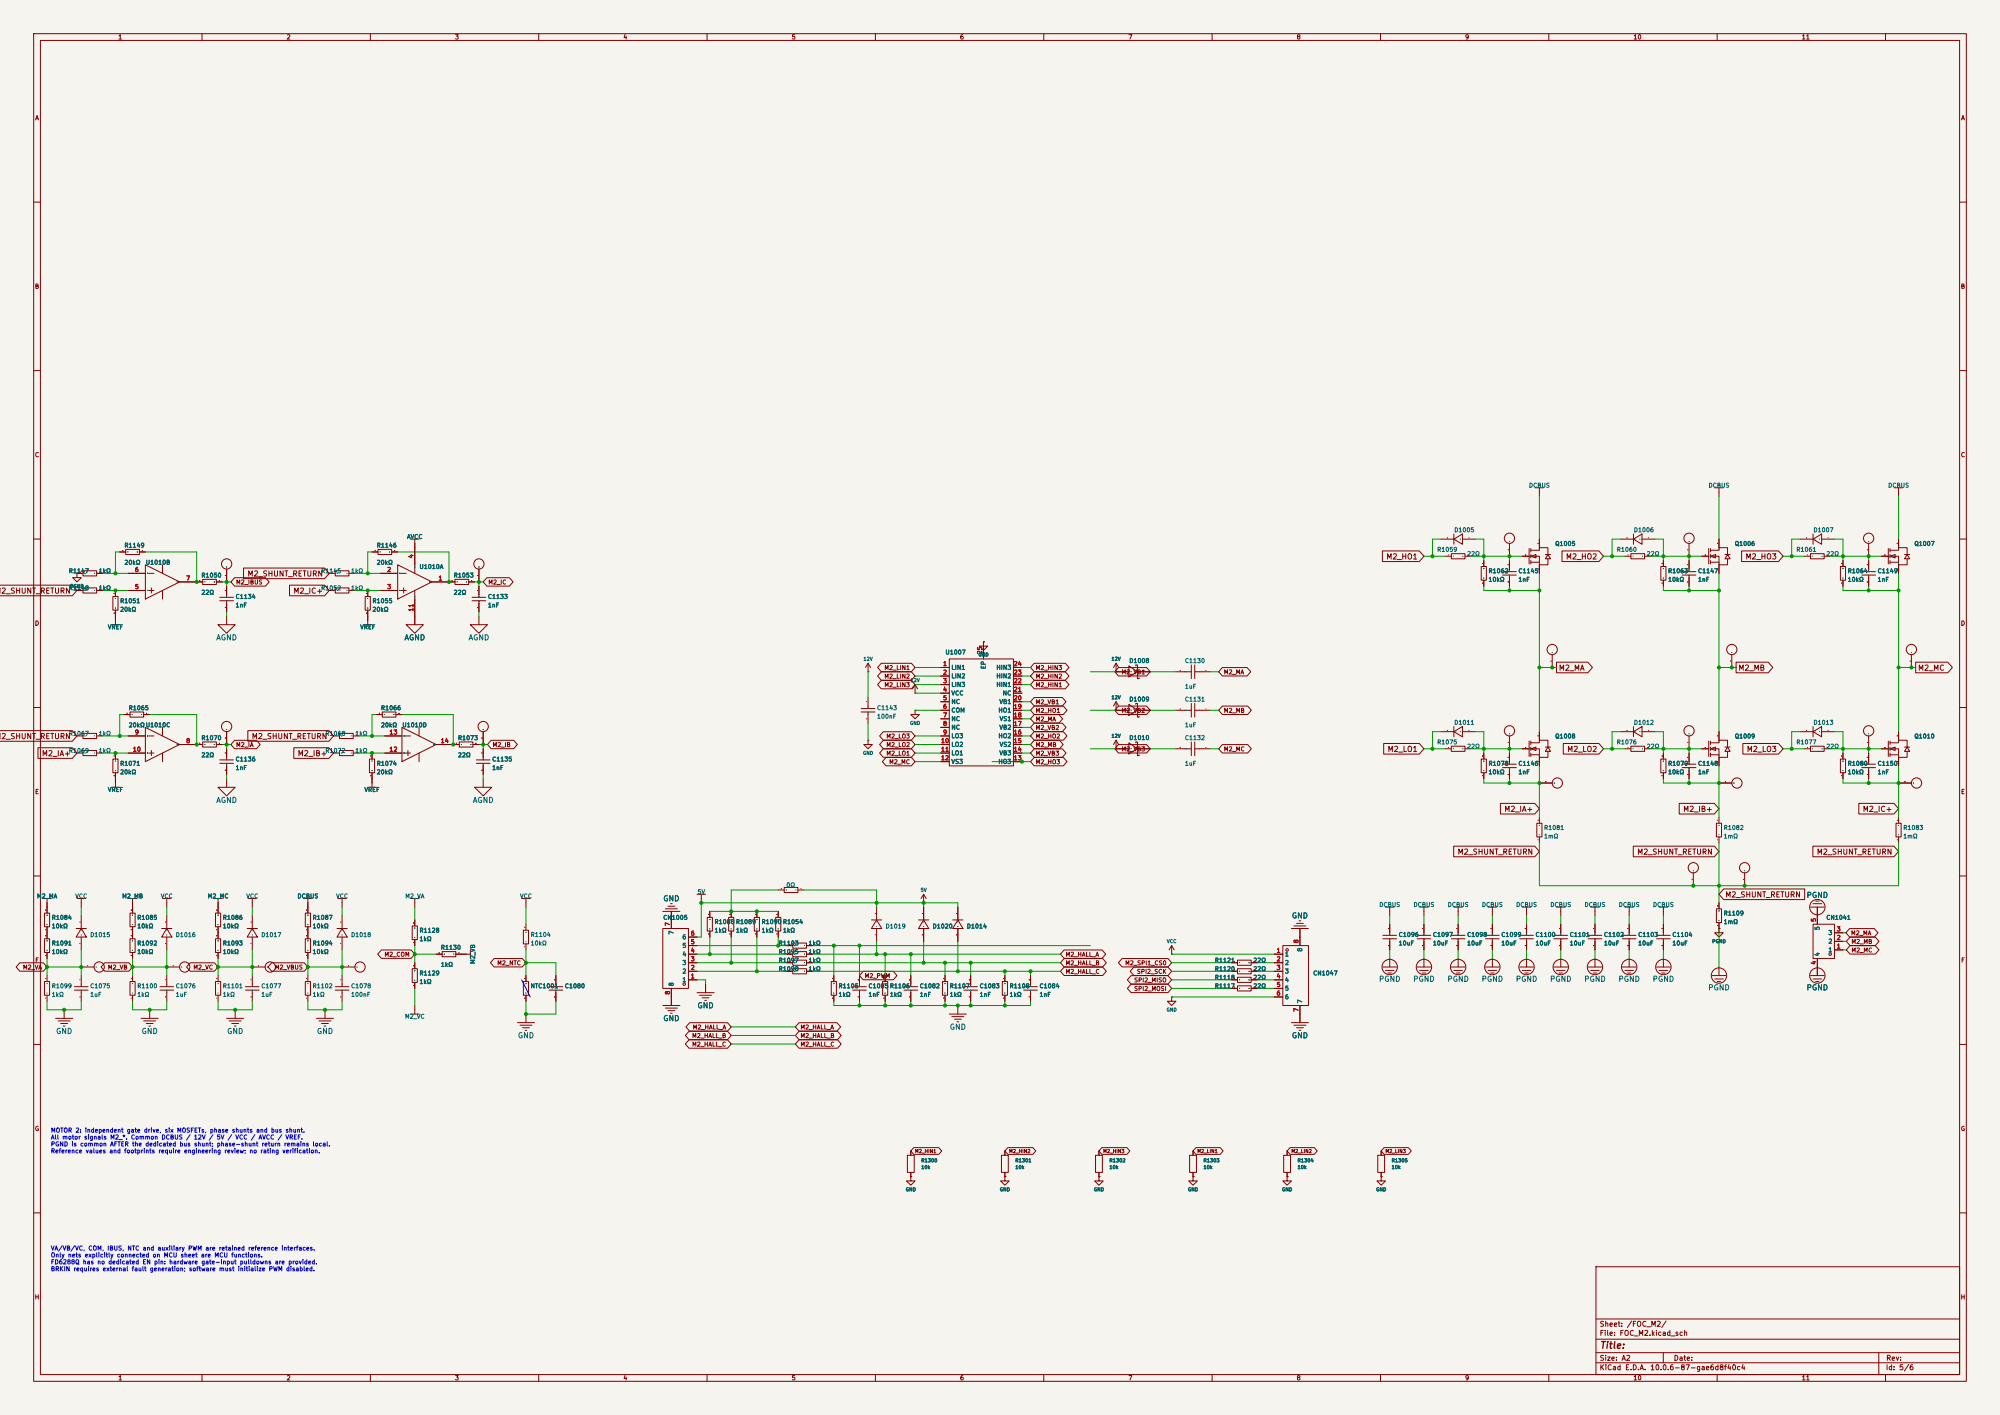
[picture p22: page 5]

VA/VB/VC, COM, IBUS, NTC and auxiliary PWM are retained reference interfaces. Only nets explicitly connected on MCU sheet are MCU functions. FD6288Q has no dedicated EN pin: hardware gate-input pulldowns are provided. BRKIN requires external fault generation; software must initialize PWM disabled. MOTOR 2: independent gate drive, six MOSFETs, phase shunts and bus shunt. All motor signals M2_*. Common DCBUS / 12V / 5V / VCC / AVCC / VREF. PGND is common AFTER the dedicated bus shunt; phase-shunt return remains local. Reference values and footprints require engineering review; no rating verification.

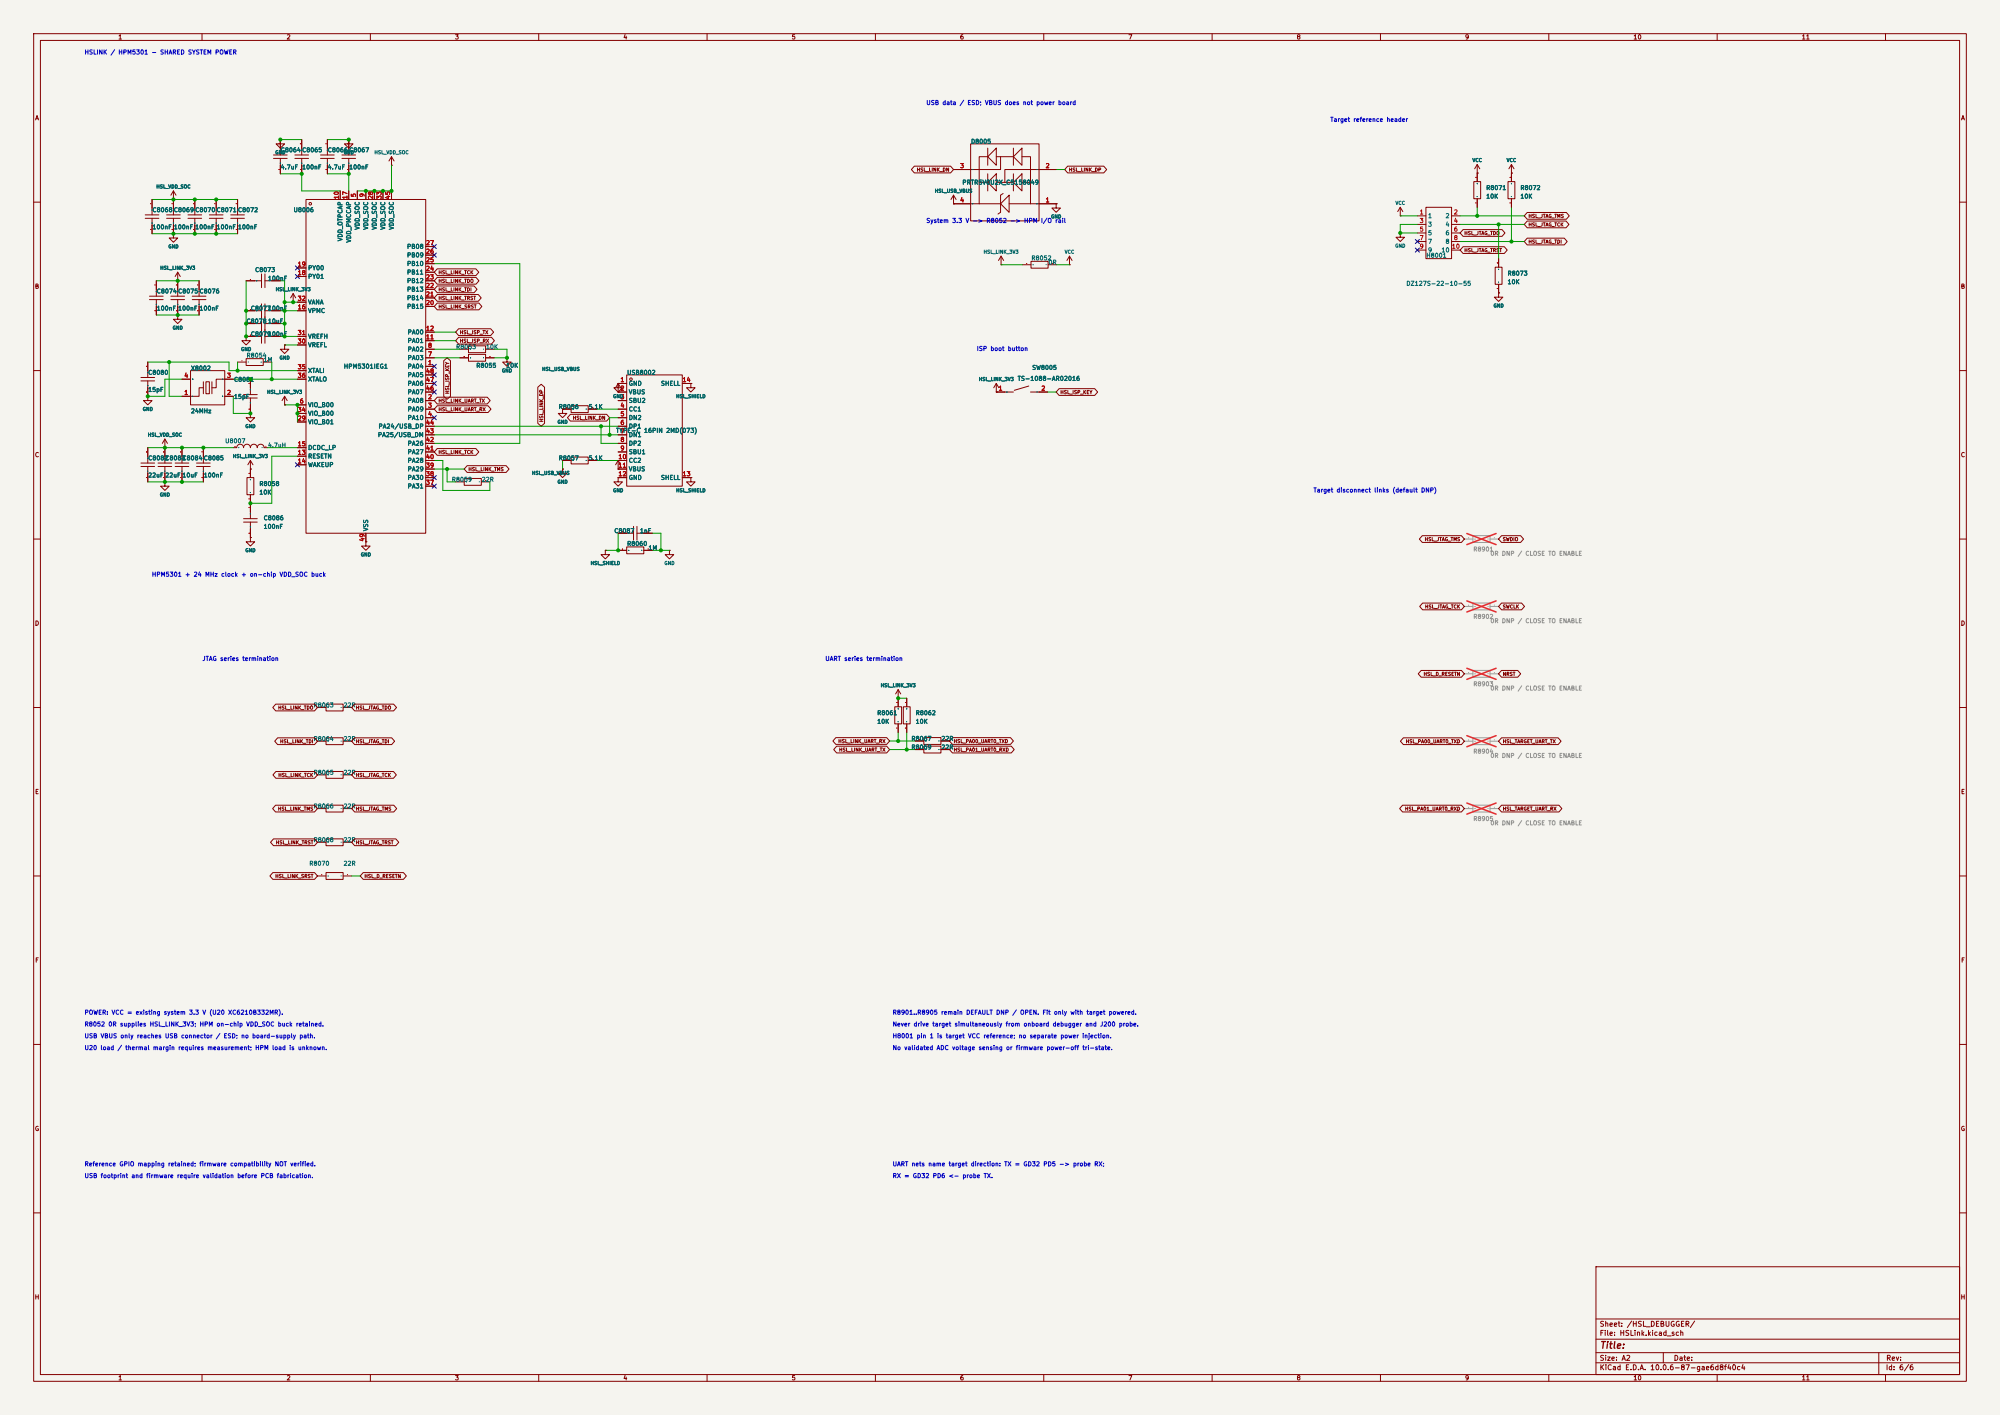
[picture p23: page 6]

HSLINK / HPM5301 - SHARED SYSTEM POWER

USB data / ESD; VBUS does not power board System 3.3 V -> R8052 -> HPM I/O rail

ISP boot button HPM5301 + 24 MHz clock + on-chip VDD_SOC buck

Target disconnect links (default DNP)

UART nets name target direction: TX = GD32 PD5 -> probe RX; R8901..R8905 remain DEFAULT DNP / OPEN. Fit only with target powered.

H8001 pin 1 is target VCC reference; no separate power injection.

No validated ADC voltage sensing or firmware power-off tri-state. RX = GD32 PD6 <- probe TX. Reference GPIO mapping retained; firmware compatibility NOT verified.
