CYFS3/GD32FOC/dual_review/dual_motor.pdf

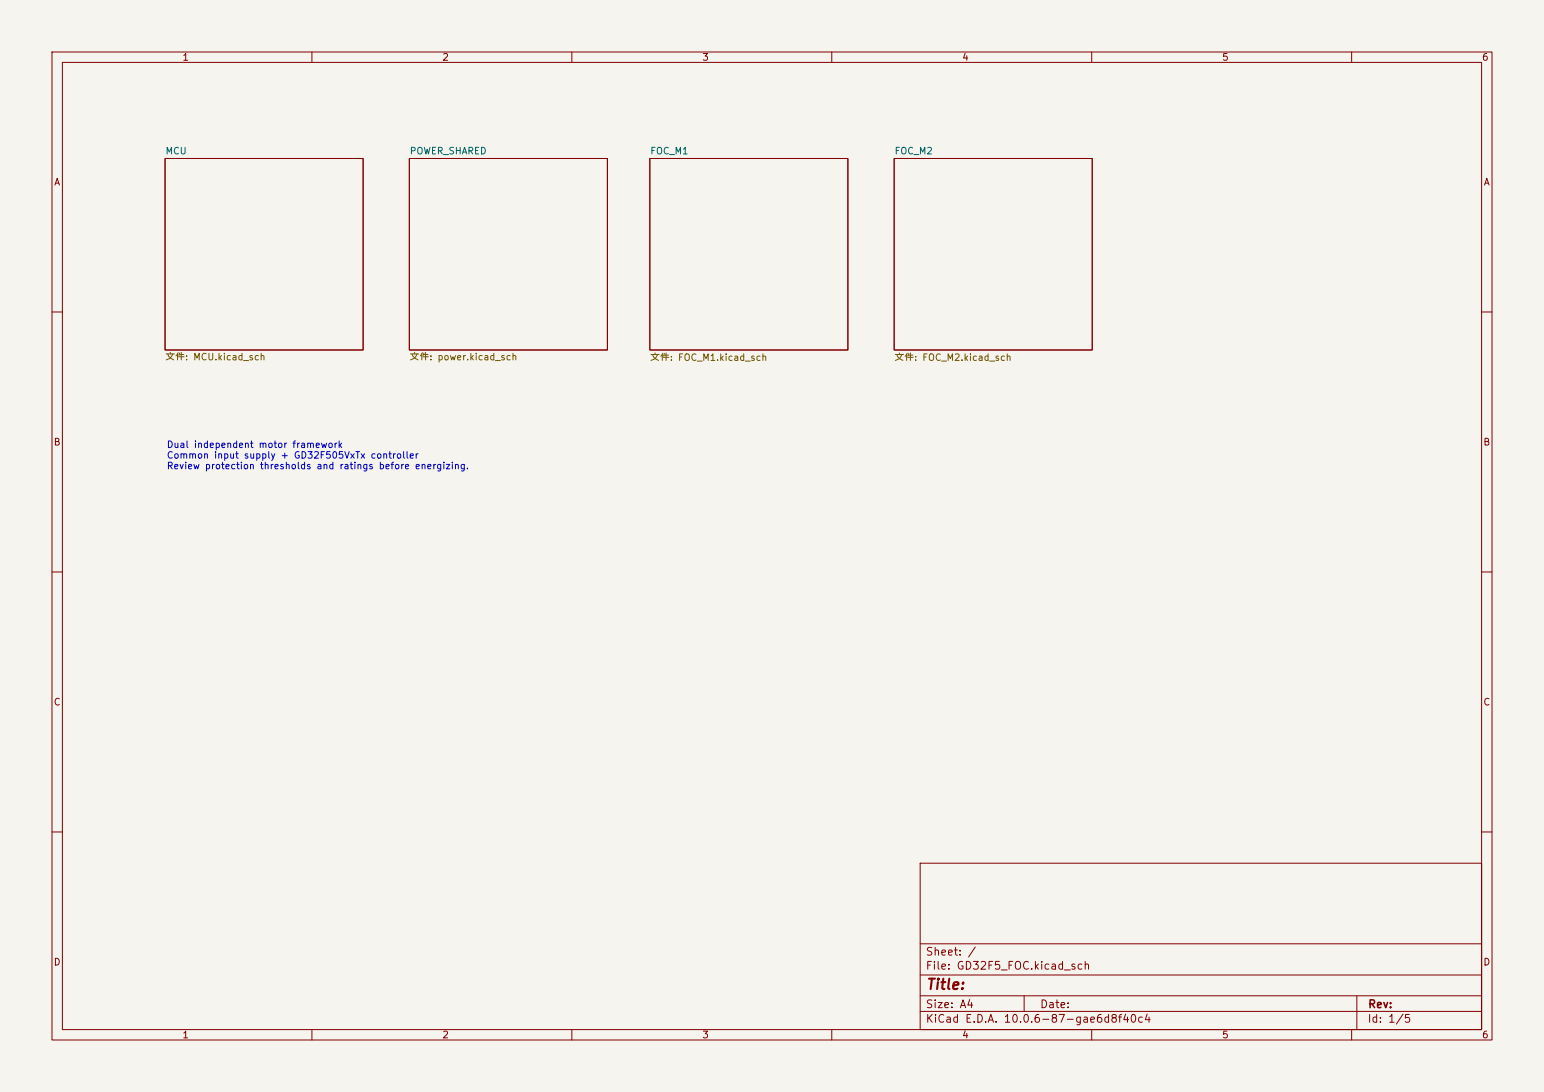
[picture p26: page 1]

FOC_M2 文件: FOC_M2.kicad_sch Dual independent motor framework Common input supply + GD32F505VxTx controller Review protection thresholds and ratings before energizing.

Size: A4 | Rev:
KiCad E.D.A. 10.0.6-87-gae6d8f40c4 | Id: 1/5

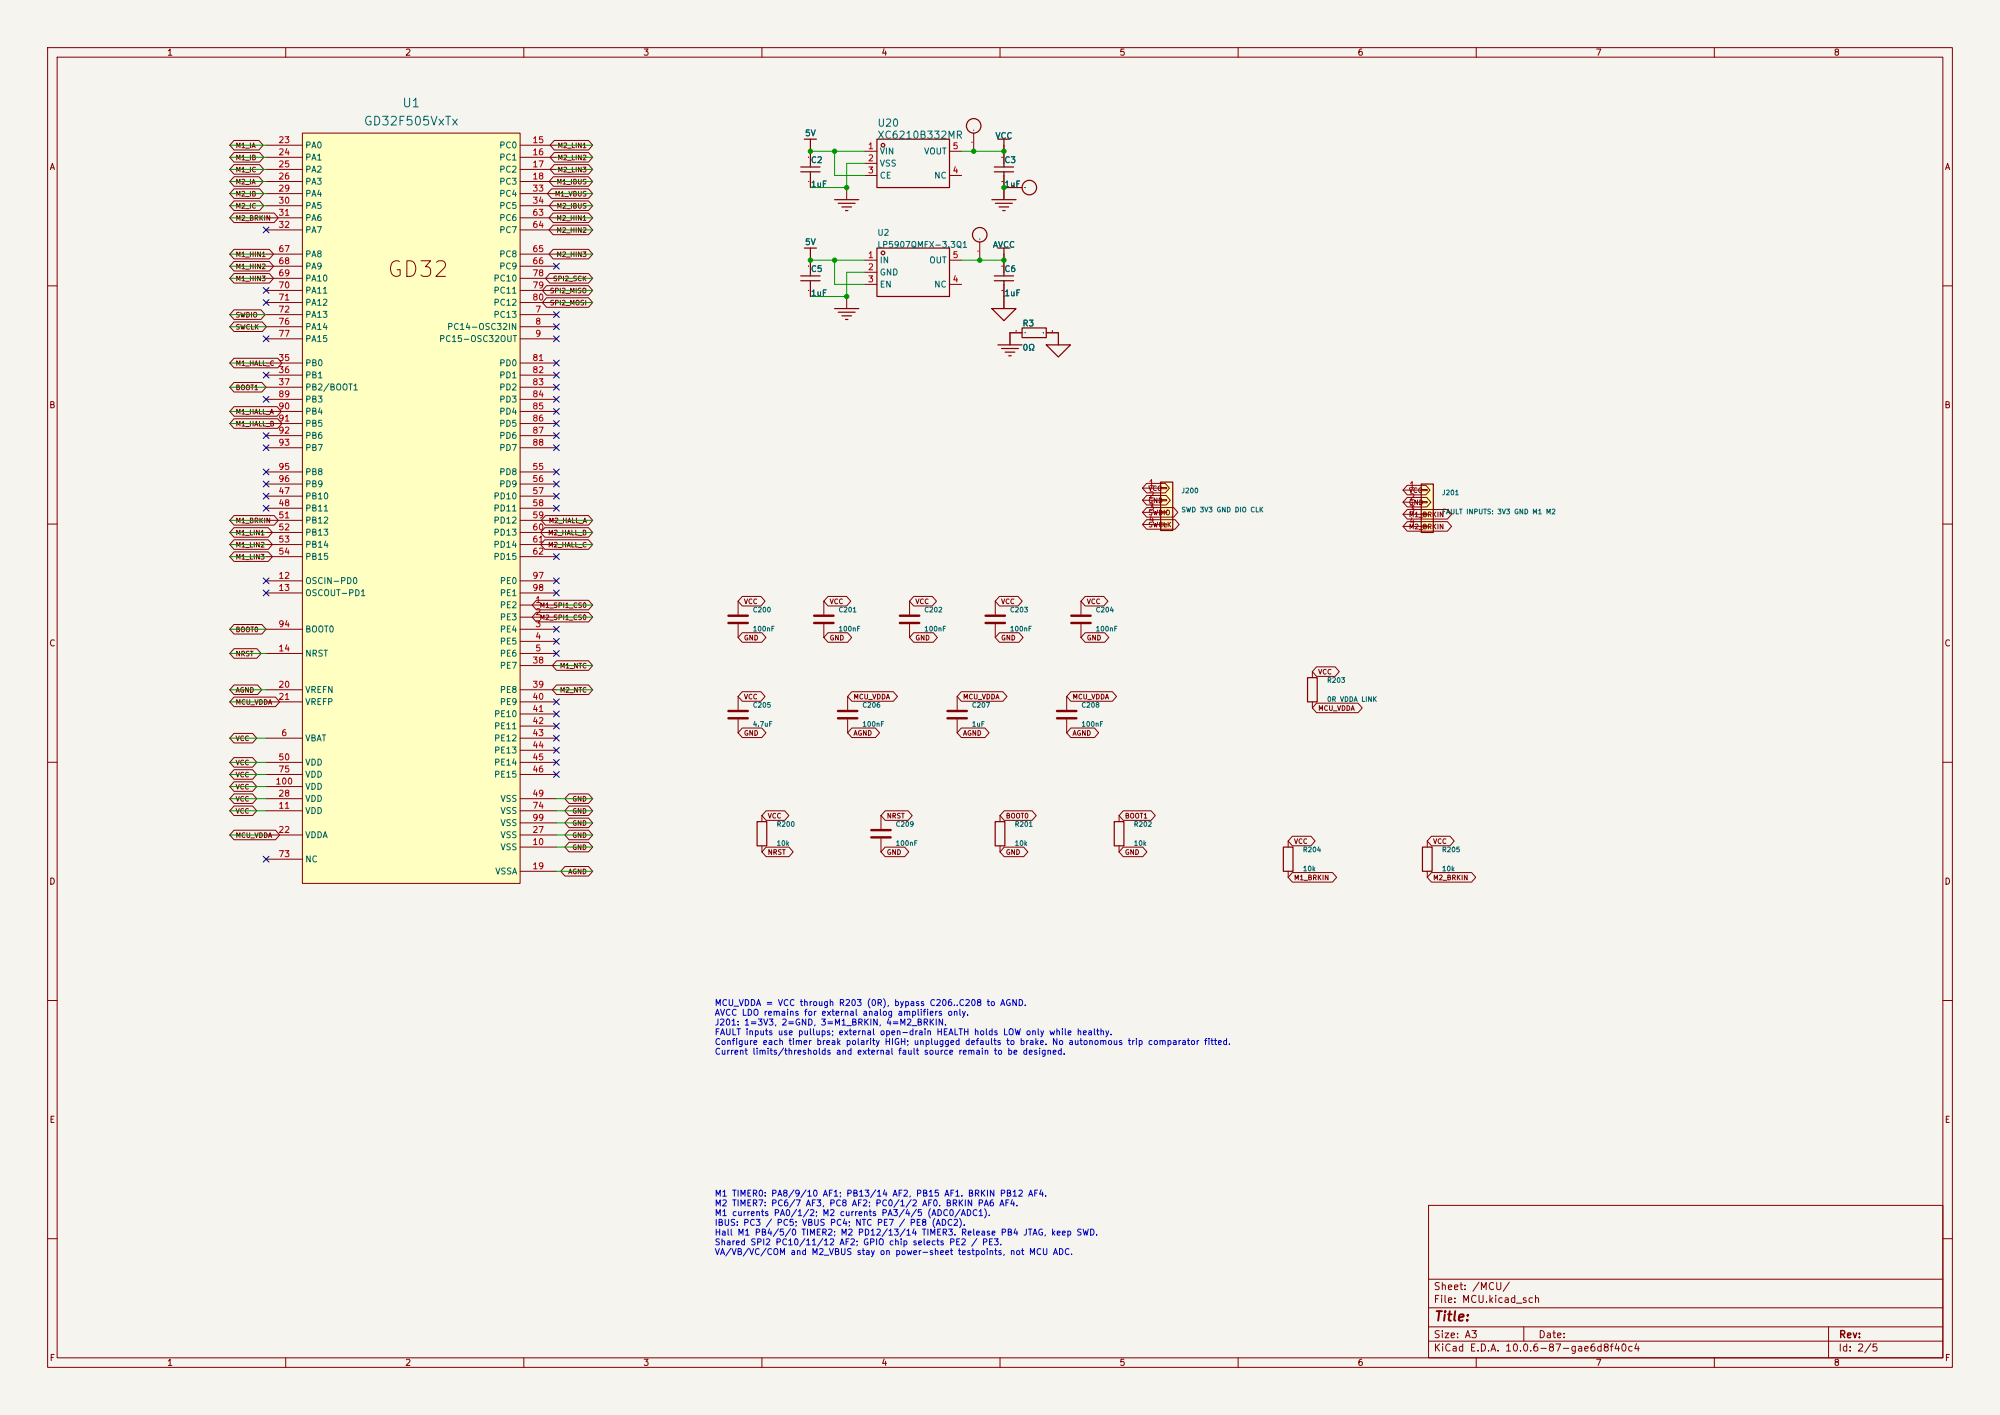
[picture p27: page 2]

SWD 3V3 GND DIO CLK

Configure each timer break polarity HIGH; unplugged defaults to brake. No autonomous trip comparator fitted. Current limits/thresholds and external fault source remain to be designed. M1 TIMER0: PA8/9/10 AF1; PB13/14 AF2, PB15 AF1. BRKIN PB12 AF4. M2 TIMER7: PC6/7 AF3, PC8 AF2; PC0/1/2 AF0. BRKIN PA6 AF4. M1 currents PA0/1/2; M2 currents PA3/4/5 (ADC0/ADC1).

IBUS: PC3 / PC5; VBUS PC4; NTC PE7 / PE8 (ADC2). Hall M1 PB4/5/0 TIMER2; M2 PD12/13/14 TIMER3. Release PB4 JTAG, keep SWD. Shared SPI2 PC10/11/12 AF2; GPIO chip selects PE2 / PE3. VA/VB/VC/COM and M2_VBUS stay on power-sheet testpoints, not MCU ADC.

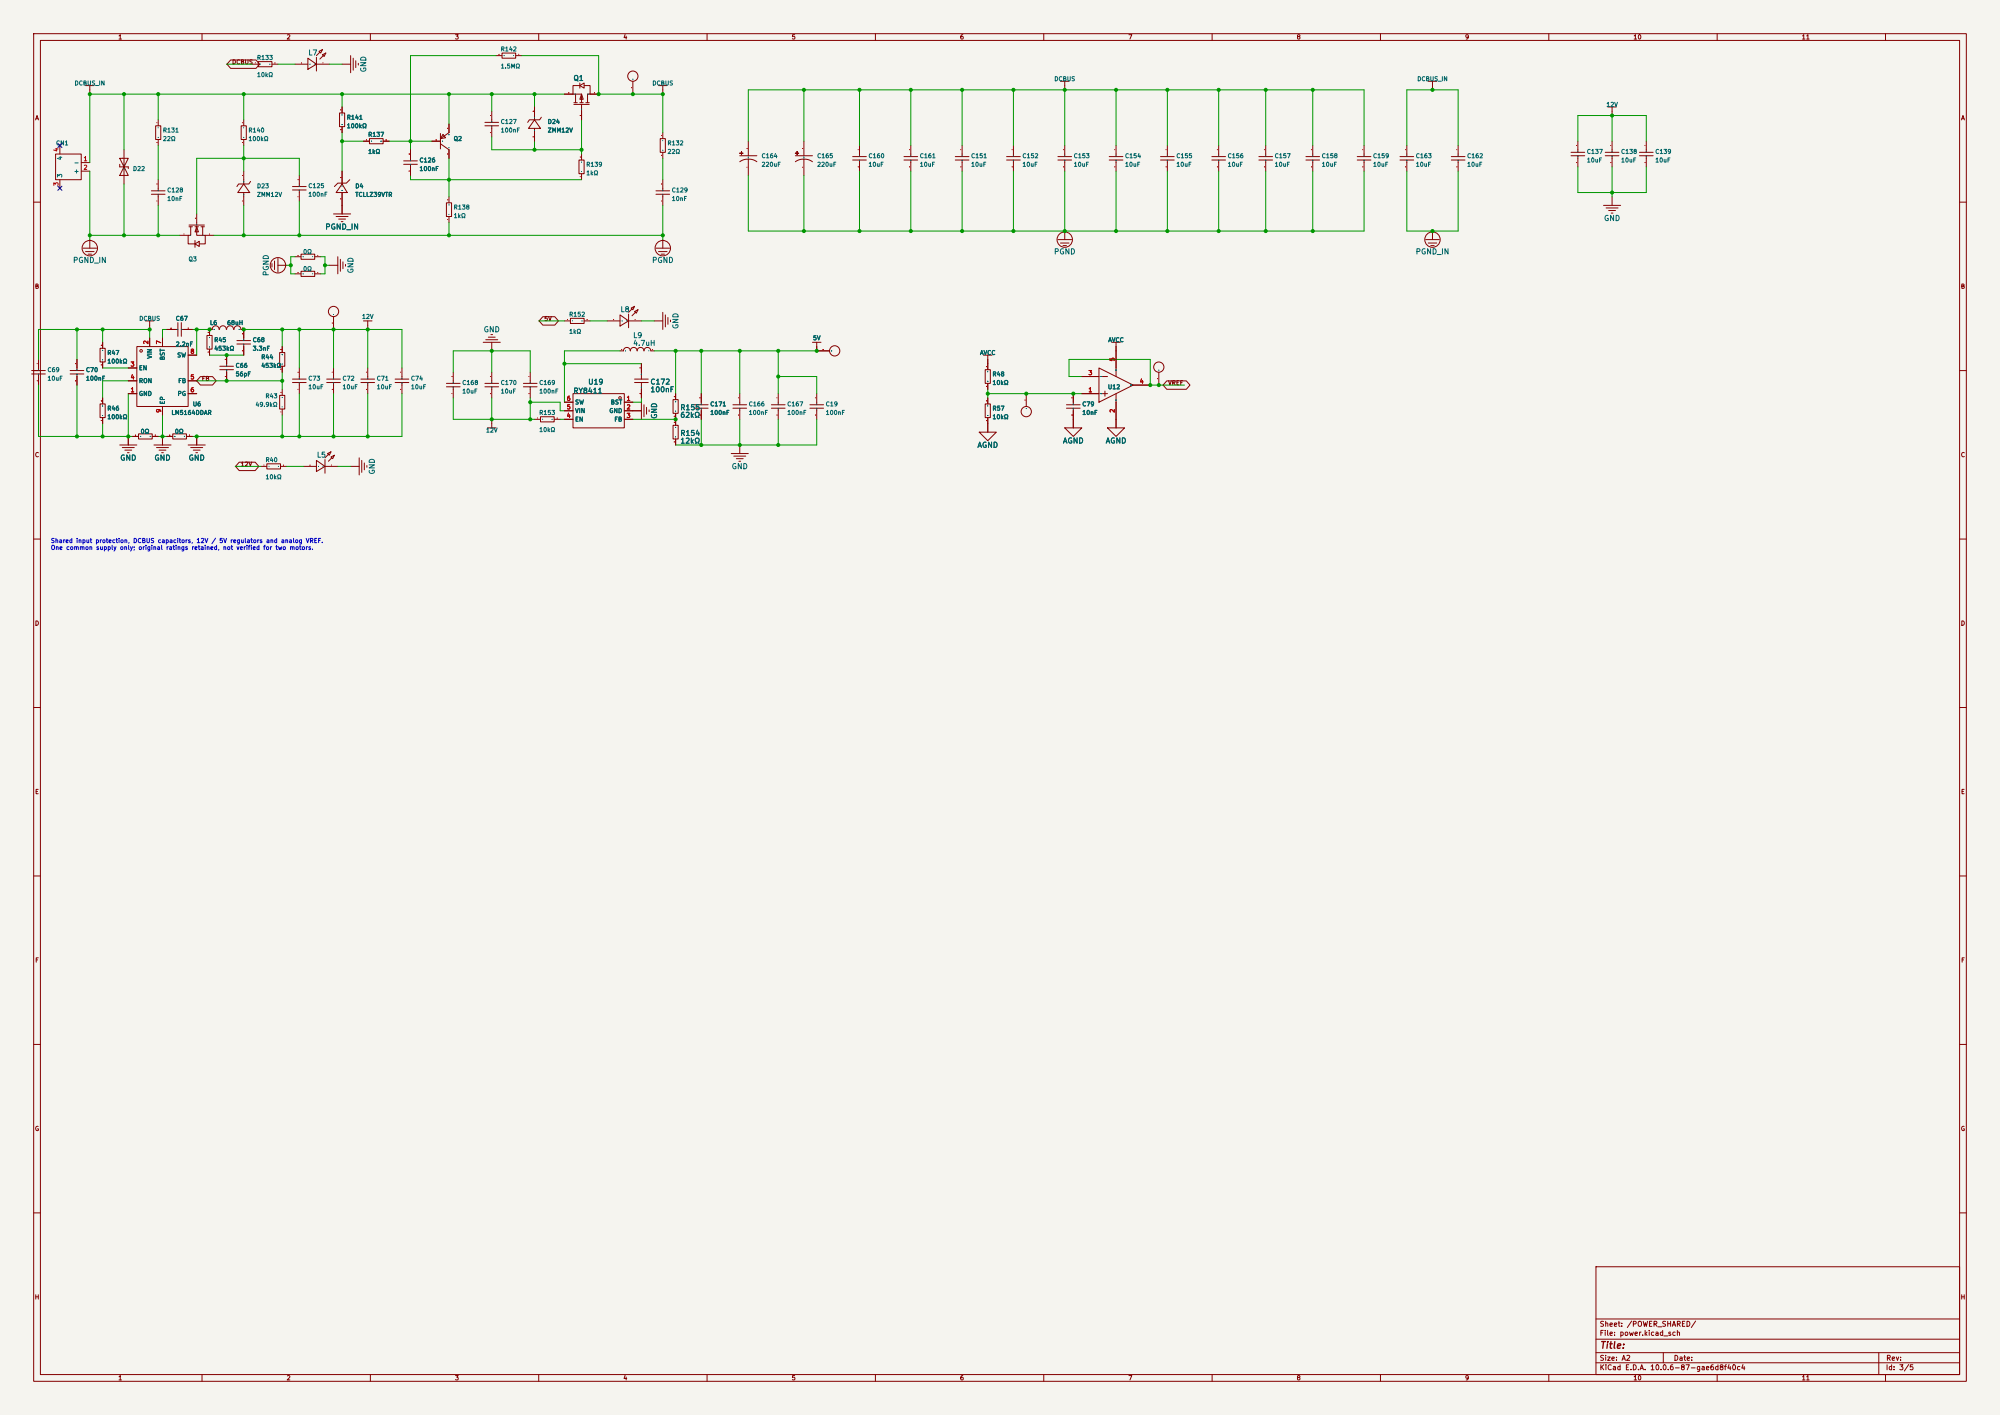
[picture p28: page 3]

VREF 5V Shared input protection, DCBUS capacitors, 12V / 5V regulators and analog VREF. One common supply only; original ratings retained, not verified for two motors. C66

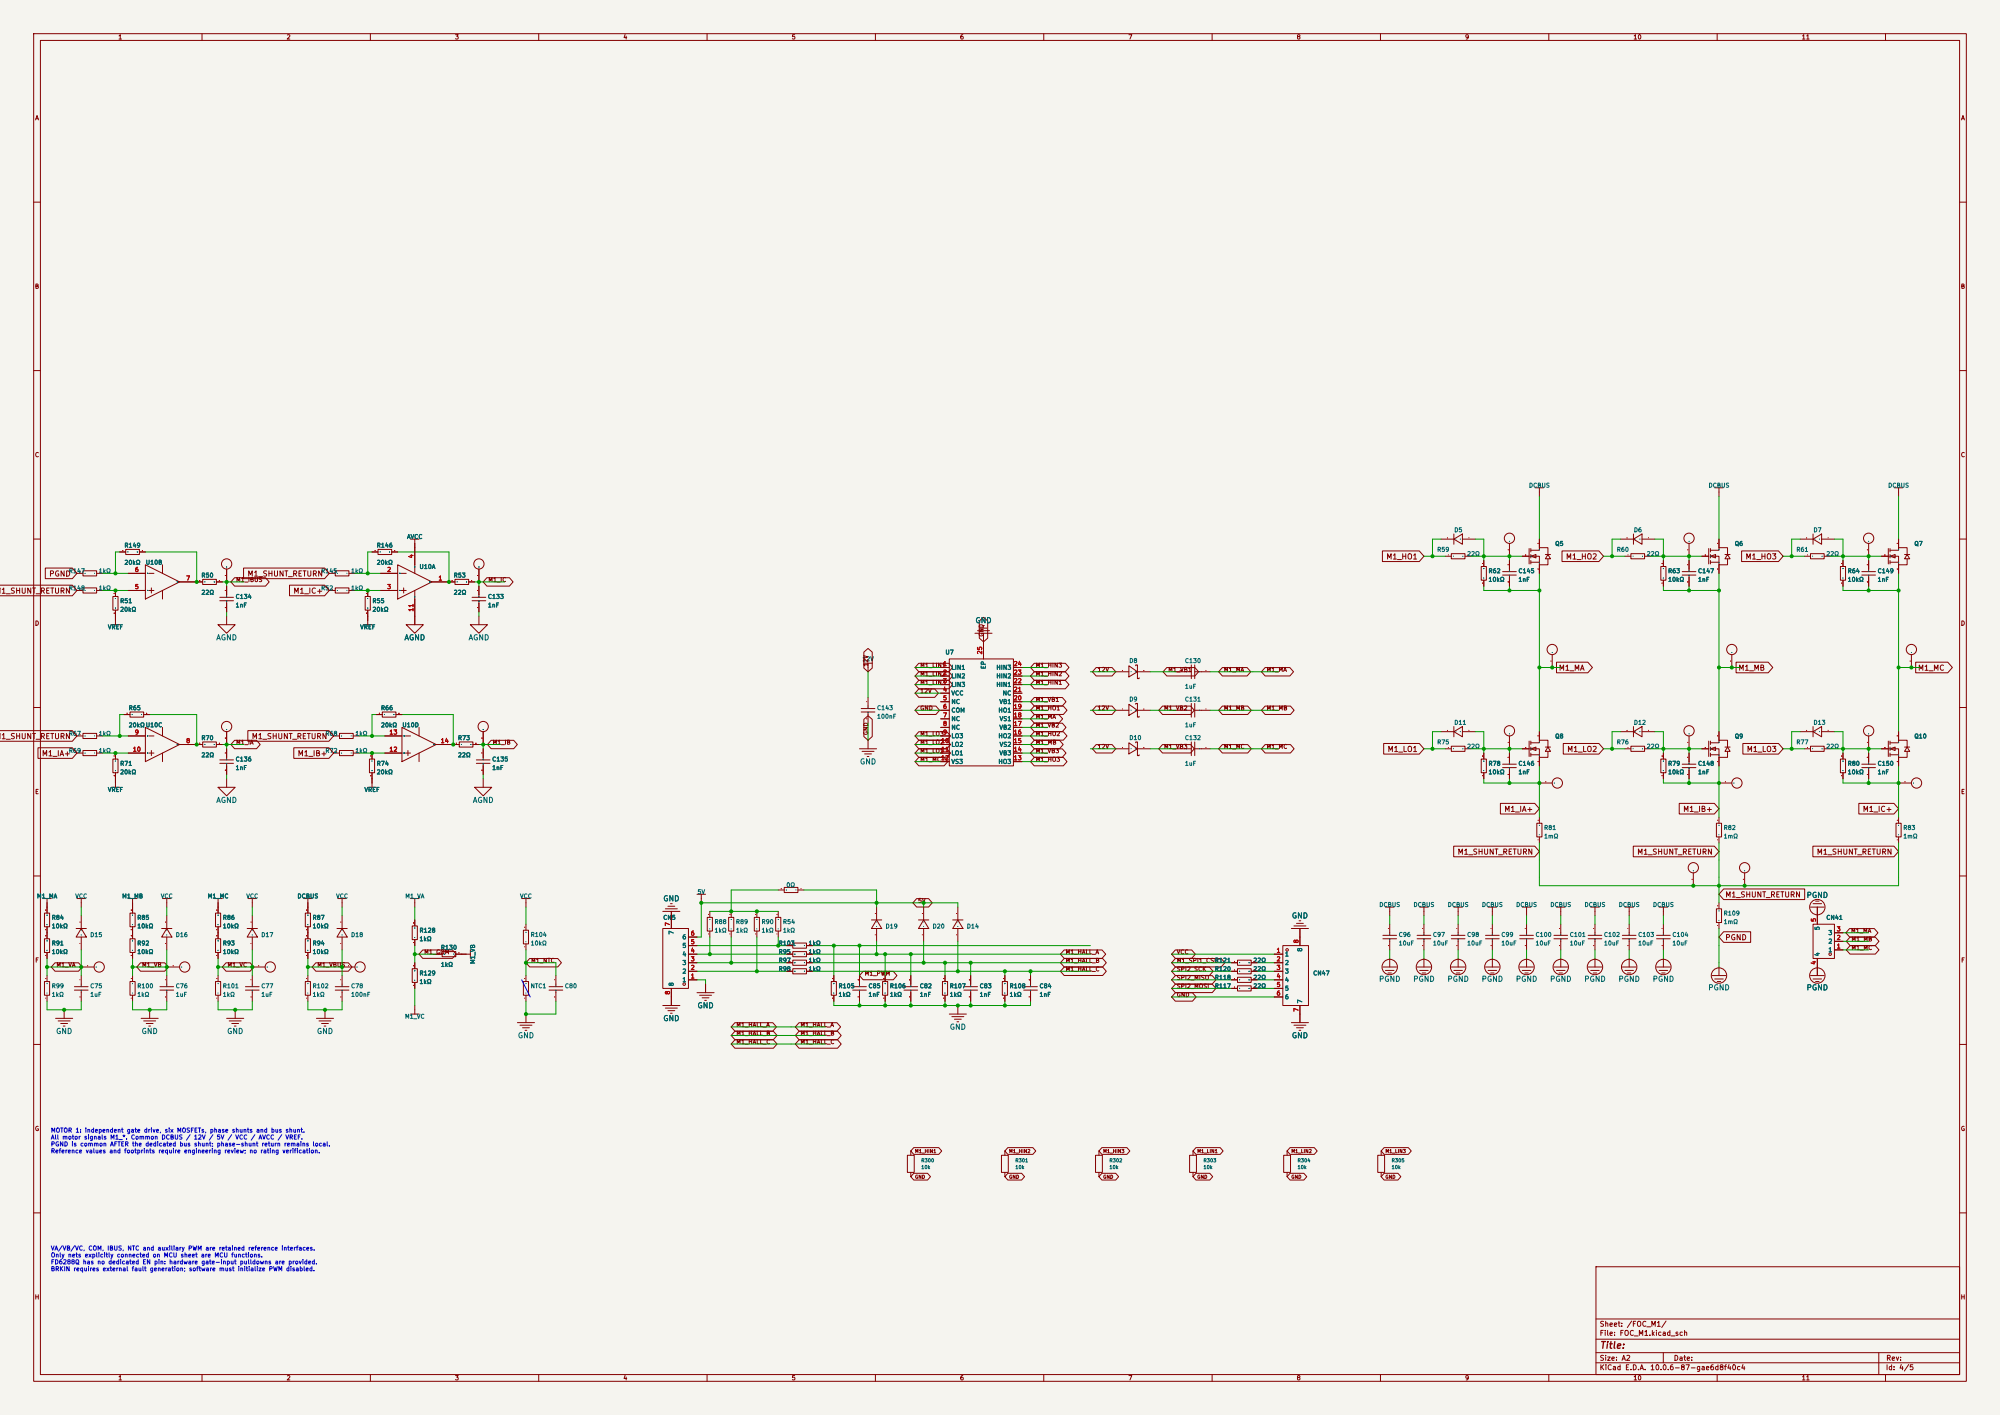
[picture p29: page 4]

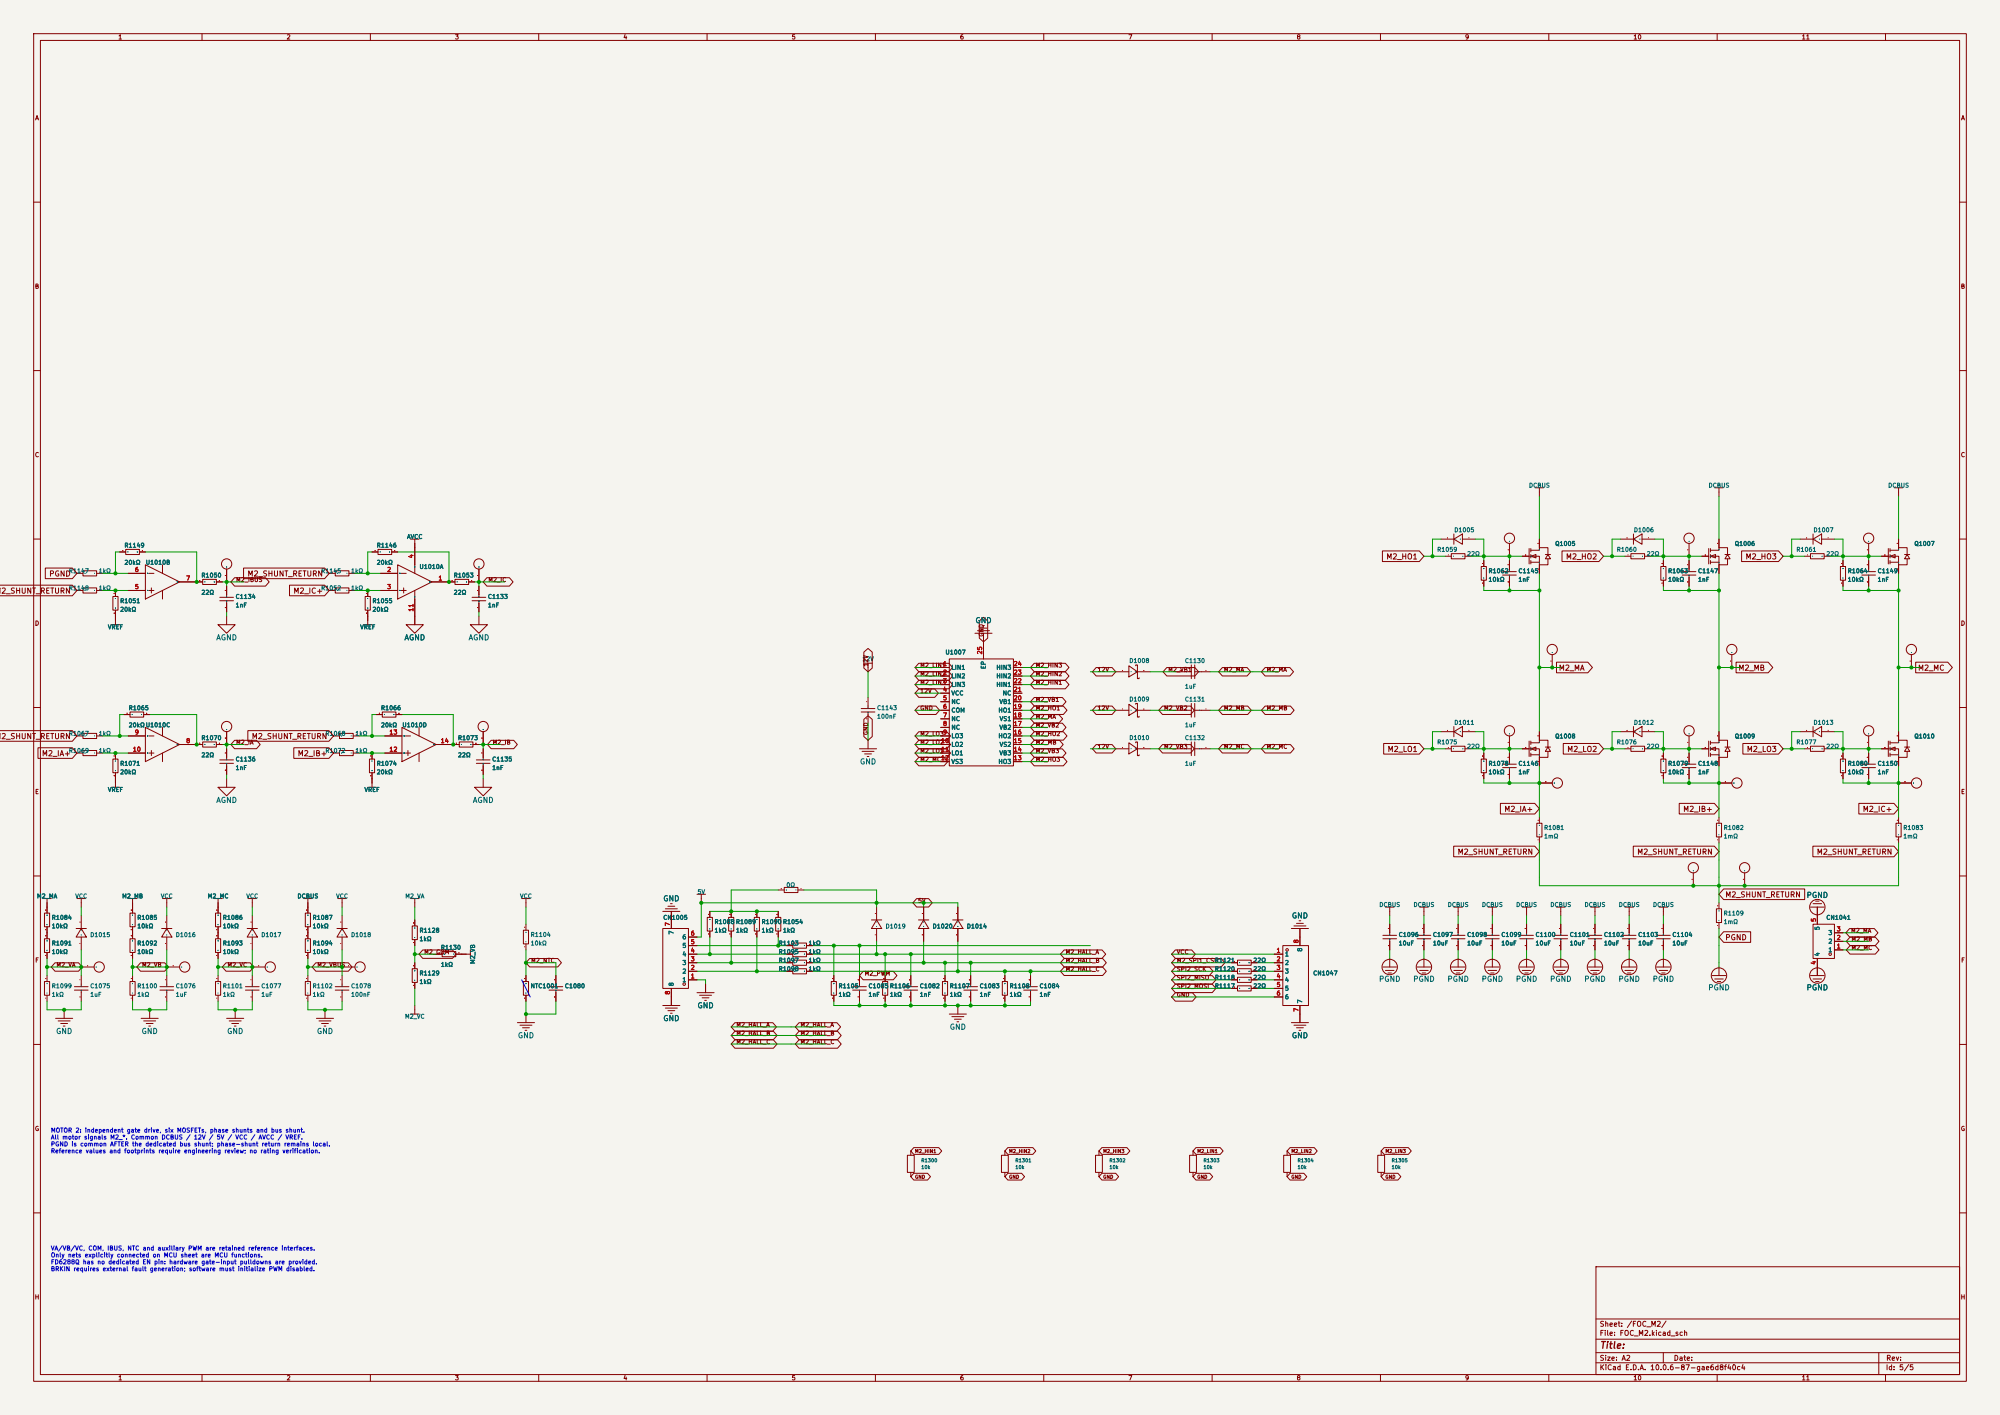
[picture p30: page 5]
