CYFS3/GD32FOC/hslink_cleanup/after.pdf

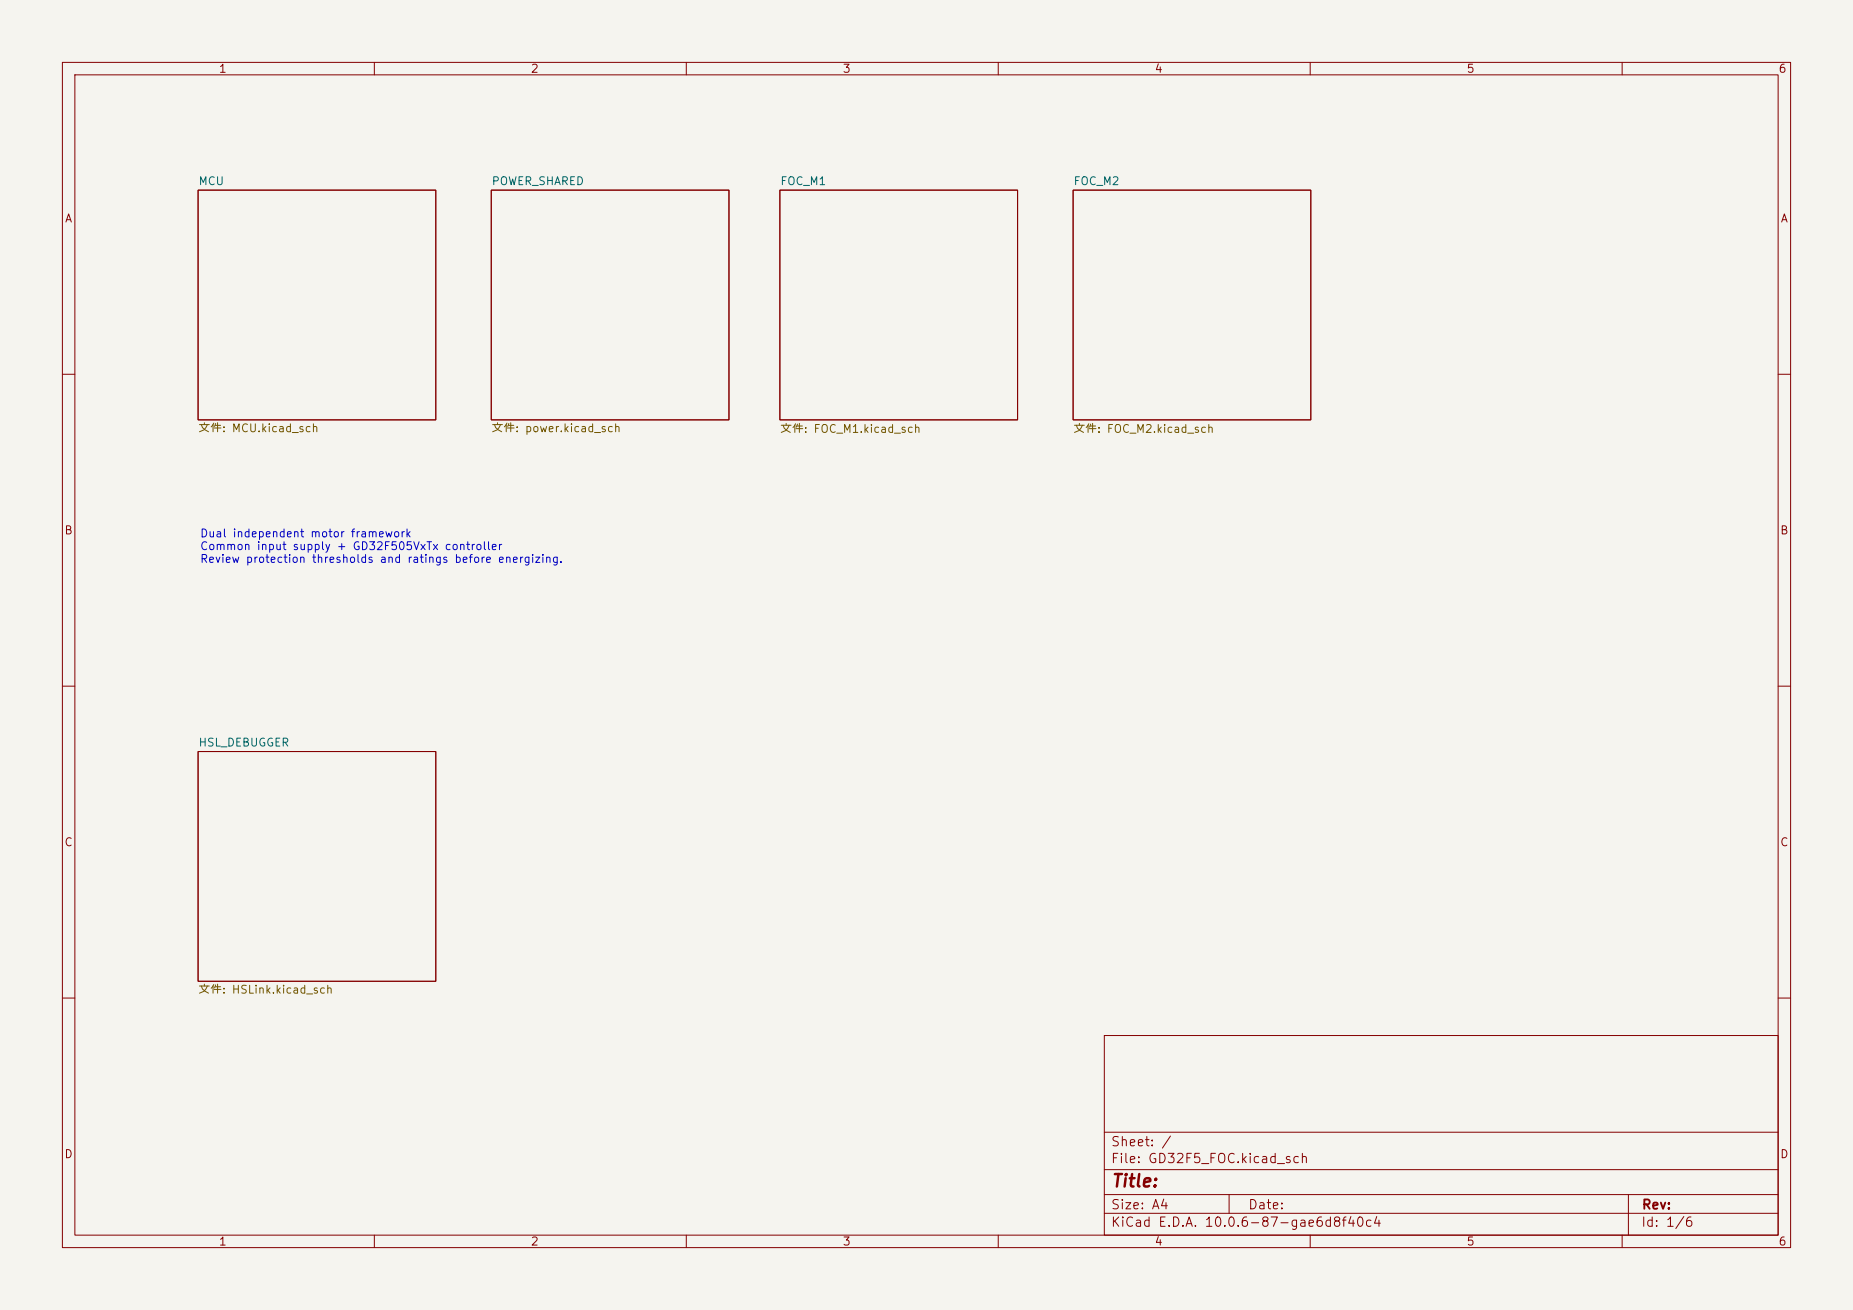
[picture p31: page 1]

FOC_M2 文件: FOC_M2.kicad_sch HSL_DEBUGGER 文件: HSLink.kicad_sch Dual independent motor framework Common input supply + GD32F505VxTx controller Review protection thresholds and ratings before energizing.

Size: A4 | Rev:
KiCad E.D.A. 10.0.6-87-gae6d8f40c4 | Id: 1/6

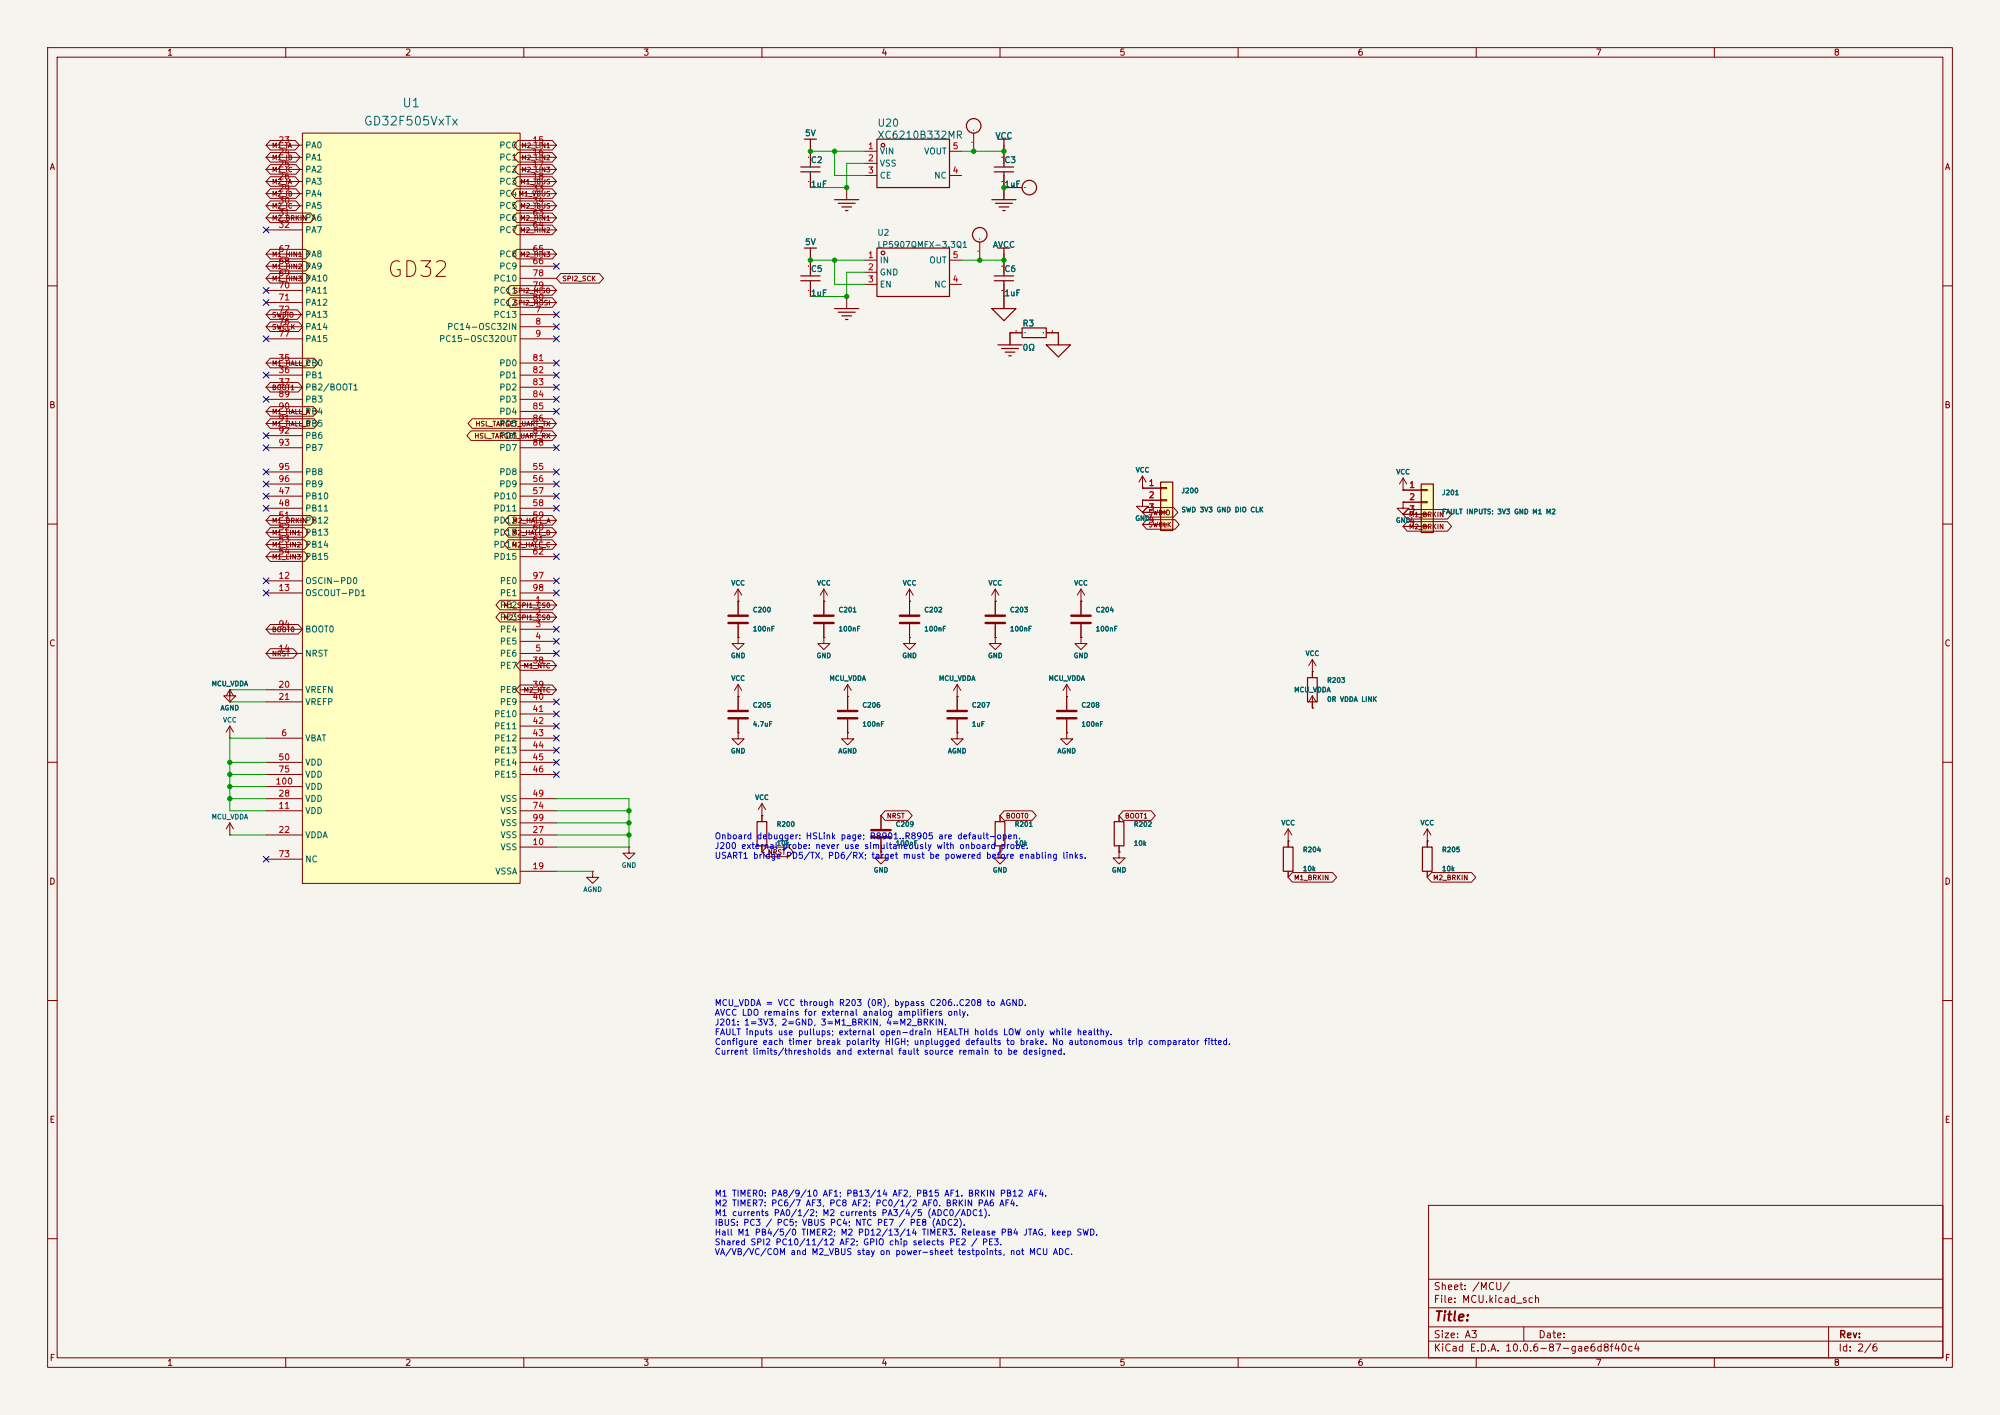
[picture p32: page 2]

SWD 3V3 GND DIO CLK 123

SWD 3V3 GND DIO CLK

Configure each timer break polarity HIGH; unplugged defaults to brake. No autonomous trip comparator fitted. Current limits/thresholds and external fault source remain to be designed. MCU_VDDA

M1 TIMER0: PA8/9/10 AF1; PB13/14 AF2, PB15 AF1. BRKIN PB12 AF4. M2 TIMER7: PC6/7 AF3, PC8 AF2; PC0/1/2 AF0. BRKIN PA6 AF4. M1 currents PA0/1/2; M2 currents PA3/4/5 (ADC0/ADC1).

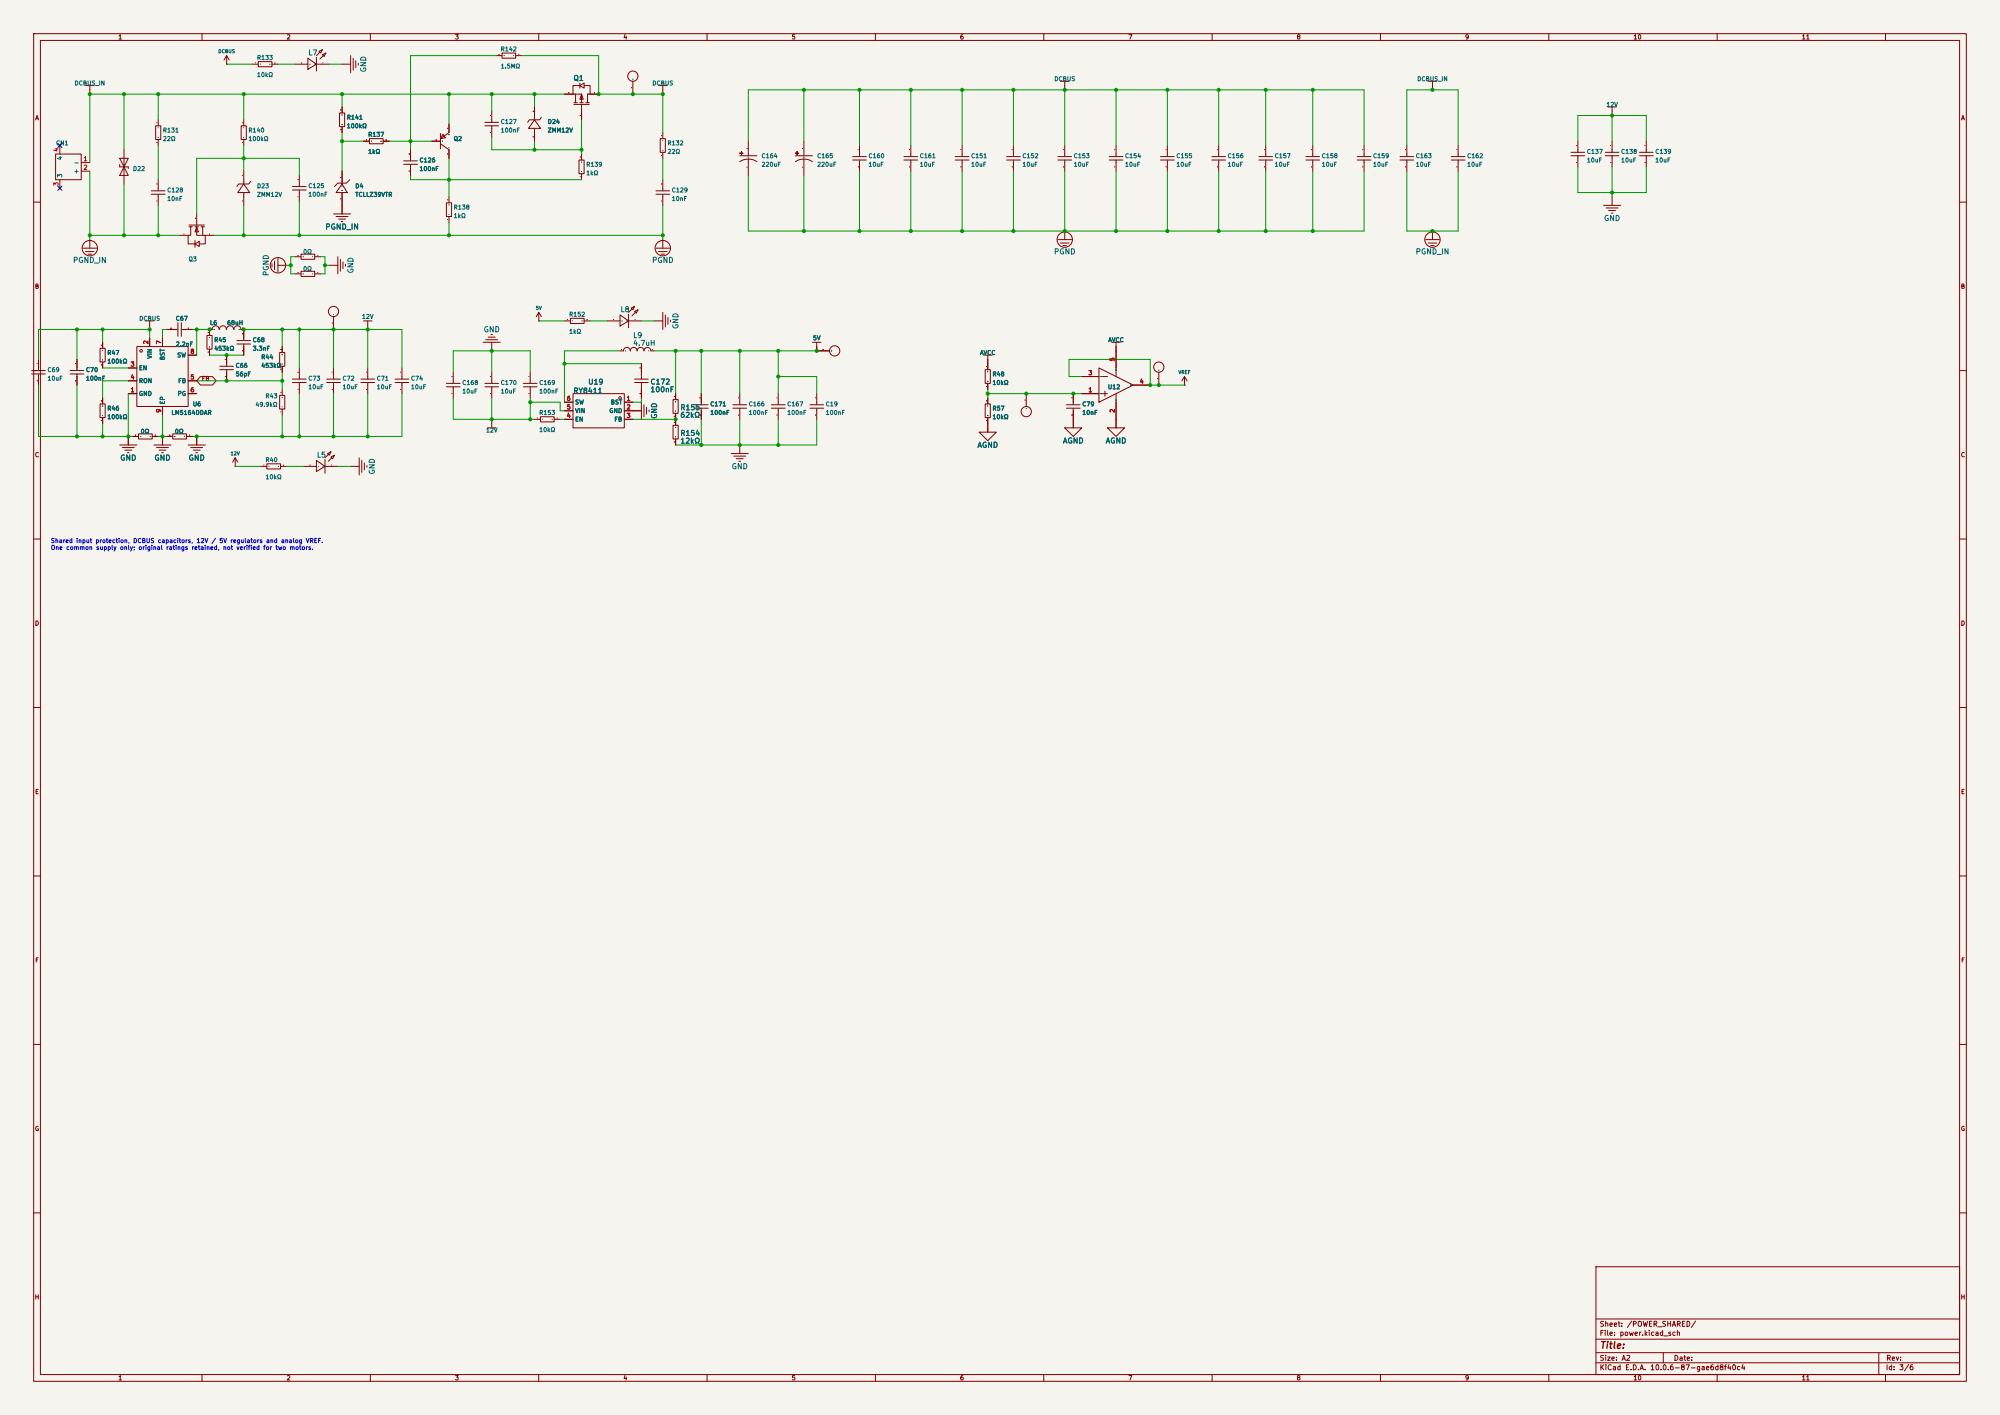
[picture p33: page 3]

Shared input protection, DCBUS capacitors, 12V / 5V regulators and analog VREF. One common supply only; original ratings retained, not verified for two motors. R44

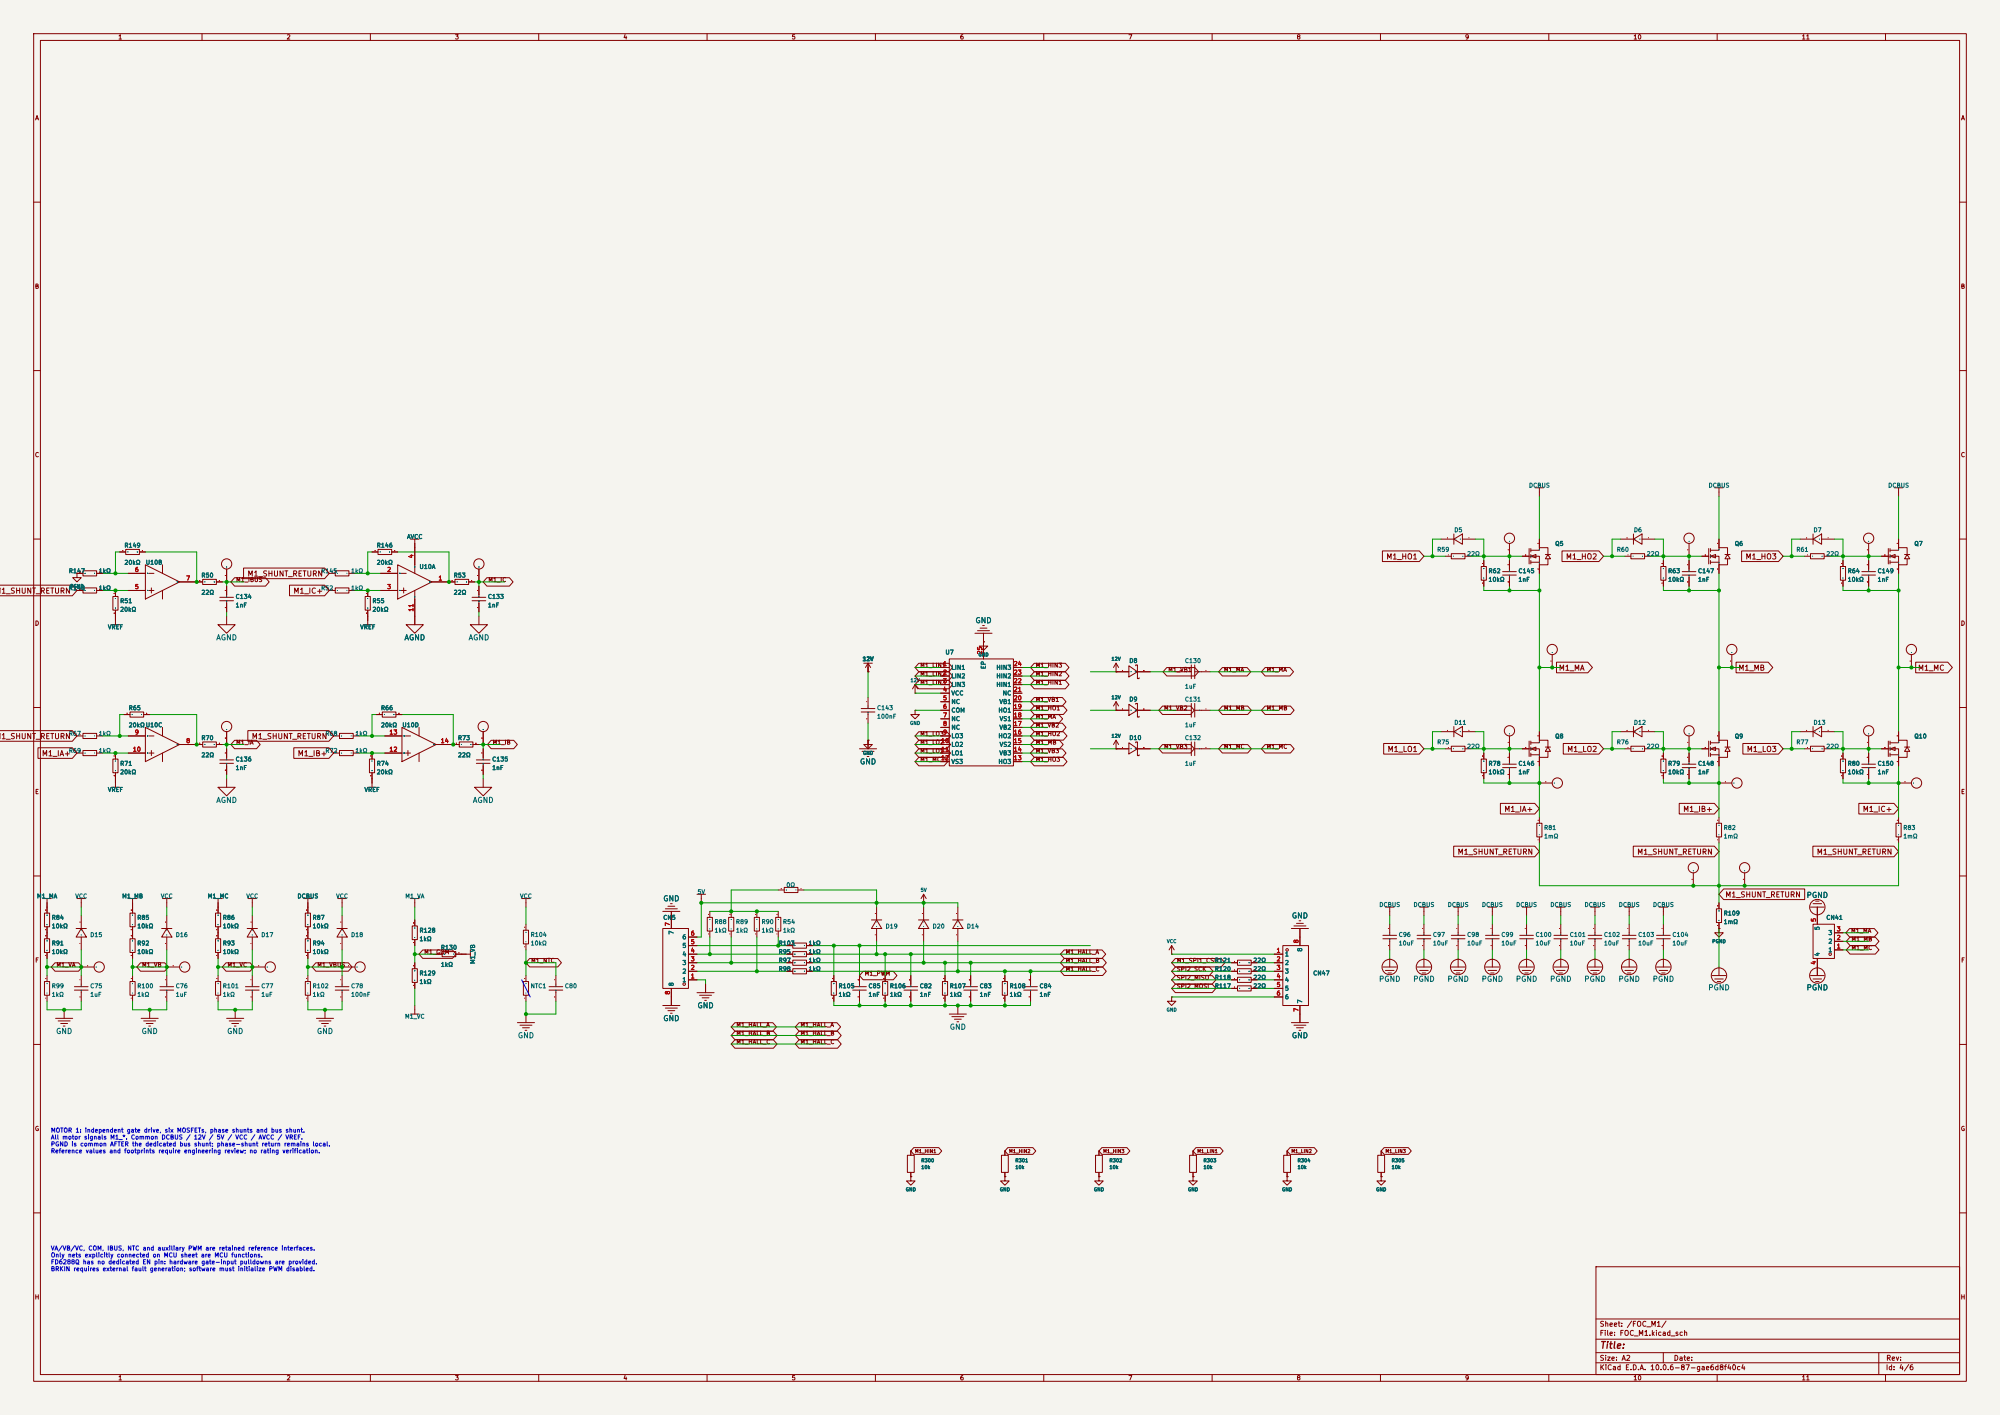
[picture p34: page 4]

VA/VB/VC, COM, IBUS, NTC and auxiliary PWM are retained reference interfaces. Only nets explicitly connected on MCU sheet are MCU functions. FD6288Q has no dedicated EN pin: hardware gate-input pulldowns are provided. BRKIN requires external fault generation; software must initialize PWM disabled. MOTOR 1: independent gate drive, six MOSFETs, phase shunts and bus shunt. All motor signals M1_*. Common DCBUS / 12V / 5V / VCC / AVCC / VREF. PGND is common AFTER the dedicated bus shunt; phase-shunt return remains local. Reference values and footprints require engineering review; no rating verification.

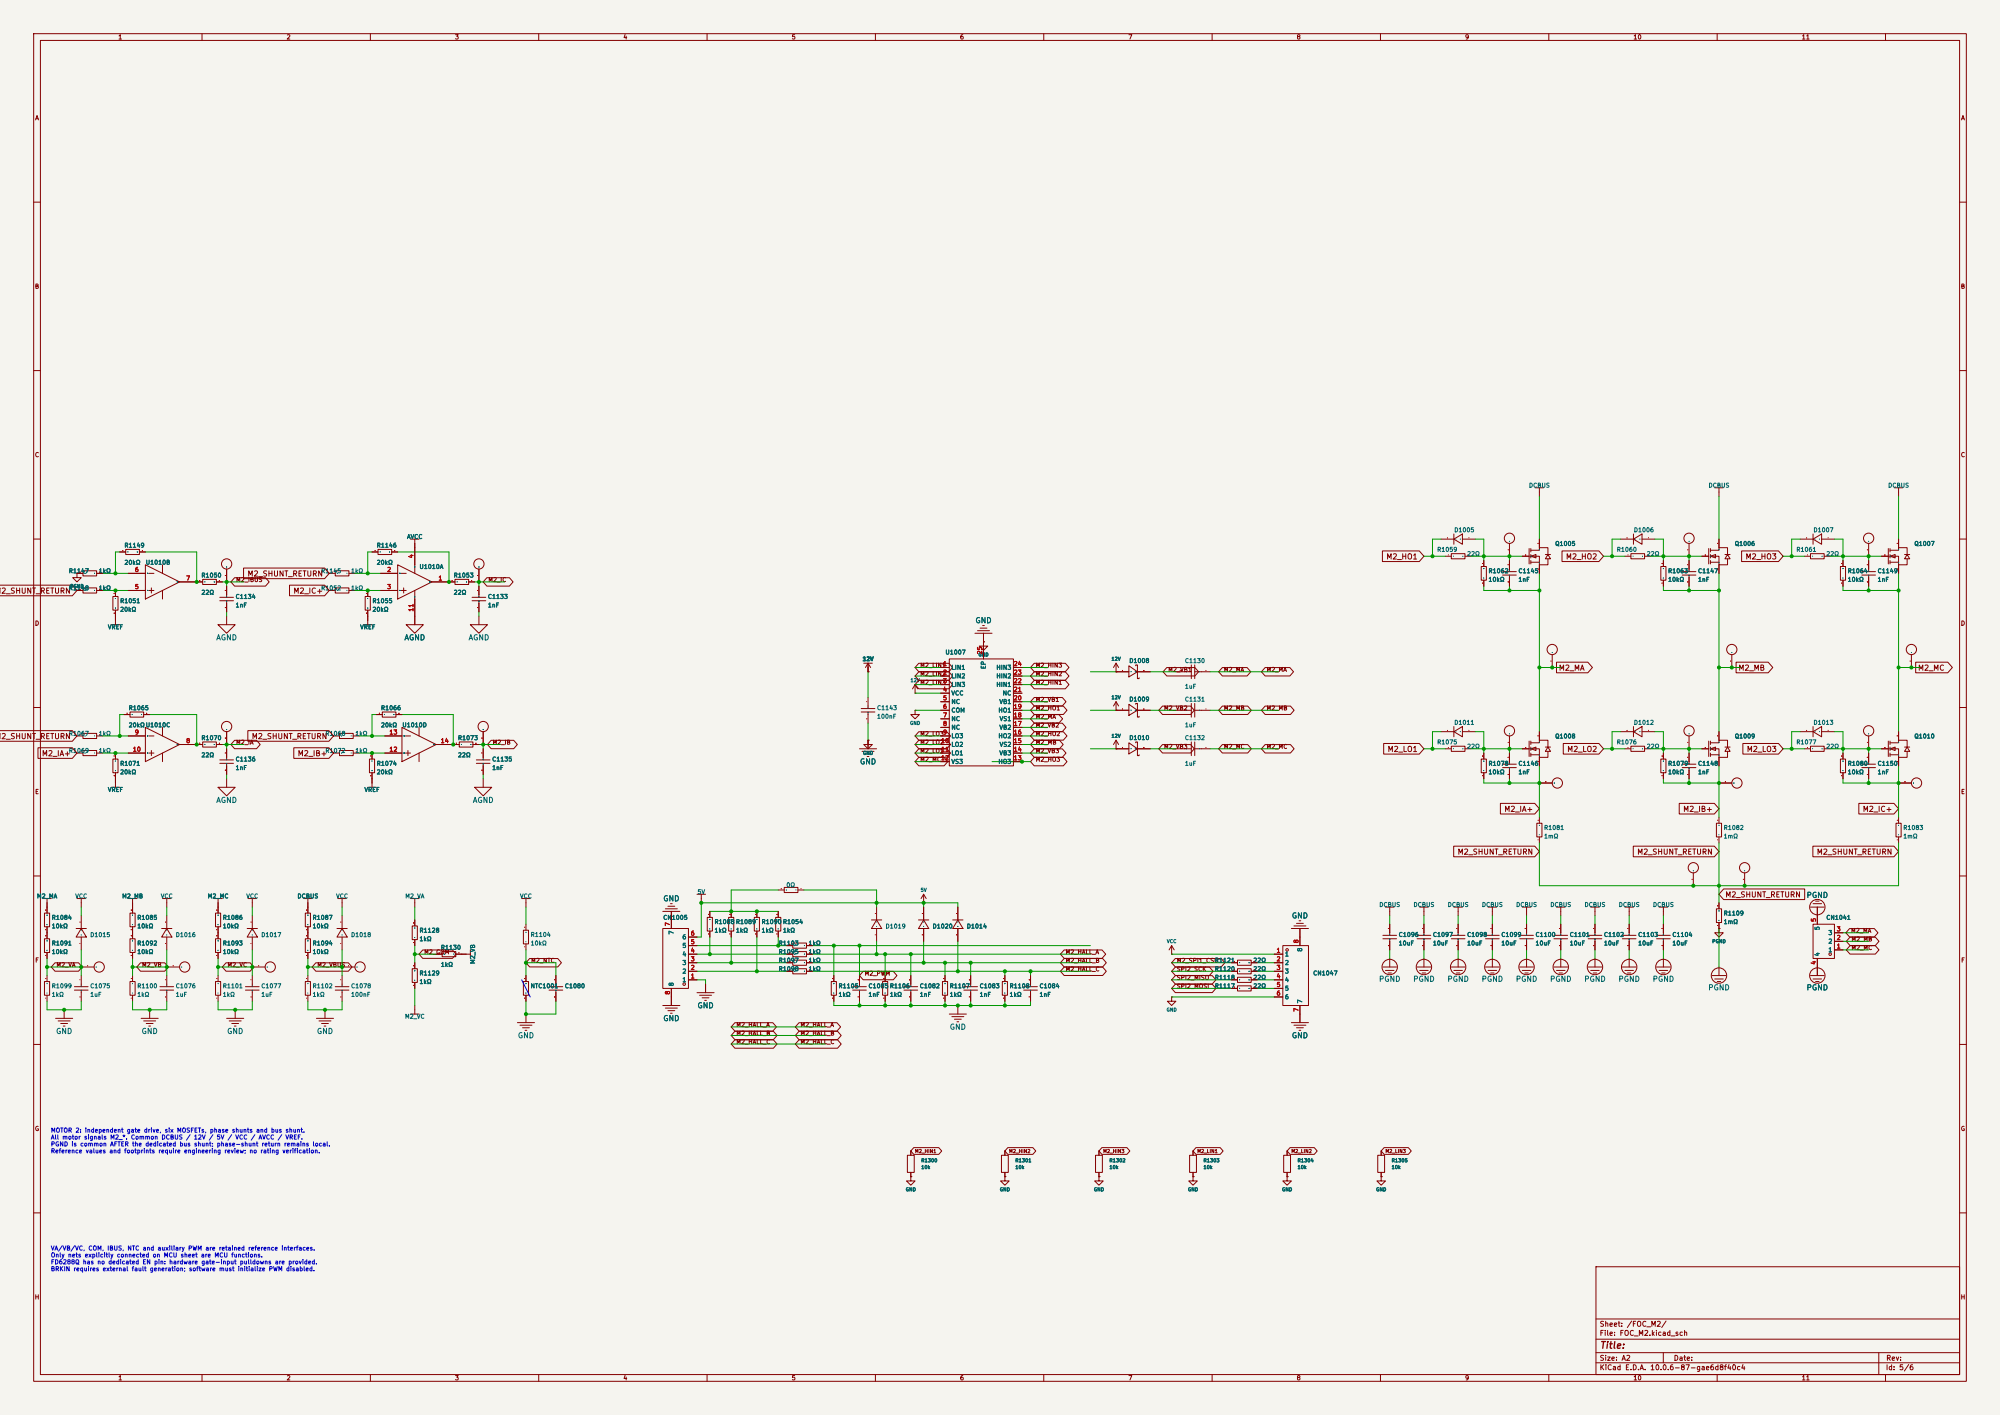
[picture p35: page 5]

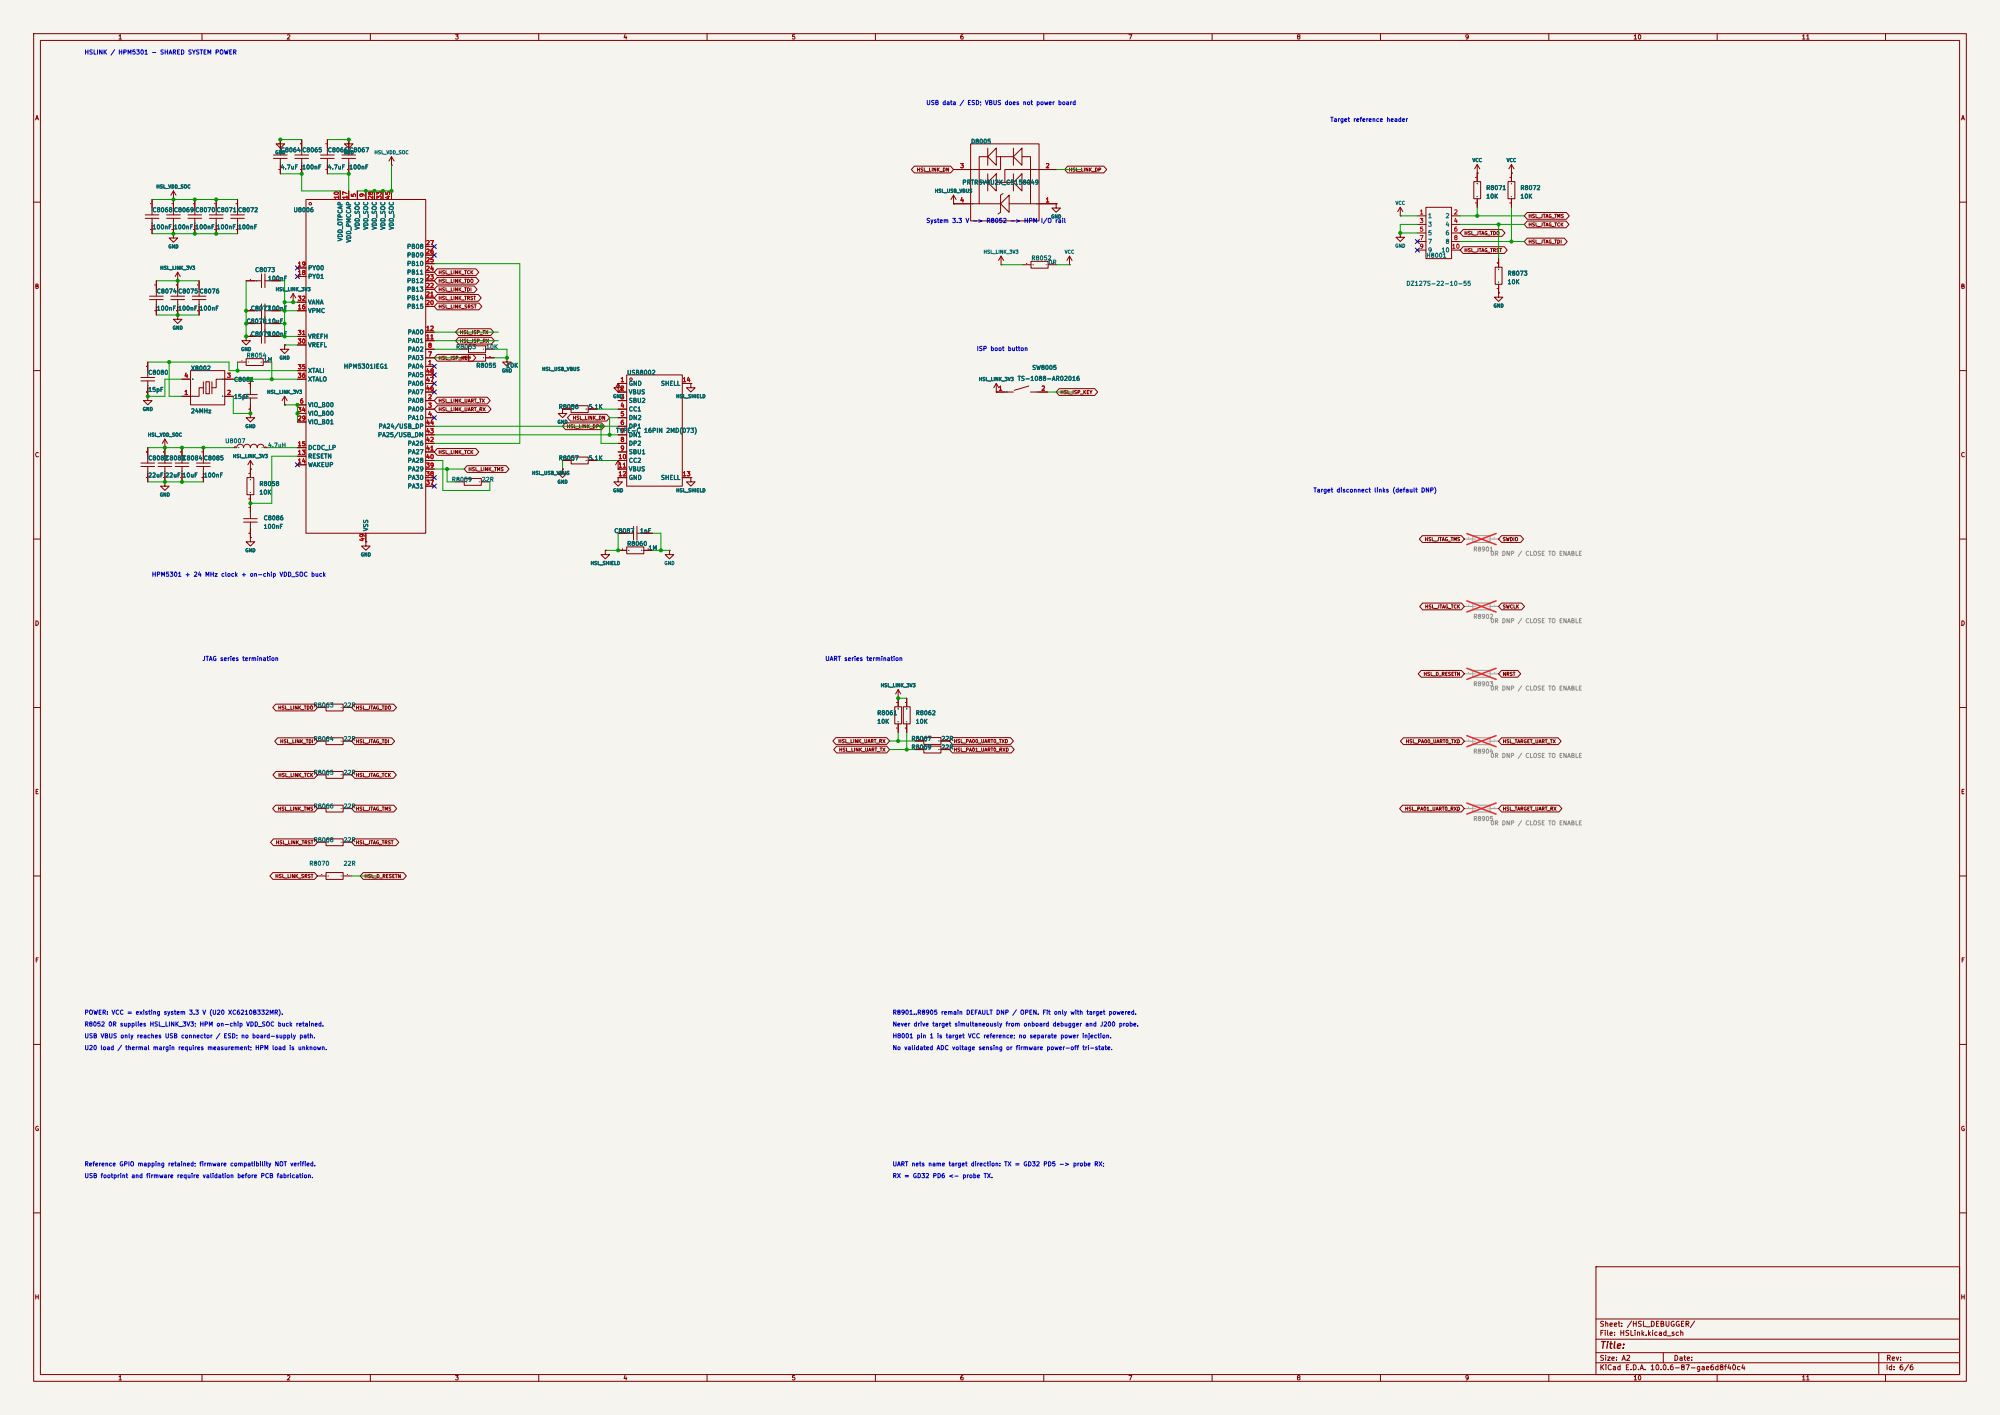
[picture p36: page 6]

HSLINK / HPM5301 - SHARED SYSTEM POWER

USB data / ESD; VBUS does not power board System 3.3 V -> R8052 -> HPM I/O rail

HPM5301 + 24 MHz clock + on-chip VDD_SOC buck

USB VBUS only reaches USB connector / ESD; no board-supply path.

H8001 pin 1 is target VCC reference; no separate power injection. No validated ADC voltage sensing or firmware power-off tri-state.
