CYFS3/GD32FOC/hslink_review/GD32F5_FOC_HSLink.pdf

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

Size: A4 | Rev:
KiCad E.D.A. 10.0.6-87-gae6d8f40c4 | Id: 1/6


SWD 3V3 GND DIO CLK 123

SWD 3V3 GND DIO CLK

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


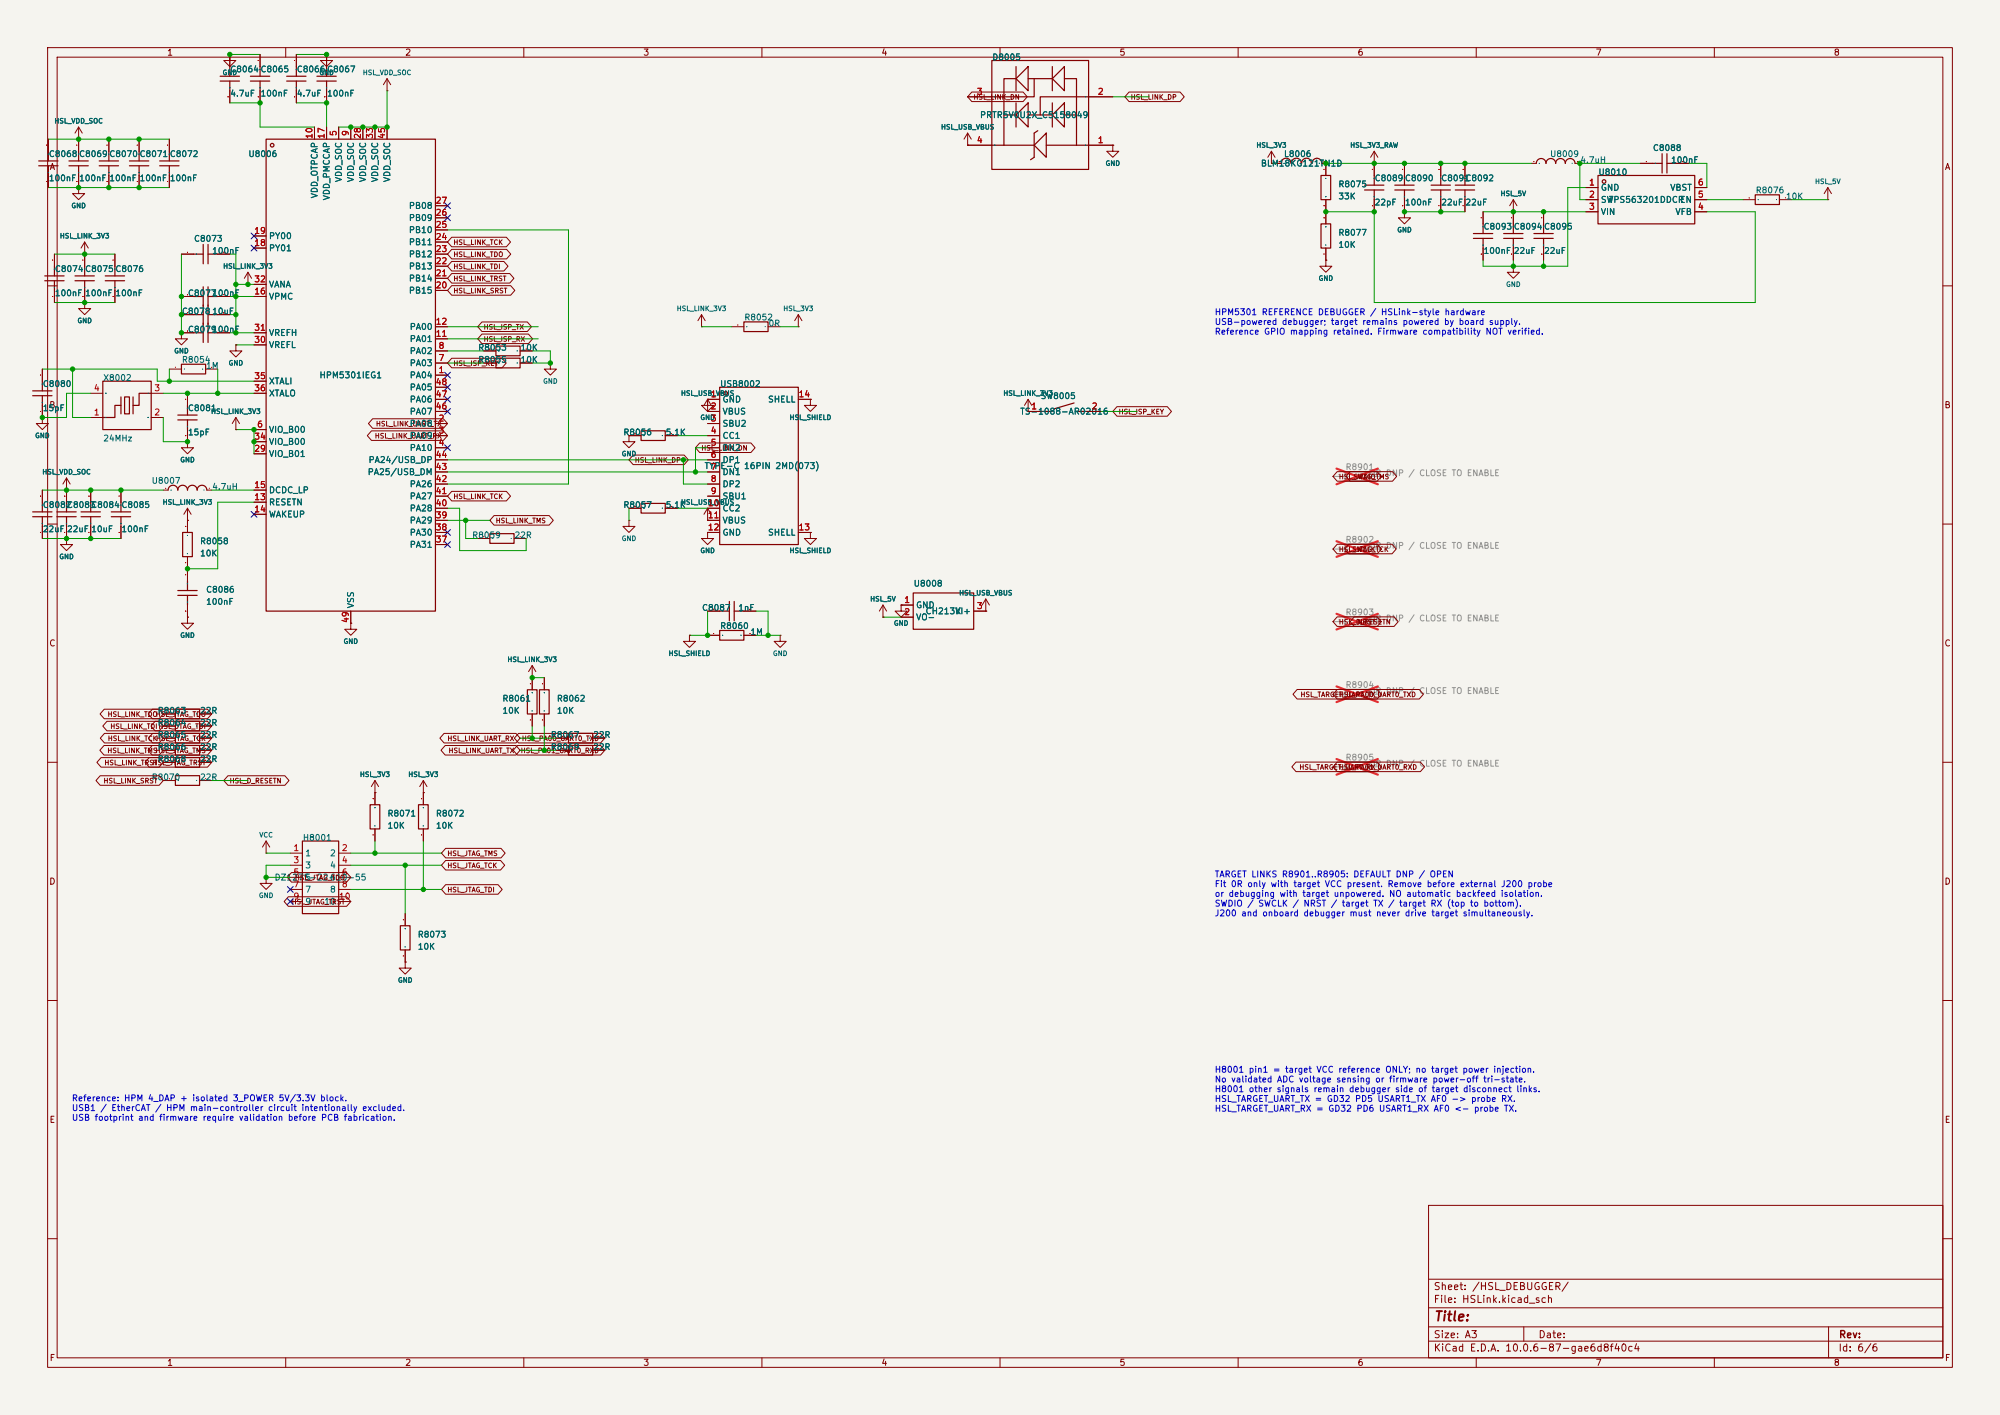
[picture p37: page 6]

NRST HPM5301 REFERENCE DEBUGGER / HSLink-style hardware USB-powered debugger; target remains powered by board supply. Reference GPIO mapping retained. Firmware compatibility NOT verified.

2 R89010R DNP / CLOSE TO ENABLE
SWDIO

2 R89030R DNP / CLOSE TO ENABLE

2 R89040R DNP / CLOSE TO ENABLE

2 R89050R DNP / CLOSE TO ENABLE

Fit 0R only with target VCC present. Remove before external J200 probe or debugging with target unpowered. NO automatic backfeed isolation. SWDIO / SWCLK / NRST / target TX / target RX (top to bottom). J200 and onboard debugger must never drive target simultaneously. H8001 pin1 = target VCC reference ONLY; no target power injection. No validated ADC voltage sensing or firmware power-off tri-state. H8001 other signals remain debugger side of target disconnect links. HSL_TARGET_UART_TX = GD32 PD5 USART1_TX AF0 -> probe RX. HSL_TARGET_UART_RX = GD32 PD6 USART1_RX AF0 <- probe TX.
