CYFS3/GD32FOC/interface_review/interface_stage.pdf

INTERFACE 文件: Interface.kicad_sch Dual independent motor framework Common input supply + GD32F505VxTx controller Review protection thresholds and ratings before energizing.

Size: A4 | Rev:
KiCad E.D.A. 10.0.6-87-gae6d8f40c4 | Id: 1/7


SWD 3V3 GND DIO CLK 1234

SWD 3V3 GND DIO CLK

BOOT1 M1 TIMER0: PA8/9/10 AF1; PB13/14 AF2, PB15 AF1. BRKIN PB12 AF4. M2 TIMER7: PC6/7 AF3, PC8 AF2; PC0/1/2 AF0. BRKIN PA6 AF4. M1 currents PA0/1/2; M2 currents PA3/4/5 (ADC0/ADC1).

Configure each timer break polarity HIGH; unplugged defaults to brake. No autonomous trip comparator fitted. Current limits/thresholds and external fault source remain to be designed.

IBUS: PC3 / PC5; VBUS PC4; NTC PE7 / PE8 (ADC2). Hall M1 PB4/5/0 TIMER2; M2 PD12/13/14 TIMER3. Release PB4 JTAG, keep SWD. Shared SPI2 PC10/11/12 AF2; GPIO chip selects PE2 / PE3. VA/VB/VC/COM and M2_VBUS stay on power-sheet testpoints, not MCU ADC.


Shared input protection, DCBUS capacitors, 12V / 5V regulators and analog VREF. One common supply only; original ratings retained, not verified for two motors. R45

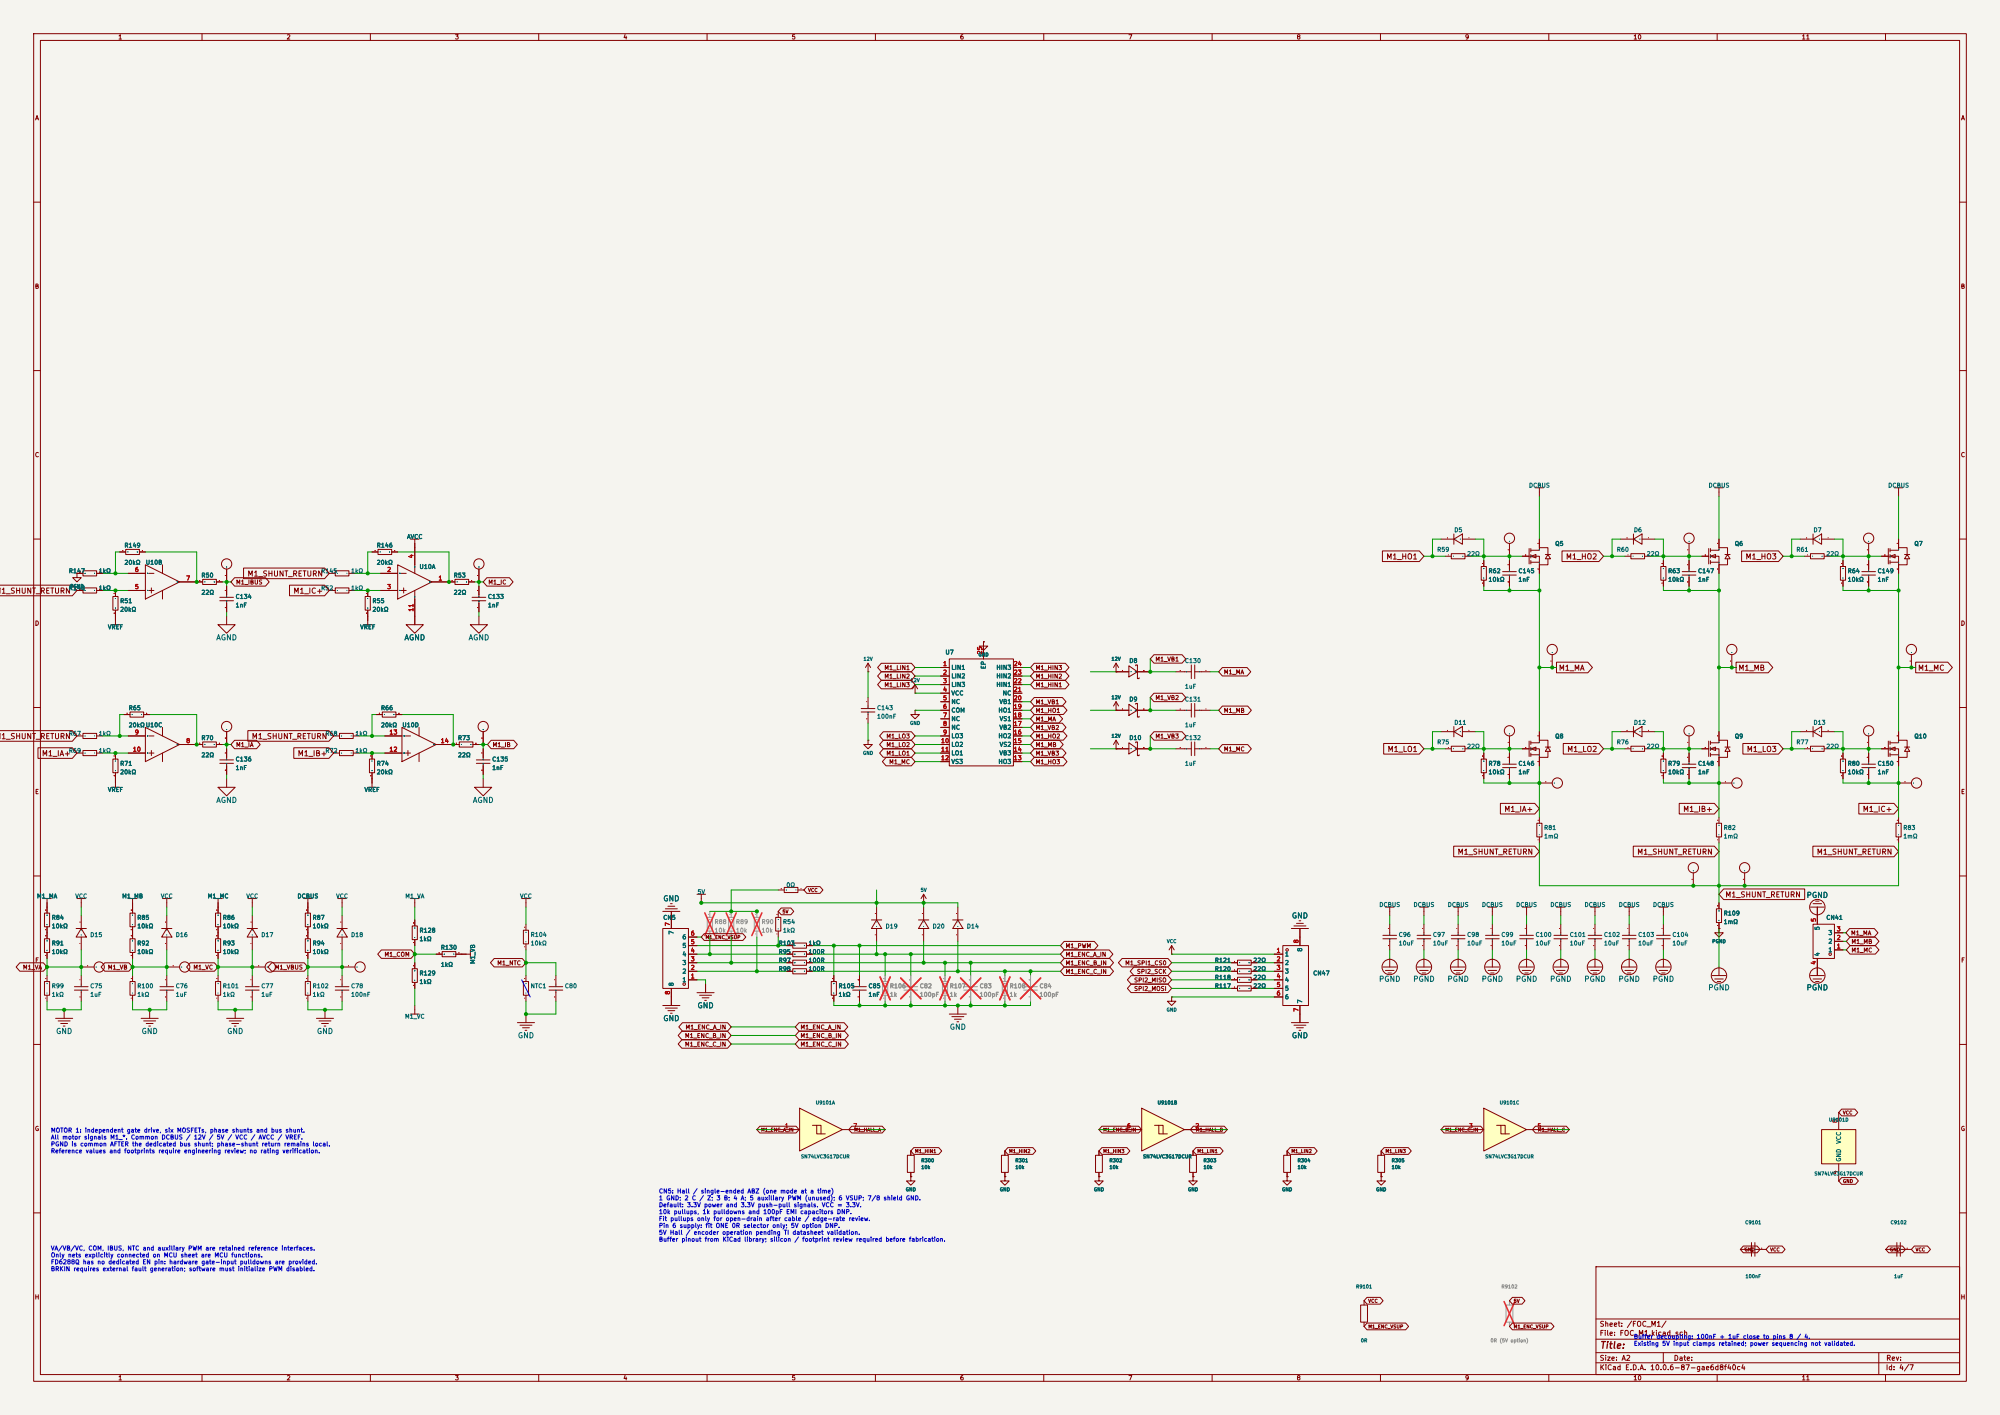
[picture p48: page 4]

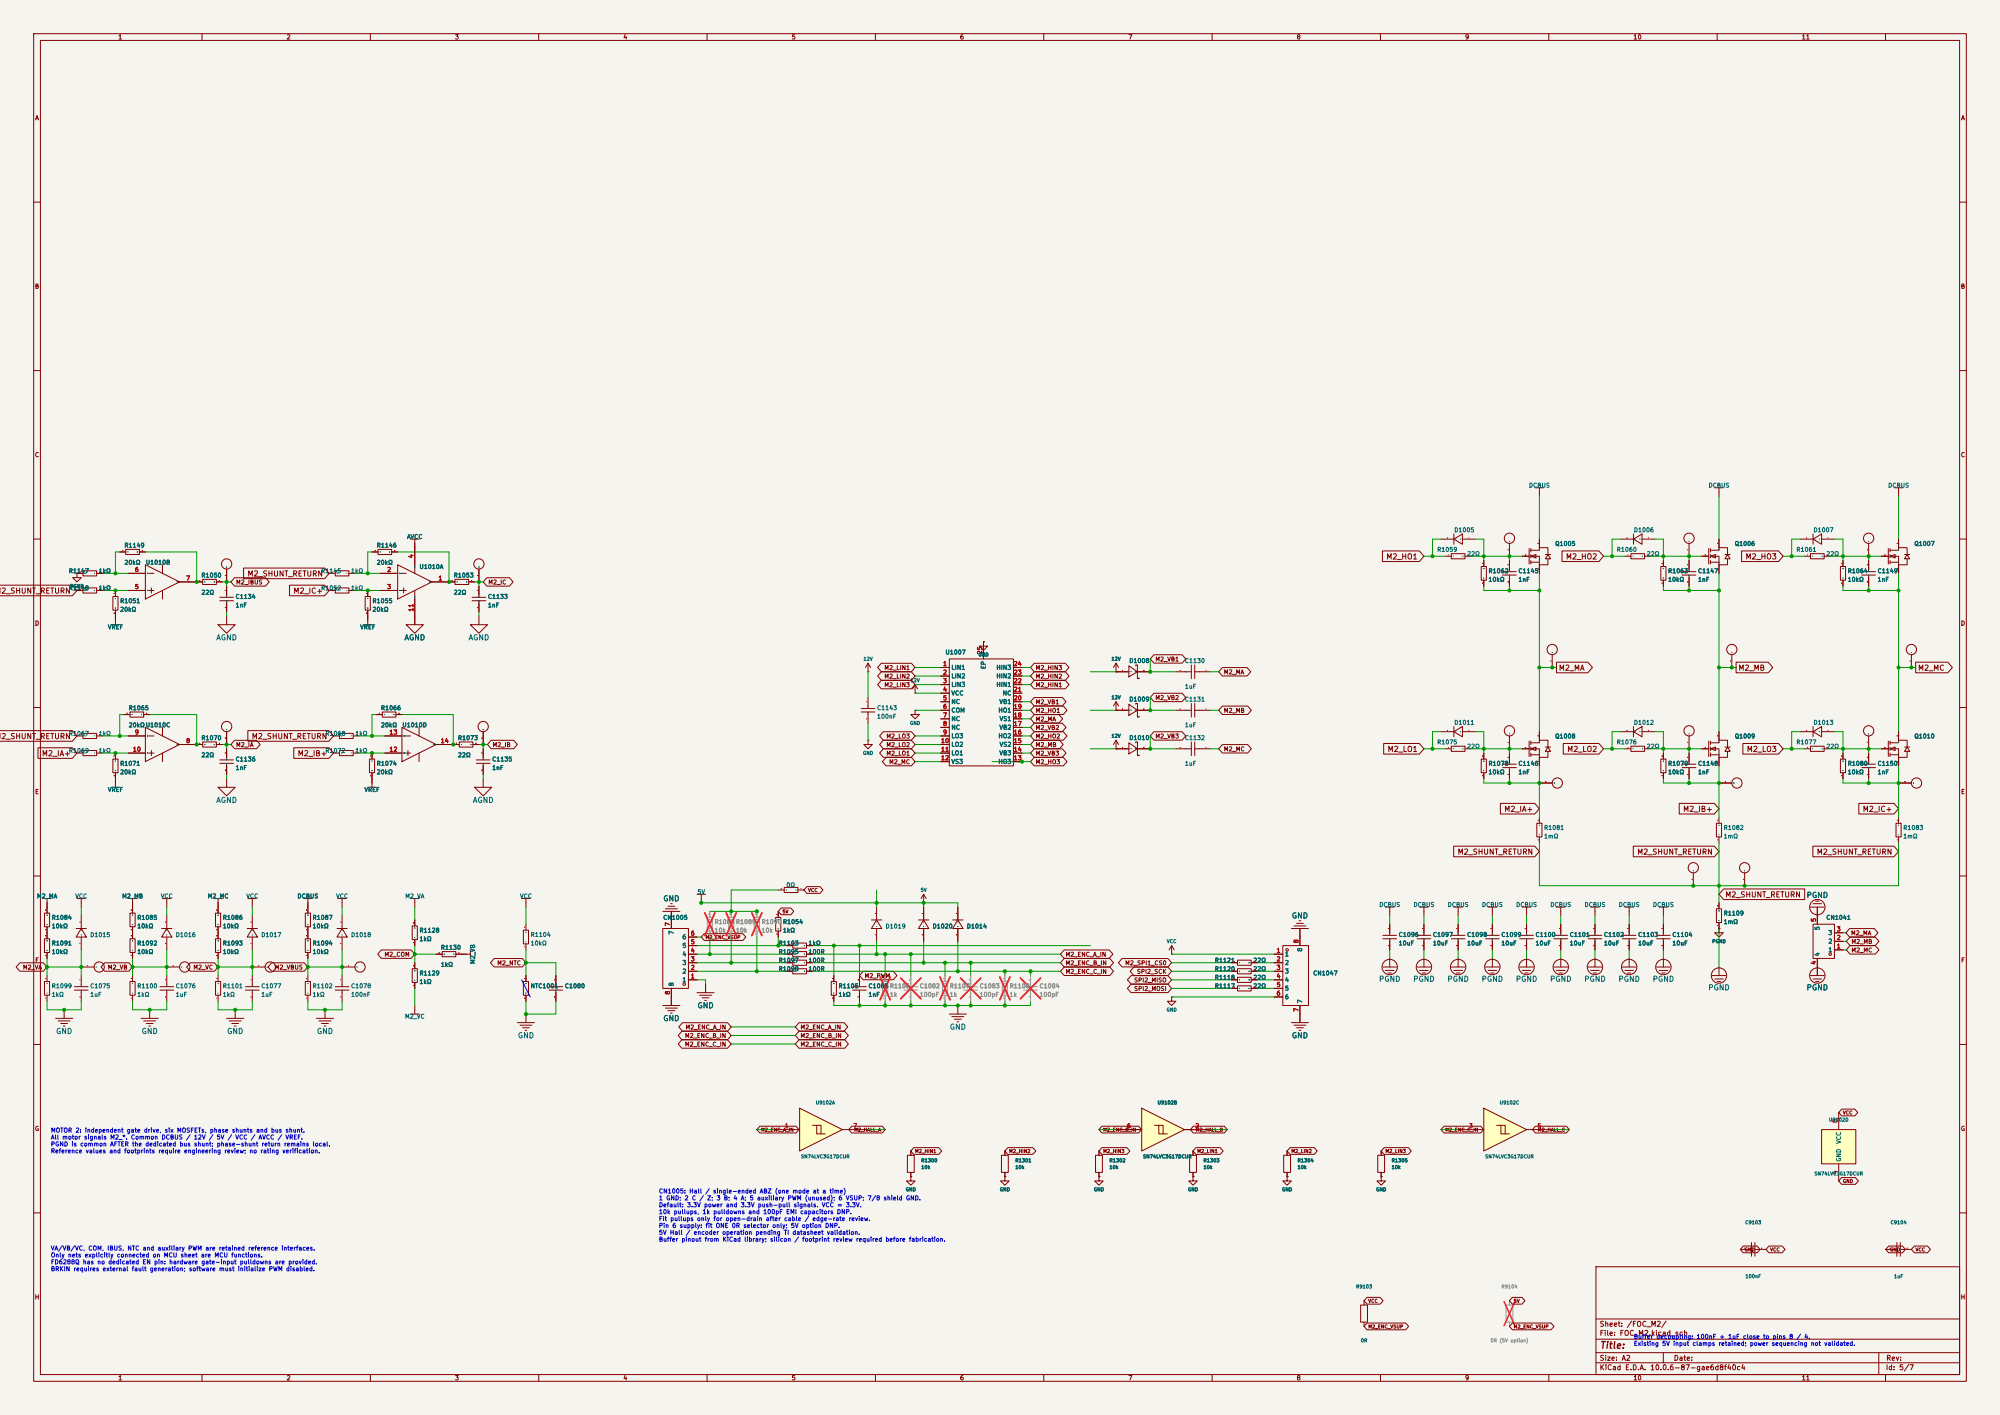
[picture p49: page 5]


HSLINK / HPM5301 - SHARED SYSTEM POWER

USB data / ESD; VBUS does not power board System 3.3 V -> R8052 -> HPM I/O rail

ISP boot button HPM5301 + 24 MHz clock + on-chip VDD_SOC buck

Target disconnect links (default DNP)

UART nets name target direction: TX = GD32 PD5 -> probe RX; R8901..R8905 remain DEFAULT DNP / OPEN. Fit only with target powered.

H8001 pin 1 is target VCC reference; no separate power injection.

No validated ADC voltage sensing or firmware power-off tri-state. RX = GD32 PD6 <- probe TX. Reference GPIO mapping retained; firmware compatibility NOT verified.


J300 is a board-defined 1x8 2.54mm header, not a module pinout standard. Use a verified cable adapter. No MISO, SD card, touch or readback support. VCC = board 3.3V; check module current + board regulator thermal budget. Place C300/C301 near J300; select effective bulk capacitance under DC bias. THREE ACTIVE-LOW LOCAL BUTTONS: PD2 / PD3 / PD4

SW300..302 reuse reference SW5/SW6 C&K symbol and footprint; pins 2/3 left NC as reference. 10k pull-up + 100nF at GPIO; 1k switch-series resistor limits capacitor discharge. Pressed level approximately 0.30V with 3.3V supply. Apply firmware debounce. No external button cable.
