CYFS3/GD32FOC/oled_review/final.pdf

INTERFACE 文件: Interface.kicad_sch Dual independent motor framework Common input supply + GD32F505VxTx controller Review protection thresholds and ratings before energizing.

Size: A4 | Rev:
KiCad E.D.A. 10.0.6-87-gae6d8f40c4 | Id: 1/7

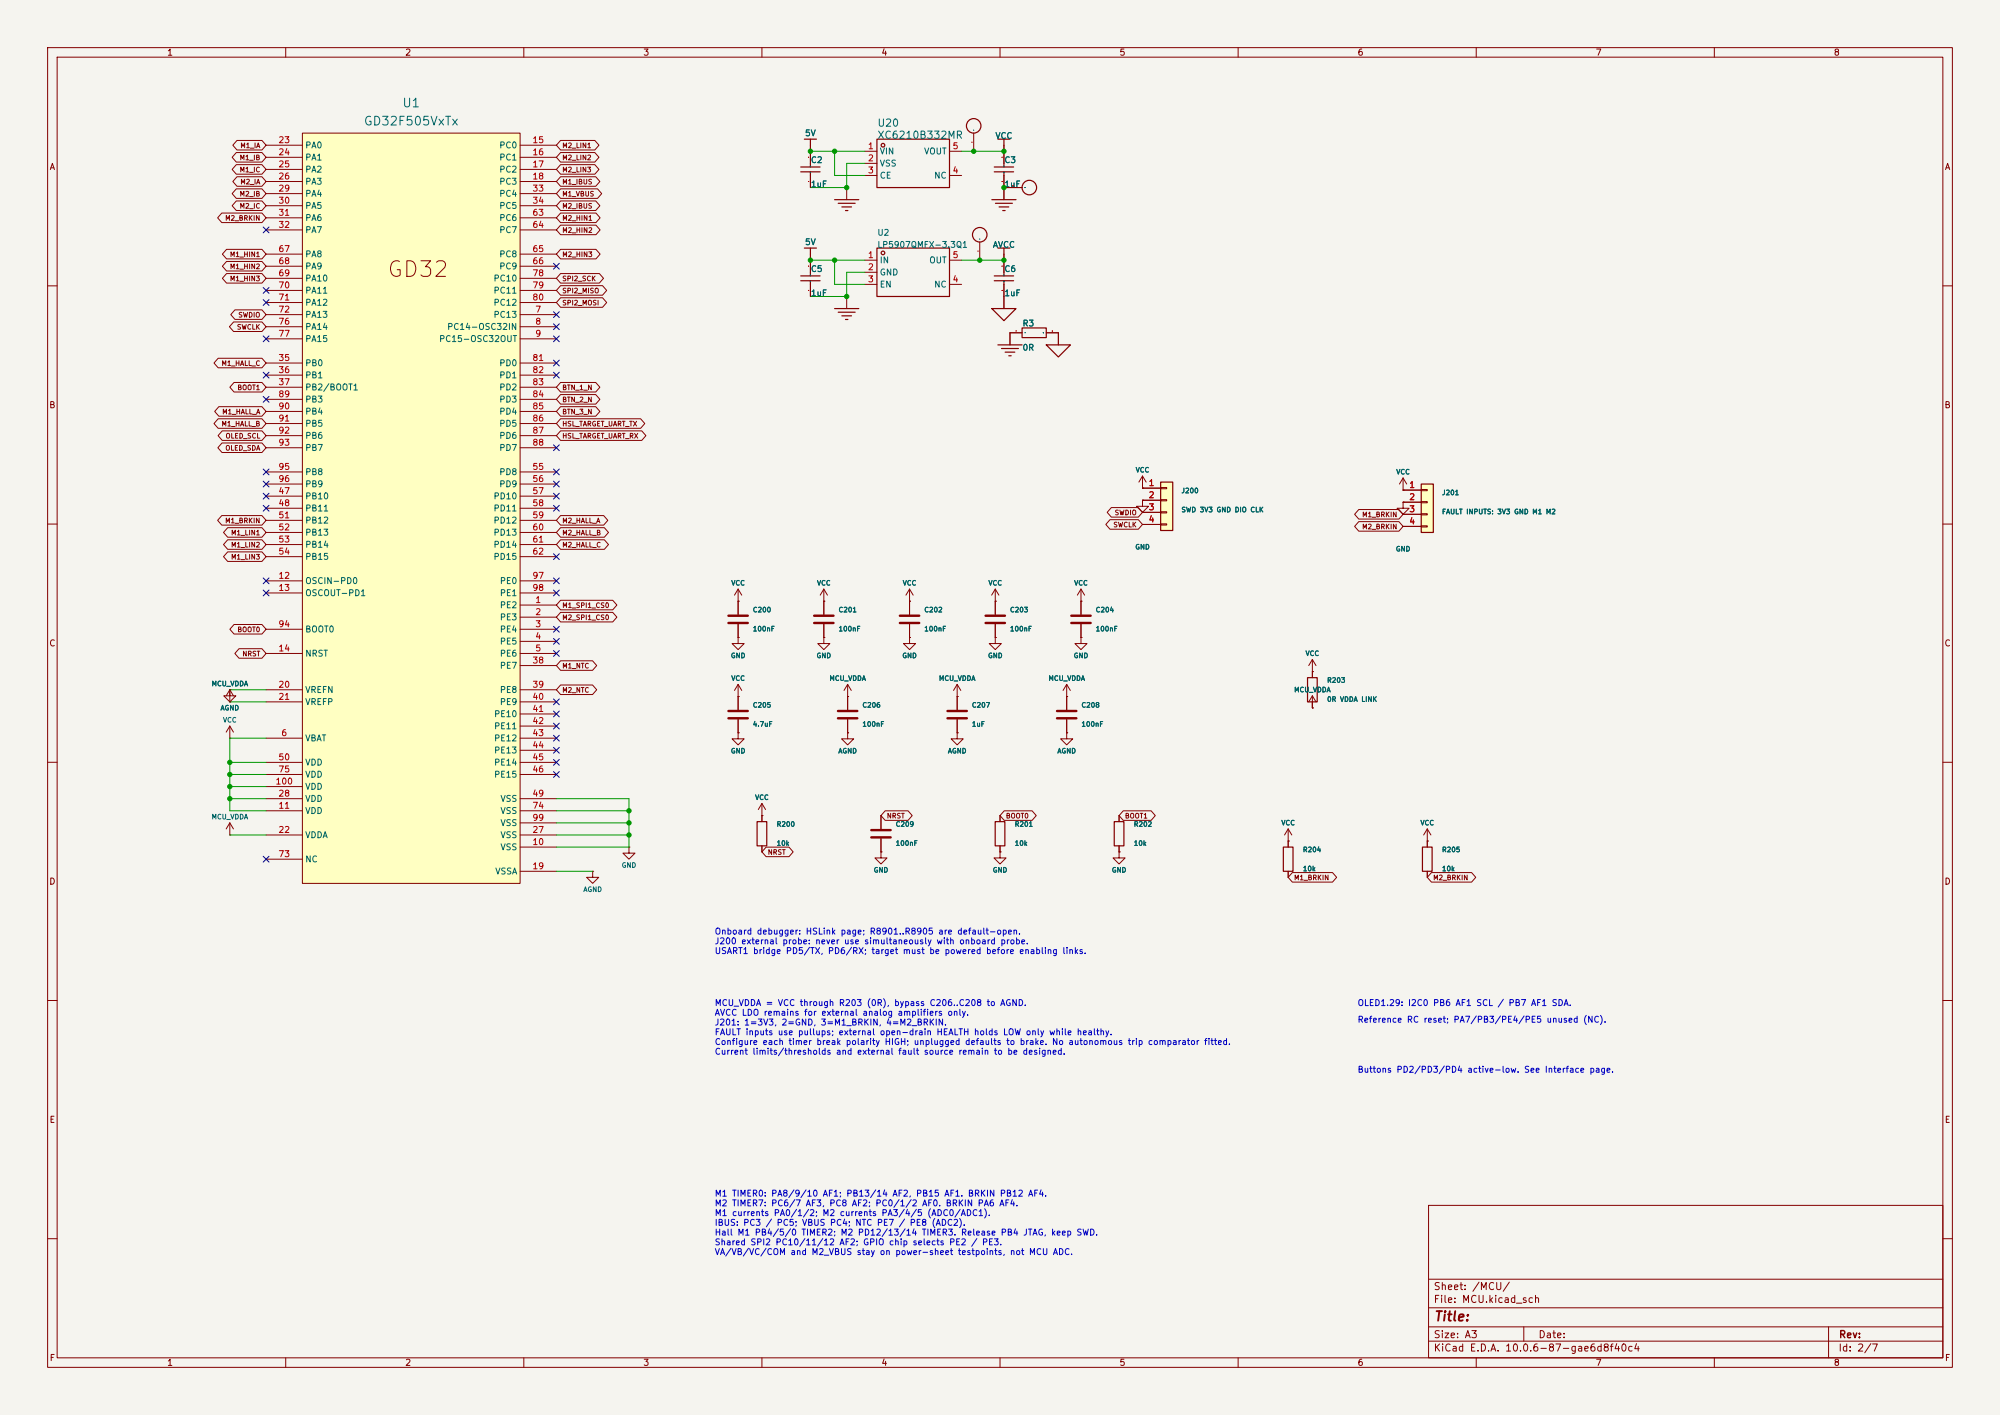
[picture p56: page 2]

VCC
SWD 3V3 GND DIO CLK 1234

SWD 3V3 GND DIO CLK

Configure each timer break polarity HIGH; unplugged defaults to brake. No autonomous trip comparator fitted. Current limits/thresholds and external fault source remain to be designed. M1 TIMER0: PA8/9/10 AF1; PB13/14 AF2, PB15 AF1. BRKIN PB12 AF4. M2 TIMER7: PC6/7 AF3, PC8 AF2; PC0/1/2 AF0. BRKIN PA6 AF4. M1 currents PA0/1/2; M2 currents PA3/4/5 (ADC0/ADC1).

IBUS: PC3 / PC5; VBUS PC4; NTC PE7 / PE8 (ADC2). Hall M1 PB4/5/0 TIMER2; M2 PD12/13/14 TIMER3. Release PB4 JTAG, keep SWD. Shared SPI2 PC10/11/12 AF2; GPIO chip selects PE2 / PE3. VA/VB/VC/COM and M2_VBUS stay on power-sheet testpoints, not MCU ADC.


Shared input protection, DCBUS capacitors, 12V / 5V regulators and analog VREF. One common supply only; original ratings retained, not verified for two motors. R45


Existing 5V input clamps retained; power sequencing not validated. Default: 3.3V power and 3.3V push-pull signals. VCC = 3.3V. 10k pullups, 1k pulldowns and 100pF EMI capacitors DNP. Fit pullups only for open-drain after cable / edge-rate review. Pin 6 supply: fit ONE 0R selector only; 5V option DNP. 5V Hall / encoder operation pending TI datasheet validation. CN5: Hall / single-ended ABZ (one mode at a time) R149

MOTOR 1: independent gate drive, six MOSFETs, phase shunts and bus shunt. All motor signals M1_*. Common DCBUS / 12V / 5V / VCC / AVCC / VREF. PGND is common AFTER the dedicated bus shunt; phase-shunt return remains local. Reference values and footprints require engineering review; no rating verification. VA/VB/VC, COM, IBUS, NTC and auxiliary PWM are retained reference interfaces. Only nets explicitly connected on MCU sheet are MCU functions. FD6288Q has no dedicated EN pin: hardware gate-input pulldowns are provided. BRKIN requires external fault generation; software must initialize PWM disabled.


Fit pullups only for open-drain after cable / edge-rate review. Pin 6 supply: fit ONE 0R selector only; 5V option DNP. CN1005: Hall / single-ended ABZ (one mode at a time)
Buffer decoupling: 100nF + 1uF close to pins 8 / 4. 10k pullups, 1k pulldowns and 100pF EMI capacitors DNP. Buffer pinout from KiCad library; silicon / footprint review required before fabrication. 5V Hall / encoder operation pending TI datasheet validation. Default: 3.3V power and 3.3V push-pull signals. VCC = 3.3V. 1 GND; 2 C / Z; 3 B; 4 A; 5 auxiliary PWM (unused); 6 VSUP; 7/8 shield GND.

Existing 5V input clamps retained; power sequencing not validated. U1010C

MOTOR 2: independent gate drive, six MOSFETs, phase shunts and bus shunt. All motor signals M2_*. Common DCBUS / 12V / 5V / VCC / AVCC / VREF. PGND is common AFTER the dedicated bus shunt; phase-shunt return remains local. Reference values and footprints require engineering review; no rating verification.

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


HSLINK / HPM5301 - SHARED SYSTEM POWER

USB data / ESD; VBUS does not power board System 3.3 V -> R8052 -> HPM I/O rail

ISP boot button HPM5301 + 24 MHz clock + on-chip VDD_SOC buck

Target disconnect links (default DNP)

UART nets name target direction: TX = GD32 PD5 -> probe RX; R8901..R8905 remain DEFAULT DNP / OPEN. Fit only with target powered.

H8001 pin 1 is target VCC reference; no separate power injection.

No validated ADC voltage sensing or firmware power-off tri-state. RX = GD32 PD6 <- probe TX. Reference GPIO mapping retained; firmware compatibility NOT verified.

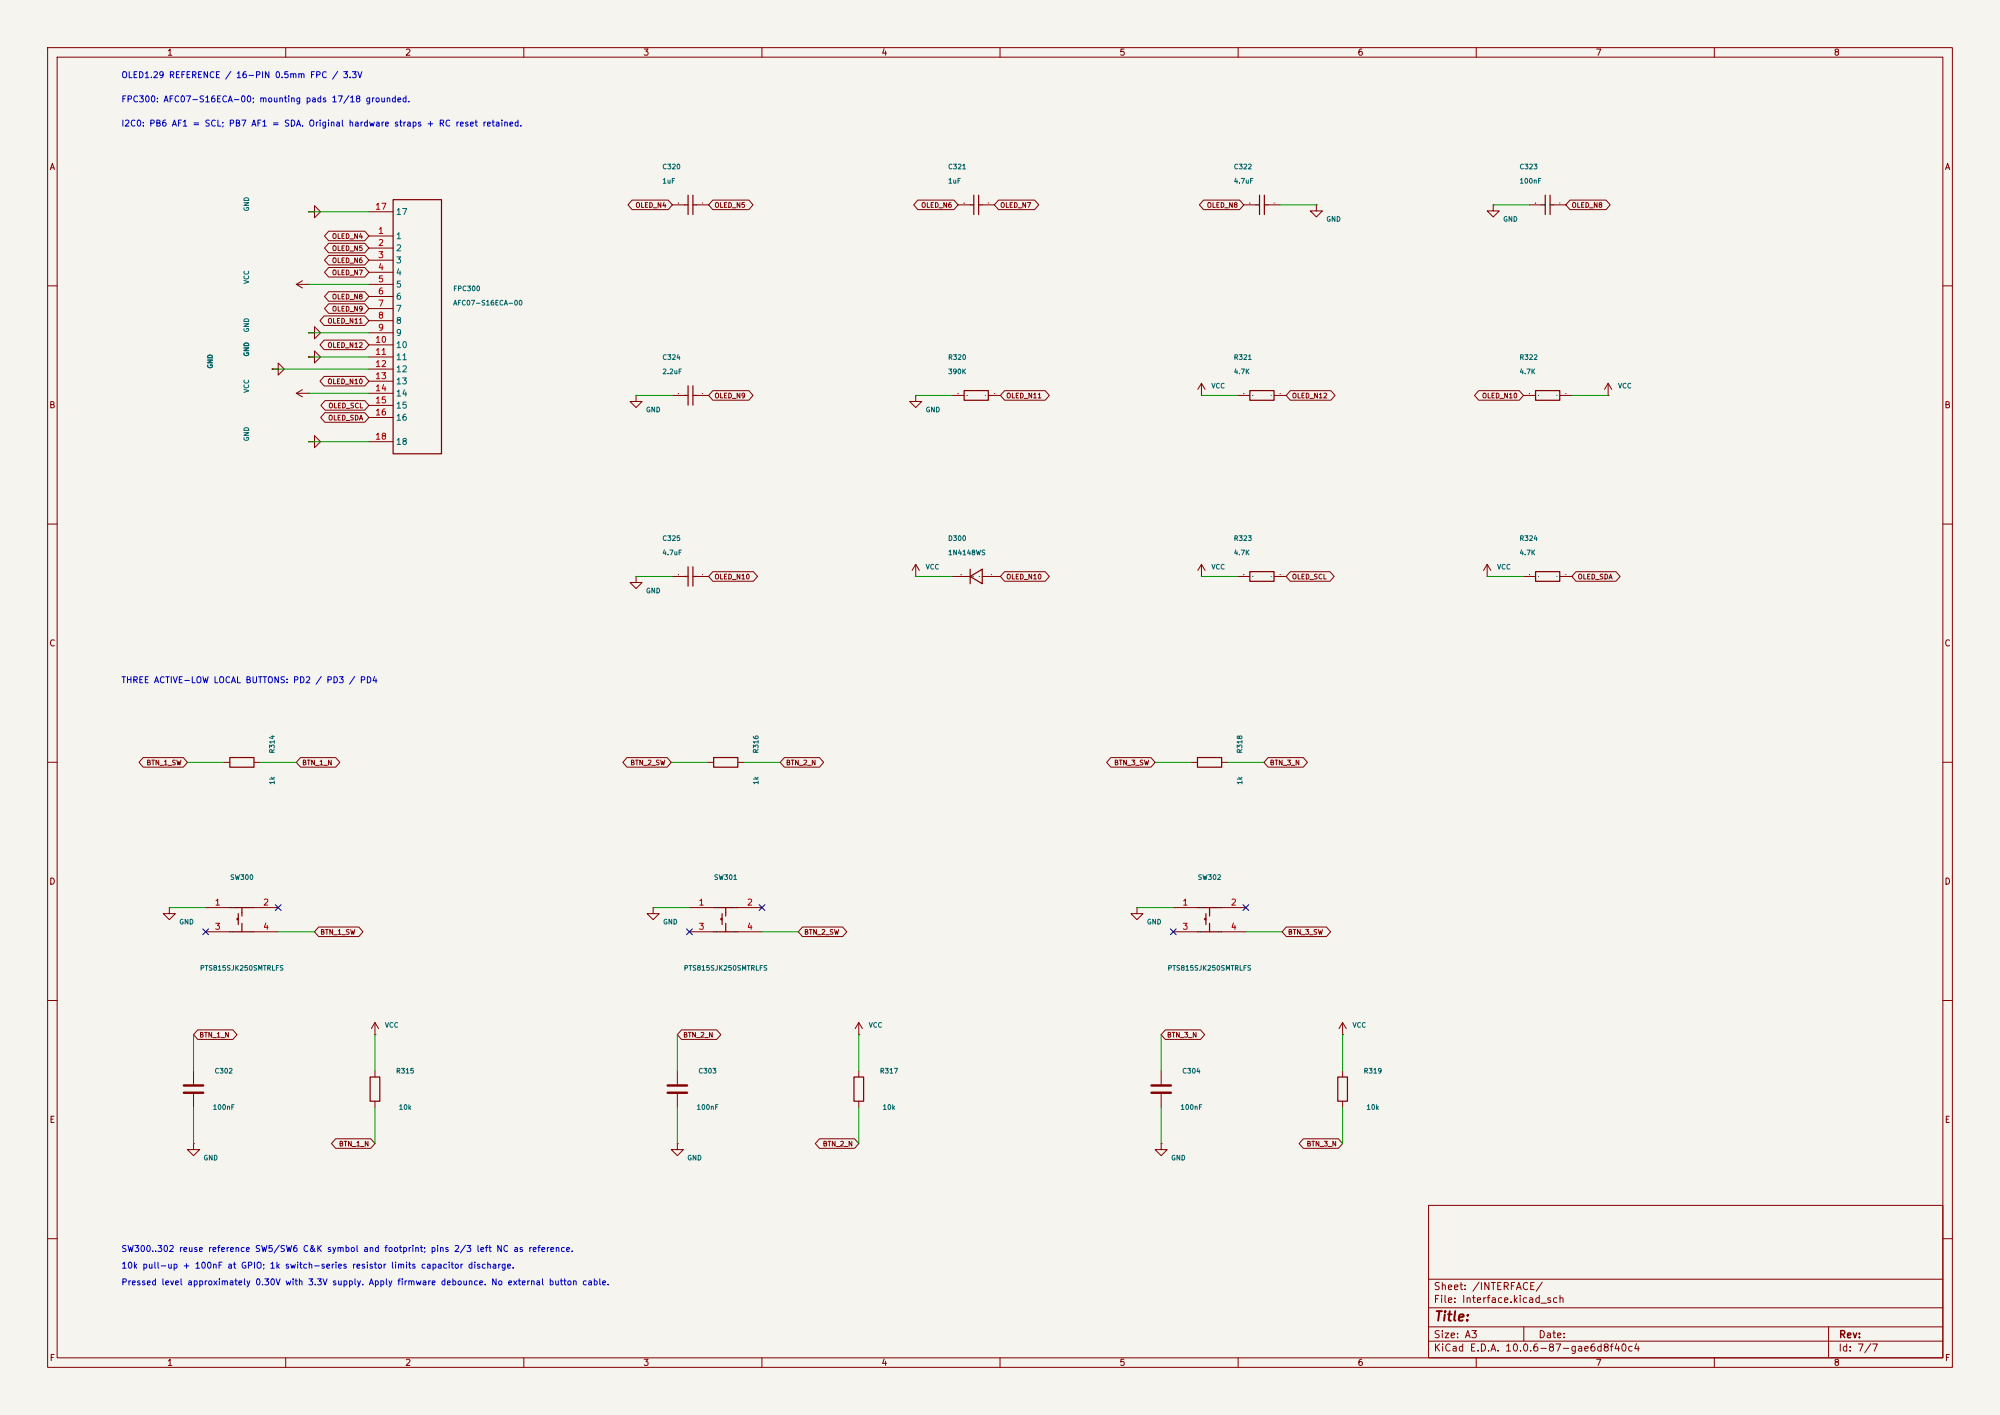
[picture p57: page 7]

I2C0: PB6 AF1 = SCL; PB7 AF1 = SDA. Original hardware straps + RC reset retained. GND GND

THREE ACTIVE-LOW LOCAL BUTTONS: PD2 / PD3 / PD4 Pressed level approximately 0.30V with 3.3V supply. Apply firmware debounce. No external button cable.

10k pull-up + 100nF at GPIO; 1k switch-series resistor limits capacitor discharge. SW300..302 reuse reference SW5/SW6 C&K symbol and footprint; pins 2/3 left NC as reference.
