CYFS3/GD32FOC/label_wire_audit/C130_bootstrap_focus.pdf

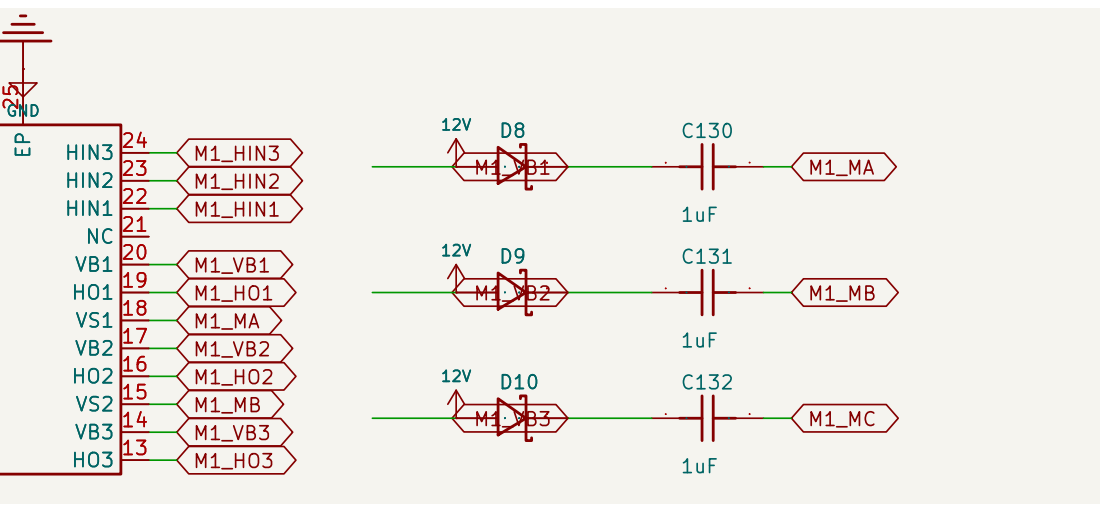
[picture p63: page 1]
