CYFS3/GD32FOC/GD32F5_FOC.kicad_pcb

## KiCad design GD32F5_FOC.kicad_pcb (2026-11-01)

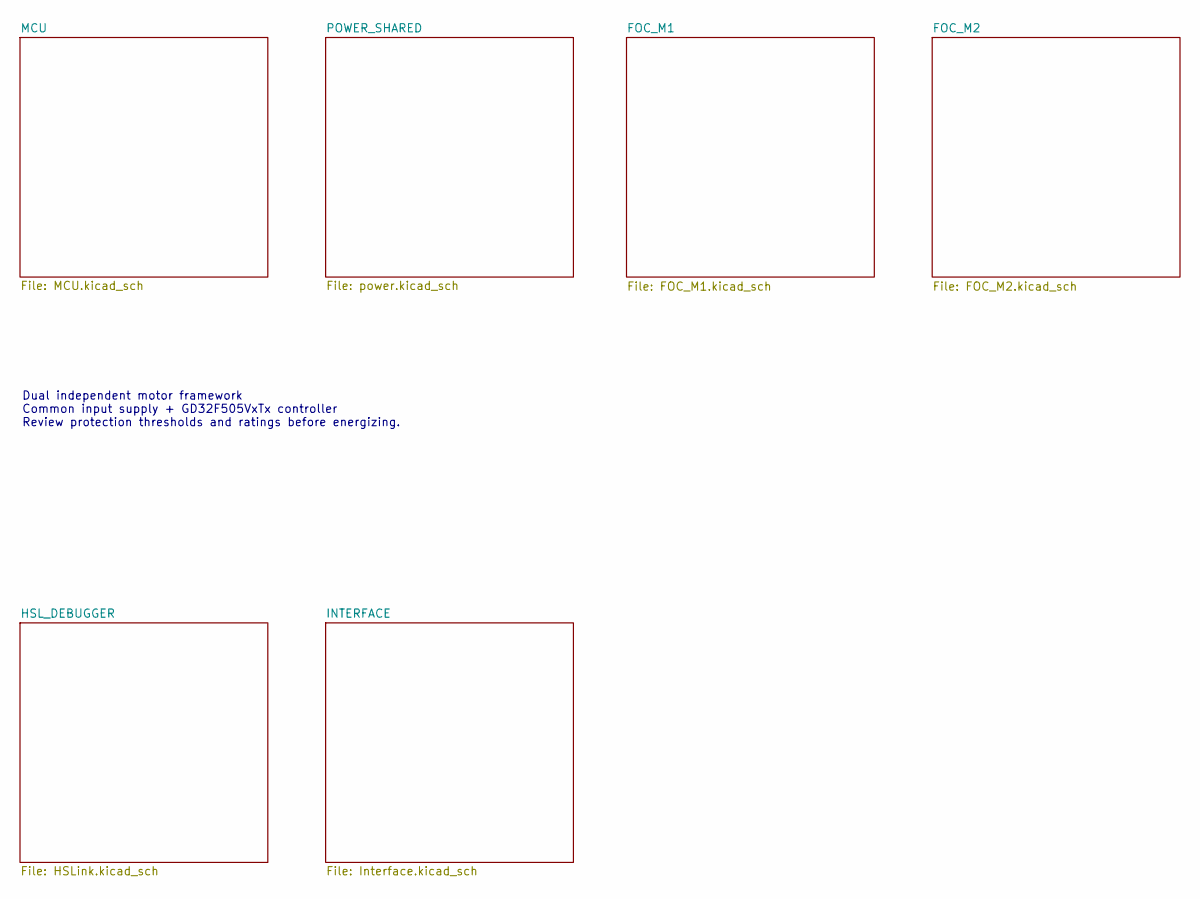
[picture p64: schematic GD32F5_FOC.kicad_sch]

Notes on the sheet:
Dual independent motor framework Common input supply + GD32F505VxTx controller Review protection thresholds and ratings before energizing.

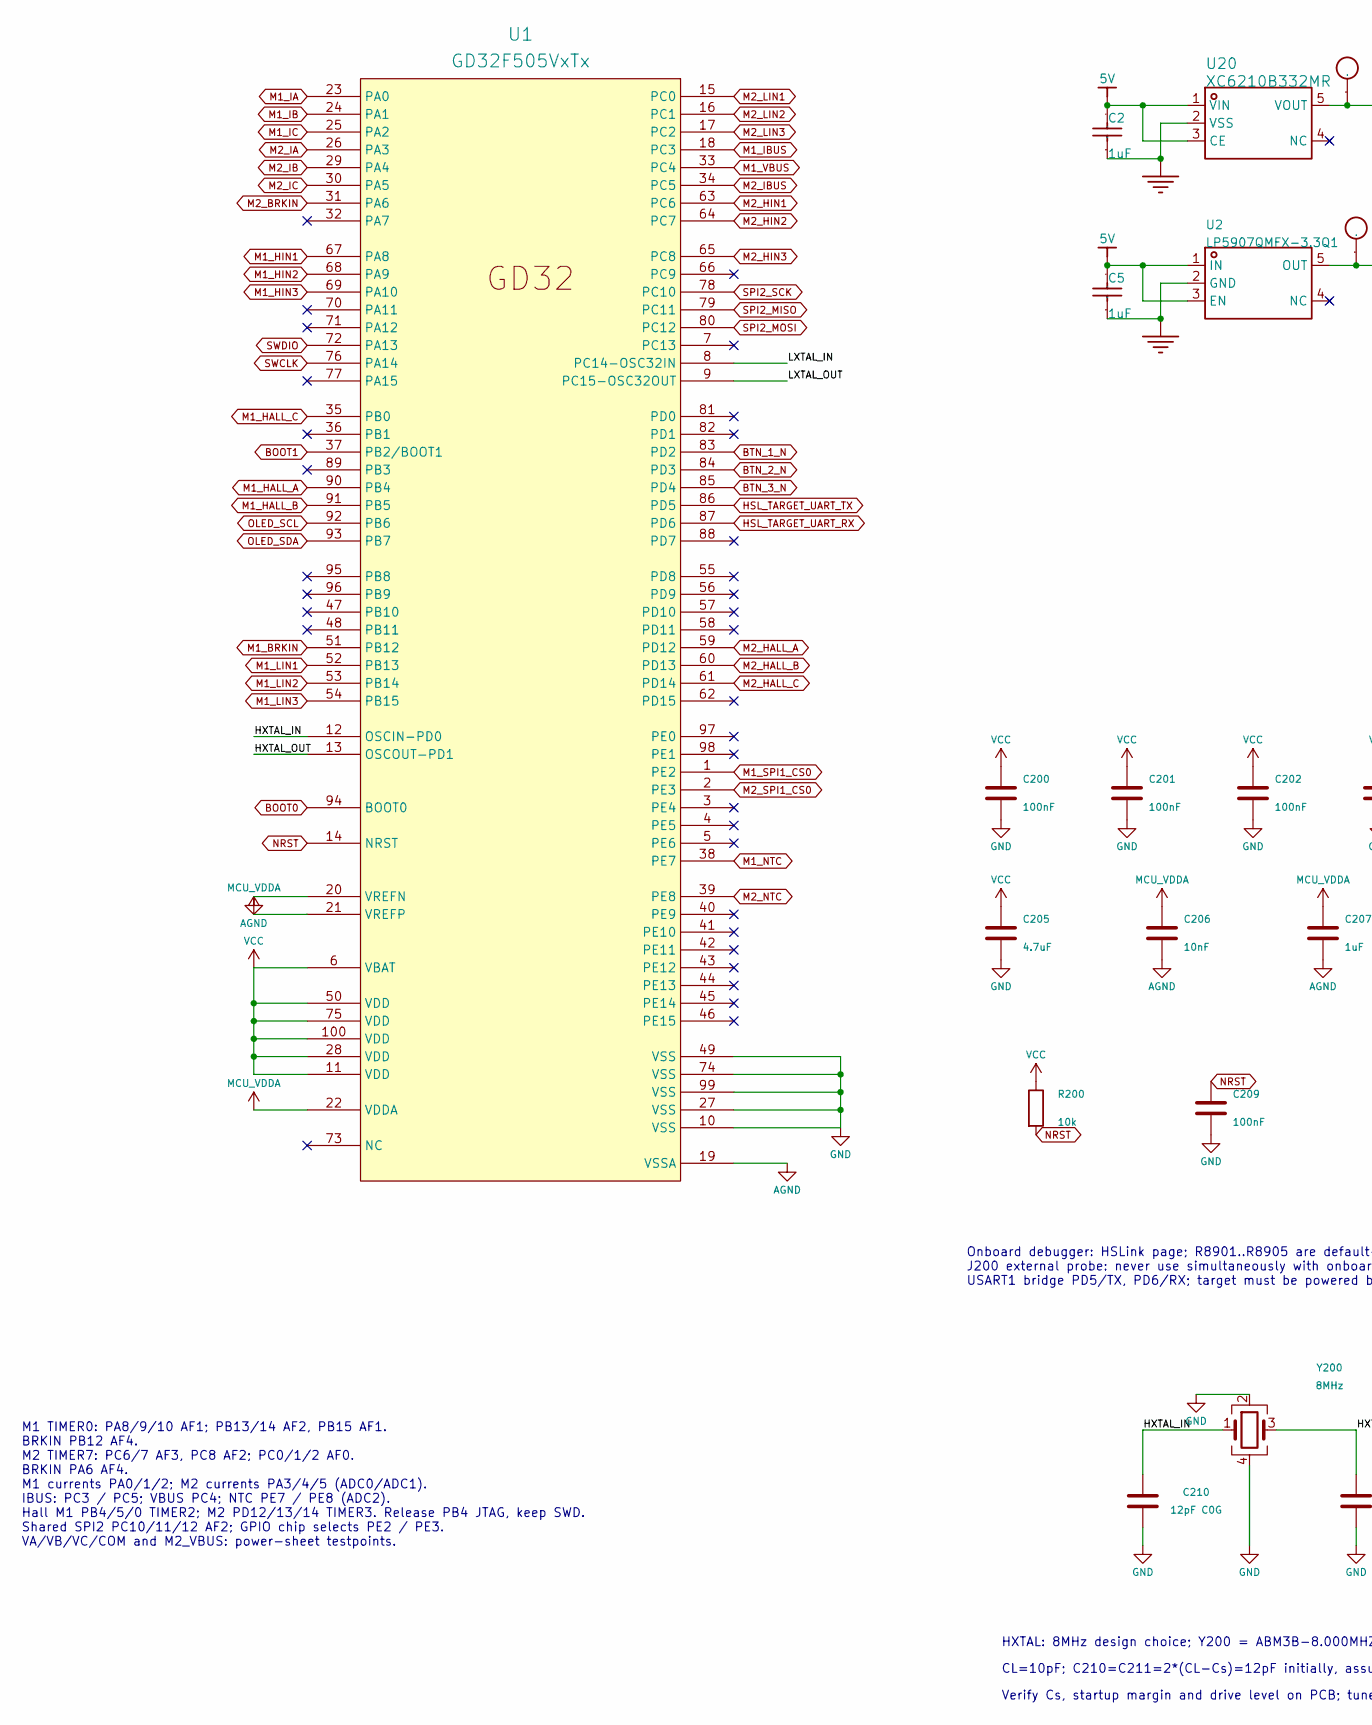
[picture p65: schematic MCU.kicad_sch, part in row 1, column 1]

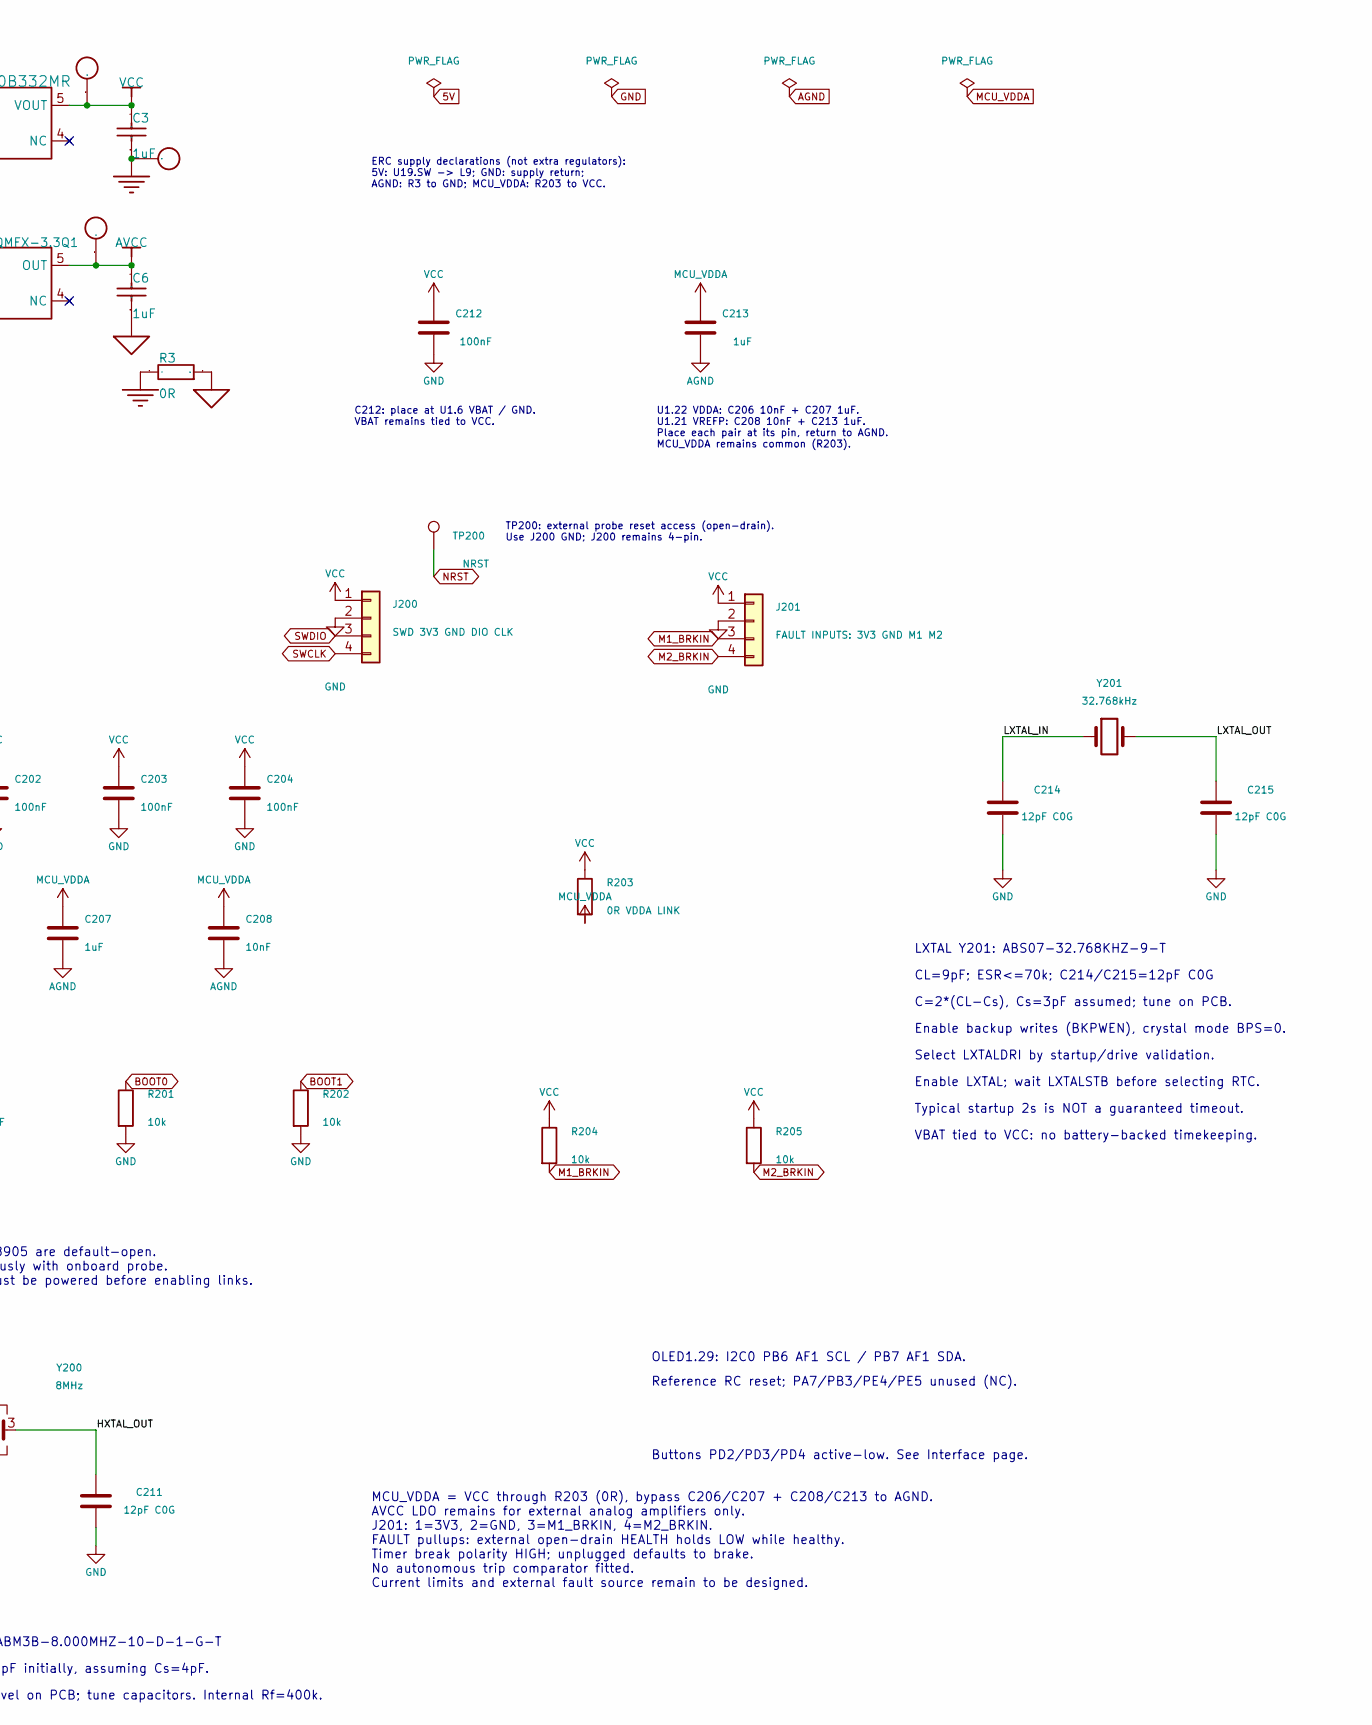
[picture p66: schematic MCU.kicad_sch, part in row 1, column 2]

Parts:
C2, C3, C5, C6: 1uF; C0402; Tolerance ±10%; Voltage Rating 25V; Manufacturer Part CL05A105KA5NQNC; LCSC Part Name 1uF ±10% 25V
C200, C201, C202, C203, C204, C209, C212: 100nF; C_0603_1608Metric
C205: 4.7uF; C_0603_1608Metric
C206, C208: 10nF; C_0603_1608Metric
C207, C213: 1uF; C_0603_1608Metric
C210, C211, C214, C215: 12pF C0G; C_0603_1608Metric
CN2, CN3, CN6: TestPoint; TestPoint_D1.27_Reference; LCSC Part Name 测试点
J200: SWD 3V3 GND DIO CLK; PinHeader_1x04_P2.54mm_Vertical
J201: FAULT INPUTS: 3V3 GND M1 M2; PinHeader_1x04_P2.54mm_Vertical
R3: 0R; R0402; Manufacturer Part 0402WGF0000TCE
R200, R201, R202, R204, R205: 10k; R_0603_1608Metric
R203: 0R VDDA LINK; R_0603_1608Metric
TP200: NRST; TestPoint_Pad_D1.5mm
U1: GD32F505VxTx; LQFP100_14x14x1.6
U2: LP5907QMFX-3.3Q1; SOT-23-5_L3.0-W1.7-P0.95-LS2.8-BR; Manufacturer Part LP5907QMFX-3.3Q1; LCSC Part Name LP5907QMFX-3.3Q1
U20: XC6210B332MR; SOT-23-5_L3.0-W1.7-P0.95-LS2.8-BR; Manufacturer Part XC6210B332MR; LCSC Part Name XC6210B332MR
Y200: 8MHz; ABM3B_5x3.2mm; MPN ABM3B-8.000MHZ-10-D-1-G-T
Y201: 32.768kHz; ABS07_32.768kHz_3215; MPN ABS07-32.768KHZ-9-T

Connections:
5V: C2.2, C5.2, U2.1 (IN), U2.3 (EN), U20.1 (VIN), U20.3 (CE); also elsewhere on the board
/MCU/HXTAL_IN: C210.1, U1.12 (OSCIN-PD0), Y200.1
/MCU/HXTAL_OUT: C211.1, U1.13 (OSCOUT-PD1), Y200.3
/MCU/LXTAL_IN: C214.1, U1.8 (PC14-OSC32IN), Y201.1
/MCU/LXTAL_OUT: C215.1, U1.9 (PC15-OSC32OUT), Y201.2
AGND: C6.1, C206.2, C207.2, C208.2, C213.2, R3.1, U1.19 (VSSA), U1.20 (VREFN); also elsewhere on the board
AVCC: C6.2, CN6.1 (1_1), U2.5 (OUT); also elsewhere on the board
BOOT0: R201.1, U1.94 (BOOT0)
BOOT1: R202.1, U1.37 (PB2/BOOT1)
BTN_1_N: U1.83 (PD2); also elsewhere on the board
BTN_2_N: U1.84 (PD3); also elsewhere on the board
BTN_3_N: U1.85 (PD4); also elsewhere on the board
GND: C2.1, C3.1, C5.1, C200.2, C201.2, C202.2, C203.2, C204.2, C205.2, C209.2, C210.2, C211.2, C212.2, C214.2, C215.2, CN3.1 (1_1), J200.2, J201.2, R3.2, R201.2, R202.2, U1.10 (VSS), U1.27 (VSS), U1.49 (VSS), U1.74 (VSS), U1.99 (VSS), U2.2 (GND), U20.2 (VSS), Y200.2, Y200.4; also elsewhere on the board
HSL_TARGET_UART_RX: U1.87 (PD6); also elsewhere on the board
HSL_TARGET_UART_TX: U1.86 (PD5); also elsewhere on the board
M1_BRKIN: J201.3, R204.2, U1.51 (PB12)
M1_HALL_A: U1.90 (PB4); also elsewhere on the board
M1_HALL_B: U1.91 (PB5); also elsewhere on the board
M1_HALL_C: U1.35 (PB0); also elsewhere on the board
M1_HIN1: U1.67 (PA8); also elsewhere on the board
M1_HIN2: U1.68 (PA9); also elsewhere on the board
M1_HIN3: U1.69 (PA10); also elsewhere on the board
M1_IA: U1.23 (PA0); also elsewhere on the board
M1_IB: U1.24 (PA1); also elsewhere on the board
M1_IBUS: U1.18 (PC3); also elsewhere on the board
M1_IC: U1.25 (PA2); also elsewhere on the board
M1_LIN1: U1.52 (PB13); also elsewhere on the board
M1_LIN2: U1.53 (PB14); also elsewhere on the board
M1_LIN3: U1.54 (PB15); also elsewhere on the board
M1_NTC: U1.38 (PE7); also elsewhere on the board
M1_SPI1_CS0: U1.1 (PE2); also elsewhere on the board
M1_VBUS: U1.33 (PC4); also elsewhere on the board
M2_BRKIN: J201.4, R205.2, U1.31 (PA6)
M2_HALL_A: U1.59 (PD12); also elsewhere on the board
M2_HALL_B: U1.60 (PD13); also elsewhere on the board
M2_HALL_C: U1.61 (PD14); also elsewhere on the board
M2_HIN1: U1.63 (PC6); also elsewhere on the board
M2_HIN2: U1.64 (PC7); also elsewhere on the board
M2_HIN3: U1.65 (PC8); also elsewhere on the board
M2_IA: U1.26 (PA3); also elsewhere on the board
M2_IB: U1.29 (PA4); also elsewhere on the board
M2_IBUS: U1.34 (PC5); also elsewhere on the board
M2_IC: U1.30 (PA5); also elsewhere on the board
M2_LIN1: U1.15 (PC0); also elsewhere on the board
M2_LIN2: U1.16 (PC1); also elsewhere on the board
M2_LIN3: U1.17 (PC2); also elsewhere on the board
M2_NTC: U1.39 (PE8); also elsewhere on the board
M2_SPI1_CS0: U1.2 (PE3); also elsewhere on the board
MCU_VDDA: C206.1, C207.1, C208.1, C213.1, R203.2, U1.21 (VREFP), U1.22 (VDDA)
NRST: C209.1, R200.2, TP200.1 (1_1), U1.14 (NRST); also elsewhere on the board
OLED_SCL: U1.92 (PB6); also elsewhere on the board
OLED_SDA: U1.93 (PB7); also elsewhere on the board
SPI2_MISO: U1.79 (PC11); also elsewhere on the board
SPI2_MOSI: U1.80 (PC12); also elsewhere on the board
SPI2_SCK: U1.78 (PC10); also elsewhere on the board
SWCLK: J200.4, U1.76 (PA14); also elsewhere on the board
SWDIO: J200.3, U1.72 (PA13); also elsewhere on the board
VCC: C3.2, C200.1, C201.1, C202.1, C203.1, C204.1, C205.1, C212.1, CN2.1 (1_1), J200.1, J201.1, R200.1, R203.1, R204.1, R205.1, U1.6 (VBAT), U1.11 (VDD), U1.28 (VDD), U1.50 (VDD), U1.75 (VDD), U1.100 (VDD), U20.5 (VOUT); also elsewhere on the board

Notes on the sheet:
MCU_VDDA = VCC through R203 (0R), bypass C206/C207 + C208/C213 to AGND. AVCC LDO remains for external analog amplifiers only. J201: 1=3V3, 2=GND, 3=M1_BRKIN, 4=M2_BRKIN. FAULT pullups: external open-drain HEALTH holds LOW while healthy. Timer break polarity HIGH; unplugged defaults to brake. No aut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
M1 TIMER0: PA8/9/10 AF1; PB13/14 AF2, PB15 AF1. BRKIN PB12 AF4. M2 TIMER7: PC6/7 AF3, PC8 AF2; PC0/1/2 AF0. BRKIN PA6 AF4. M1 currents PA0/1/2; M2 currents PA3/4/5 (ADC0/ADC1). IBUS: PC3 / PC5; VBUS PC4; NTC PE7 / PE8 (ADC2). Hall M1 PB4/5/0 TIMER2; M2 PD12/13/14 TIMER3. Release PB4 JTAG, keep SWD.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
Onboard debugger: HSLink page; R8901..R8905 are default-open. J200 external probe: never use simultaneously with onboard probe. USART1 bridge PD5/TX, PD6/RX; target must be powered before enabling links.
Buttons PD2/PD3/PD4 active-low. See Interface page.
OLED1.29: I2C0 PB6 AF1 SCL / PB7 AF1 SDA.
Reference RC reset; PA7/PB3/PE4/PE5 unused (NC).
HXTAL: 8MHz design choice; Y200 = ABM3B-8.000MHZ-10-D-1-G-T
CL=10pF; C210=C211=2*(CL-Cs)=12pF initially, assuming Cs=4pF.
Verify Cs, startup margin and drive level on PCB; tune capacitors. Internal Rf=400k.
C212: place at U1.6 VBAT / GND. VBAT remains tied to VCC.
U1.22 VDDA: C206 10nF + C207 1uF. U1.21 VREFP: C208 10nF + C213 1uF. Place each pair at its pin, return to AGND. MCU_VDDA remains common (R203).
TP200: external probe reset access (open-drain). Use J200 GND; J200 remains 4-pin.
ERC supply declarations (not extra regulators): 5V: U19.SW -> L9; GND: supply return; AGND: R3 to GND; MCU_VDDA: R203 to VCC.
LXTAL Y201: ABS07-32.768KHZ-9-T
CL=9pF; ESR<=70k; C214/C215=12pF C0G
C=2*(CL-Cs), Cs=3pF assumed; tune on PCB.
Enable backup writes (BKPWEN), crystal mode BPS=0.
Select LXTALDRI by startup/drive validation.
Enable LXTAL; wait LXTALSTB before selecting RTC.
Typical startup 2s is NOT a guaranteed timeout.
VBAT tied to VCC: no battery-backed timekeeping.

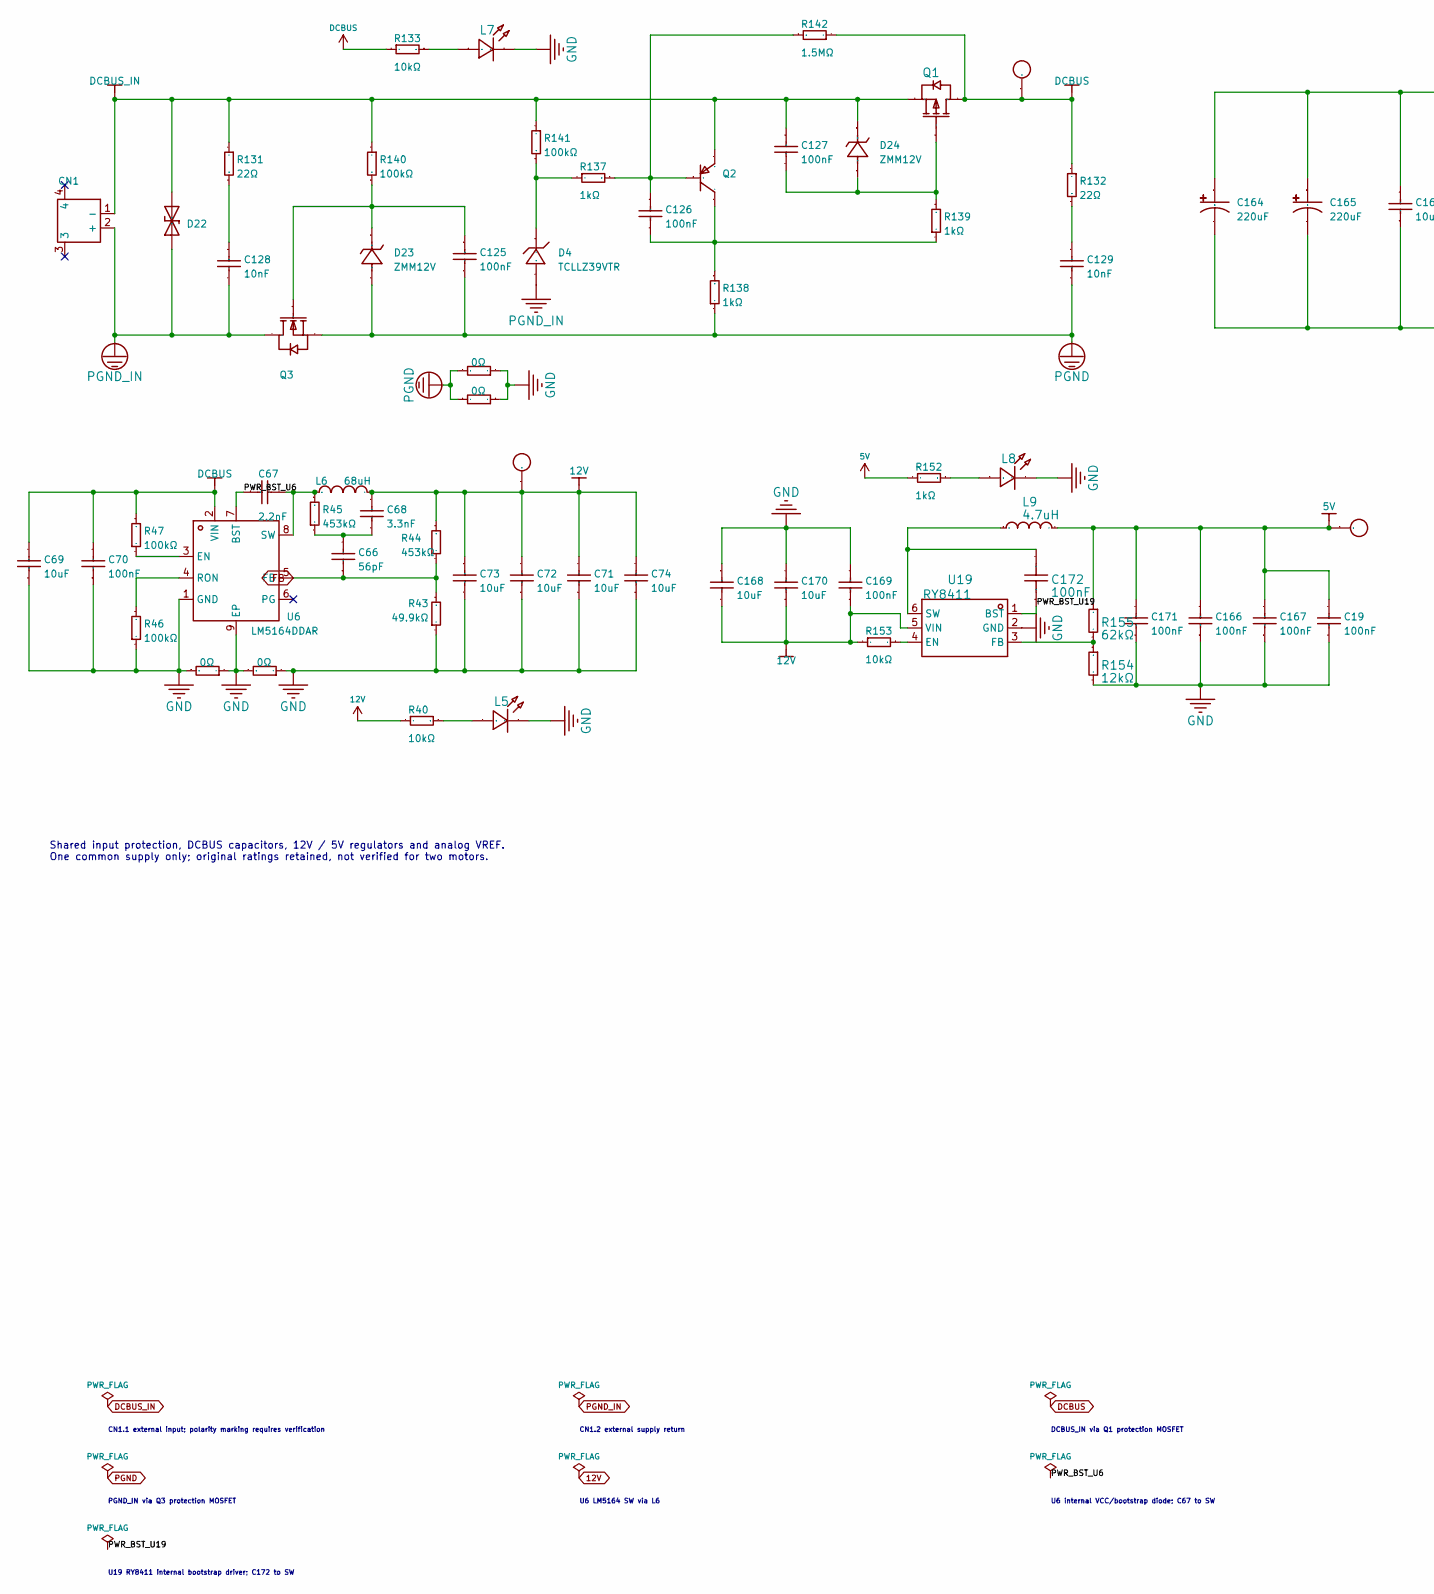
[picture p67: schematic power.kicad_sch, part in row 1, column 1]

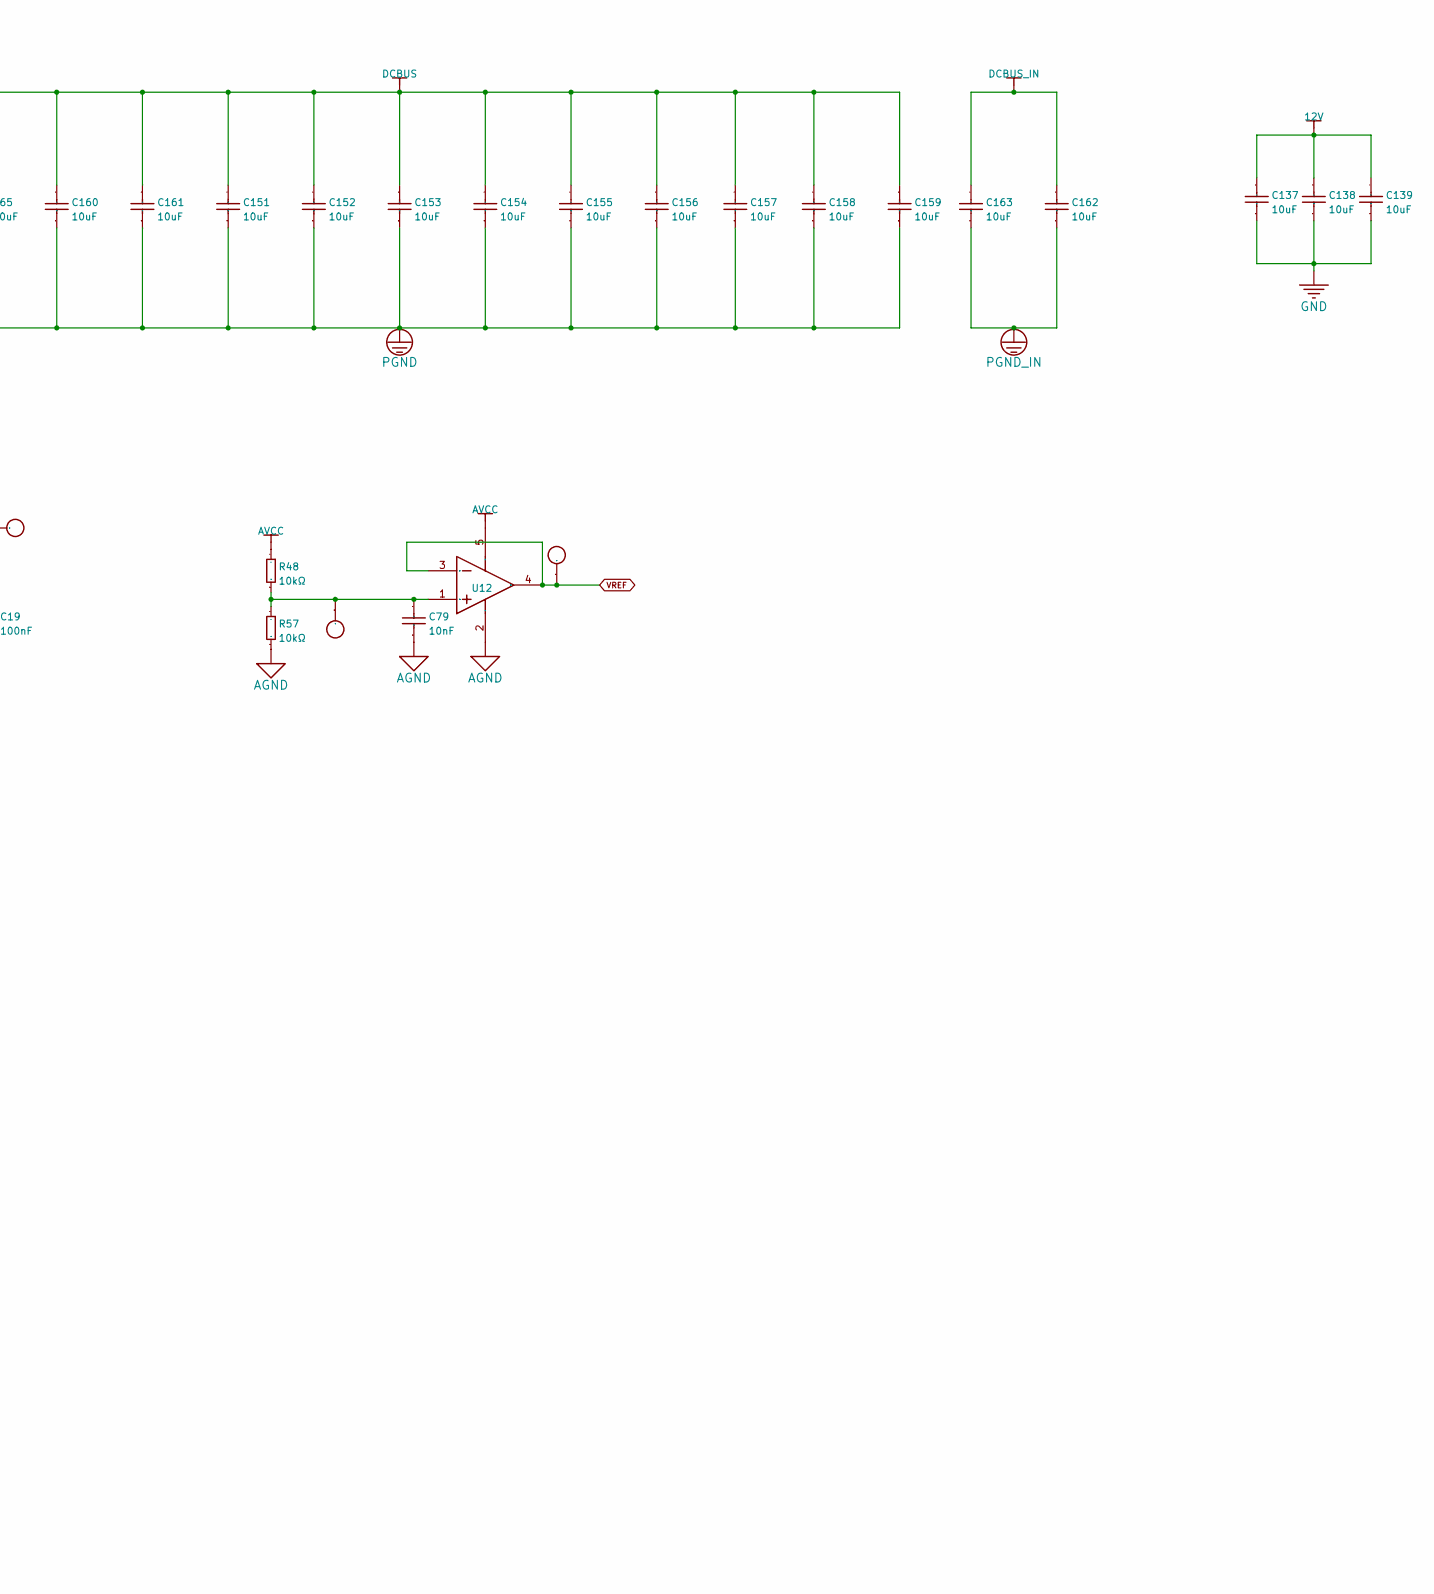
[picture p68: schematic power.kicad_sch, part in row 1, column 2]

Parts:
C19, C125, C126, C127, C166, C167, C169, C171: 100nF; C0603_S; Tolerance ±10%; Voltage Rated 50V; Manufacturer Part 0603B104K500NT; LCSC Part Name 100nF ±10% 50V
C66: 56pF; C_0603_1608Metric; Tolerance ±5%; Voltage Rating 50V; Manufacturer Part 0603CG560J500NT; LCSC Part Name 56pF ±5% 50V
C67: 2.2nF; C_0603_1608Metric; Tolerance ±10%; Voltage Rating 50V; Manufacturer Part 0603B222K500NT; LCSC Part Name 2.2nF ±10% 50V
C68: 3.3nF; C_0603_1608Metric; Tolerance ±10%; Voltage Rated 50V; Manufacturer Part CL10B332KB8NNNC; LCSC Part Name 3.3nF ±10% 50V
C69: 10uF; C1206_S
C70: 100nF; C1206_S; Tolerance ±10%; Voltage Rated 50V; Manufacturer Part CL31B104KBCNNNC; LCSC Part Name 100nF ±10% 50V
C71, C72, C73, C137, C138, C139, C168, C170: 10uF; C0603_S; Tolerance ±20%; Voltage Rated 25V; Manufacturer Part CL10A106MA8NRNC; LCSC Part Name 10uF ±20% 25V
C74, C151, C152, C153, C154, C155, C156, C157, C158, C159, C160, C161, C162, C163: 10uF; C_1206_3216Metric; Tolerance ±10%; Voltage Rated 50V; Manufacturer Part CL31A106KBHNNNE; LCSC Part Name 10uF ±10% 50V
C79, C128, C129: 10nF; C0603_S; Tolerance ±10%; Voltage Rated 50V; Manufacturer Part 0603B103K500NT; LCSC Part Name 10nF ±10% 50V
C164, C165: 220uF; 50TZV220M10X10.5; Rated Voltage 50V; Tolerance ±20%; Manufacturer Part 50TZV220M10X10.5; LCSC Part Name 220uF ±20% 50V
C172: 100nF; C_0603_1608Metric; Tolerance ±10%; Voltage Rated 50V; Manufacturer Part CC0603KRX7R9BB104; LCSC Part Name 100nF ±10% 50V
CN1: XT30PW-M30.G.Y; CONN-TH_XT30PW-M; Manufacturer Part XT30PW-M30.G.Y; LCSC Part Name AMASS(艾迈斯)航模插头 卧式弯脚 XT30PW-M公头
CN4, CN7, CN9, CN13, CN16: TestPoint; TestPoint_D1.27_Reference; LCSC Part Name 测试点
D4: TCLLZ39VTR; D_MiniMELF; Tolerance ±5%; Zener Voltage (Nom) 39V; Manufacturer Part TCLLZ39VTR; LCSC Part Name TCLLZ39VTR
D22: 1.5SMC30CAHE3/57T; SMC_L6.8-W5.9-LS7.8-BI; Manufacturer Part 1.5SMC30CAHE3/57T; LCSC Part Name 1.5SMC30CAHE3/57T
D23, D24: ZMM12V; D_MiniMELF; Tolerance ±5%; Zener Voltage (Nom) 12V; Manufacturer Part ZMM12V; LCSC Part Name ZMM12V
L5, L7, L8: NCD0603R1; LED_0603_1608Metric_A1K2; Forward Voltage (VF) 1.6V~2.6V; Manufacturer Part NCD0603R1; LCSC Part Name 红灯 0603红灯 正贴
L6: 68uH; SMNR6045-680MT; Tolerance ±20%; Manufacturer Part SMNR6045-680MT; LCSC Part Name 68uH ±20% 1.2A
L9: 4.7uH; MPIH252010-4R7M-LF; Tolerance ±20%; Manufacturer Part MPIH252010-4R7M-LF; LCSC Part Name 4.7uH ±20% 1A 275mΩ
Q1: WSD90P06DN56; WSD90P06DN56_GDS123; Manufacturer Part WSD90P06DN56; LCSC Part Name P沟道 耐压:60V 电流:90A
Q2: FMMT593; SOT-23-3_L2.9-W1.3-P1.90-LS2.4-BR_1; Manufacturer Part FMMT593; LCSC Part Name FMMT593
Q3: WSD80120DN56; WSD80120DN56_GDS123; Manufacturer Part WSD80120DN56; LCSC Part Name WSD80120DN56
R40, R48, R57, R133, R153: 10kΩ; R0603_S; Overload Voltage (Max) 75V; Tolerance ±1%; Manufacturer Part 0603WAF1002T5E; LCSC Part Name 10kΩ ±1% 100mW 厚膜电阻
R41, R42, R134, R136: 0Ω; R0603_S; Overload Voltage (Max) 50V; Tolerance ±1%; Manufacturer Part RS-03000FT; LCSC Part Name 0Ω ±1% 100mW
R43: 49.9kΩ; R_0603_1608Metric; Overload Voltage (Max) 75V; Tolerance ±1%; Manufacturer Part 0603WAF4992T5E; LCSC Part Name 49.9kΩ ±1% 100mW 厚膜电阻
R44, R45: 453kΩ; R_0603_1608Metric; Overload Voltage (Max) 75V; Tolerance ±1%; Manufacturer Part 0603WAF4533T5E; LCSC Part Name 453kΩ ±1% 100mW 厚膜电阻
R46, R47: 100kΩ; R_0603_1608Metric; Overload Voltage (Max) 75V; Tolerance ±1%; Manufacturer Part RC0603FR-07100KL; LCSC Part Name 厚膜电阻 100kΩ ±1% 100mW
R131, R132: 22Ω; R0603_S; Overload Voltage (Max) 75V; Tolerance ±1%; Manufacturer Part 0603WAF220JT5E; LCSC Part Name 22Ω ±1% 100mW 厚膜电阻
R137, R138, R139, R152: 1kΩ; R0603_S; Overload Voltage (Max) 75V; Tolerance ±1%; Manufacturer Part RC0603FR-071KL; LCSC Part Name 1kΩ ±1% 100mW
R140, R141: 100kΩ; R0603_S; Overload Voltage (Max) 50V; Tolerance ±1%; Manufacturer Part RS-03K1003FT; LCSC Part Name 100kΩ ±1% 100mW
R142: 1.5MΩ; R0603_S; Overload Voltage (Max) 50V; Tolerance ±1%; Manufacturer Part RS-03L1504FT; LCSC Part Name 1.5MΩ ±1% 100mW
R154: 12kΩ; R_0603_1608Metric; Overload Voltage (Max) 75V; Tolerance ±1%; Manufacturer Part 0603WAF1202T5E; LCSC Part Name 12kΩ ±1% 100mW 厚膜电阻
R155: 62kΩ; R_0603_1608Metric; Overload Voltage (Max) 75V; Tolerance ±1%; Manufacturer Part 0603WAF6202T5E; LCSC Part Name 62kΩ ±1% 100mW 厚膜电阻
U6: LM5164DDAR; SO-8_L4.9-W3.9-P1.27-LS6.0-BL-EP; Input Voltage 6V~100V; Output Voltage 1.2V~100V; Manufacturer Part LM5164DDAR; LCSC Part Name 降压型 输入6V~100V 输出1.2V~100V 1A
U12: LM321MF/NOPB; SOT-23-5_L3.0-W1.7-P0.95-LS2.8-BR_1; Manufacturer Part LM321MF/NOPB; LCSC Part Name LM321MF/NOPB
U19: RY8411; SOT-23-6_L2.9-W1.6-P0.95-LS2.8-BR; Manufacturer Part JW5026; JLCPCB Part Class Extended Part

Connections:
5V: C19.2, C166.2, C167.2, C171.2, CN7.1 (1_1), L9.2, R152.2, R155.1; also elsewhere on the board
12V: C68.1, C71.2, C72.2, C73.1, C74.2, C137.2, C138.2, C139.2, C168.2, C169.1, C170.1, CN4.1 (1_1), L6.2, R40.2, R44.1, R153.2, U19.5 (VIN); also elsewhere on the board
/POWER_SHARED/PWR_BST_U6: C67.1, U6.7 (BST)
/POWER_SHARED/PWR_BST_U19: C172.1, U19.1 (BST)
AGND: C79.1, R57.1, U12.2 (V-); also elsewhere on the board
AVCC: R48.2, U12.5 (V+); also elsewhere on the board
DCBUS: C69.2, C70.2, C151.2, C152.2, C153.2, C154.2, C155.2, C156.2, C157.2, C158.2, C159.2, C160.2, C161.2, C164.1, C165.1, CN9.1 (1_1), Q1.2 (D), R47.1, R132.2, R133.2, R142.2, U6.2 (VIN); also elsewhere on the board
DCBUS_IN: C127.1, C162.2, C163.2, CN1.1 (-), D22.2 (A), D24.1 (K), Q1.3 (S), Q2.2 (E), R131.2, R140.2, R141.2
FB: C66.1, R43.1, R44.2, U6.5 (FB)
GND: C19.1, C69.1, C70.1, C71.1, C72.1, C73.2, C74.1, C137.1, C138.1, C139.1, C166.1, C167.1, C168.1, C169.2, C170.2, C171.1, L5.2, L7.2, L8.2, R41.1, R41.2, R42.1, R42.2, R43.2, R46.2, R134.2, R136.2, R154.2, U6.1 (GND), U6.9 (EP), U19.2 (GND); also elsewhere on the board
unnamed: C66.2, C68.2, R45.2
unnamed: C128.1, R131.1
unnamed: C129.1, R132.1
unnamed: D4.1 (C), R137.2, R141.1
unnamed: C125.1, D23.1 (K), Q3.1 (G), R140.1
unnamed: C127.2, D24.2 (A), Q1.1 (G), R139.1
unnamed: L5.1, R40.1
unnamed: L7.1, R133.1
unnamed: L8.1, R152.1
unnamed: C126.1, Q2.1 (B), R137.1, R142.1
unnamed: C126.2, Q2.3 (C), R138.1, R139.2
unnamed: R47.2, U6.3 (EN)
unnamed: R46.1, U6.4 (RON)
unnamed: C67.2, L6.1, R45.1, U6.8 (SW)
unnamed: C79.2, CN16.1 (1_1), R48.1, R57.2, U12.1 (IN+)
unnamed: R153.1, U19.4 (EN)
unnamed: R154.1, R155.2, U19.3 (FB)
unnamed: C172.2, L9.1, U19.6 (SW)
PGND: C125.2, C129.2, C151.1, C152.1, C153.1, C154.1, C155.1, C156.1, C157.1, C158.1, C159.1, C160.1, C161.1, C164.2, C165.2, D23.2 (A), Q3.3 (S), R134.1, R136.1, R138.2; also elsewhere on the board
PGND_IN: C128.2, C162.1, C163.1, CN1.2 (+), D4.2 (A), D22.1 (K), Q3.2 (D)
VREF: CN13.1 (1_1), U12.3 (IN-), U12.4 (OUT); also elsewhere on the board

Notes on the sheet:
Shared input protection, DCBUS capacitors, 12V / 5V regulators and analog VREF. One common supply only; original ratings retained, not verified for two motors.
CN1.1 external input; polarity marking requires verification
CN1.2 external supply return
DCBUS_IN via Q1 protection MOSFET
PGND_IN via Q3 protection MOSFET
U6 LM5164 SW via L6
U6 internal VCC/bootstrap diode; C67 to SW
U19 RY8411 internal bootstrap driver; C172 to SW
