CYFS3/GD32FOC/GD32F5_FOC.kicad_pcb

## KiCad design GD32F5_FOC.kicad_pcb (continued)

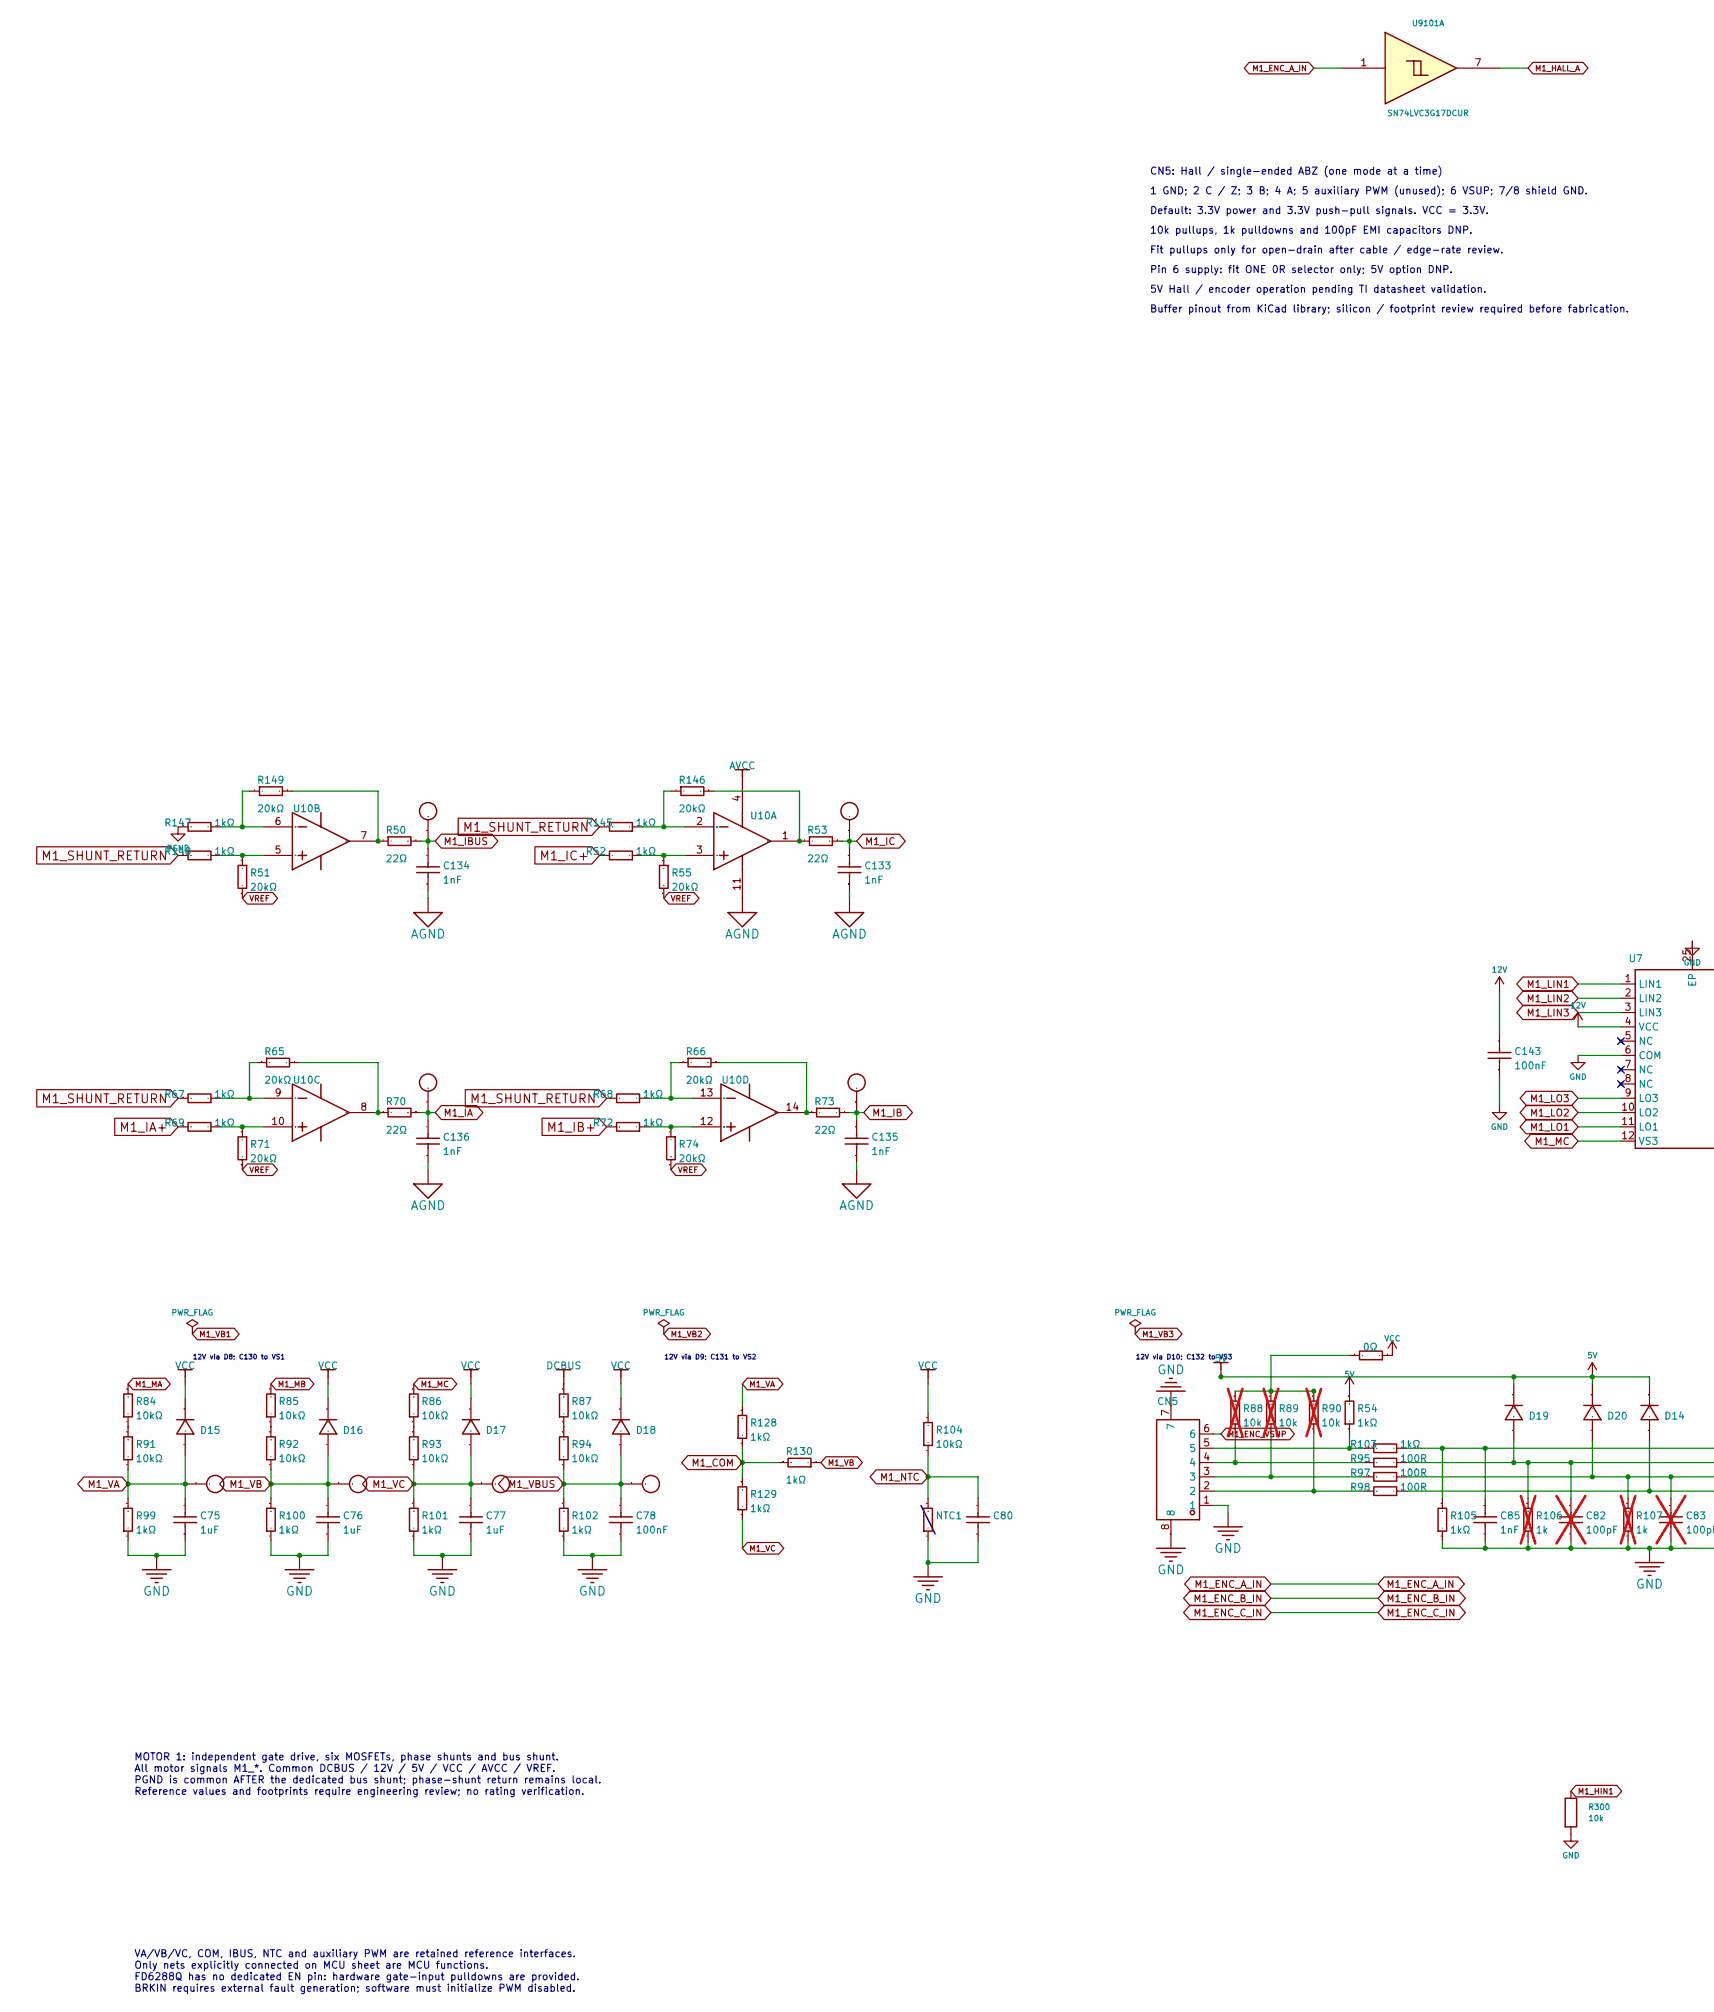
[picture p69: schematic FOC_M1.kicad_sch, part in row 1, column 1]

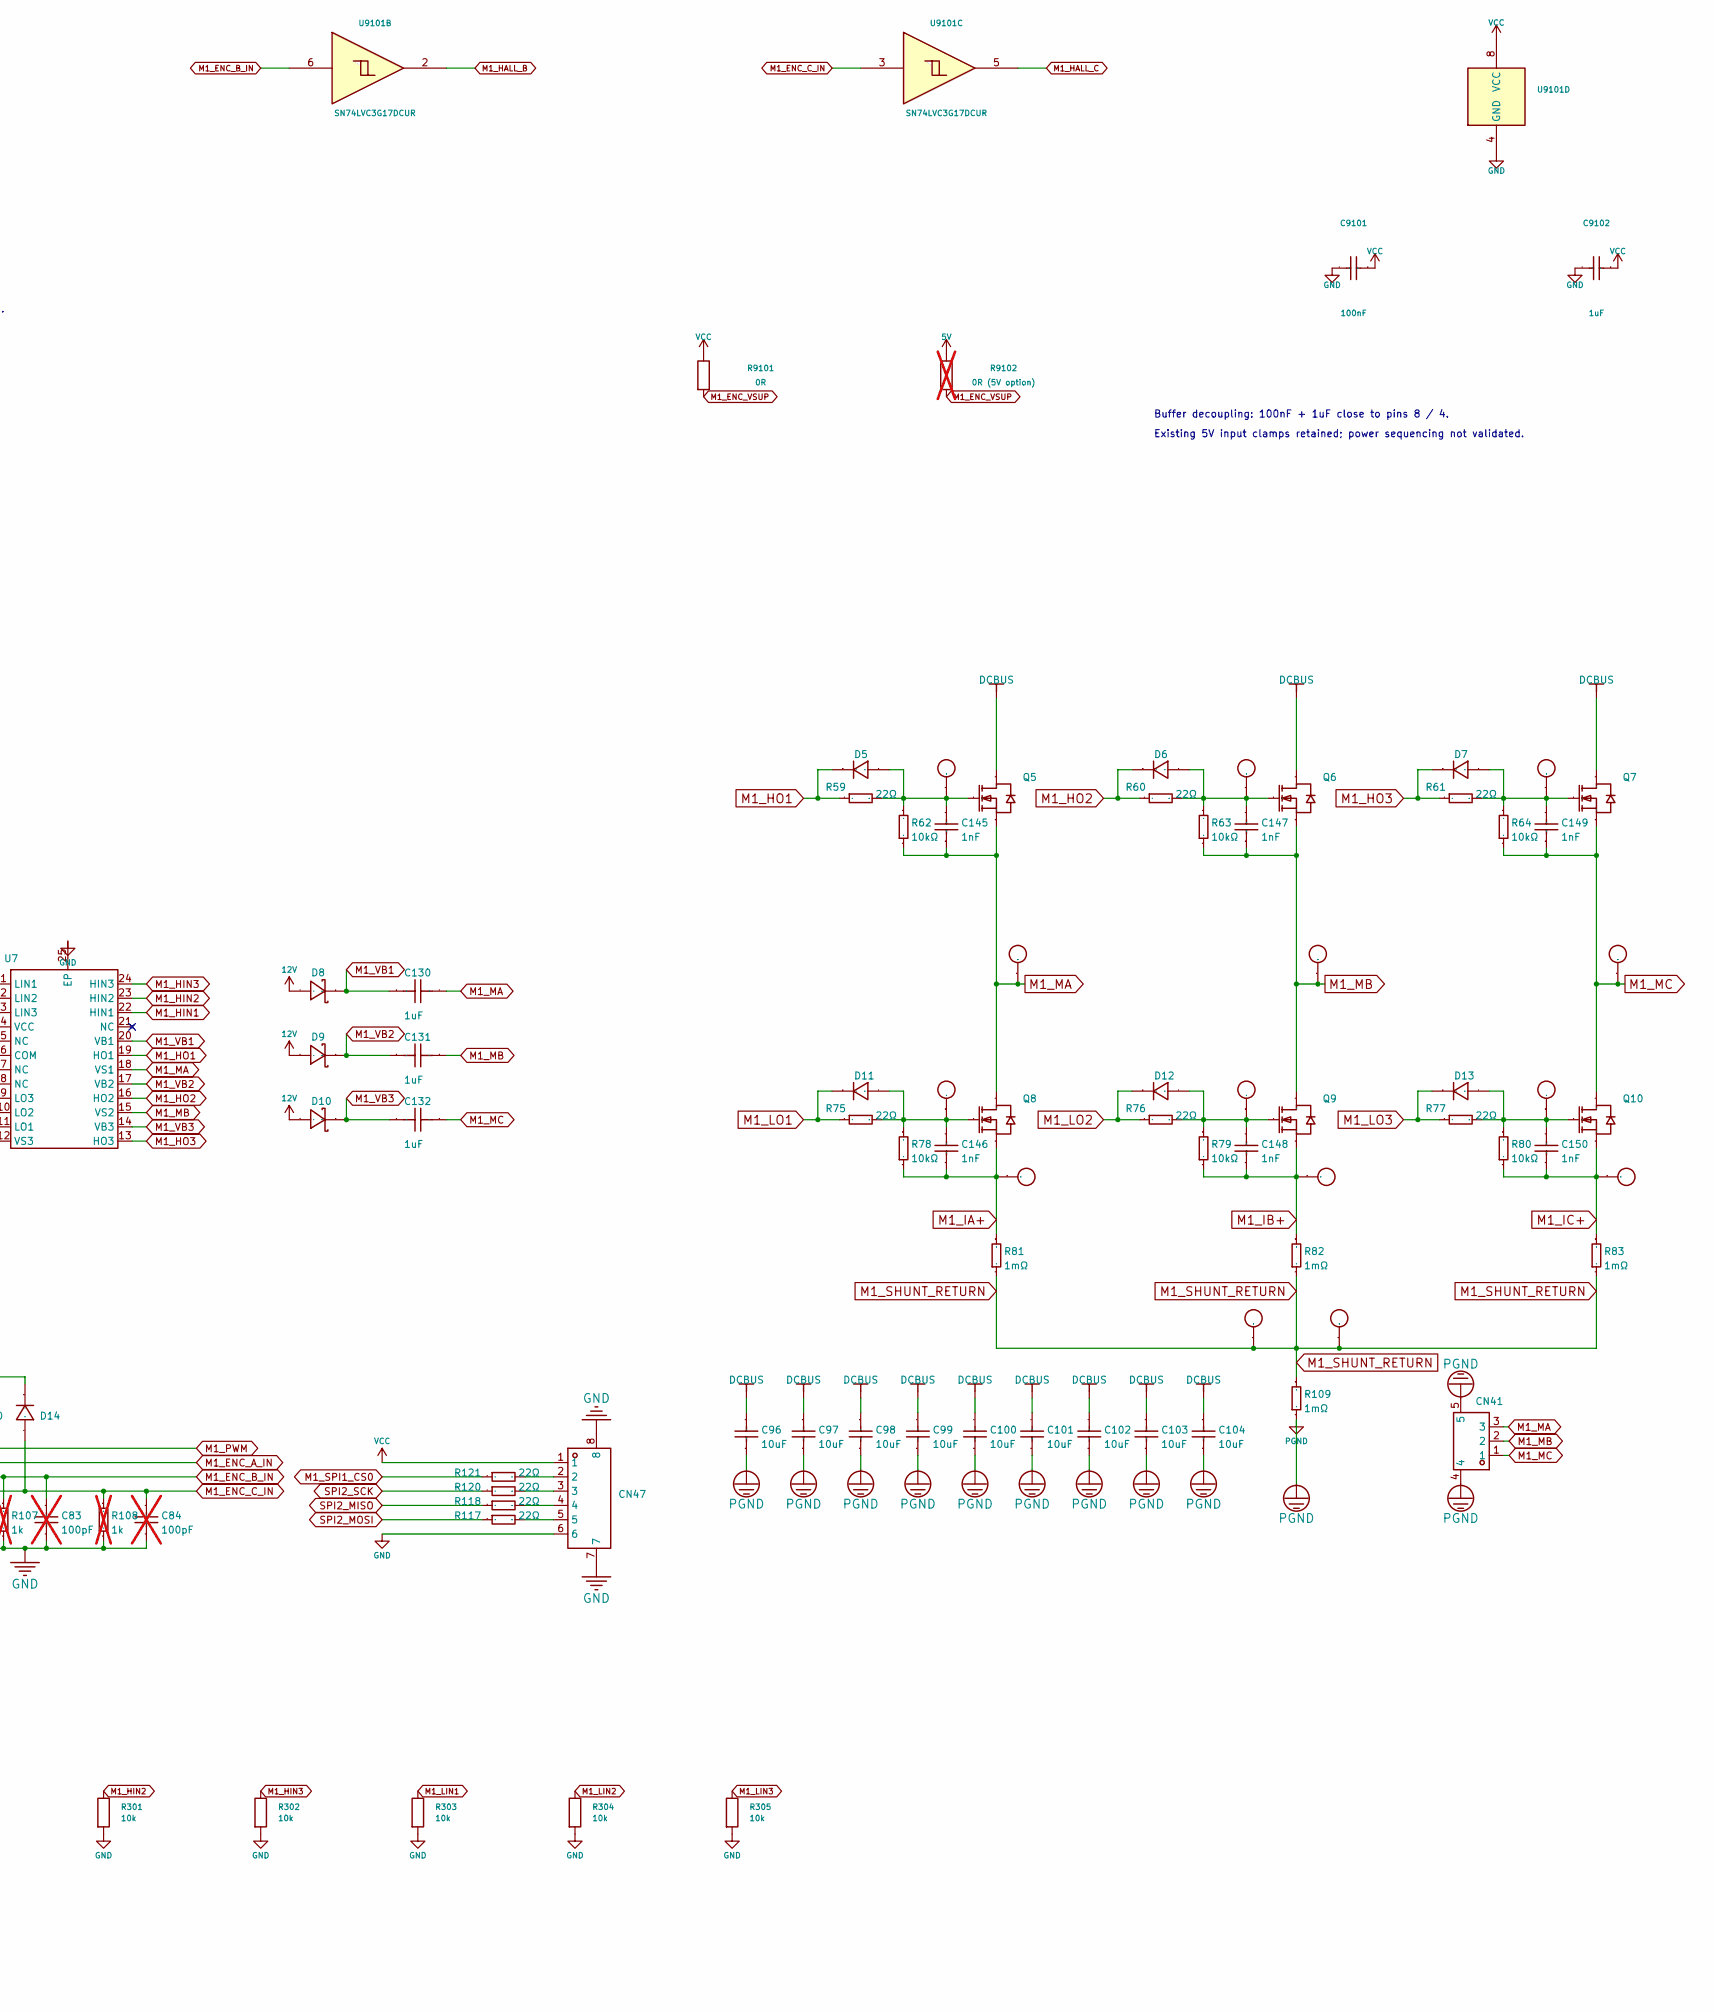
[picture p70: schematic FOC_M1.kicad_sch, part in row 1, column 2]

Parts:
C75, C76, C77: 1uF; C0603_S; Tolerance ±10%; Voltage Rated 50V; Manufacturer Part 0603B102K500NT; LCSC Part Name 1nF ±10% 50V
C78, C80: 100nF; C0603_S; Tolerance ±10%; Voltage Rated 50V; Manufacturer Part 0603B102K500NT; LCSC Part Name 1nF ±10% 50V
C82, C83, C84: 100pF; C0603_S; not fitted
C85: 1nF; C0603_S; Tolerance ±10%; Voltage Rated 50V; Manufacturer Part 0603B104K500NT; LCSC Part Name 100nF ±10% 50V
C96, C97, C98, C99, C100, C101, C102, C103, C104: 10uF; C_1206_3216Metric; Tolerance ±10%; Voltage Rated 50V; Manufacturer Part CL31A106KBHNNNE; LCSC Part Name 10uF ±10% 50V
C130, C131, C132: 1uF; C0603; Tolerance ±10%; Voltage Rating 50V; Manufacturer Part CGA0603X5R105K500JT; LCSC Part Name 1uF ±10% 50V
C133, C134, C135, C136, C145, C146, C147, C148, C149, C150: 1nF; C0603_S; Tolerance ±10%; Voltage Rated 50V; Manufacturer Part 0603B102K500NT; LCSC Part Name 1nF ±10% 50V
C143: 100nF; C0603_S; Tolerance ±10%; Voltage Rated 50V; Manufacturer Part 0603B104K500NT; LCSC Part Name 100nF ±10% 50V
C9101: 100nF; C0603_S
C9102: 1uF; C0603_S
CN5, CN47: WAFER-GH1.25-6PWB; CONN-SMD_6P-P1.25_XUNPU_WAFER-GH1.25-6PWB; Current Rating (Max) 1A; Manufacturer Part WAFER-GH1.25-6PWB; LCSC Part Name GH1.25mm6P卧贴带扣带扣
CN14, CN15, CN17, CN18, CN19, CN20, CN21, CN22, CN23, CN24, CN25, CN26, CN27, CN28, CN29, CN30, CN35, CN36, CN37, CN38, CN39, CN40: TestPoint; TestPoint_D1.27_Reference; LCSC Part Name 测试点
CN41: MR30PW-F; CONN-TH_MR30PW-F; Manufacturer Part MR30PW-F; LCSC Part Name MR30PW-F
D5, D6, D7, D11, D12, D13, D14, D15, D16, D17, D18, D19, D20: B16WS; SOD-323_L1.8-W1.3-LS2.5-RD_2; Forward Voltage (Vf@If) 700mV@1A; Reverse Voltage (Vr) 60V; Manufacturer Part B16WS; LCSC Part Name B16WS
D8, D9, D10: B16WS; D_SOD-323; Forward Voltage (Vf@If) 650mV@1A; Manufacturer Part B16WS; LCSC Part Name B16WS
NTC1: NCP18XH103F03RB; R0603_S; Resistance Tolerance ±1%; Manufacturer Part NCP18XH103F03RB; LCSC Part Name 10kΩ 电阻精度:±1% 3380K
Q5, Q6, Q7, Q8, Q9, Q10: NCE7560K; Manufacturer Part NCE7560K; LCSC Part Name N沟道 75V 60A
R49: 0Ω; R0603_S; Overload Voltage (Max) 50V; Tolerance ±1%; Manufacturer Part RS-03000FT; LCSC Part Name 0Ω ±1% 100mW
R50, R53, R59, R60, R61, R70, R73, R75, R76, R77, R117, R118, R120, R121: 22Ω; R0603_S; Overload Voltage (Max) 75V; Tolerance ±1%; Manufacturer Part 0603WAF220JT5E; LCSC Part Name 22Ω ±1% 100mW 厚膜电阻
R51, R55, R65, R66, R71, R74, R146, R149: 20kΩ; R0603_S; Overload Voltage (Max) 75V; Tolerance ±0.1%; Manufacturer Part RT0603BRD0720KL; LCSC Part Name 20kΩ ±0.1% 100mW
R52, R67, R68, R69, R72, R145, R147, R148: 1kΩ; R0603_S; Overload Voltage (Max) 75V; Tolerance ±0.1%; Manufacturer Part RT0603BRD071KL; LCSC Part Name 1kΩ ±0.1% 100mW
R54, R103, R105, R128, R129, R130: 1kΩ; R0603_S; Overload Voltage (Max) 75V; Tolerance ±1%; Manufacturer Part 0603WAF1002T5E; LCSC Part Name 10kΩ ±1% 100mW 厚膜电阻
R62, R63, R64, R78, R79, R80, R104: 10kΩ; R0603_S; Overload Voltage (Max) 75V; Tolerance ±1%; Manufacturer Part 0603WAF1002T5E; LCSC Part Name 10kΩ ±1% 100mW 厚膜电阻
R81, R82, R83, R109: 1mΩ; R_2512_6332Metric
R84, R85, R86, R87, R91, R92, R93, R94: 10kΩ; R0603_S; Overload Voltage (Max) 75V; Tolerance ±1%; Manufacturer Part 0603WAF1502T5E; LCSC Part Name 15kΩ ±1% 100mW 厚膜电阻
R88, R89, R90: 10k; R0603_S; not fitted
R95, R97, R98: 100R; R0603_S
R99, R100, R101, R102: 1kΩ; R0603_S; Overload Voltage (Max) 75V; Tolerance ±1%; Manufacturer Part 0603WAF2001T5E; LCSC Part Name 2kΩ ±1% 100mW 厚膜电阻
R106, R107, R108: 1k; R0603_S; not fitted
R300, R301, R302, R303, R304, R305: 10k; R_0603_1608Metric
R9101: 0R; R_0603_1608Metric
R9102: 0R (5V option); R_0603_1608Metric; not fitted
U7: FD6288Q; QFN-24_L4.0-W4.0-P0.50-BL-EP2.6; Manufacturer Part FD6288Q; LCSC Part Name FD6288Q
U10: RS624XQ; TSSOP-14_4.4x5mm_P0.65mm; Manufacturer Part RS624XQ; LCSC Part Name 低噪声运放RS624XQ
U9101: SN74LVC3G17DCUR; VSSOP-8_2.3x2mm_P0.5mm

Connections:
5V: D14.1 (-), D19.1 (-), D20.1 (-), R54.1, R9102.1; also elsewhere on the board
12V: C143.2, D8.2, D9.2, D10.2, U7.4 (VCC); also elsewhere on the board
AGND: C133.1, C134.1, C135.1, C136.1, U10.11 (V-); also elsewhere on the board
AVCC: U10.4 (V+); also elsewhere on the board
DCBUS: C96.2, C97.2, C98.2, C99.2, C100.2, C101.2, C102.2, C103.2, C104.2, Q5.2 (D), Q6.2 (D), Q7.2 (D), R87.1; also elsewhere on the board
GND: C75.1, C76.1, C77.1, C78.1, C80.1, C82.2, C83.2, C84.2, C85.2, C143.1, C9101.2, C9102.2, CN5.1, CN5.7, CN5.8, CN47.6, CN47.7, CN47.8, NTC1.2, R99.2, R100.2, R101.2, R102.2, R105.2, R106.2, R107.2, R108.2, R300.2, R301.2, R302.2, R303.2, R304.2, R305.2, U7.6 (COM), U7.25 (EP), U9101.4 (GND); also elsewhere on the board
M1_COM: R128.2, R129.1, R130.1
M1_ENC_A_IN: C82.1, D19.2 (+), R95.2, R106.1, U9101.1
M1_ENC_B_IN: C83.1, D20.2 (+), R97.2, R107.1, U9101.6
M1_ENC_C_IN: C84.1, D14.2 (+), R98.2, R108.1, U9101.3
M1_ENC_VSUP: CN5.6, R9101.2, R9102.2
M1_HALL_A: U9101.7; also elsewhere on the board
M1_HALL_B: U9101.2; also elsewhere on the board
M1_HALL_C: U9101.5; also elsewhere on the board
M1_HIN1: R300.1, U7.22 (HIN1); also elsewhere on the board
M1_HIN2: R301.1, U7.23 (HIN2); also elsewhere on the board
M1_HIN3: R302.1, U7.24 (HIN3); also elsewhere on the board
M1_HO1: D5.1 (-), R59.2, U7.19 (HO1)
M1_HO2: D6.1 (-), R60.2, U7.16 (HO2)
M1_HO3: D7.1 (-), R61.2, U7.13 (HO3)
M1_IA: C136.2, CN20.1 (1_1), R70.1; also elsewhere on the board
M1_IA+: C146.1, CN28.1 (1_1), Q8.3 (S), R69.1, R78.2, R81.1
M1_IB: C135.2, CN21.1 (1_1), R73.1; also elsewhere on the board
M1_IB+: C148.1, CN29.1 (1_1), Q9.3 (S), R72.1, R79.2, R82.1
M1_IBUS: C134.2, CN14.1 (1_1), R50.1; also elsewhere on the board
M1_IC: C133.2, CN15.1 (1_1), R53.1; also elsewhere on the board
M1_IC+: C150.1, CN30.1 (1_1), Q10.3 (S), R52.1, R80.2, R83.1
M1_LIN1: R303.1, U7.1 (LIN1); also elsewhere on the board
M1_LIN2: R304.1, U7.2 (LIN2); also elsewhere on the board
M1_LIN3: R305.1, U7.3 (LIN3); also elsewhere on the board
M1_LO1: D11.1 (-), R75.2, U7.11 (LO1)
M1_LO2: D12.1 (-), R76.2, U7.10 (LO2)
M1_LO3: D13.1 (-), R77.2, U7.9 (LO3)
M1_MA: C130.2, C145.1, CN22.1 (1_1), CN41.3, Q5.3 (S), Q8.2 (D), R62.2, R84.1, U7.18 (VS1)
M1_MB: C131.2, C147.1, CN23.1 (1_1), CN41.2, Q6.3 (S), Q9.2 (D), R63.2, R85.1, U7.15 (VS2)
M1_MC: C132.2, C149.1, CN24.1 (1_1), CN41.1, Q7.3 (S), Q10.2 (D), R64.2, R86.1, U7.12 (VS3)
M1_NTC: C80.2, NTC1.1, R104.2; also elsewhere on the board
M1_PWM: C85.1, R103.2, R105.1
M1_SHUNT_RETURN: CN35.1 (1_1), CN36.1 (1_1), R67.1, R68.1, R81.2, R82.2, R83.2, R109.1, R145.1, R148.1
M1_SPI1_CS0: R121.2; also elsewhere on the board
M1_VA: C75.2, CN37.1 (1_1), D15.2 (+), R91.2, R99.1, R128.1
M1_VB: C76.2, CN38.1 (1_1), D16.2 (+), R92.2, R100.1, R130.2
M1_VB1: C130.1, D8.1, U7.20 (VB1)
M1_VB2: C131.1, D9.1, U7.17 (VB2)
M1_VB3: C132.1, D10.1, U7.14 (VB3)
M1_VBUS: C78.2, CN40.1 (1_1), D18.2 (+), R94.2, R102.1; also elsewhere on the board
M1_VC: C77.2, CN39.1 (1_1), D17.2 (+), R93.2, R101.1, R129.2
unnamed: CN5.2, R90.2, R98.1
unnamed: CN5.3, R89.2, R97.1
unnamed: CN5.4, R88.2, R95.1
unnamed: CN5.5, R54.2, R103.1
unnamed: CN47.2, R121.1
unnamed: CN47.3, R120.1
unnamed: CN47.4, R118.1
unnamed: CN47.5, R117.1
unnamed: C145.2, CN17.1 (1_1), D5.2 (+), Q5.1 (G), R59.1, R62.1
unnamed: C147.2, CN18.1 (1_1), D6.2 (+), Q6.1 (G), R60.1, R63.1
unnamed: C149.2, CN19.1 (1_1), D7.2 (+), Q7.1 (G), R61.1, R64.1
unnamed: C146.2, CN25.1 (1_1), D11.2 (+), Q8.1 (G), R75.1, R78.1
unnamed: C148.2, CN26.1 (1_1), D12.2 (+), Q9.1 (G), R76.1, R79.1
unnamed: C150.2, CN27.1 (1_1), D13.2 (+), Q10.1 (G), R77.1, R80.1
unnamed: R49.1, R88.1, R89.1, R90.1
unnamed: R84.2, R91.1
unnamed: R85.2, R92.1
unnamed: R86.2, R93.1
unnamed: R87.2, R94.1
unnamed: R52.2, R55.2, U10.3 (+INA)
unnamed: R145.2, R146.2, U10.2 (-INA)
unnamed: R53.2, R146.1, U10.1 (OUTA)
unnamed: R51.2, R148.2, U10.5 (+INB)
unnamed: R147.2, R149.2, U10.6 (-INB)
unnamed: R50.2, R149.1, U10.7 (OUTB)
unnamed: R69.2, R71.2, U10.10 (+INC)
unnamed: R65.2, R67.2, U10.9 (-INC)
unnamed: R65.1, R70.2, U10.8 (OUTC)
unnamed: R72.2, R74.2, U10.12 (+IND)
unnamed: R66.2, R68.2, U10.13 (-IND)
unnamed: R66.1, R73.2, U10.14 (OUTD)
PGND: C96.1, C97.1, C98.1, C99.1, C100.1, C101.1, C102.1, C103.1, C104.1, CN41.4, CN41.5, R109.2, R147.1; also elsewhere on the board
SPI2_MISO: R118.2; also elsewhere on the board
SPI2_MOSI: R117.2; also elsewhere on the board
SPI2_SCK: R120.2; also elsewhere on the board
VCC: C9101.1, C9102.1, CN47.1, D15.1 (-), D16.1 (-), D17.1 (-), D18.1 (-), R49.2, R104.1, R9101.1, U9101.8 (VCC); also elsewhere on the board
VREF: R51.1, R55.1, R71.1, R74.1; also elsewhere on the board

Notes on the sheet:
MOTOR 1: independent gate drive, six MOSFETs, phase shunts and bus shunt. All motor signals M1_*. Common DCBUS / 12V / 5V / VCC / AVCC / VREF. PGND is common AFTER the dedicated bus shunt; phase-shunt return remains local. Reference values and footprints require engineering review; no rating verifi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
VA/VB/VC, COM, IBUS, NTC and auxiliary PWM are retained reference interfaces. Only nets explicitly connected on MCU sheet are MCU functions. FD6288Q has no dedicated EN pin: hardware gate-input pulldowns are provided. BRKIN requires external fault generation; software must initialize PWM disabled.
CN5: Hall / single-ended ABZ (one mode at a time)
1 GND; 2 C / Z; 3 B; 4 A; 5 auxiliary PWM (unused); 6 VSUP; 7/8 shield GND.
Default: 3.3V power and 3.3V push-pull signals. VCC = 3.3V.
10k pullups, 1k pulldowns and 100pF EMI capacitors DNP.
Fit pullups only for open-drain after cable / edge-rate review.
Pin 6 supply: fit ONE 0R selector only; 5V option DNP.
5V Hall / encoder operation pending TI datasheet validation.
Buffer pinout from KiCad library; silicon / footprint review required before fabrication.
Buffer decoupling: 100nF + 1uF close to pins 8 / 4.
Existing 5V input clamps retained; power sequencing not validated.
12V via D8; C130 to VS1
12V via D9; C131 to VS2
12V via D10; C132 to VS3
