CYFS3/GD32FOC/GD32F5_FOC.kicad_pcb

## KiCad design GD32F5_FOC.kicad_pcb (continued)

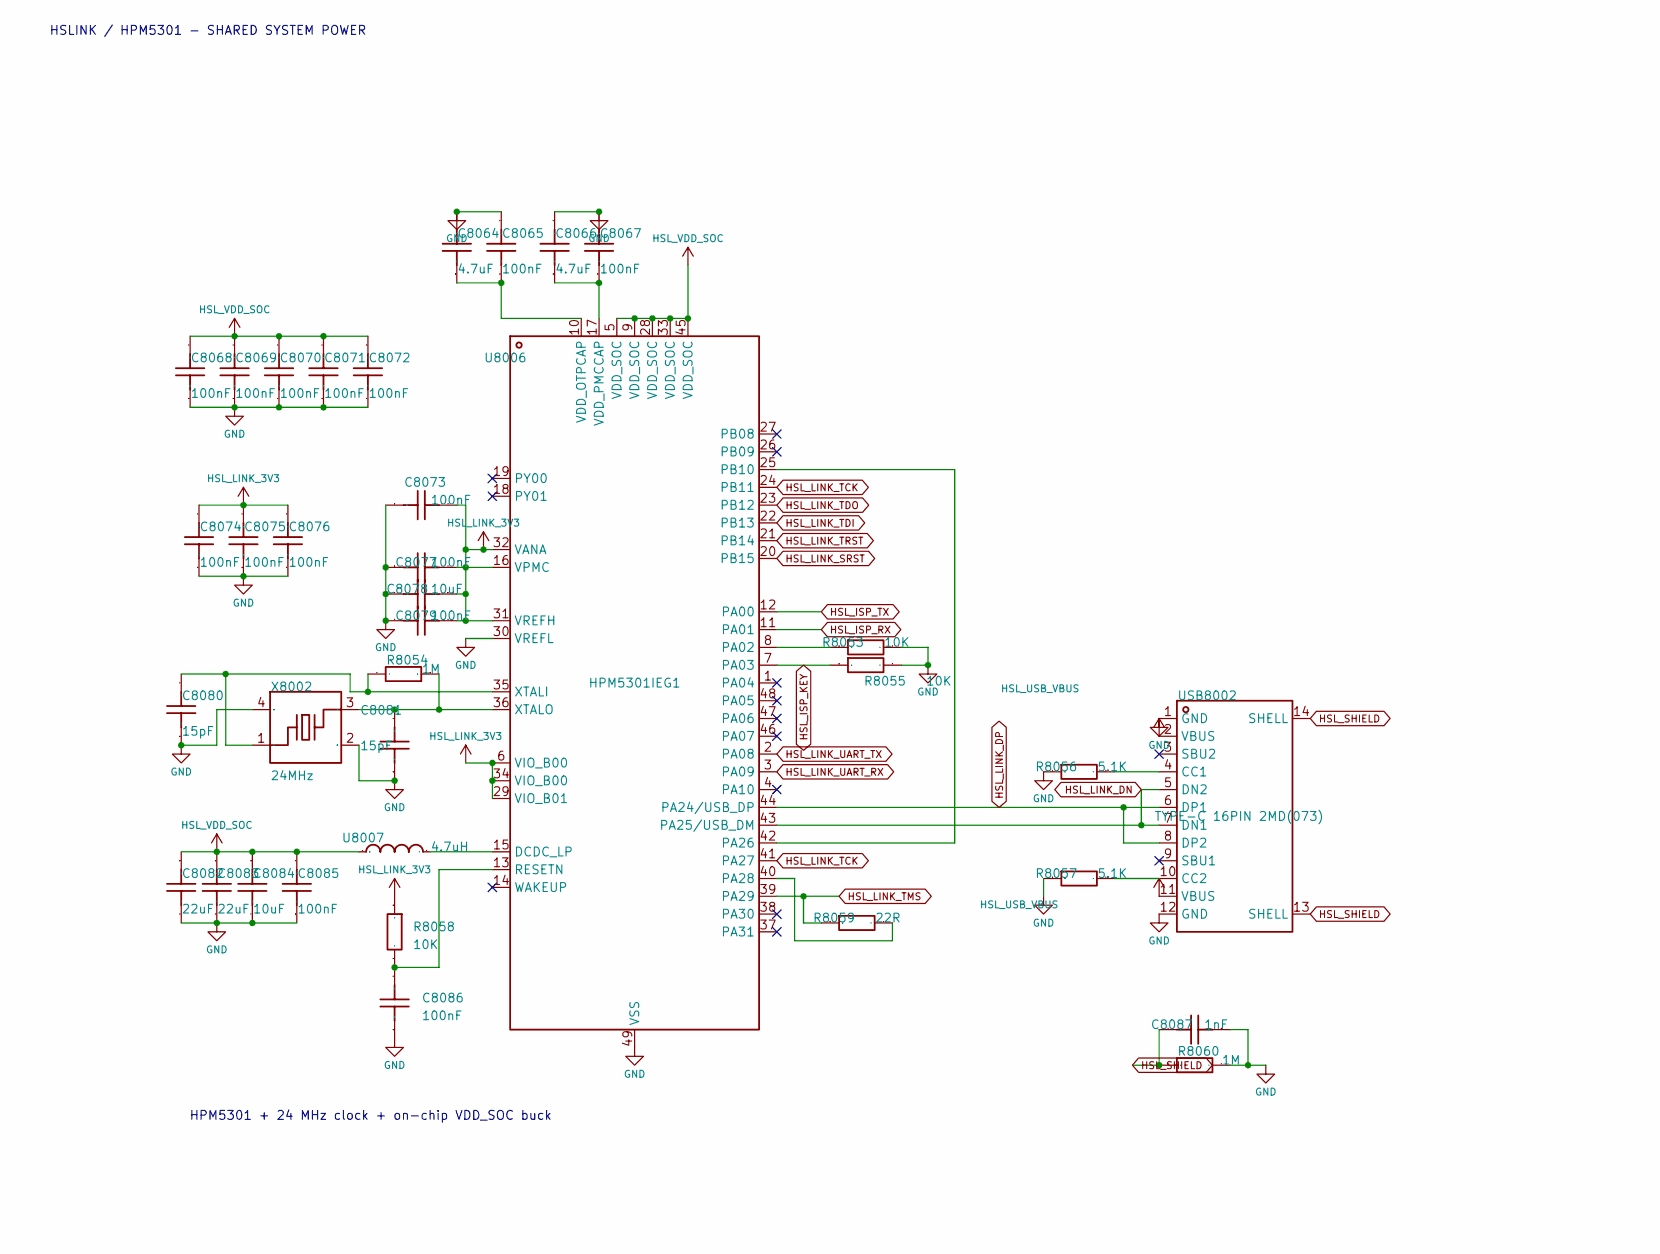
[picture p71: schematic HSLink.kicad_sch, part in row 1, column 1]

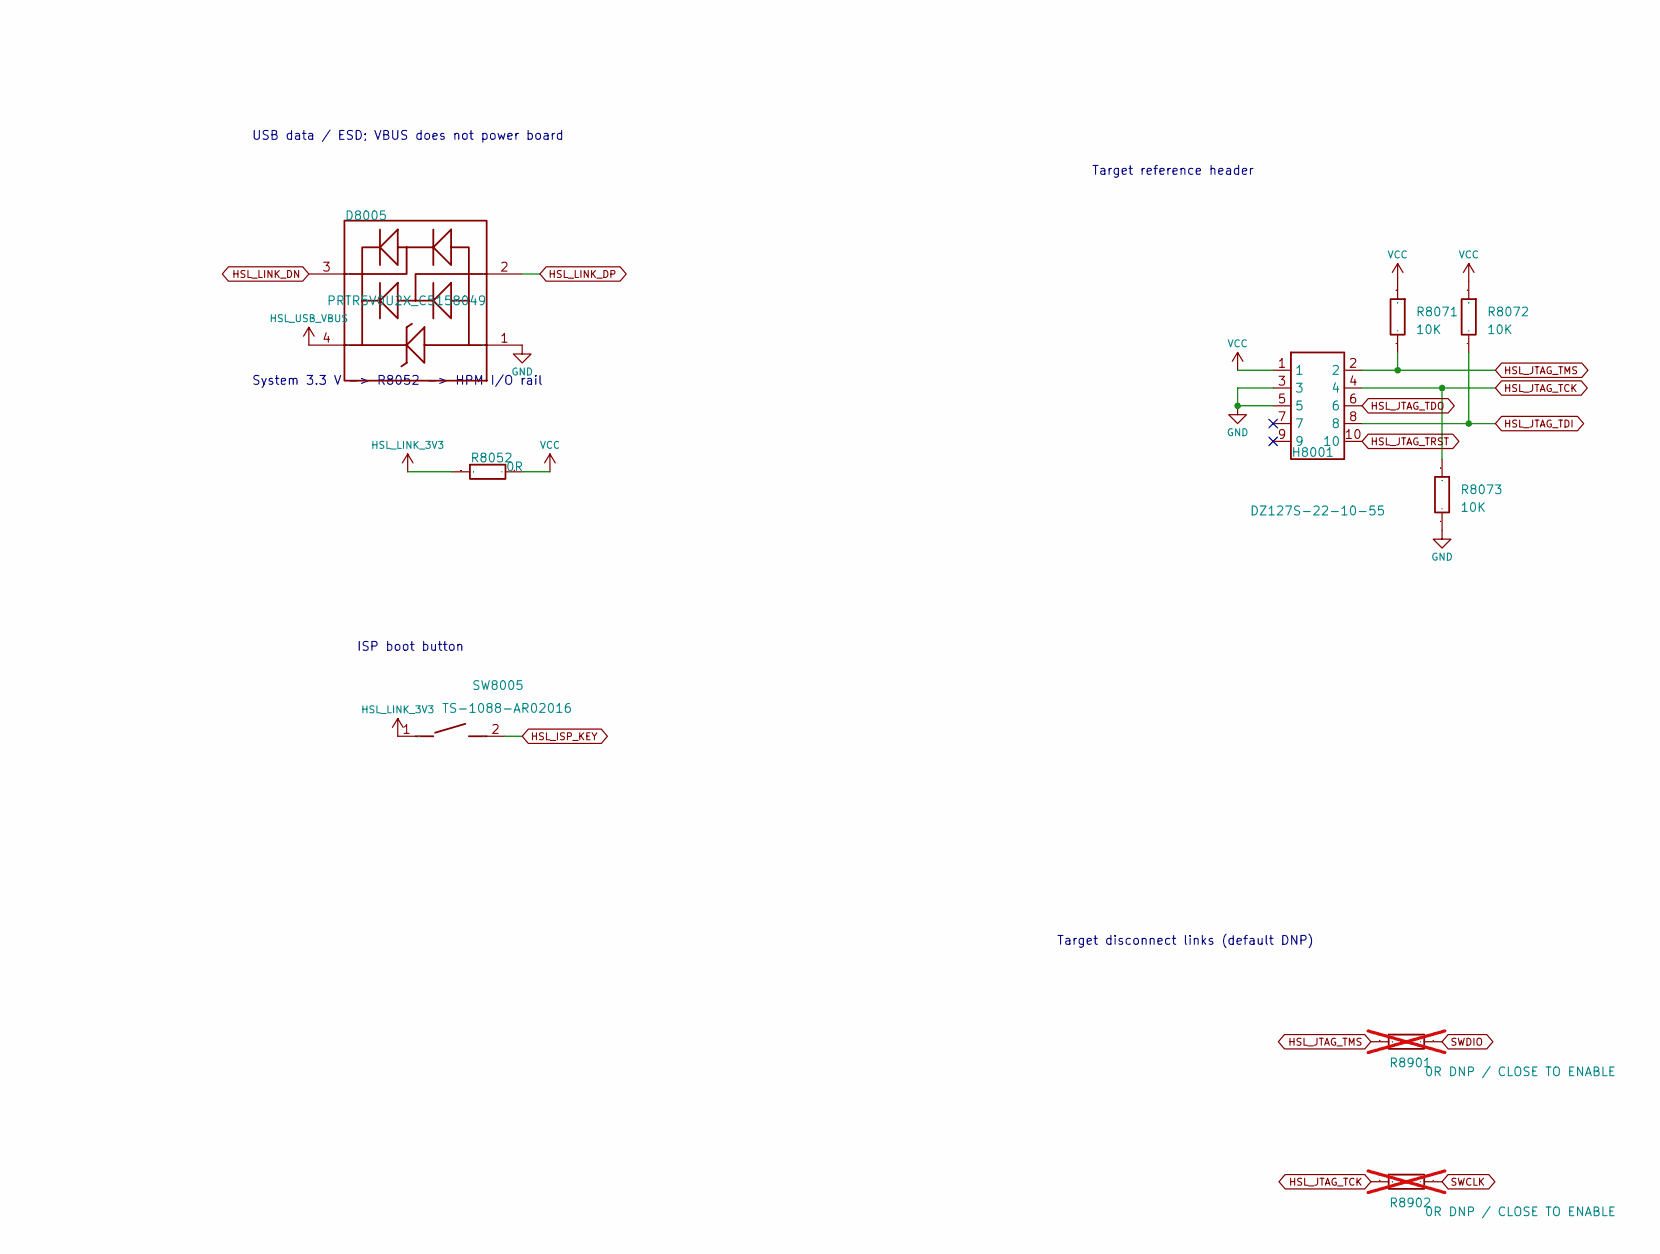
[picture p72: schematic HSLink.kicad_sch, part in row 1, column 2]

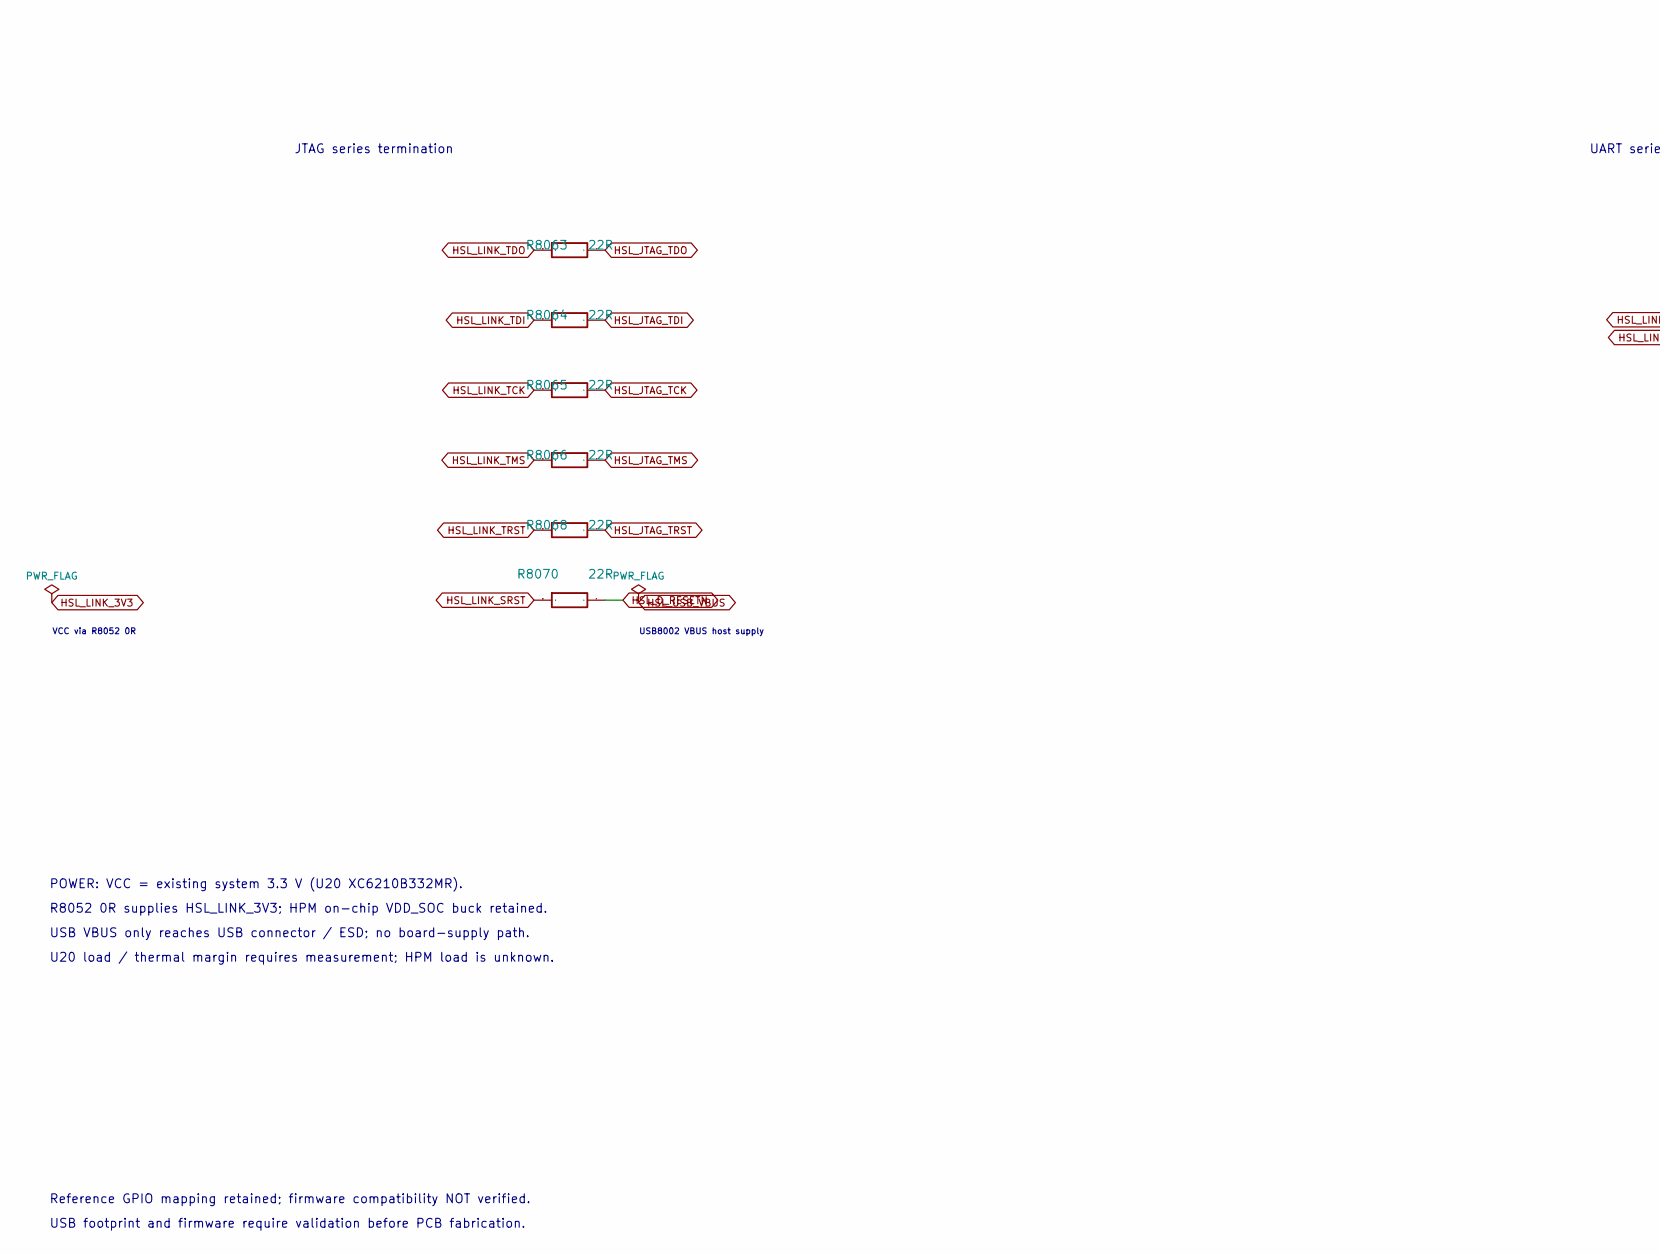
[picture p73: schematic HSLink.kicad_sch, part in row 2, column 1]

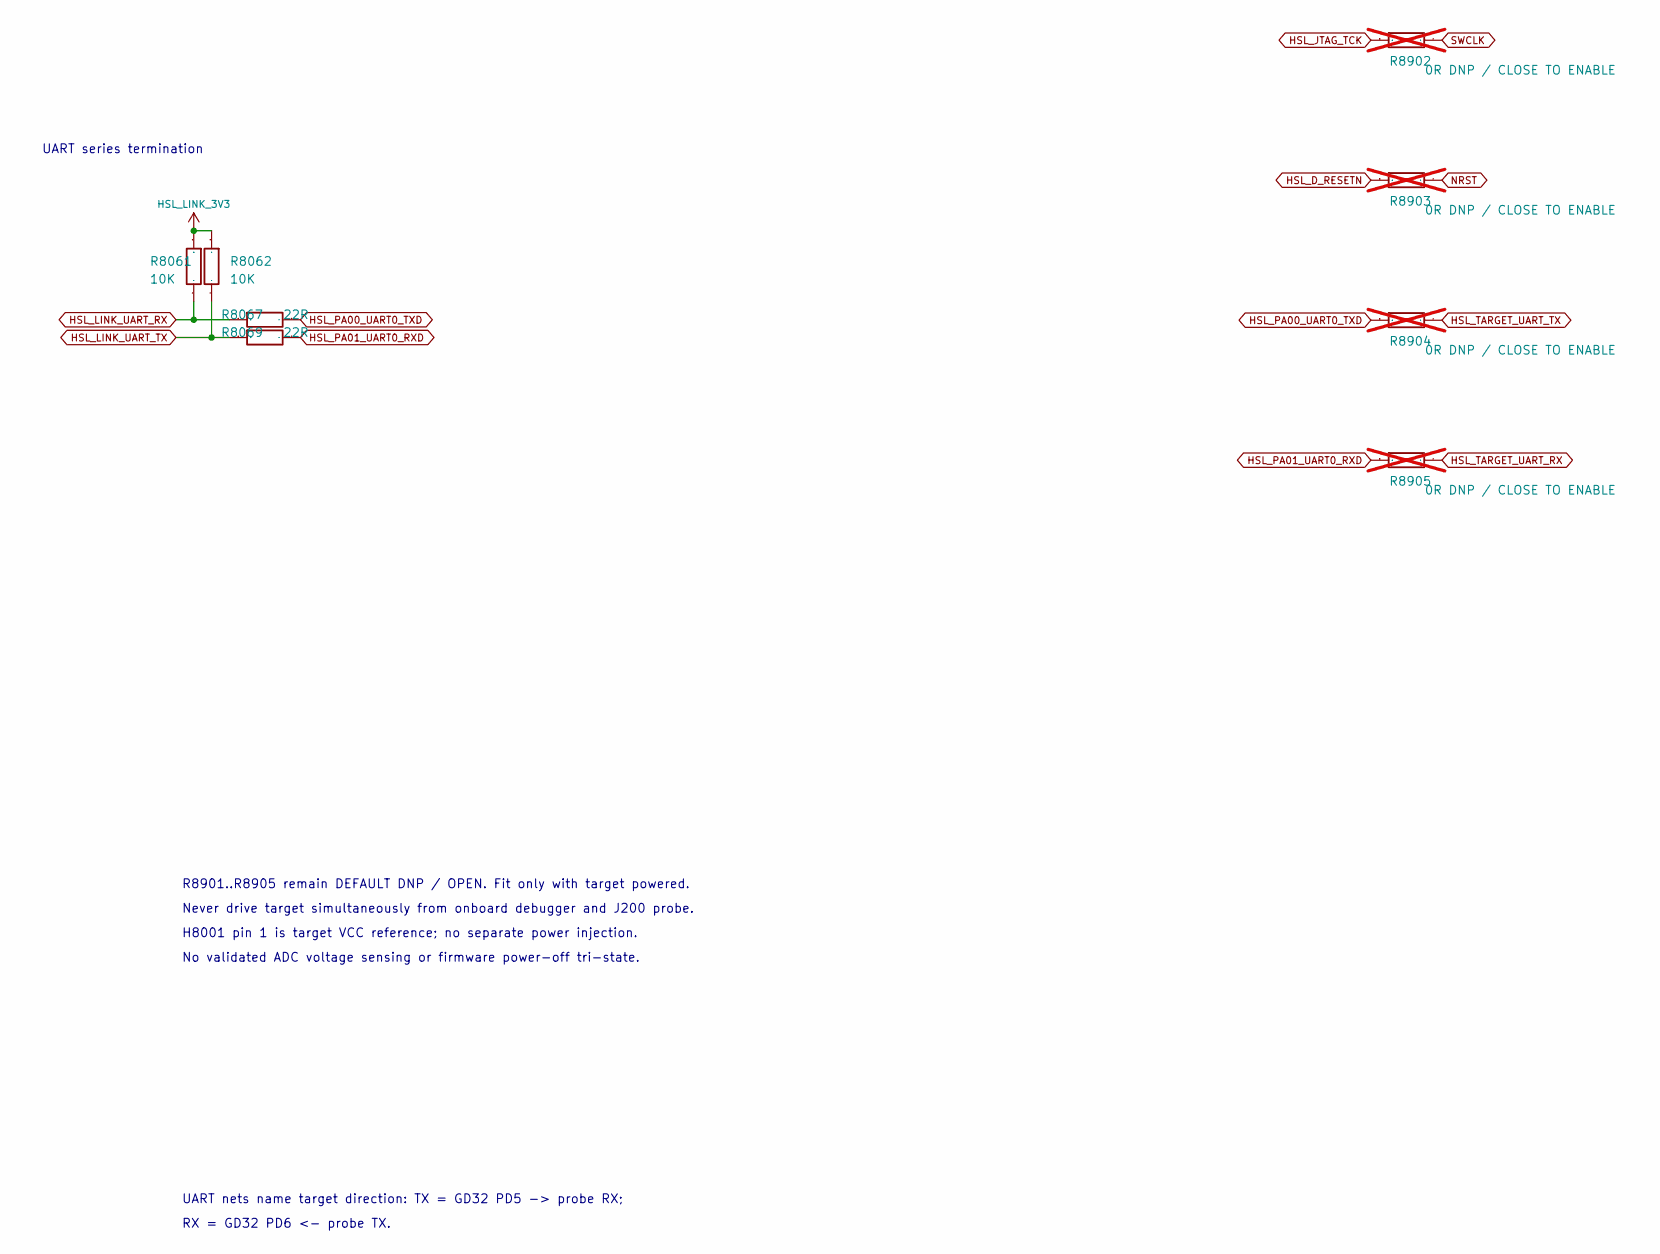
[picture p74: schematic HSLink.kicad_sch, part in row 2, column 2]

Parts:
C8064, C8066: 4.7uF; C0603
C8065, C8067, C8068, C8069, C8070, C8071, C8072, C8073, C8074, C8075, C8076, C8077, C8079, C8085, C8086: 100nF; C0603
C8078, C8084: 10uF; C0603
C8080, C8081: 15pF; C0603
C8082, C8083: 22uF; C0603
C8087: 1nF; C0603
D8005: PRTR5V0U2X_C5158049; SOT-143_L2.9-W1.3-P1.92-LS2.3-BL; Manufacturer Part PRTR5V0U2X; LCSC Part Name ESD
H8001: DZ127S-22-10-55; HDR-SMD_10P-P1.27-V-M-R2-C5-S1.27-LS5.5; Manufacturer Part DZ127S-22-10-55; LCSC Part Name 2x5P 间距:1.27mm 方针 立贴
R8052: 0R; R0603
R8053, R8055, R8058, R8061, R8062, R8071, R8072, R8073: 10K; R0603
R8054, R8060: 1M; R0603
R8056, R8057: 5.1K; R0603
R8059, R8063, R8064, R8065, R8066, R8067, R8068, R8069, R8070: 22R; R0603
R8901, R8902, R8903, R8904, R8905: 0R DNP / CLOSE TO ENABLE; R0603; not fitted
SW8005: TS-1088-AR02016; SW-SMD_L3.9-W3.0-P4.45; Manufacturer Part TS-1088-AR02016; LCSC Part Name 4*3*2mm 立贴 轻触开关
U8006: HPM5301IEG1; QFN-48_L6.0-W6.0-P0.40-TL-EP4.2; Manufacturer Part HPM5301IEG1; LCSC Part Name HPM5301IEG1
U8007: 4.7uH; IND-SMD_L2.5-W2.0-VLS252012CX-150M; Manufacturer Part FTC252010S4R7MBCA; LCSC Part Name 4.7uH ±20% 2.6A
USB8002: TYPE-C 16PIN 2MD(073); USB-C-SMD_TYPE-C-6PIN-2MD-073; Manufacturer Part TYPE-C 16PIN 2MD(073); LCSC Part Name Type-C 母 卧贴
X8002: 24MHz; CRYSTAL-SMD_4P-L2.0-W1.6-BL-A; Manufacturer Part XL7EL89CKI-111YLC-24M; LCSC Part Name YSX211SL 24MHZ 4P 2016 8PF ±10PPM -40~8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

Connections:
GND: C8064.2, C8065.2, C8066.2, C8067.2, C8068.1, C8069.1, C8070.1, C8071.1, C8072.1, C8073.1, C8074.1, C8075.1, C8076.1, C8077.1, C8078.2, C8079.1, C8080.1, C8081.1, C8082.2, C8083.2, C8084.2, C8085.1, C8086.1, C8087.1, D8005.1, H8001.3, H8001.5, R8053.2, R8055.2, R8056.1, R8057.1, R8060.2, R8073.2, U8006.30 (VREFL), U8006.49 (VSS), USB8002.1 (GND), USB8002.12 (GND), X8002.2 (GND), X8002.4 (GND); also elsewhere on the board
HSL_D_RESETN: R8070.2, R8903.1
HSL_ISP_KEY: R8055.1, SW8005.2, U8006.7 (PA03)
HSL_ISP_RX: U8006.11 (PA01)
HSL_ISP_TX: U8006.12 (PA00)
HSL_JTAG_TCK: H8001.4, R8065.2, R8073.1, R8902.1
HSL_JTAG_TDI: H8001.8, R8064.2, R8072.2
HSL_JTAG_TDO: H8001.6, R8063.2
HSL_JTAG_TMS: H8001.2, R8066.2, R8071.2, R8901.1
HSL_JTAG_TRST: H8001.10, R8068.2
HSL_LINK_3V3: C8073.2, C8074.2, C8075.2, C8076.2, C8077.2, C8078.1, C8079.2, R8052.1, R8058.1, R8061.1, R8062.1, SW8005.1, U8006.6 (VIO_B00), U8006.16 (VPMC), U8006.29 (VIO_B01), U8006.31 (VREFH), U8006.32 (VANA), U8006.34 (VIO_B00)
HSL_LINK_DN: D8005.3, U8006.43 (PA25/USB_DM), USB8002.5 (DN2), USB8002.7 (DN1)
HSL_LINK_DP: D8005.2, U8006.44 (PA24/USB_DP), USB8002.6 (DP1), USB8002.8 (DP2)
HSL_LINK_SRST: R8070.1, U8006.20 (PB15)
HSL_LINK_TCK: R8065.1, U8006.24 (PB11), U8006.41 (PA27)
HSL_LINK_TDI: R8064.1, U8006.22 (PB13)
HSL_LINK_TDO: R8063.1, U8006.23 (PB12)
HSL_LINK_TMS: R8059.1, R8066.1, U8006.39 (PA29)
HSL_LINK_TRST: R8068.1, U8006.21 (PB14)
HSL_LINK_UART_RX: R8061.2, R8067.1, U8006.3 (PA09)
HSL_LINK_UART_TX: R8062.2, R8069.1, U8006.2 (PA08)
HSL_PA00_UART0_TXD: R8067.2, R8904.1
HSL_PA01_UART0_RXD: R8069.2, R8905.1
HSL_SHIELD: C8087.2, R8060.1, USB8002.13 (SHELL), USB8002.14 (SHELL)
HSL_TARGET_UART_RX: R8905.2; also elsewhere on the board
HSL_TARGET_UART_TX: R8904.2; also elsewhere on the board
HSL_USB_VBUS: D8005.4, USB8002.2 (VBUS), USB8002.11 (VBUS)
HSL_VDD_SOC: C8068.2, C8069.2, C8070.2, C8071.2, C8072.2, C8082.1, C8083.1, C8084.1, C8085.2, U8006.5 (VDD_SOC), U8006.9 (VDD_SOC), U8006.28 (VDD_SOC), U8006.33 (VDD_SOC), U8006.45 (VDD_SOC), U8007.1
NRST: R8903.2; also elsewhere on the board
unnamed: U8006.15 (DCDC_LP), U8007.2
unnamed: R8053.1, U8006.8 (PA02)
unnamed: U8006.25 (PB10), U8006.42 (PA26)
unnamed: R8059.2, U8006.40 (PA28)
unnamed: C8086.2, R8058.2, U8006.13 (RESETN)
unnamed: C8064.1, C8065.1, U8006.10 (VDD_OTPCAP)
unnamed: C8066.1, C8067.1, U8006.17 (VDD_PMCCAP)
unnamed: C8080.2, R8054.2, U8006.35 (XTALI), X8002.1
unnamed: C8081.2, R8054.1, U8006.36 (XTALO), X8002.3
unnamed: R8056.2, USB8002.4 (CC1)
unnamed: R8057.2, USB8002.10 (CC2)
SWCLK: R8902.2; also elsewhere on the board
SWDIO: R8901.2; also elsewhere on the board
VCC: H8001.1, R8052.2, R8071.1, R8072.1; also elsewhere on the board

Notes on the sheet:
Target disconnect links (default DNP)
U20 load / thermal margin requires measurement; HPM load is unknown.
ISP boot button
HSLINK / HPM5301 - SHARED SYSTEM POWER
USB data / ESD; VBUS does not power board
UART series termination
H8001 pin 1 is target VCC reference; no separate power injection.
No validated ADC voltage sensing or firmware power-off tri-state.
RX = GD32 PD6 <- probe TX.
USB VBUS only reaches USB connector / ESD; no board-supply path.
Target reference header
Never drive target simultaneously from onboard debugger and J200 probe.
Reference GPIO mapping retained; firmware compatibility NOT verified.
UART nets name target direction: TX = GD32 PD5 -> probe RX;
POWER: VCC = existing system 3.3 V (U20 XC6210B332MR).
System 3.3 V -> R8052 -> HPM I/O rail
HPM5301 + 24 MHz clock + on-chip VDD_SOC buck
R8052 0R supplies HSL_LINK_3V3; HPM on-chip VDD_SOC buck retained.
USB footprint and firmware require validation before PCB fabrication.
R8901..R8905 remain DEFAULT DNP / OPEN. Fit only with target powered.
JTAG series termination
VCC via R8052 0R
USB8002 VBUS host supply
