CYFS3/GD32FOC/GD32F5_FOC.kicad_pcb

## KiCad design GD32F5_FOC.kicad_pcb (continued)

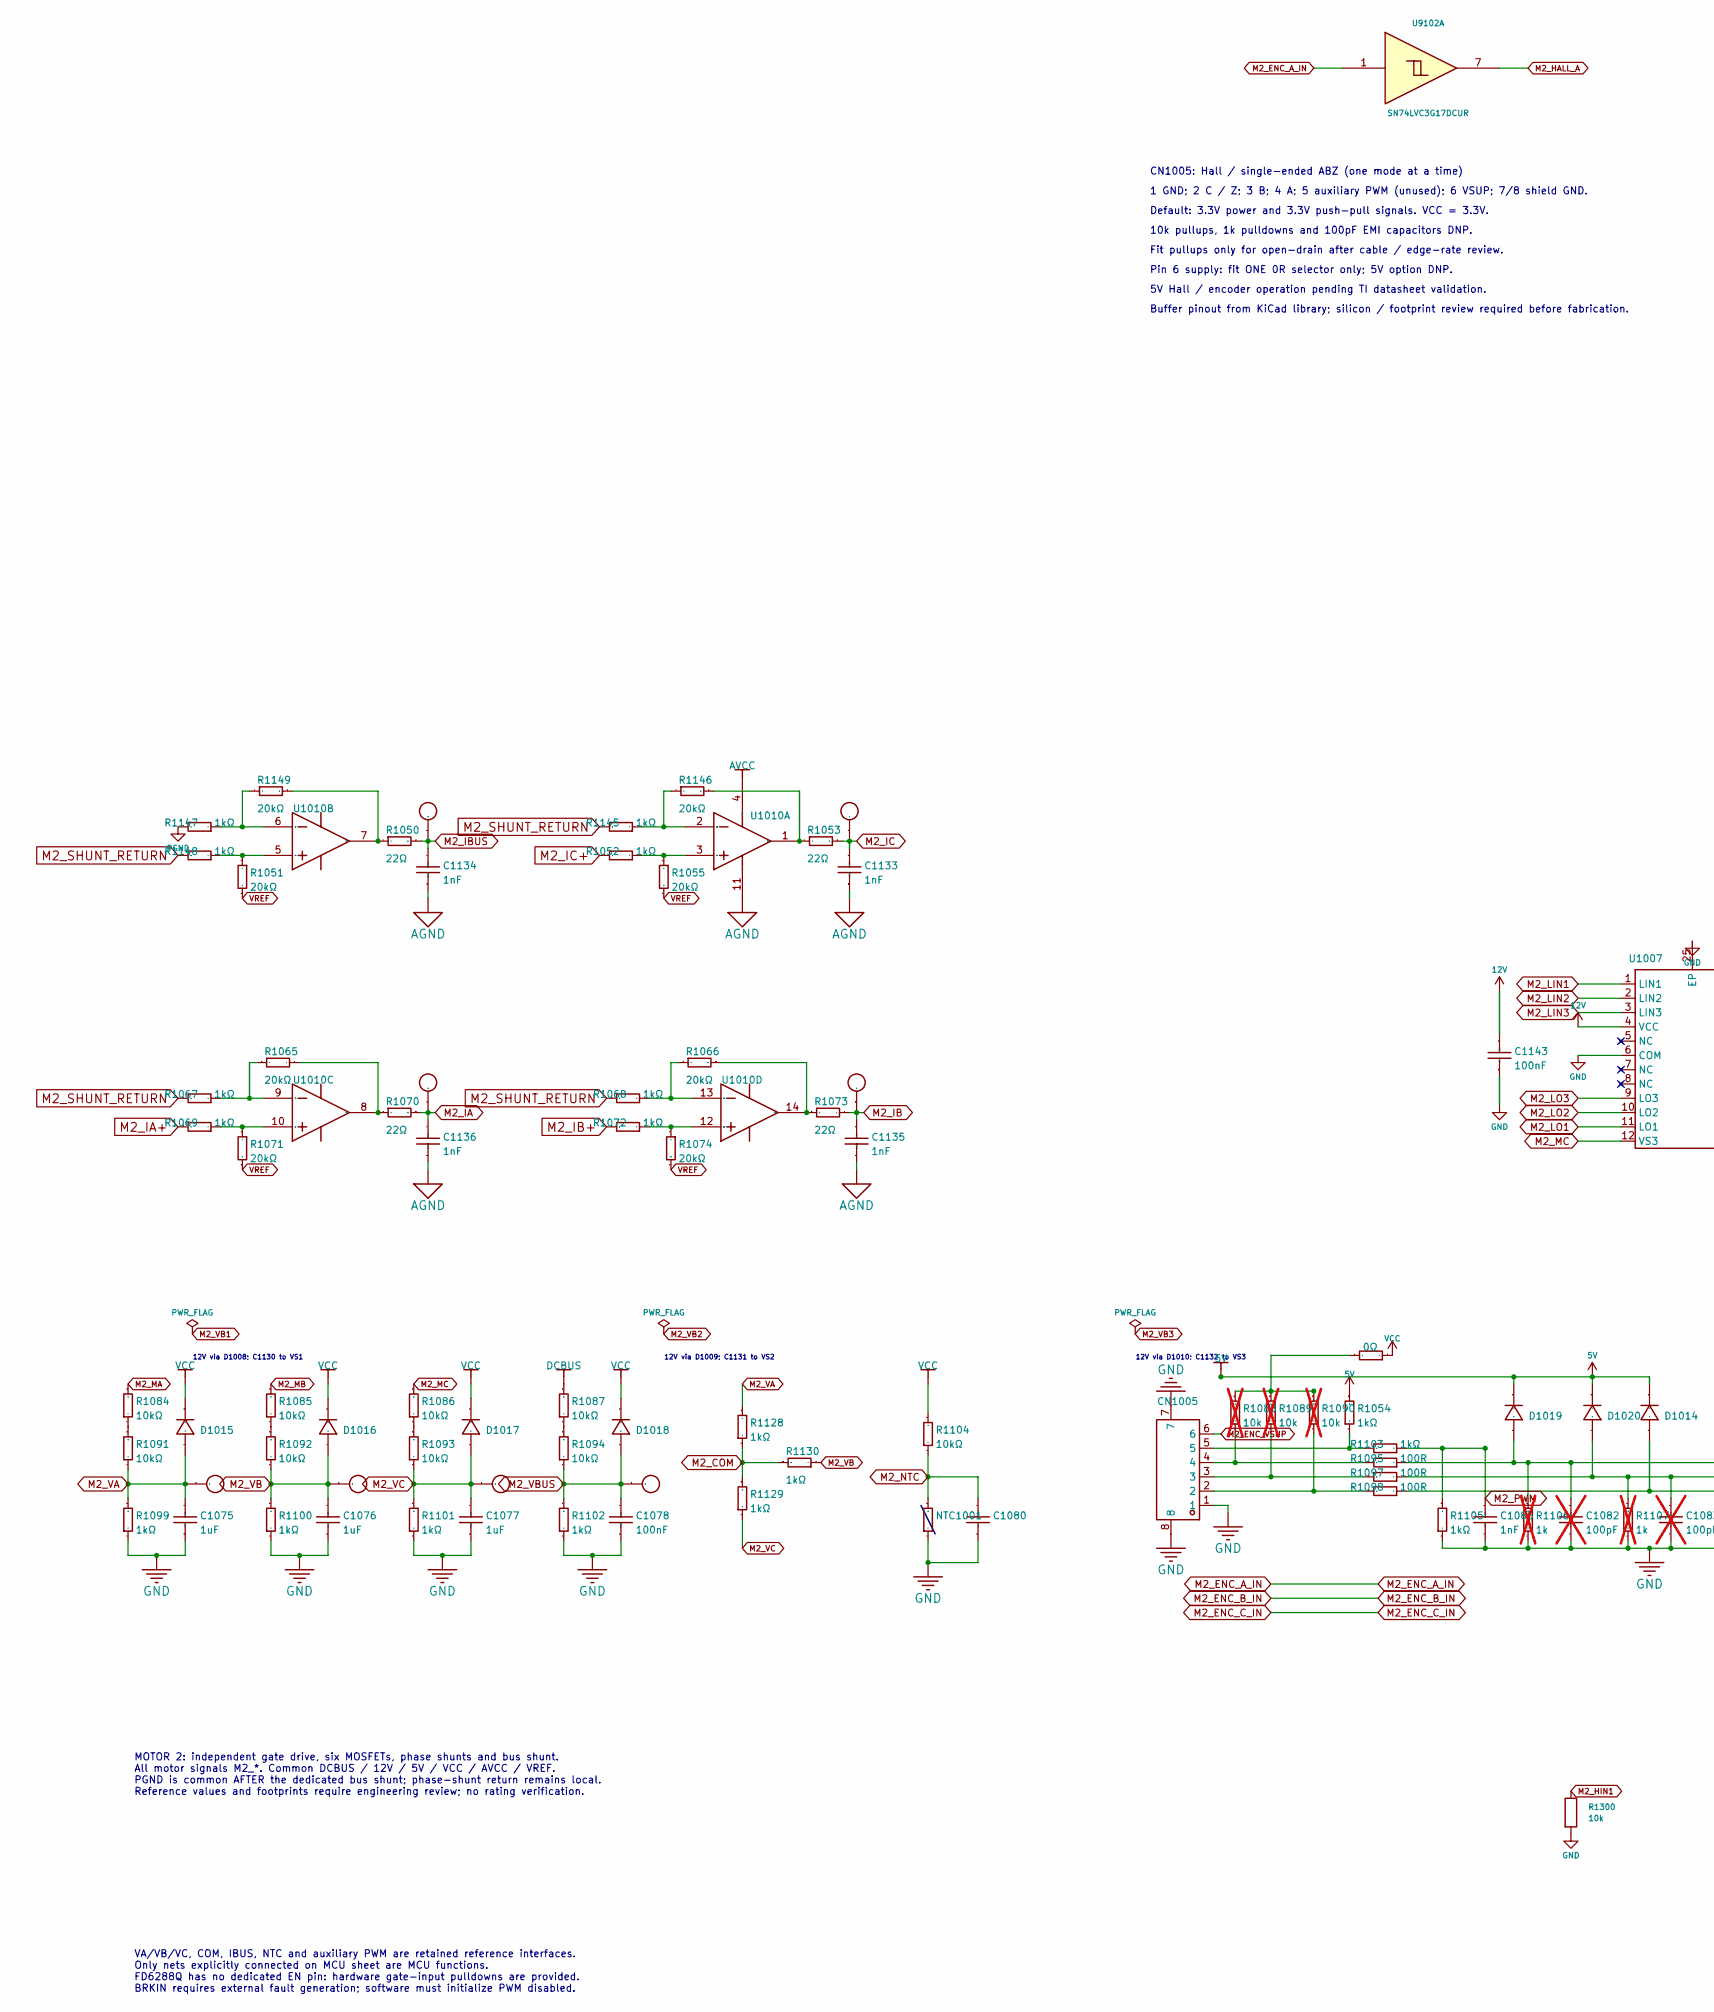
[picture p75: schematic FOC_M2.kicad_sch, part in row 1, column 1]

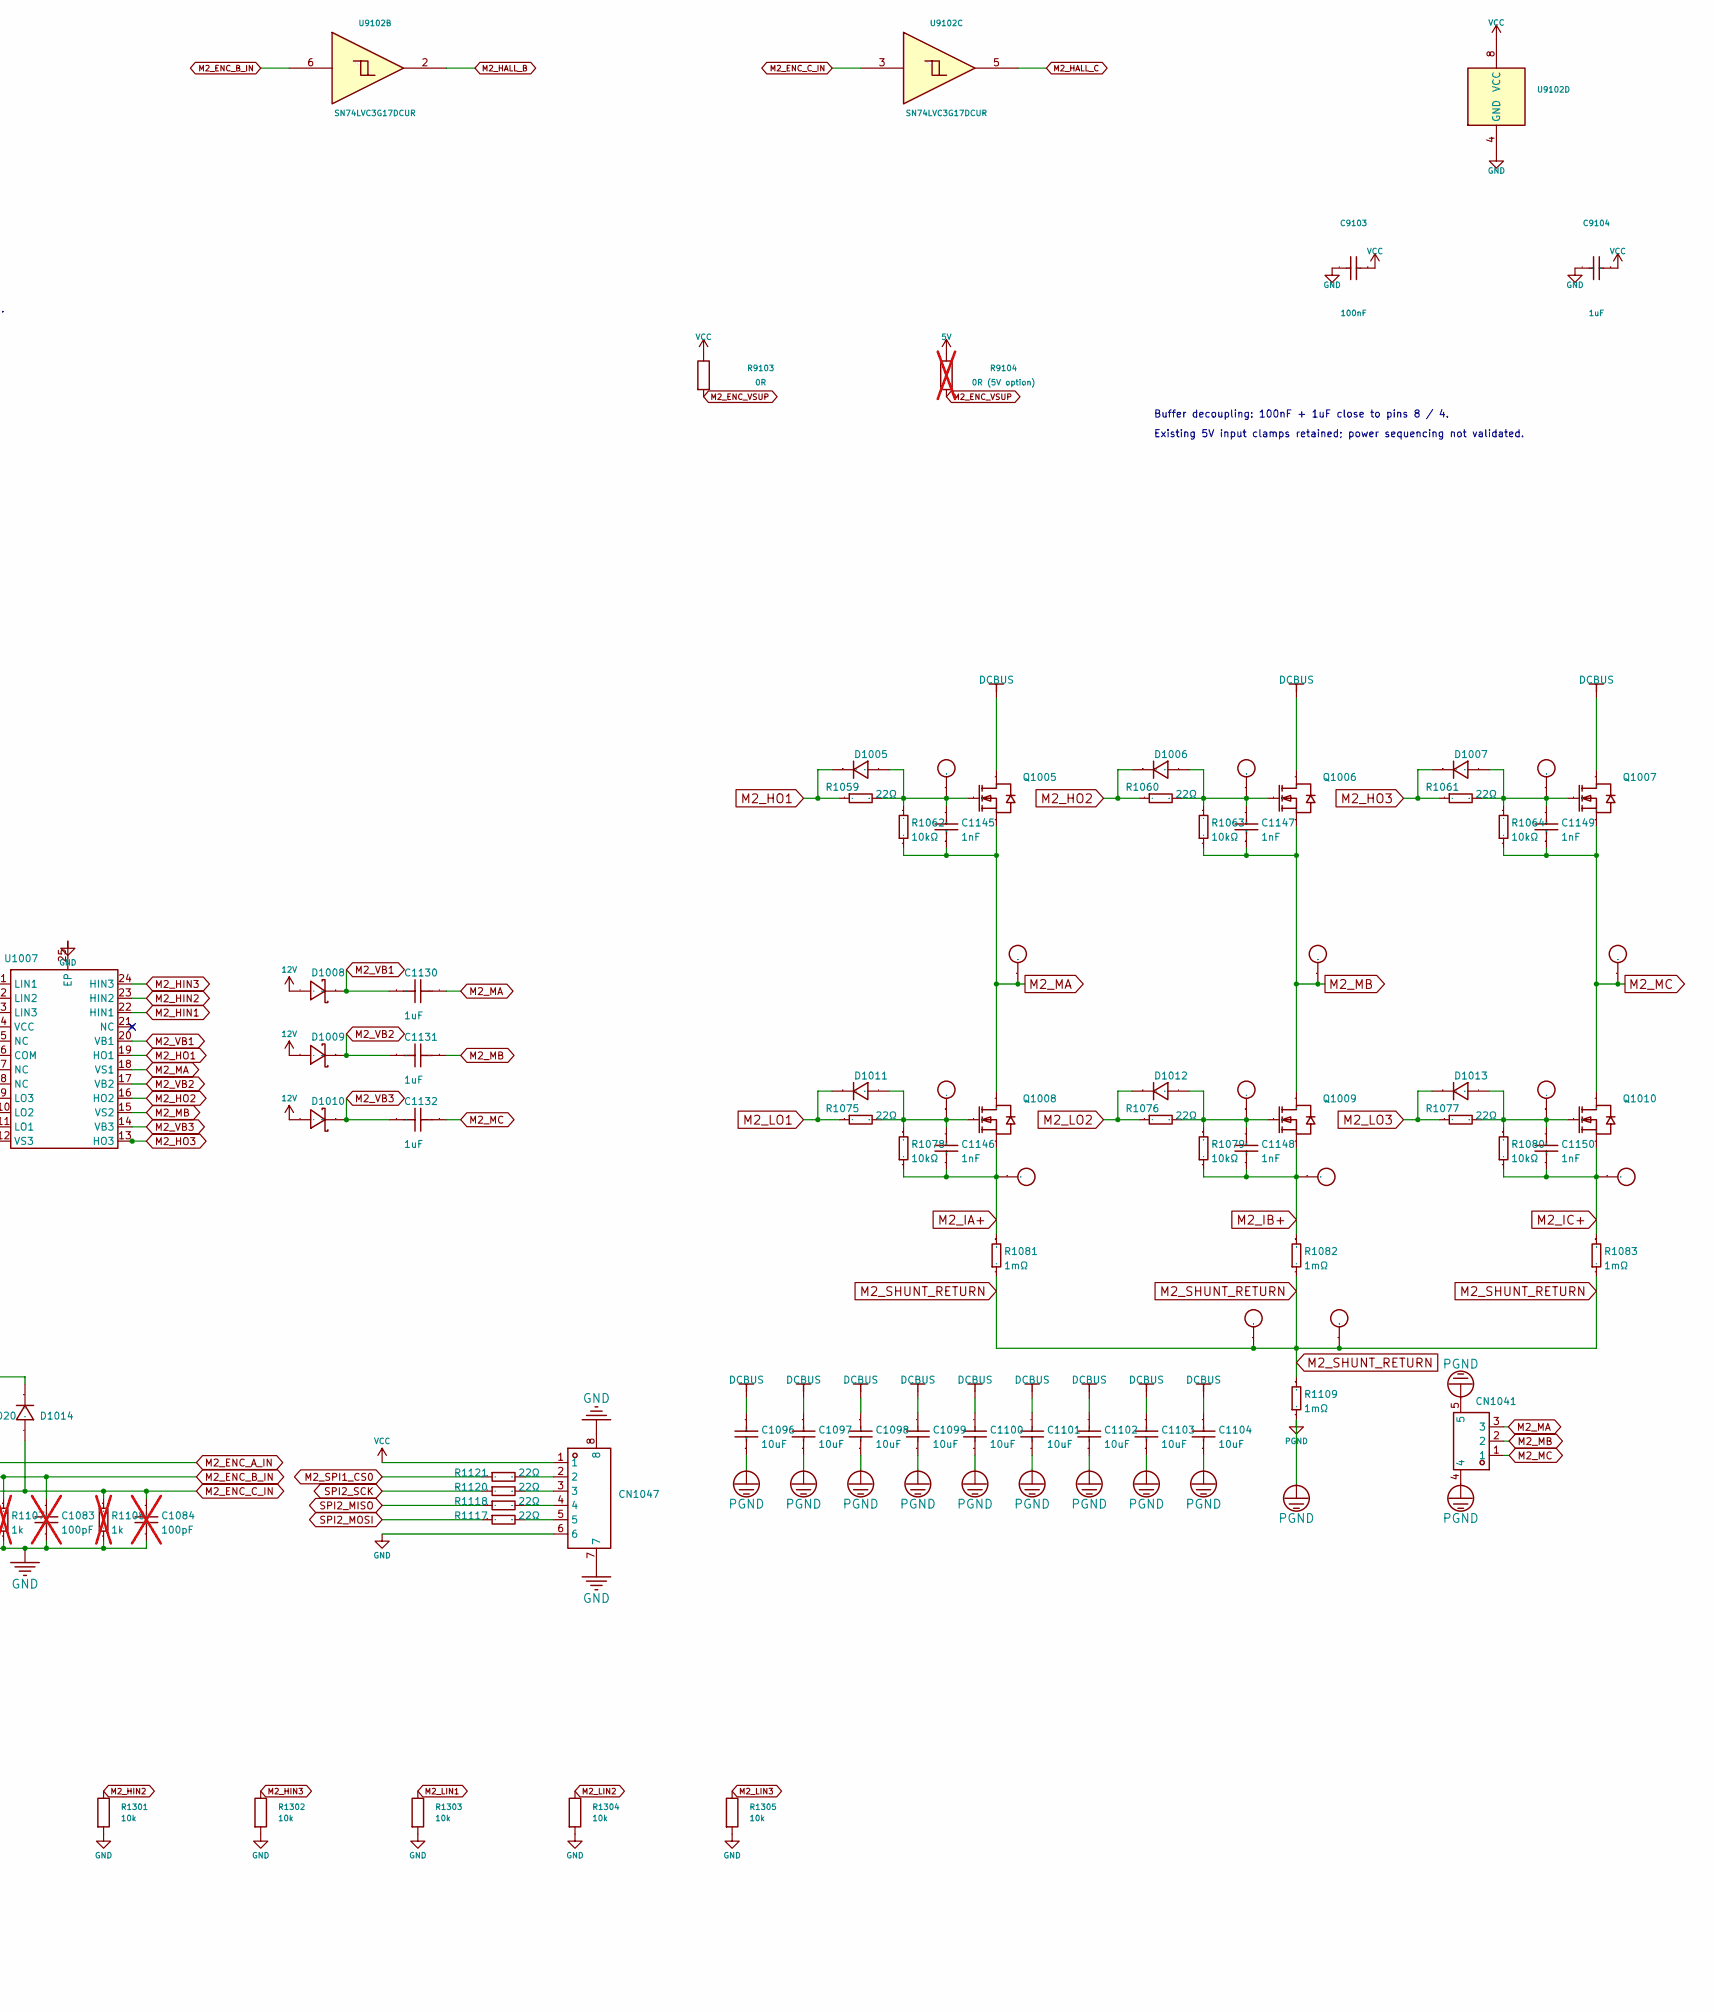
[picture p76: schematic FOC_M2.kicad_sch, part in row 1, column 2]

Parts:
C1075, C1076, C1077: 1uF; C0603_S; Tolerance ±10%; Voltage Rated 50V; Manufacturer Part 0603B102K500NT; LCSC Part Name 1nF ±10% 50V
C1078, C1080: 100nF; C0603_S; Tolerance ±10%; Voltage Rated 50V; Manufacturer Part 0603B102K500NT; LCSC Part Name 1nF ±10% 50V
C1082, C1083, C1084: 100pF; C0603_S; not fitted
C1085: 1nF; C0603_S; Tolerance ±10%; Voltage Rated 50V; Manufacturer Part 0603B104K500NT; LCSC Part Name 100nF ±10% 50V
C1096, C1097, C1098, C1099, C1100, C1101, C1102, C1103, C1104: 10uF; C_1206_3216Metric; Tolerance ±10%; Voltage Rated 50V; Manufacturer Part CL31A106KBHNNNE; LCSC Part Name 10uF ±10% 50V
C1130, C1131, C1132: 1uF; C0603; Tolerance ±10%; Voltage Rating 50V; Manufacturer Part CGA0603X5R105K500JT; LCSC Part Name 1uF ±10% 50V
C1133, C1134, C1135, C1136, C1145, C1146, C1147, C1148, C1149, C1150: 1nF; C0603_S; Tolerance ±10%; Voltage Rated 50V; Manufacturer Part 0603B102K500NT; LCSC Part Name 1nF ±10% 50V
C1143: 100nF; C0603_S; Tolerance ±10%; Voltage Rated 50V; Manufacturer Part 0603B104K500NT; LCSC Part Name 100nF ±10% 50V
C9103: 100nF; C0603_S
C9104: 1uF; C0603_S
CN1005, CN1047: WAFER-GH1.25-6PWB; CONN-SMD_6P-P1.25_XUNPU_WAFER-GH1.25-6PWB; Current Rating (Max) 1A; Manufacturer Part WAFER-GH1.25-6PWB; LCSC Part Name GH1.25mm6P卧贴带扣带扣
CN1014, CN1015, CN1017, CN1018, CN1019, CN1020, CN1021, CN1022, CN1023, CN1024, CN1025, CN1026, CN1027, CN1028, CN1029, CN1030, CN1035, CN1036, CN1037, CN1038, CN1039, CN1040: TestPoint; TestPoint_D1.27_Reference; LCSC Part Name 测试点
CN1041: MR30PW-F; CONN-TH_MR30PW-F; Manufacturer Part MR30PW-F; LCSC Part Name MR30PW-F
D1005, D1006, D1007, D1011, D1012, D1013, D1014, D1015, D1016, D1017, D1018, D1019, D1020: B16WS; SOD-323_L1.8-W1.3-LS2.5-RD_2; Forward Voltage (Vf@If) 700mV@1A; Reverse Voltage (Vr) 60V; Manufacturer Part B16WS; LCSC Part Name B16WS
D1008, D1009, D1010: B16WS; D_SOD-323; Forward Voltage (Vf@If) 650mV@1A; Manufacturer Part B16WS; LCSC Part Name B16WS
NTC1001: NCP18XH103F03RB; R0603_S; Resistance Tolerance ±1%; Manufacturer Part NCP18XH103F03RB; LCSC Part Name 10kΩ 电阻精度:±1% 3380K
Q1005, Q1006, Q1007, Q1008, Q1009, Q1010: NCE7560K; Manufacturer Part NCE7560K; LCSC Part Name N沟道 75V 60A
R1049: 0Ω; R0603_S; Overload Voltage (Max) 50V; Tolerance ±1%; Manufacturer Part RS-03000FT; LCSC Part Name 0Ω ±1% 100mW
R1050, R1053, R1059, R1060, R1061, R1070, R1073, R1075, R1076, R1077, R1117, R1118, R1120, R1121: 22Ω; R0603_S; Overload Voltage (Max) 75V; Tolerance ±1%; Manufacturer Part 0603WAF220JT5E; LCSC Part Name 22Ω ±1% 100mW 厚膜电阻
R1051, R1055, R1065, R1066, R1071, R1074, R1146, R1149: 20kΩ; R0603_S; Overload Voltage (Max) 75V; Tolerance ±0.1%; Manufacturer Part RT0603BRD0720KL; LCSC Part Name 20kΩ ±0.1% 100mW
R1052, R1067, R1068, R1069, R1072, R1145, R1147, R1148: 1kΩ; R0603_S; Overload Voltage (Max) 75V; Tolerance ±0.1%; Manufacturer Part RT0603BRD071KL; LCSC Part Name 1kΩ ±0.1% 100mW
R1054, R1103, R1105, R1128, R1129, R1130: 1kΩ; R0603_S; Overload Voltage (Max) 75V; Tolerance ±1%; Manufacturer Part 0603WAF1002T5E; LCSC Part Name 10kΩ ±1% 100mW 厚膜电阻
R1062, R1063, R1064, R1078, R1079, R1080, R1104: 10kΩ; R0603_S; Overload Voltage (Max) 75V; Tolerance ±1%; Manufacturer Part 0603WAF1002T5E; LCSC Part Name 10kΩ ±1% 100mW 厚膜电阻
R1081, R1082, R1083, R1109: 1mΩ; R_2512_6332Metric
R1084, R1085, R1086, R1087, R1091, R1092, R1093, R1094: 10kΩ; R0603_S; Overload Voltage (Max) 75V; Tolerance ±1%; Manufacturer Part 0603WAF1502T5E; LCSC Part Name 15kΩ ±1% 100mW 厚膜电阻
R1088, R1089, R1090: 10k; R0603_S; not fitted
R1095, R1097, R1098: 100R; R0603_S
R1099, R1100, R1101, R1102: 1kΩ; R0603_S; Overload Voltage (Max) 75V; Tolerance ±1%; Manufacturer Part 0603WAF2001T5E; LCSC Part Name 2kΩ ±1% 100mW 厚膜电阻
R1106, R1107, R1108: 1k; R0603_S; not fitted
R1300, R1301, R1302, R1303, R1304, R1305: 10k; R_0603_1608Metric
R9103: 0R; R_0603_1608Metric
R9104: 0R (5V option); R_0603_1608Metric; not fitted
U1007: FD6288Q; QFN-24_L4.0-W4.0-P0.50-BL-EP2.6; Manufacturer Part FD6288Q; LCSC Part Name FD6288Q
U1010: RS624XQ; TSSOP-14_4.4x5mm_P0.65mm; Manufacturer Part RS624XQ; LCSC Part Name 低噪声运放RS624XQ
U9102: SN74LVC3G17DCUR; VSSOP-8_2.3x2mm_P0.5mm

Connections:
5V: D1014.1 (-), D1019.1 (-), D1020.1 (-), R1054.1, R9104.1; also elsewhere on the board
12V: C1143.2, D1008.2, D1009.2, D1010.2, U1007.4 (VCC); also elsewhere on the board
AGND: C1133.1, C1134.1, C1135.1, C1136.1, U1010.11 (V-); also elsewhere on the board
AVCC: U1010.4 (V+); also elsewhere on the board
DCBUS: C1096.2, C1097.2, C1098.2, C1099.2, C1100.2, C1101.2, C1102.2, C1103.2, C1104.2, Q1005.2 (D), Q1006.2 (D), Q1007.2 (D), R1087.1; also elsewhere on the board
GND: C1075.1, C1076.1, C1077.1, C1078.1, C1080.1, C1082.2, C1083.2, C1084.2, C1085.2, C1143.1, C9103.2, C9104.2, CN1005.1, CN1005.7, CN1005.8, CN1047.6, CN1047.7, CN1047.8, NTC1001.2, R1099.2, R1100.2, R1101.2, R1102.2, R1105.2, R1106.2, R1107.2, R1108.2, R1300.2, R1301.2, R1302.2, R1303.2, R1304.2, R1305.2, U1007.6 (COM), U1007.25 (EP), U9102.4 (GND); also elsewhere on the board
M2_COM: R1128.2, R1129.1, R1130.1
M2_ENC_A_IN: C1082.1, D1019.2 (+), R1095.2, R1106.1, U9102.1
M2_ENC_B_IN: C1083.1, D1020.2 (+), R1097.2, R1107.1, U9102.6
M2_ENC_C_IN: C1084.1, D1014.2 (+), R1098.2, R1108.1, U9102.3
M2_ENC_VSUP: CN1005.6, R9103.2, R9104.2
M2_HALL_A: U9102.7; also elsewhere on the board
M2_HALL_B: U9102.2; also elsewhere on the board
M2_HALL_C: U9102.5; also elsewhere on the board
M2_HIN1: R1300.1, U1007.22 (HIN1); also elsewhere on the board
M2_HIN2: R1301.1, U1007.23 (HIN2); also elsewhere on the board
M2_HIN3: R1302.1, U1007.24 (HIN3); also elsewhere on the board
M2_HO1: D1005.1 (-), R1059.2, U1007.19 (HO1)
M2_HO2: D1006.1 (-), R1060.2, U1007.16 (HO2)
M2_HO3: D1007.1 (-), R1061.2, U1007.13 (HO3)
M2_IA: C1136.2, CN1020.1 (1_1), R1070.1; also elsewhere on the board
M2_IA+: C1146.1, CN1028.1 (1_1), Q1008.3 (S), R1069.1, R1078.2, R1081.1
M2_IB: C1135.2, CN1021.1 (1_1), R1073.1; also elsewhere on the board
M2_IB+: C1148.1, CN1029.1 (1_1), Q1009.3 (S), R1072.1, R1079.2, R1082.1
M2_IBUS: C1134.2, CN1014.1 (1_1), R1050.1; also elsewhere on the board
M2_IC: C1133.2, CN1015.1 (1_1), R1053.1; also elsewhere on the board
M2_IC+: C1150.1, CN1030.1 (1_1), Q1010.3 (S), R1052.1, R1080.2, R1083.1
M2_LIN1: R1303.1, U1007.1 (LIN1); also elsewhere on the board
M2_LIN2: R1304.1, U1007.2 (LIN2); also elsewhere on the board
M2_LIN3: R1305.1, U1007.3 (LIN3); also elsewhere on the board
M2_LO1: D1011.1 (-), R1075.2, U1007.11 (LO1)
M2_LO2: D1012.1 (-), R1076.2, U1007.10 (LO2)
M2_LO3: D1013.1 (-), R1077.2, U1007.9 (LO3)
M2_MA: C1130.2, C1145.1, CN1022.1 (1_1), CN1041.3, Q1005.3 (S), Q1008.2 (D), R1062.2, R1084.1, U1007.18 (VS1)
M2_MB: C1131.2, C1147.1, CN1023.1 (1_1), CN1041.2, Q1006.3 (S), Q1009.2 (D), R1063.2, R1085.1, U1007.15 (VS2)
M2_MC: C1132.2, C1149.1, CN1024.1 (1_1), CN1041.1, Q1007.3 (S), Q1010.2 (D), R1064.2, R1086.1, U1007.12 (VS3)
M2_NTC: C1080.2, NTC1001.1, R1104.2; also elsewhere on the board
M2_PWM: C1085.1, R1103.2, R1105.1
M2_SHUNT_RETURN: CN1035.1 (1_1), CN1036.1 (1_1), R1067.1, R1068.1, R1081.2, R1082.2, R1083.2, R1109.1, R1145.1, R1148.1
M2_SPI1_CS0: R1121.2; also elsewhere on the board
M2_VA: C1075.2, CN1037.1 (1_1), D1015.2 (+), R1091.2, R1099.1, R1128.1
M2_VB: C1076.2, CN1038.1 (1_1), D1016.2 (+), R1092.2, R1100.1, R1130.2
M2_VB1: C1130.1, D1008.1, U1007.20 (VB1)
M2_VB2: C1131.1, D1009.1, U1007.17 (VB2)
M2_VB3: C1132.1, D1010.1, U1007.14 (VB3)
M2_VBUS: C1078.2, CN1040.1 (1_1), D1018.2 (+), R1094.2, R1102.1
M2_VC: C1077.2, CN1039.1 (1_1), D1017.2 (+), R1093.2, R1101.1, R1129.2
unnamed: CN1005.2, R1090.2, R1098.1
unnamed: CN1005.3, R1089.2, R1097.1
unnamed: CN1005.4, R1088.2, R1095.1
unnamed: CN1005.5, R1054.2, R1103.1
unnamed: CN1047.2, R1121.1
unnamed: CN1047.3, R1120.1
unnamed: CN1047.4, R1118.1
unnamed: CN1047.5, R1117.1
unnamed: C1145.2, CN1017.1 (1_1), D1005.2 (+), Q1005.1 (G), R1059.1, R1062.1
unnamed: C1147.2, CN1018.1 (1_1), D1006.2 (+), Q1006.1 (G), R1060.1, R1063.1
unnamed: C1149.2, CN1019.1 (1_1), D1007.2 (+), Q1007.1 (G), R1061.1, R1064.1
unnamed: C1146.2, CN1025.1 (1_1), D1011.2 (+), Q1008.1 (G), R1075.1, R1078.1
unnamed: C1148.2, CN1026.1 (1_1), D1012.2 (+), Q1009.1 (G), R1076.1, R1079.1
unnamed: C1150.2, CN1027.1 (1_1), D1013.2 (+), Q1010.1 (G), R1077.1, R1080.1
unnamed: R1049.1, R1088.1, R1089.1, R1090.1
unnamed: R1084.2, R1091.1
unnamed: R1085.2, R1092.1
unnamed: R1086.2, R1093.1
unnamed: R1087.2, R1094.1
unnamed: R1052.2, R1055.2, U1010.3 (+INA)
unnamed: R1145.2, R1146.2, U1010.2 (-INA)
unnamed: R1053.2, R1146.1, U1010.1 (OUTA)
unnamed: R1051.2, R1148.2, U1010.5 (+INB)
unnamed: R1147.2, R1149.2, U1010.6 (-INB)
unnamed: R1050.2, R1149.1, U1010.7 (OUTB)
unnamed: R1069.2, R1071.2, U1010.10 (+INC)
unnamed: R1065.2, R1067.2, U1010.9 (-INC)
unnamed: R1065.1, R1070.2, U1010.8 (OUTC)
unnamed: R1072.2, R1074.2, U1010.12 (+IND)
unnamed: R1066.2, R1068.2, U1010.13 (-IND)
unnamed: R1066.1, R1073.2, U1010.14 (OUTD)
PGND: C1096.1, C1097.1, C1098.1, C1099.1, C1100.1, C1101.1, C1102.1, C1103.1, C1104.1, CN1041.4, CN1041.5, R1109.2, R1147.1; also elsewhere on the board
SPI2_MISO: R1118.2; also elsewhere on the board
SPI2_MOSI: R1117.2; also elsewhere on the board
SPI2_SCK: R1120.2; also elsewhere on the board
VCC: C9103.1, C9104.1, CN1047.1, D1015.1 (-), D1016.1 (-), D1017.1 (-), D1018.1 (-), R1049.2, R1104.1, R9103.1, U9102.8 (VCC); also elsewhere on the board
VREF: R1051.1, R1055.1, R1071.1, R1074.1; also elsewhere on the board

Notes on the sheet:
VA/VB/VC, COM, IBUS, NTC and auxiliary PWM are retained reference interfaces. Only nets explicitly connected on MCU sheet are MCU functions. FD6288Q has no dedicated EN pin: hardware gate-input pulldowns are provided. BRKIN requires external fault generation; software must initialize PWM disabled.
MOTOR 2: independent gate drive, six MOSFETs, phase shunts and bus shunt. All motor signals M2_*. Common DCBUS / 12V / 5V / VCC / AVCC / VREF. PGND is common AFTER the dedicated bus shunt; phase-shunt return remains local. Reference values and footprints require engineering review; no rating verifi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
CN1005: Hall / single-ended ABZ (one mode at a time)
1 GND; 2 C / Z; 3 B; 4 A; 5 auxiliary PWM (unused); 6 VSUP; 7/8 shield GND.
Default: 3.3V power and 3.3V push-pull signals. VCC = 3.3V.
10k pullups, 1k pulldowns and 100pF EMI capacitors DNP.
Fit pullups only for open-drain after cable / edge-rate review.
Pin 6 supply: fit ONE 0R selector only; 5V option DNP.
5V Hall / encoder operation pending TI datasheet validation.
Buffer pinout from KiCad library; silicon / footprint review required before fabrication.
Buffer decoupling: 100nF + 1uF close to pins 8 / 4.
Existing 5V input clamps retained; power sequencing not validated.
12V via D1008; C1130 to VS1
12V via D1009; C1131 to VS2
12V via D1010; C1132 to VS3

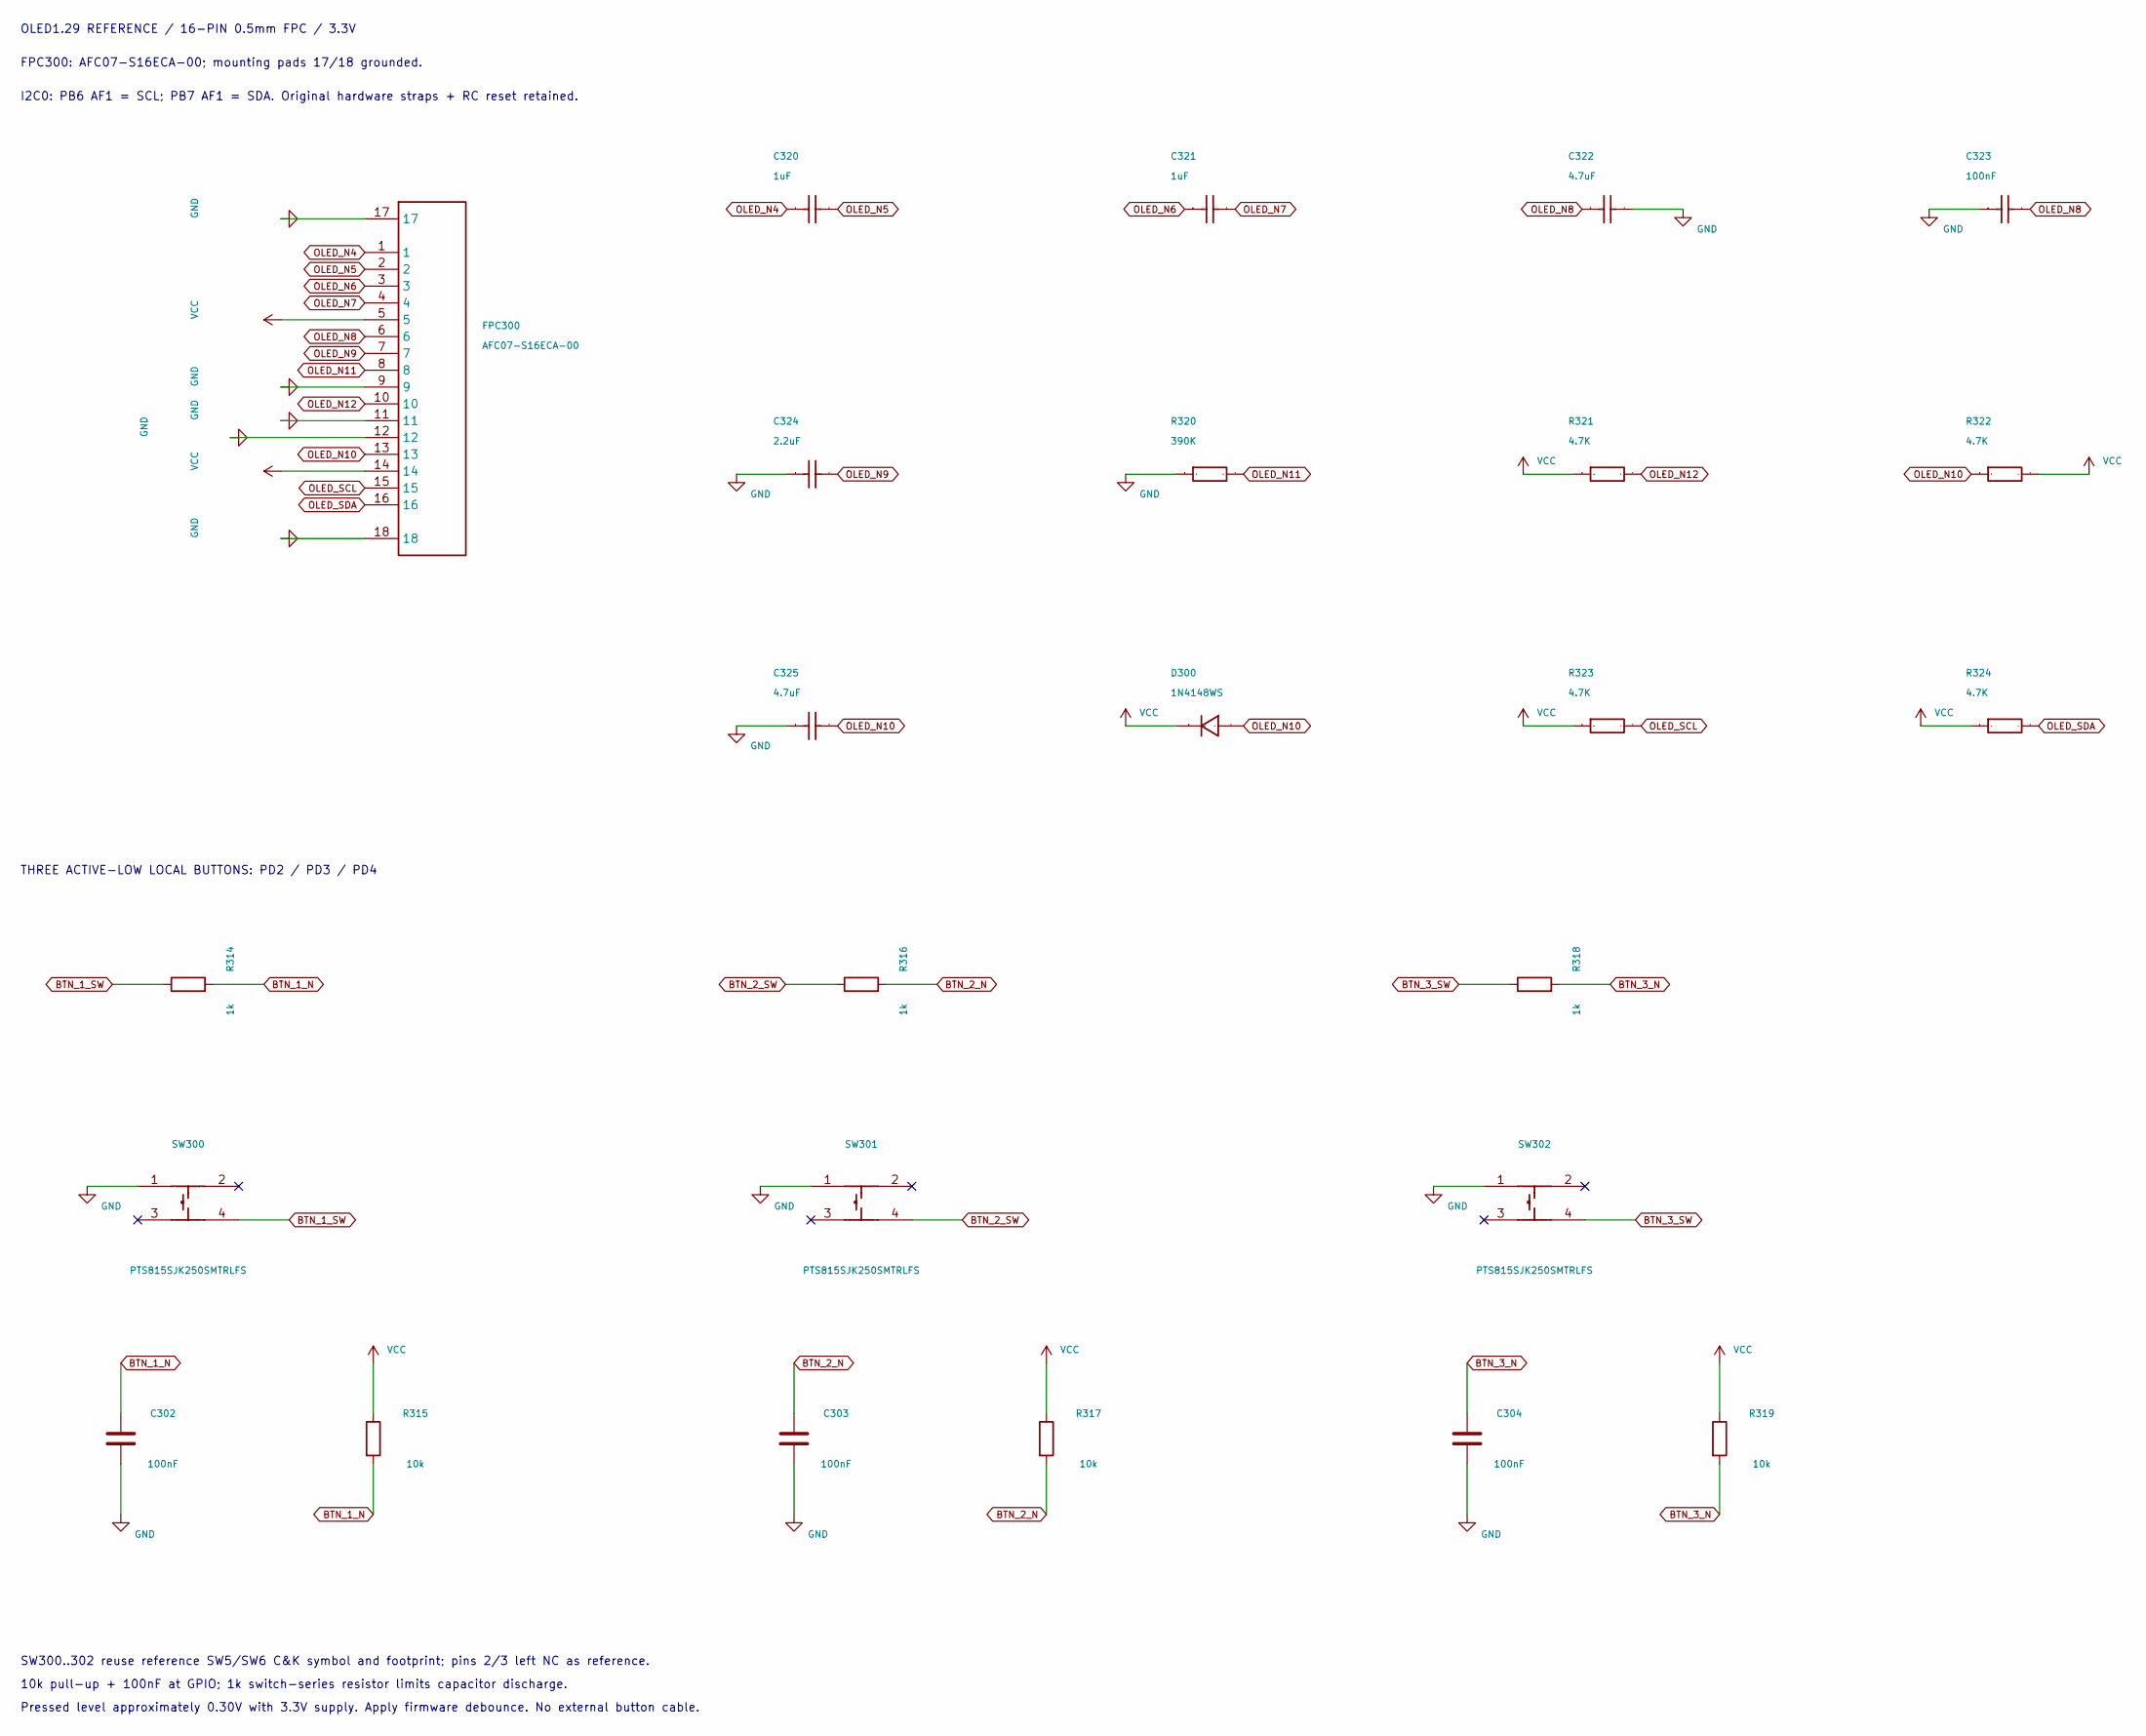
[picture p77: schematic Interface.kicad_sch]

Parts:
C302, C303, C304: 100nF; C_0603_1608Metric
C320, C321: 1uF; c0402-无丝印-全尺寸_2; Tolerance u00b110%; Voltage Rating 25V; Manufacturer Part CL05A105KA5NQNC; LCSC Part Name 1uF u00b110% 25V
C322, C325: 4.7uF; c0402-无丝印-全尺寸_2; Manufacturer Part CL05A106MQ5NUNC; LCSC Part Name 10uF u00b120% 6.3V
C323: 100nF; c0402-无丝印-全尺寸_2; Manufacturer Part CL05A106MQ5NUNC; LCSC Part Name 10uF u00b120% 6.3V
C324: 2.2uF; c0402-无丝印-全尺寸_2; Manufacturer Part CL05A106MQ5NUNC; LCSC Part Name 10uF u00b120% 6.3V
D300: 1N4148WS; SOD-323_L1.8-W1.3-LS2.5-RD; Manufacturer Part 1N4148WS; LCSC Part Name 100V 150mA 4ns T4
FPC300: AFC07-S16ECA-00; FPC-SMD_16P-P0.50_AFC07-S16ECA-00; Manufacturer Part AFC07-S16ECA-00; LCSC Part Name u62bdu5c49u5f0f u4e0au63a5 Pu6570:16P u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
R314, R316, R318: 1k; R_0603_1608Metric
R315, R317, R319: 10k; R_0603_1608Metric
R320: 390K; r0402-无丝印-全尺寸_1; Manufacturer Part 0402WGF1002TCE; LCSC Part Name 10ku03a9 u00b11% 62.5mW u539au819cu7535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
R321, R322, R323, R324: 4.7K; r0402-无丝印-全尺寸_1; Manufacturer Part 0402WGF1002TCE; LCSC Part Name 10ku03a9 u00b11% 62.5mW u539au819cu7535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
SW300, SW301, SW302: PTS815SJK250SMTRLFS; SW-SMD_4P-L4.2-W3.3-P2.15-LS5.1; Manufacturer Part PTS815SJK250SMTRLFS

Connections:
BTN_1_N: C302.1, R314.2, R315.2; also elsewhere on the board
BTN_1_SW: R314.1, SW300.4
BTN_2_N: C303.1, R316.2, R317.2; also elsewhere on the board
BTN_2_SW: R316.1, SW301.4
BTN_3_N: C304.1, R318.2, R319.2; also elsewhere on the board
BTN_3_SW: R318.1, SW302.4
GND: C302.2, C303.2, C304.2, C322.2, C323.1, C324.1, C325.1, FPC300.9, FPC300.11, FPC300.12, FPC300.17, FPC300.18, R320.1, SW300.1, SW301.1, SW302.1; also elsewhere on the board
OLED_N4: C320.1, FPC300.1
OLED_N5: C320.2, FPC300.2
OLED_N6: C321.1, FPC300.3
OLED_N7: C321.2, FPC300.4
OLED_N8: C322.1, C323.2, FPC300.6
OLED_N9: C324.2, FPC300.7
OLED_N10: C325.2, D300.2 (A), FPC300.13, R322.1
OLED_N11: FPC300.8, R320.2
OLED_N12: FPC300.10, R321.2
OLED_SCL: FPC300.15, R323.2; also elsewhere on the board
OLED_SDA: FPC300.16, R324.2; also elsewhere on the board
VCC: D300.1 (K), FPC300.5, FPC300.14, R315.1, R317.1, R319.1, R321.1, R322.2, R323.1, R324.1; also elsewhere on the board

Notes on the sheet:
THREE ACTIVE-LOW LOCAL BUTTONS: PD2 / PD3 / PD4
SW300..302 reuse reference SW5/SW6 C&K symbol and footprint; pins 2/3 left NC as reference.
10k pull-up + 100nF at GPIO; 1k switch-series resistor limits capacitor discharge.
Pressed level approximately 0.30V with 3.3V supply. Apply firmware debounce. No external button cable.
OLED1.29 REFERENCE / 16-PIN 0.5mm FPC / 3.3V
FPC300: AFC07-S16ECA-00; mounting pads 17/18 grounded.
I2C0: PB6 AF1 = SCL; PB7 AF1 = SDA. Original hardware straps + RC reset retained.

Board: 2 copper layers, 532 parts (33 on the bottom side), 244 nets, no tracks yet.
